geekysuavo/pyppm/software/py/README.md

# pyppm/software/py

This directory contains the `pyppm` Python module source code.

## Introduction

The `pyppm` module links the PyPPM hardware and its capabilities directly
into the powerful Python language, allowing almost any use imaginable of
PPM/EFNMR data acquired from the device. How you use `pyppm` is completely
up to your own imagination! **:)**

## Compilation & Installation

To build `pyppm`, simply run `make`:

> `make`

Easy, right? If you get an error about Python not being found or if you want
to compile the module for a different Python version than the default, you'll
have to specify the Python version during compilation, _e.g._:

> `make PYVER=3.2`

To install, just run it as the super user and tack on an `install` command:

> `sudo make install`

or, for different Python versions:

> `sudo make PYVER=3.2 install`

The `pyppm` Python module will now be installed onto your system, and may
be imported just like any other module. Hooray!

## Example usage

Consider this section as a whirlwind tutorial to using the `pyppm` module in
your Python programs.

### Importing the module

To use `pyppm` in your Python programs, you'll first need to import the
module:

```python
import pyppm
```

It'll probably be useful to have `numpy` and `matplotlib` available as well.
All the following code that uses those two modules assumes they've been
imported as follows:

```python
import numpy as np
import matplotlib.pyplot as plt
```

### Connecting to the device

The `PPM` class in `pyppm` provides a direct connection to the PyPPM hardware
and may be instantiated like so:

```python
dev = pyppm.PPM()
```

On Linux, this assumes you're trying to connect to `/dev/ttyACM0`. On OSX,
it assumes `/dev/cu.usbmodemPyPPM`. If you have multiple attached PyPPM
devices, or if your device was assigned a different device filename than
the default, you can specify a filename:

```python
dev = pyppm.PPM(filename = '/dev/file')
```

If all goes well, you should have no errors and a new `dev` object to play
with. A simple test is to print the device firmware version:

```python
print(dev.version)
```

A proper response is a 2-tuple containing the major and minor version of the
attached device's firmware, _e.g._ `(1, 3)` or `(2, 1)`.

### Pulse programs

All PyPPM devices have been outfitted with a small portion of memory to hold
what are known as 'pulse programs'. These pulse programs are sets of byte
code instructions that tell the microcontroller which commands to execute,
when to execute them, and with what parameters.

But don't worry, you won't ever see the byte code instructions if you don't
want to: the `pyppm` Python module compiles and decompiles these instructions
on-the-fly any time they are needed. In `pyppm`, pulse programs are constructed
as lists of lists, where each inner list is a command with its arguments.

Here's an example:

```python
dev.pulprog = [
  [pyppm.ACQUIRE, 16384, 20],  # acquire 16k samples at 20 kS/s
  [pyppm.END]                  # terminate
]
```

That's pretty easy, right? The above pulse program acquires 16k samples at
20 kS/s and terminates. Here's a more complicated example:

```python
dev.pulprog = [
  [pyppm.ACQUIRE, 16384, 20],  # acquire 16k samples at 20 kS/s
  [pyppm.RELAY, True],         # switch the coil to the polarization circuit
  [pyppm.DEADTIME, 1],         # wait for around one millisecond
  [pyppm.POLARIZE, True],      # switch on hard polarization
  [pyppm.DELAY, 10],           # wait for exactly ten seconds
  [pyppm.POLARIZE, False],     # switch off hard polarization
  [pyppm.DEADTIME, 1],         # wait for around one millisecond
  [pyppm.RELAY, False],        # switch the coil to the acquisition circuit
  [pyppm.DEADTIME, 10],        # wait for around ten milliseconds
  [pyppm.ACQUIRE, 16384, 20],  # acquire again, 16k samples at 20 kS/s
  [pyppm.END]                  # terminate
]
```

The above pulse program just acquires a background 'no-polarization' signal,
then polarizes for ten seconds and acquires a 'with-polarization signal. If
we run this pulse program...

```python
(t, a) = dev.execute()
```

... we'll get the two acquisitions serialized end-to-end in `t` and `a`. Of
course, they can be sliced apart without too much worry. (See the full
example below for exactly how it's done)

Finally, setting shim and tuning parameters is also done using pulse programs.
In order to set a new z-shim, for example, one must do something like this:

```python
dev.pulprog = [
  [pyppm.SHIM_Z, 0.5],
  [pyppm.END]
]
dev.execute()
```

A set of common pulse programs is available in the PyPPM GitHub repository,
under `software/pulprogs`. It's _highly_ recommended that you start there
instead of trying to write your own pulse programs from scratch.

### Acquiring data

Once a pulse program has been downloaded to the device, an experiment may be
performed using the following (blocking) command:

```python
(t, a) = dev.execute()
```

This command will block until the entire experiment is complete.

If the pulse program contains `pyppm.ACQUIRE` commands, then the statement
will return two tuples, `t` and `a`. The first tuple holds the time at which
every data point was acquired, and the second holds the voltage of each data
point.

If the pulse program does not contain an acquisition command, then the
`execute()` method returns `None`.

### Fourier transforming data

Acquired data may be Fourier transformed using the `fft` or `hrft` methods
in the `pyppm` module. While you may use any other external method, these
are known to output the proper results with correct frequency axes:

```python
(f, A) = pyppm.fft(t, a)
(fx, Ax) = pyppm.hrft(t, a, 950, 1050)
```

The `hrft` method computes a highly interpolated Fourier transform over a
short spectral sub-region:

> R. Hollos, _C Program Magnifies Spectrum When An FFT Can't Hack It_,
> Electronic Design, 2003.

In the above example, the HRFT was computed from 950 Hz to 1050 Hz, which
would be appropriate if a signal peak were idenfied near 1000 Hz in the FFT
spectrum and greater frequency resolution was desired.

It's important to note, however, that the HRFT requires fairly long-decaying
signals (and thus high SNR and high field homogeneity), as it windows the
time-domain data with a Blackman apodization function prior to computation.

One final transform is available in `pyppm`, called the [Short-time Fourier
transform](http://en.wikipedia.org/wiki/Short-time_Fourier_transform). It
computes multiple FFT's over short time windows of the time-domain data,
effectively creating a time-course of the frequency content in the data:

```python
(tz, fz, Az) = pyppm.stft(t, a)
```

This may be useful in identifying the decay profile of a true signal in the
presence of steady-state interference.

### Digitally minimizing interference

The PyPPMv1 has no input frequency tuning, which means that the resulting
acquired data will contain significant interference, unless it was taken
on a desert island free of any other technology. One way to minimize this
interference is to "subtract out" any frequency content that is present when
polarization is on _and_ off. This should leave only signals that arose due
to the NMR experiment:

```python
def rmnoise(t, aon, aoff):
  (f, Aon) = pyppm.fft(t, aon)
  (f, Aoff) = pyppm.fft(t, aoff)

  X = np.array(Aon)
  Y = np.array(Aoff)

  alpha = sum(X * Y) / sum(Y * Y)
  A = tuple(X - alpha * Y)

  return (f, A)
```

The above method implements a minimization of the background noise in `Aoff`
that is present in `Aon`, in a least-squares sense. It can only return the
frequency-domain data, however, and not the time-domain result.

### A complete `pyppm` example

Here is an example of how to use the `pyppm` module from start to finish
on a connected PyPPMv1 device:

```python
# import the pyppm module.
import pyppm

# import numpy and matplotlib.
import numpy as np
import matplotlib.pyplot as plt

# connect to the device.
dev = pyppm.PPM()

# download a pulse program.
dev.pulprog = [
  [pyppm.ACQUIRE, 16384, 20],
  [pyppm.RELAY, True],
  [pyppm.DEADTIME, 1],
  [pyppm.POLARIZE, True],
  [pyppm.DELAY, 10],
  [pyppm.POLARIZE, False],
  [pyppm.DEADTIME, 1],
  [pyppm.RELAY, False],
  [pyppm.DEADTIME, 10],
  [pyppm.ACQUIRE, 16384, 20],
  [pyppm.END]
]

# execute the pulse program.
(t, a) = dev.execute()

# slice out the first acquisition.
t0 = t[0 : 16384]
a0 = a[0 : 16384]

# slice out the second acquisition.
t1 = t[16384 : 32768]
a1 = a[16384 : 32768]

# Fourier transform the data.
(f0, A0) = pyppm.fft(t0, a0)
(f1, A1) = pyppm.fft(t1, a1)

# plot the data.
l, = plt.plot(np.array(f1), np.array(A1))
l, = plt.plot(np.array(f0), np.array(A0))
plt.show()
```
