geekysuavo/pyppm/notes/gerbv-colors.md

# Colors for rendering Gerber layouts

| *Layer* | *Color*  |
|---|---|
| Background | 0xffffff |
| Drill | 0xffffff |
| Top silkscreen | 0x000000 |
| Top soldermask | 0x545454 |
| Top traces | 0xde5b4e |
| Inner traces (3) | 0xdede4e |
| Inner traces (4) | 0x4ede5e |
| Bottom traces | 0x2a67b0 |
