geekysuavo/pyppm/designs/dig-1.0/v1-brd.pdf

# v1.pcb

# 1. Table of Contents (This Page) Created on Sun Feb 10 13:56:15 2013

# 2. component 3. solder 4. plated-drill 5. componentmask 6. soldermask 7. topsilk 8. bottomsilk 9. toppaste 10. topassembly 11. bottomassembly 12. fab

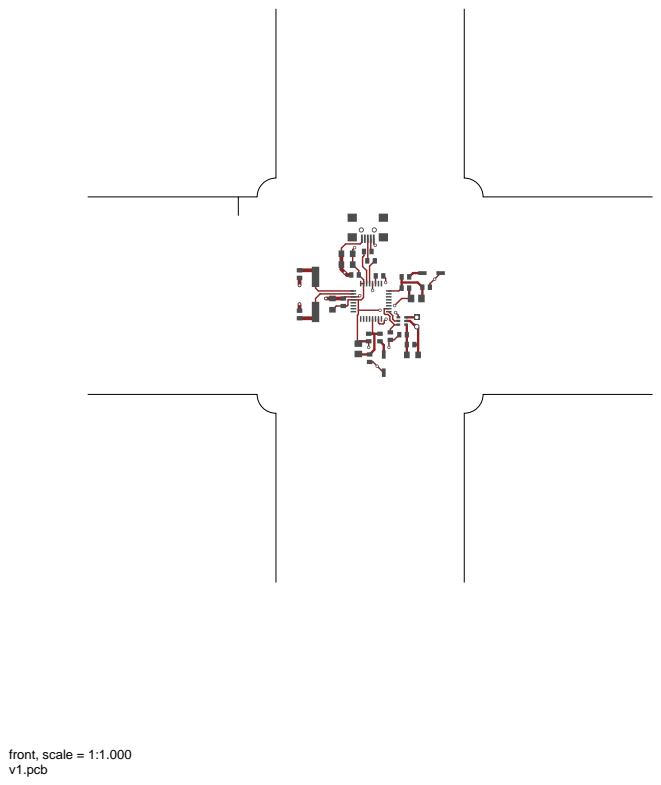
[picture p1: page 2]
front, scale = 1:1.000

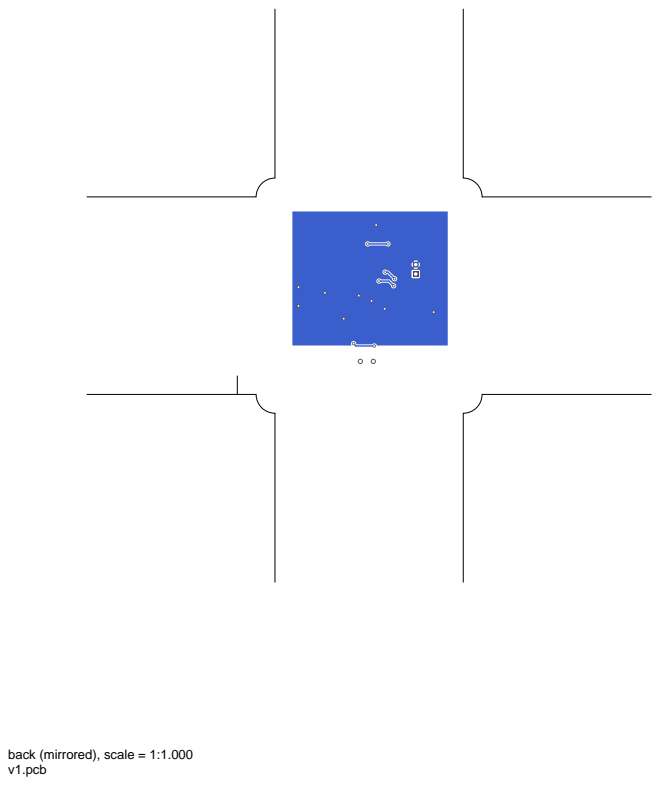
[picture p2: page 3]

back (mirrored), scale = 1:1.000

plated-drill, scale = 1:1.000

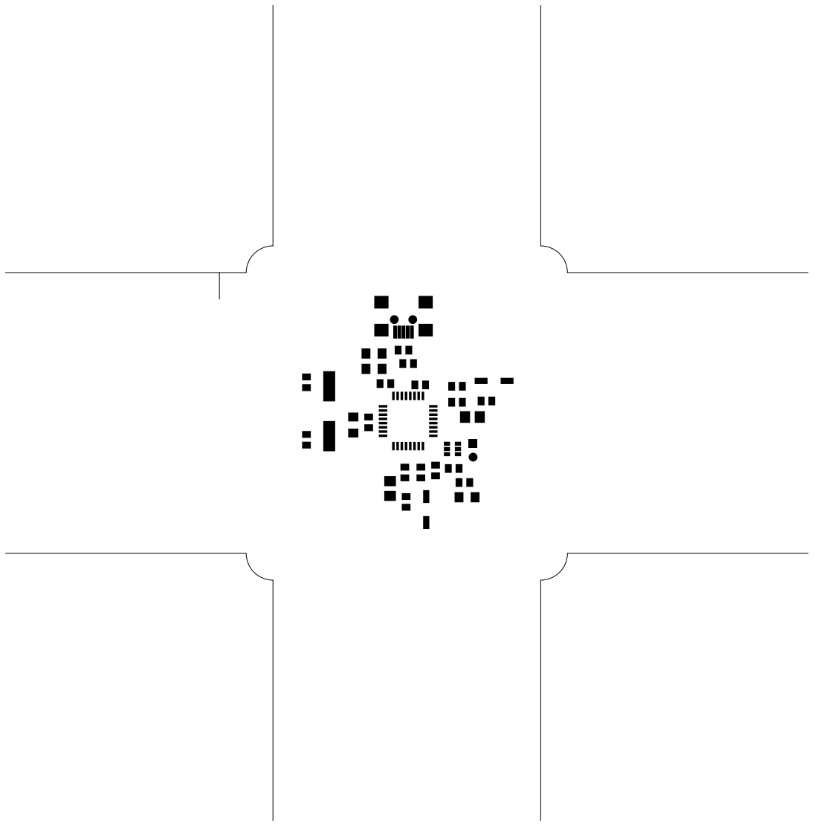
[picture p3: figure]

frontmask, scale = 1:1.000

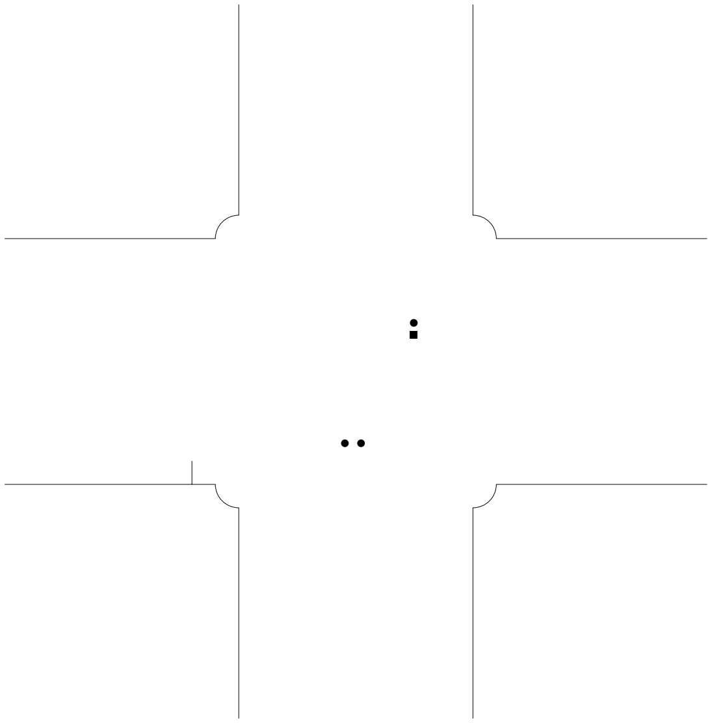
[picture p4: figure]

backmask (mirrored), scale = 1:1.000 frontsilk, scale = 1:1.000 backsilk (mirrored), scale = 1:1.000 frontpaste, scale = 1:1.000

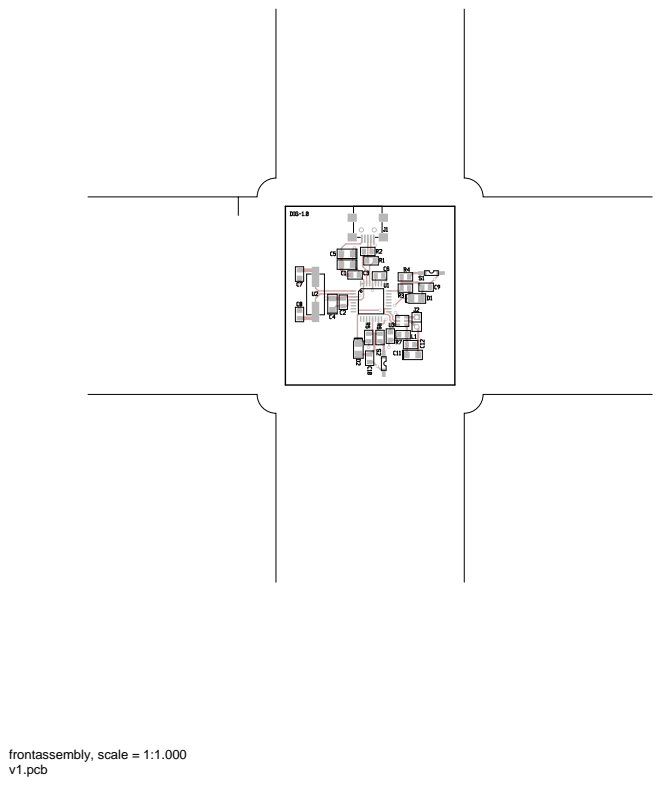
[picture p5: page 10]
frontassembly, scale = 1:1.000

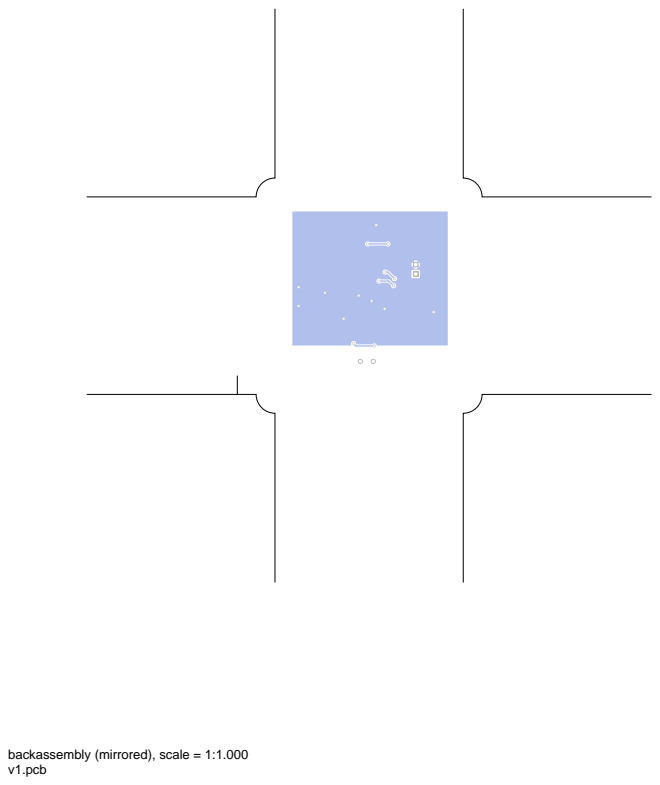
[picture p6: page 11]

backassembly (mirrored), scale = 1:1.000

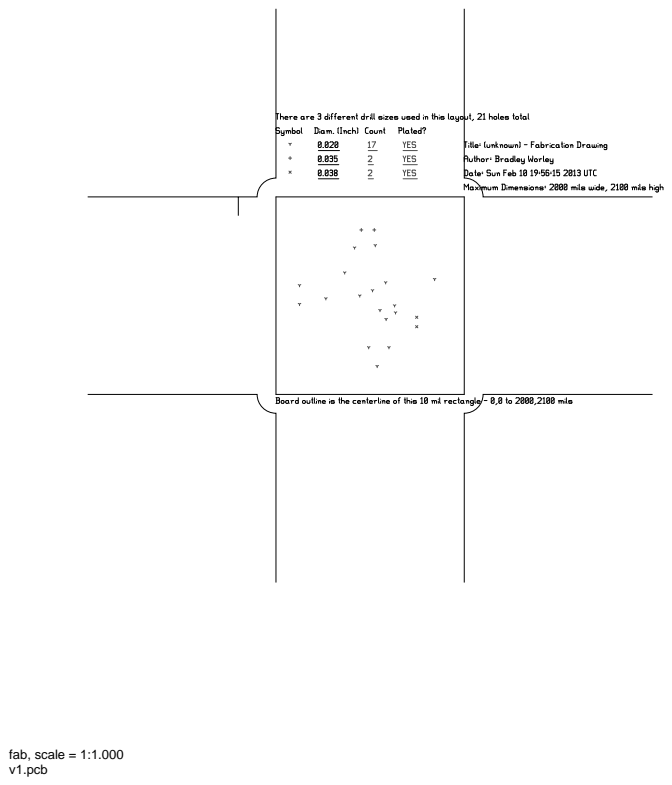
[picture p7: page 12]
fab, scale = 1:1.000
