geekysuavo/pyppm/designs/ina-1.0/v1-brd.pdf

# v1.pcb

# 1. Table of Contents (This Page) Created on Fri Feb 8 13:08:46 2013

# 2. component 3. solder 4. plated-drill 5. componentmask 6. soldermask 7. topsilk 8. bottomsilk 9. toppaste 10. topassembly 11. bottomassembly 12. fab

front, scale = 1:1.000

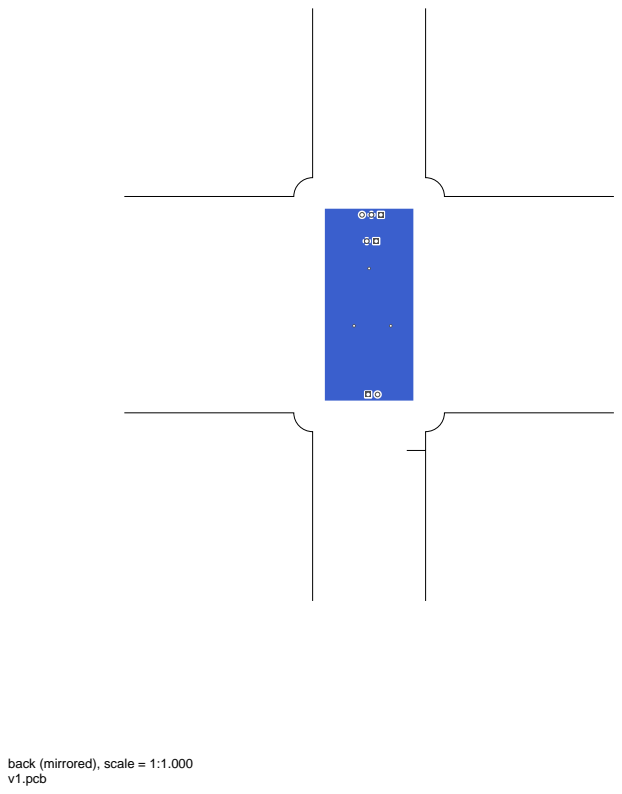
[picture p8: page 3]

back (mirrored), scale = 1:1.000

plated-drill, scale = 1:1.000

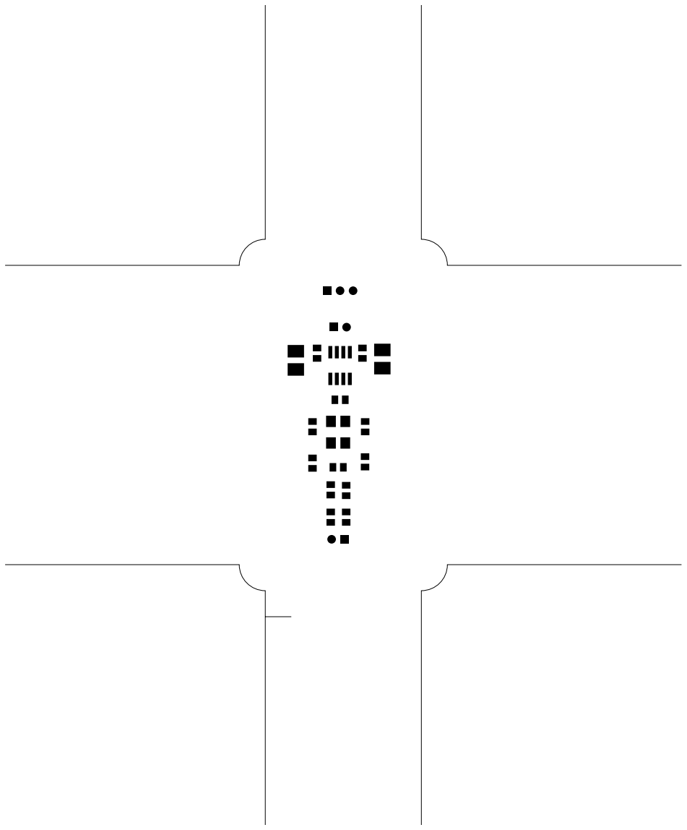
[picture p9: figure]

frontmask, scale = 1:1.000

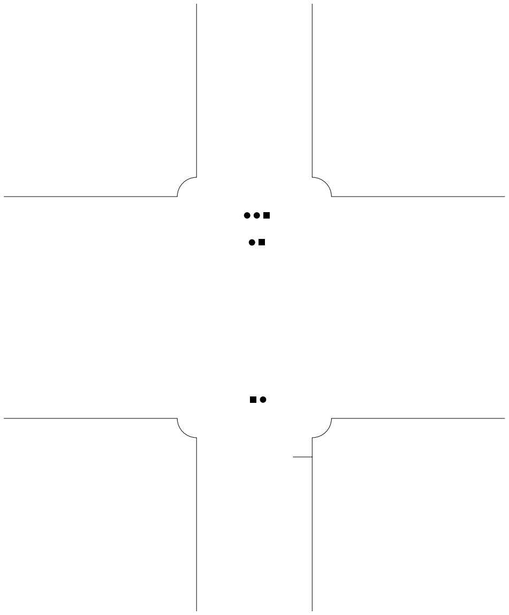
[picture p10: figure]

backmask (mirrored), scale = 1:1.000

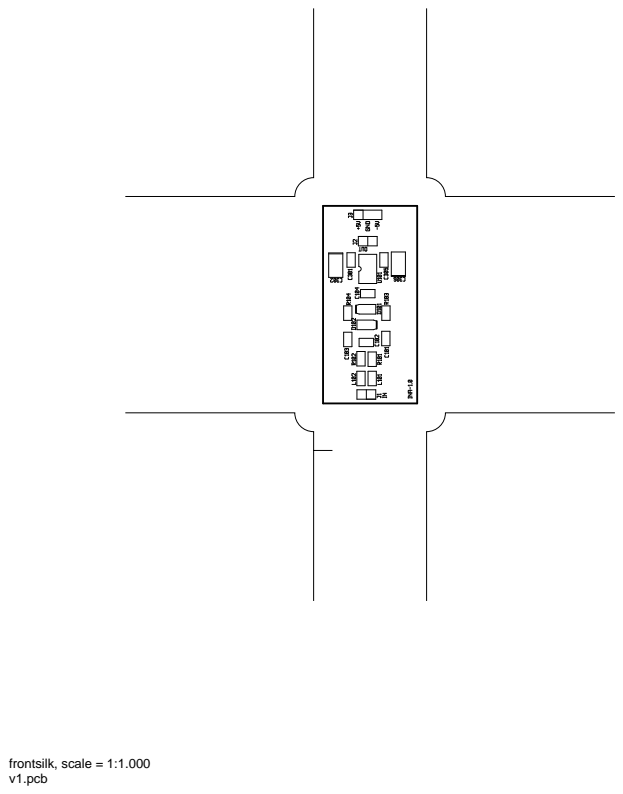
[picture p11: page 7]
frontsilk, scale = 1:1.000

backsilk (mirrored), scale = 1:1.000 frontpaste, scale = 1:1.000

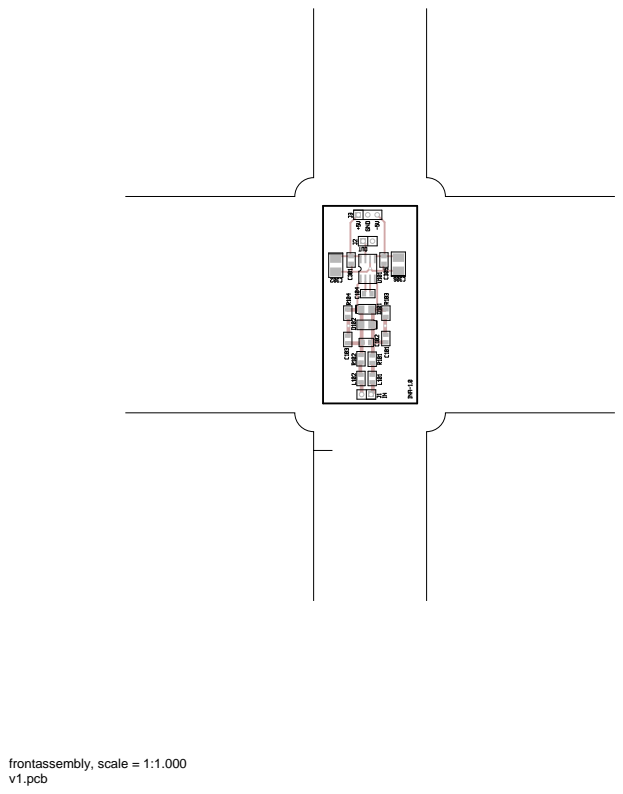
[picture p12: page 10]
frontassembly, scale = 1:1.000

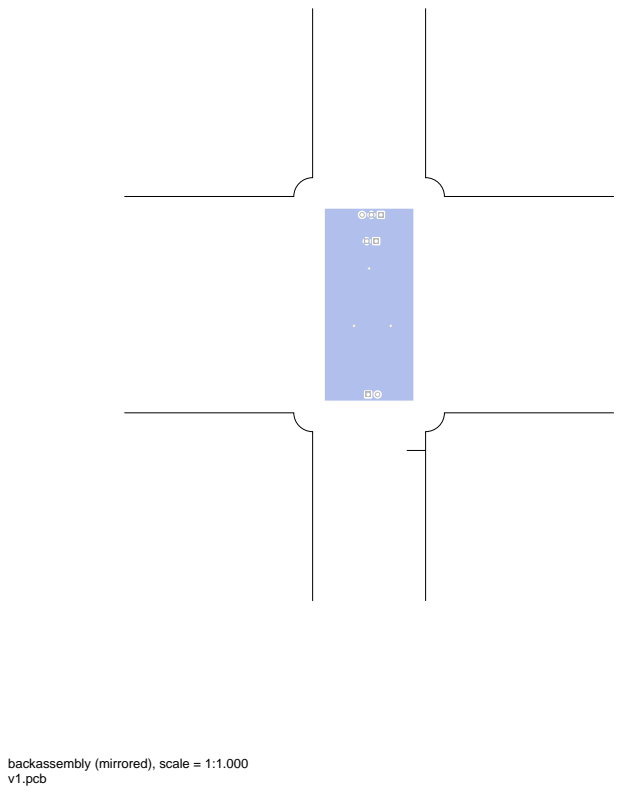
[picture p13: page 11]

backassembly (mirrored), scale = 1:1.000

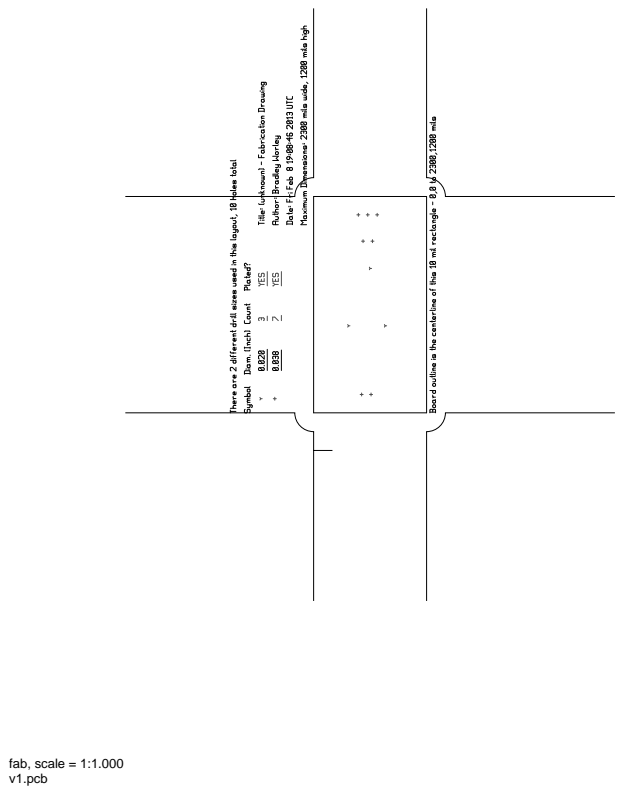
[picture p14: page 12]
fab, scale = 1:1.000
