geekysuavo/pyppm/designs/osc-1.0/v1-brd.pdf

# 2. component 3. solder 4. componentmask 5. soldermask 6. plated-drill 7. topsilk 8. bottomsilk 9. toppaste 10. topassembly 11. bottomassembly 12. fab

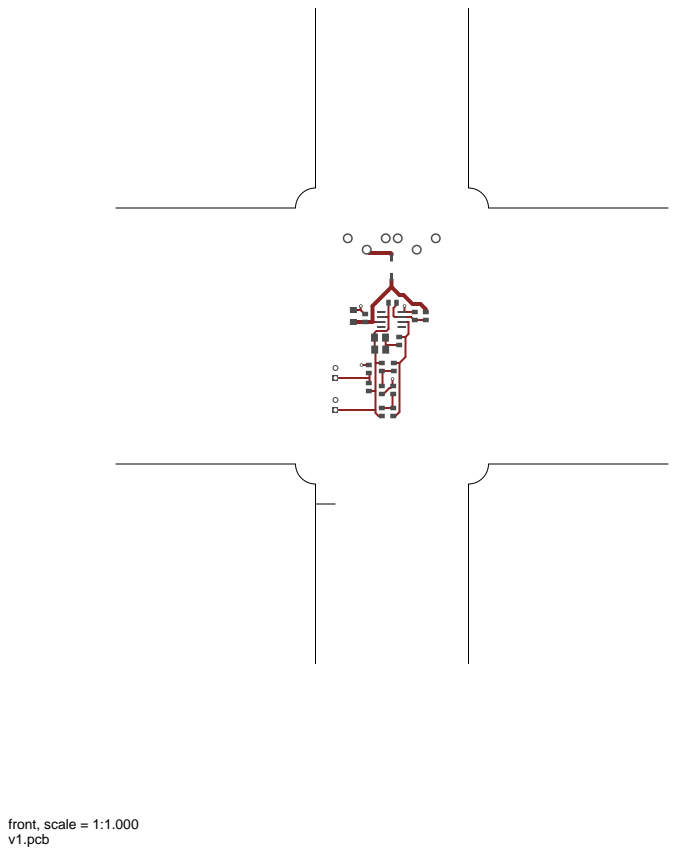
[picture p15: page 2]
v1.pcb; front, scale = 1:1.000

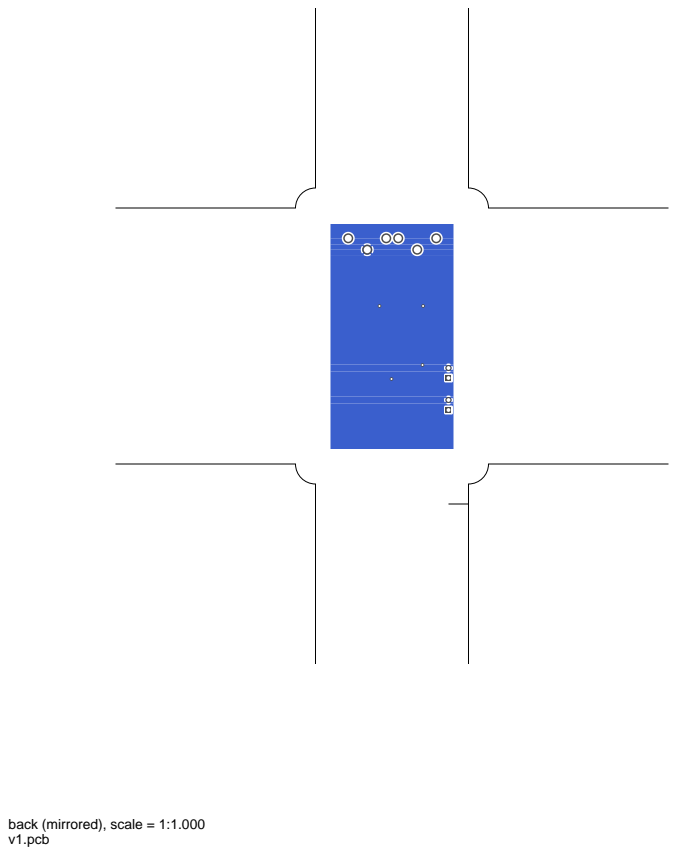
[picture p16: page 3]

back (mirrored), scale = 1:1.000

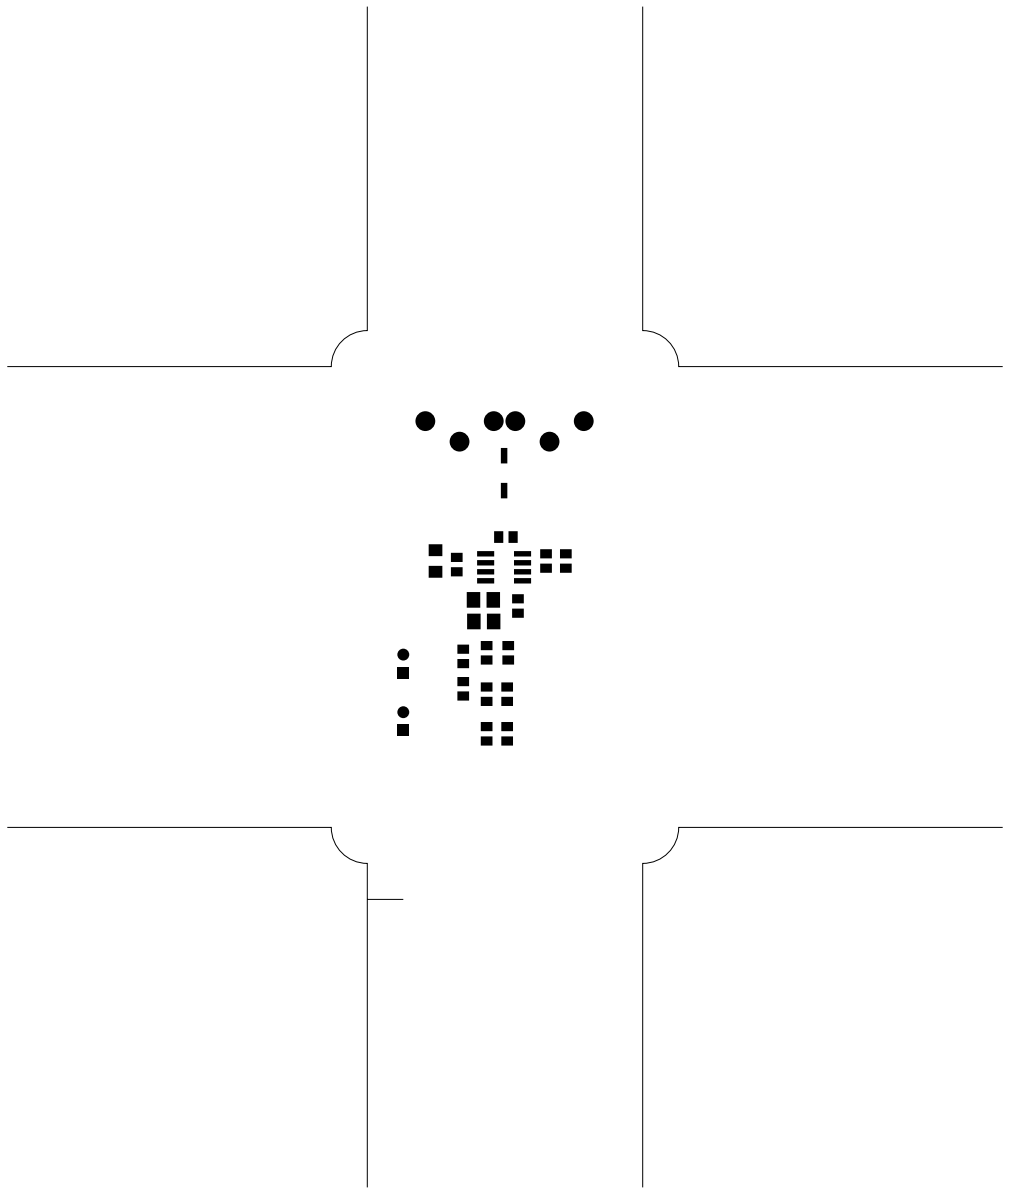
[picture p17: figure]

frontmask, scale = 1:1.000

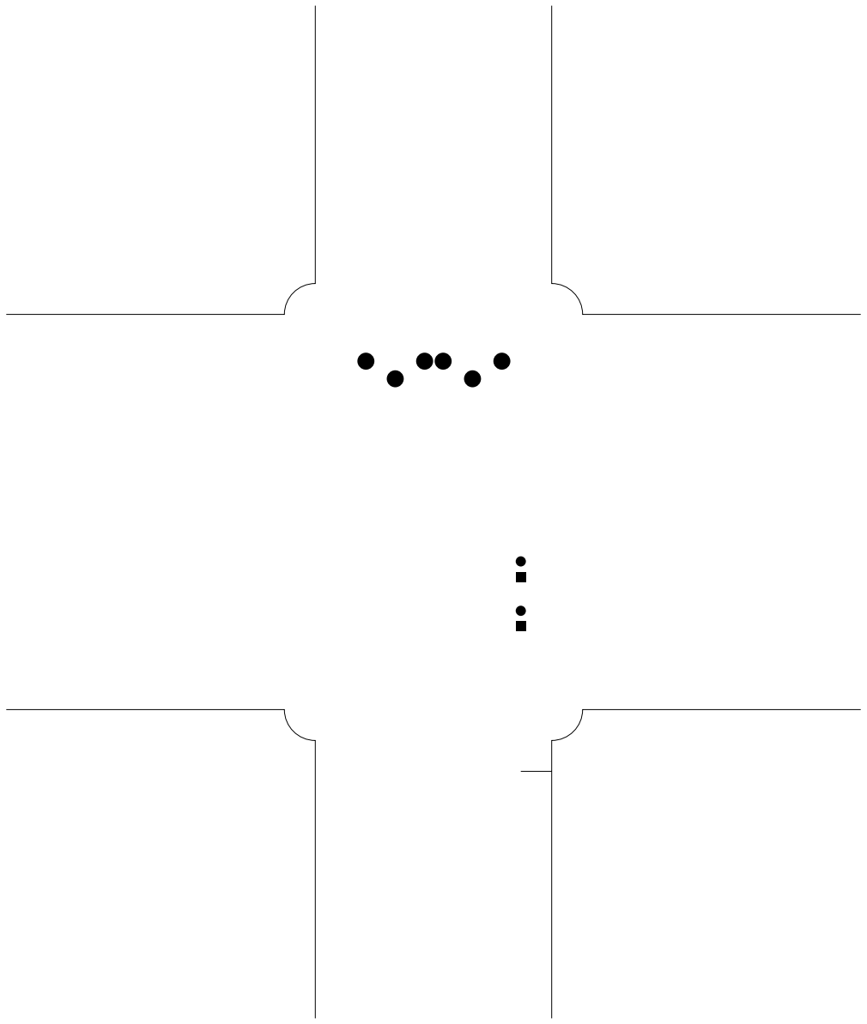
[picture p18: figure]

backmask (mirrored), scale = 1:1.000 plated-drill, scale = 1:1.000 frontsilk, scale = 1:1.000 backsilk (mirrored), scale = 1:1.000 frontpaste, scale = 1:1.000

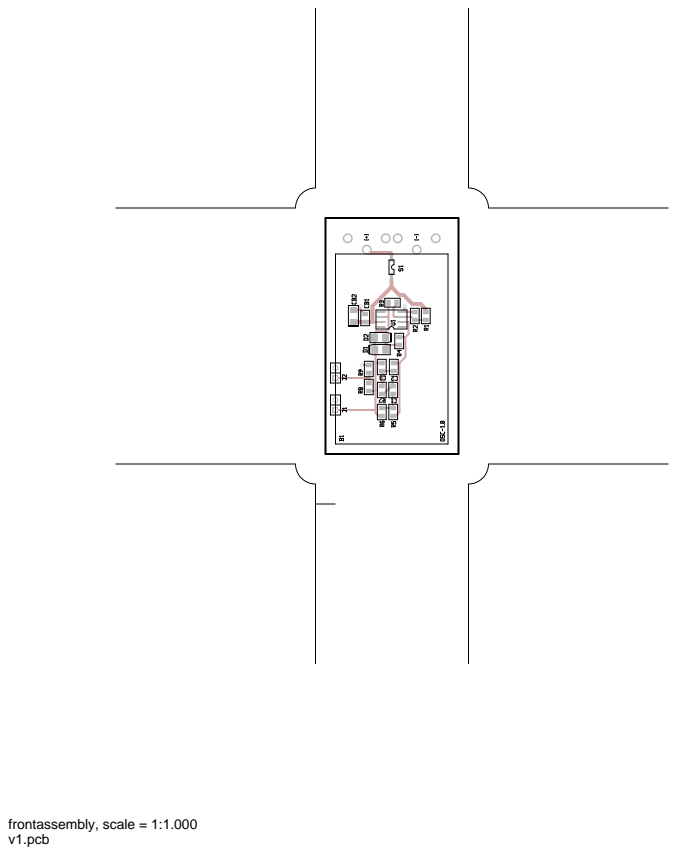
[picture p19: page 10]
frontassembly, scale = 1:1.000

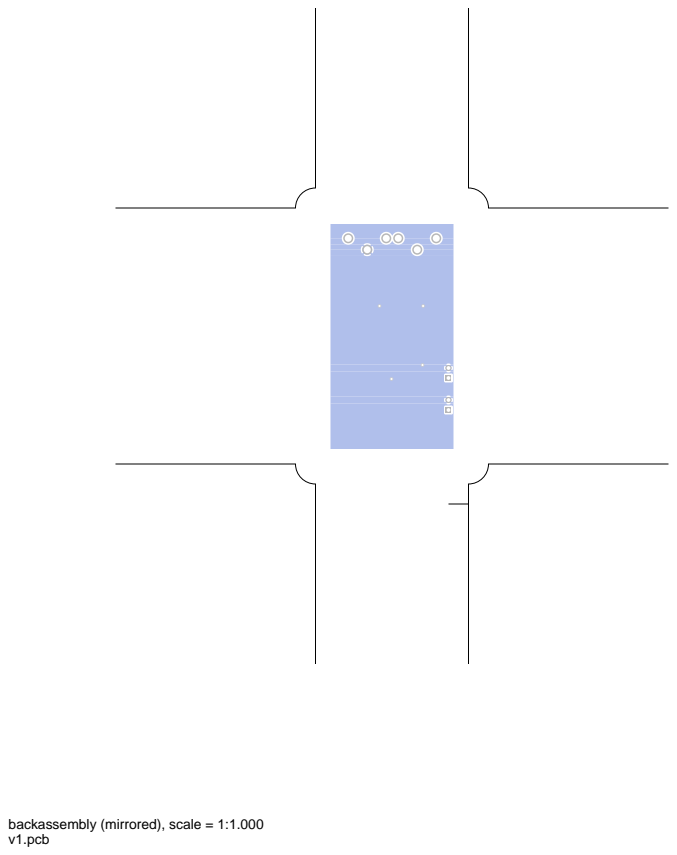
[picture p20: page 11]

backassembly (mirrored), scale = 1:1.000

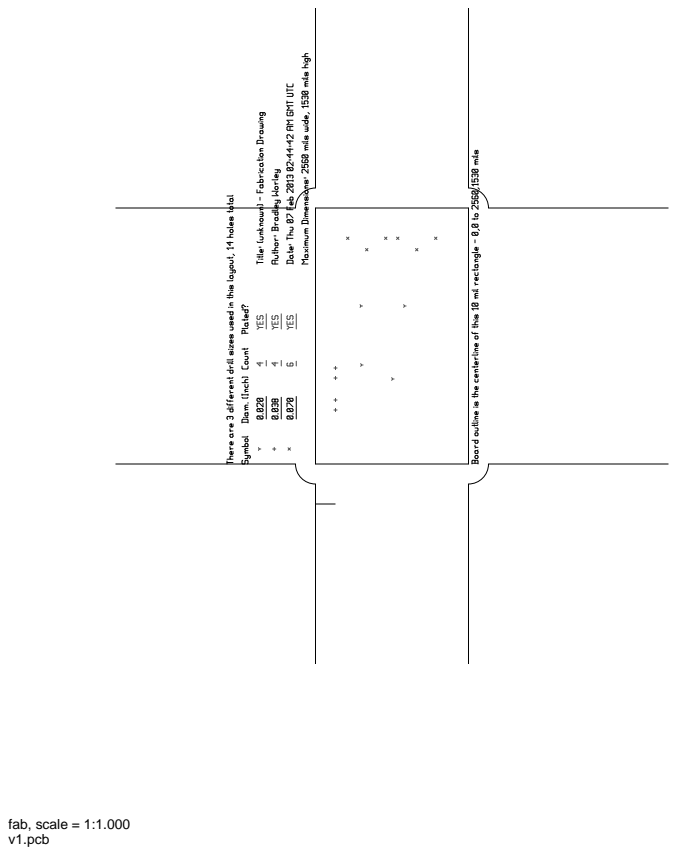
[picture p21: page 12]
fab, scale = 1:1.000
