geekysuavo/pyppm/designs/dig-1.0/v1-brd.png

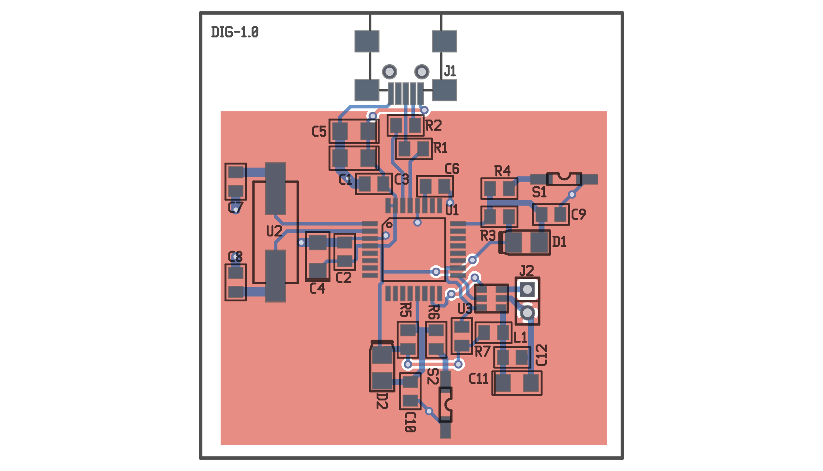
designs/dig-1.0/v1-brd.png
