geekysuavo/pyppm/designs/fil-1.0/v1-brd.png

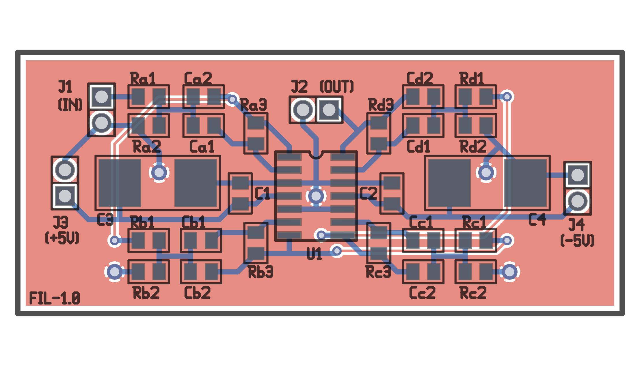
designs/fil-1.0/v1-brd.png
