geekysuavo/pyppm/designs/ina-1.0/v1-brd.png

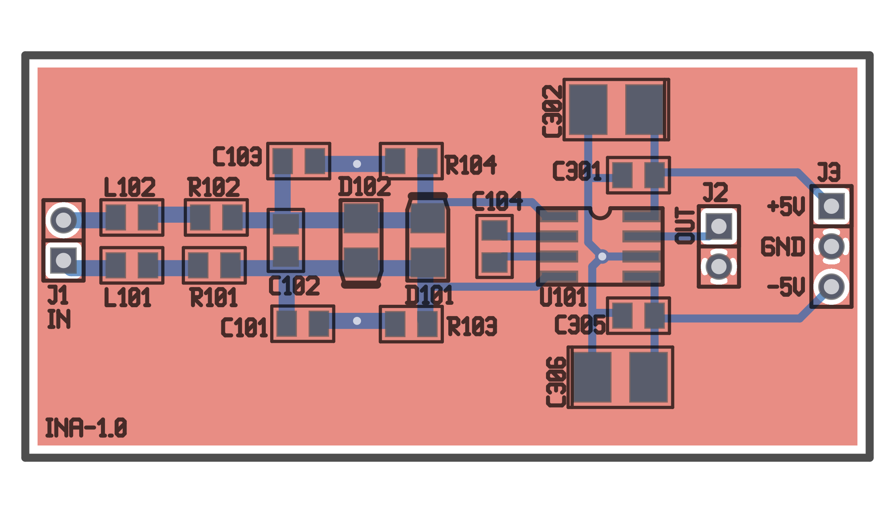
designs/ina-1.0/v1-brd.png
