geekysuavo/pyppm/designs/osc-1.0/v1-brd.png

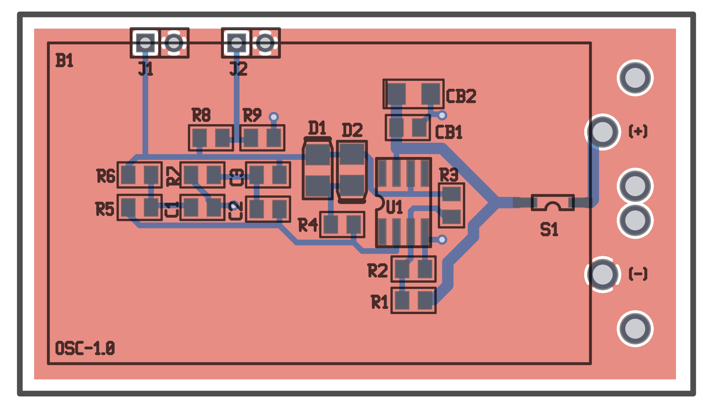
designs/osc-1.0/v1-brd.png
