geekysuavo/pyppm/designs/ppm-1.0/v1-brd.png

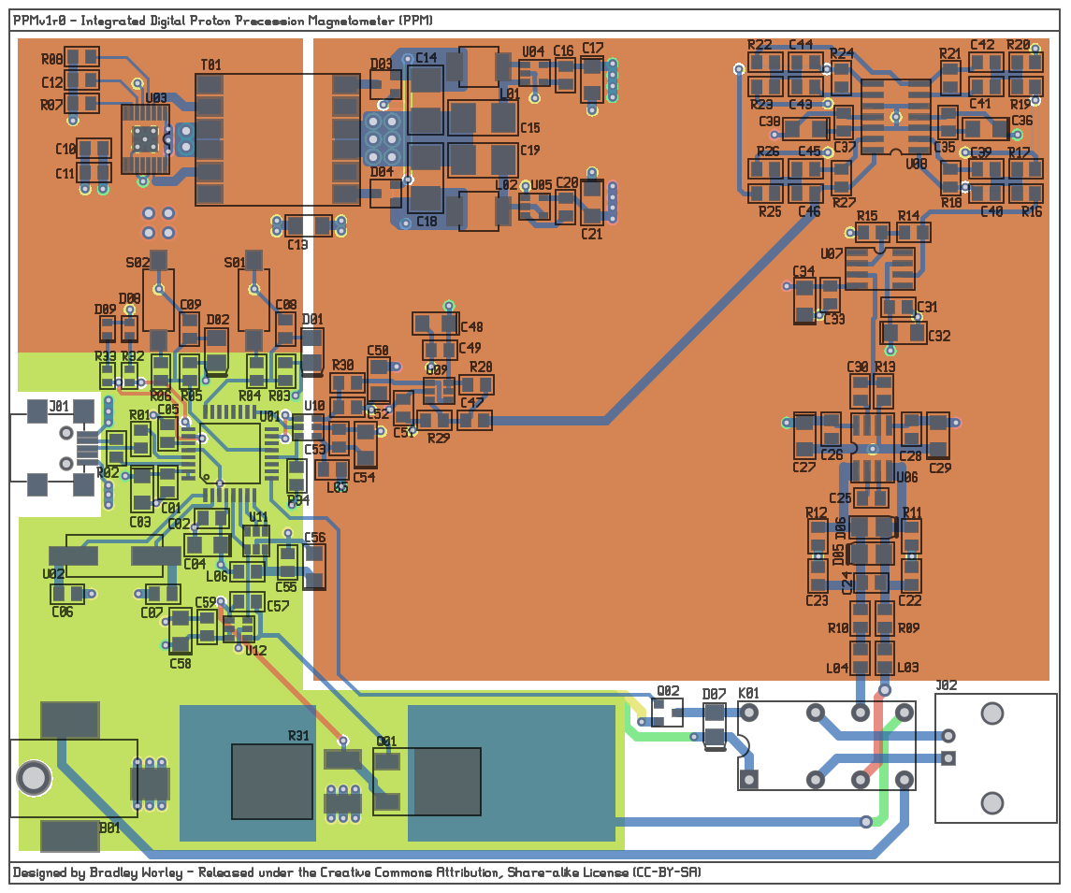
designs/ppm-1.0/v1-brd.png
