geekysuavo/pyppm/designs/ppm-1.2/v1-brd.png

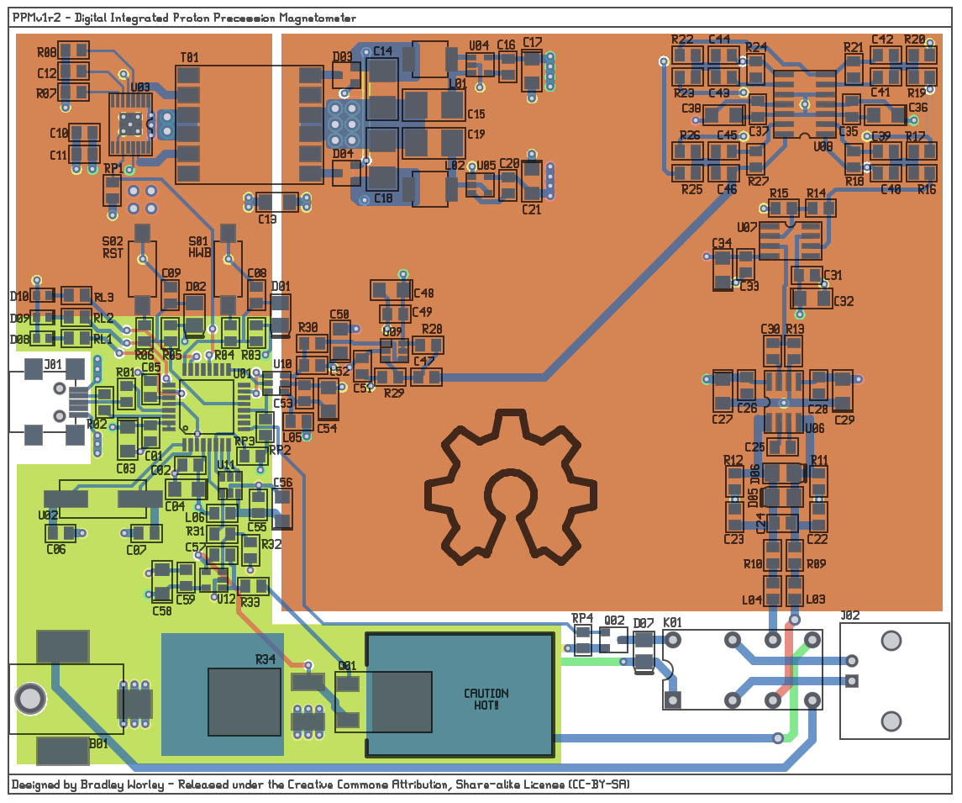
designs/ppm-1.2/v1-brd.png
