geekysuavo/pyppm/designs/ppm-1.3/v1-brd.png

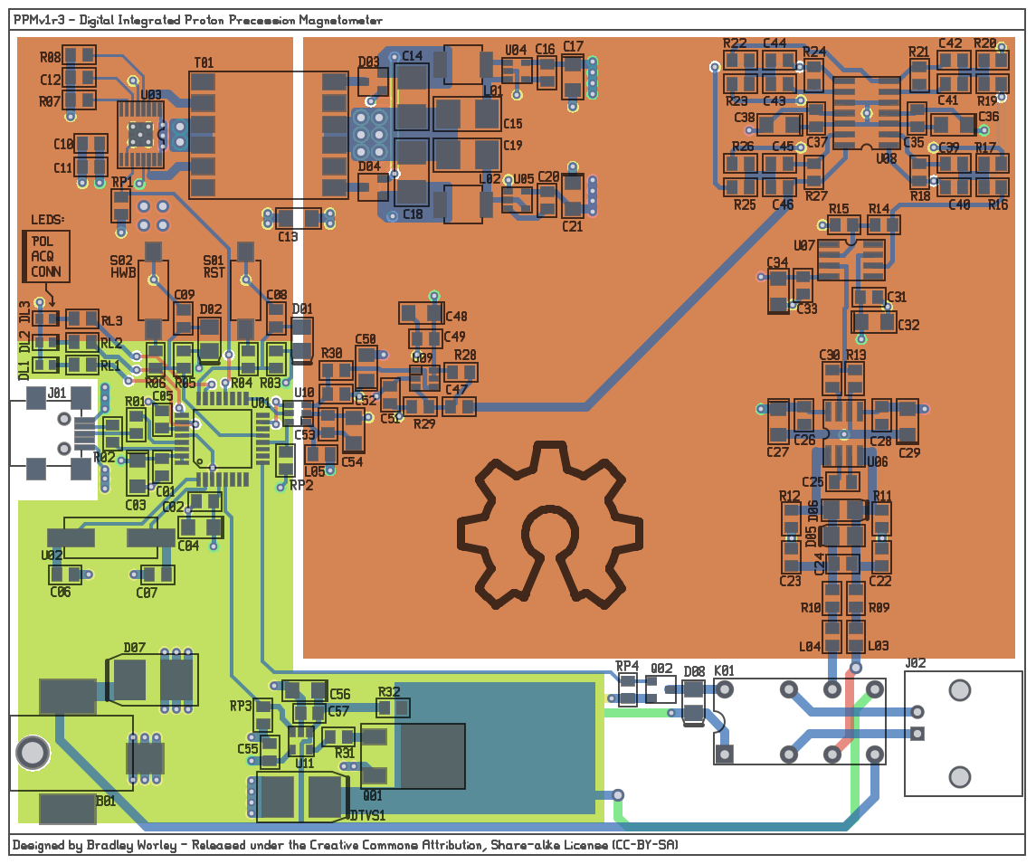
designs/ppm-1.3/v1-brd.png
