geekysuavo/pyppm/designs/ppm-2.0/v2-brd.png

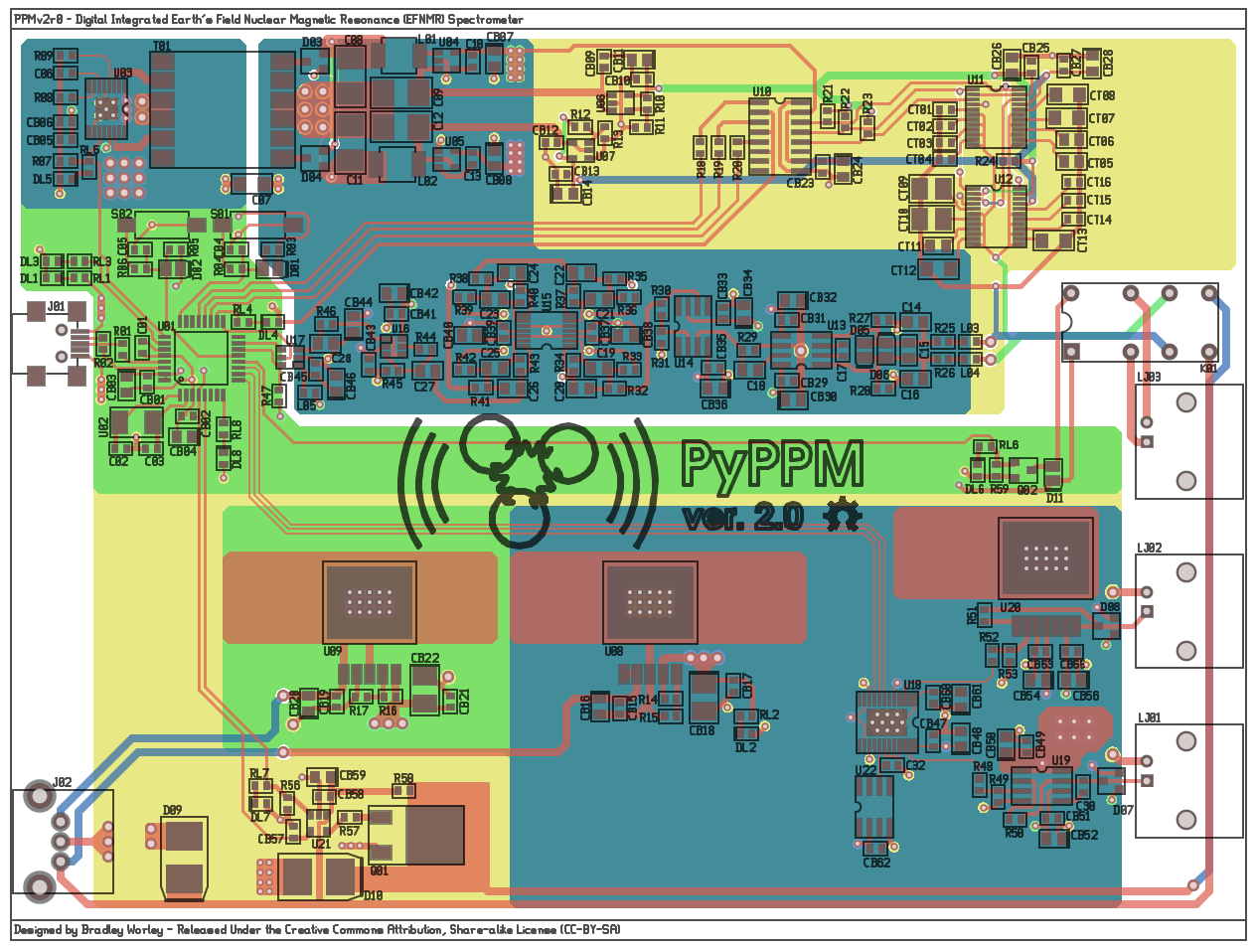
designs/ppm-2.0/v2-brd.png
