geekysuavo/pyppm/designs/ppm-2.1/v2-brd.png

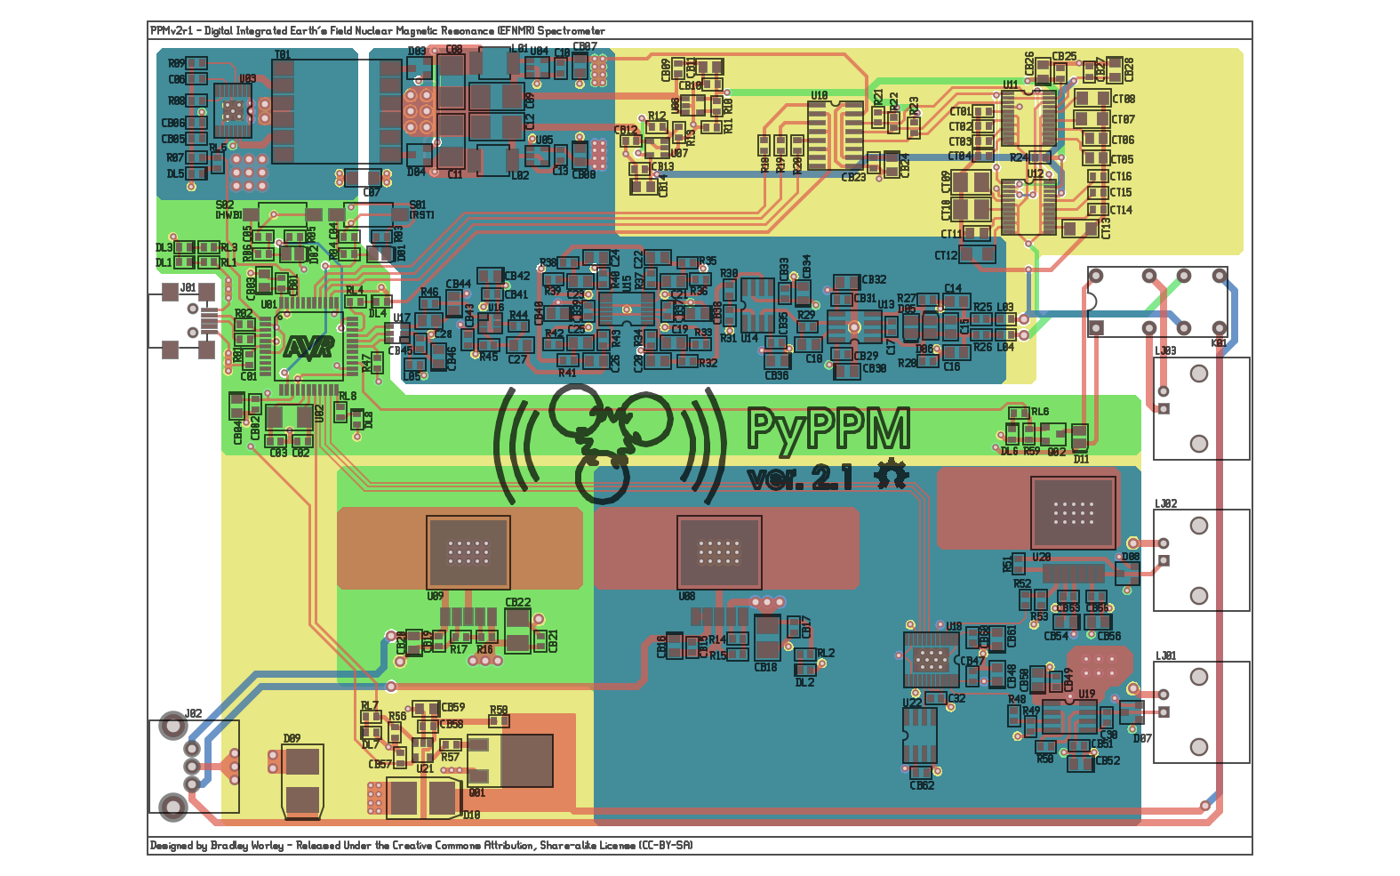
designs/ppm-2.1/v2-brd.png
