geekysuavo/pyppm/designs/scb-1.0/v1-brd.png

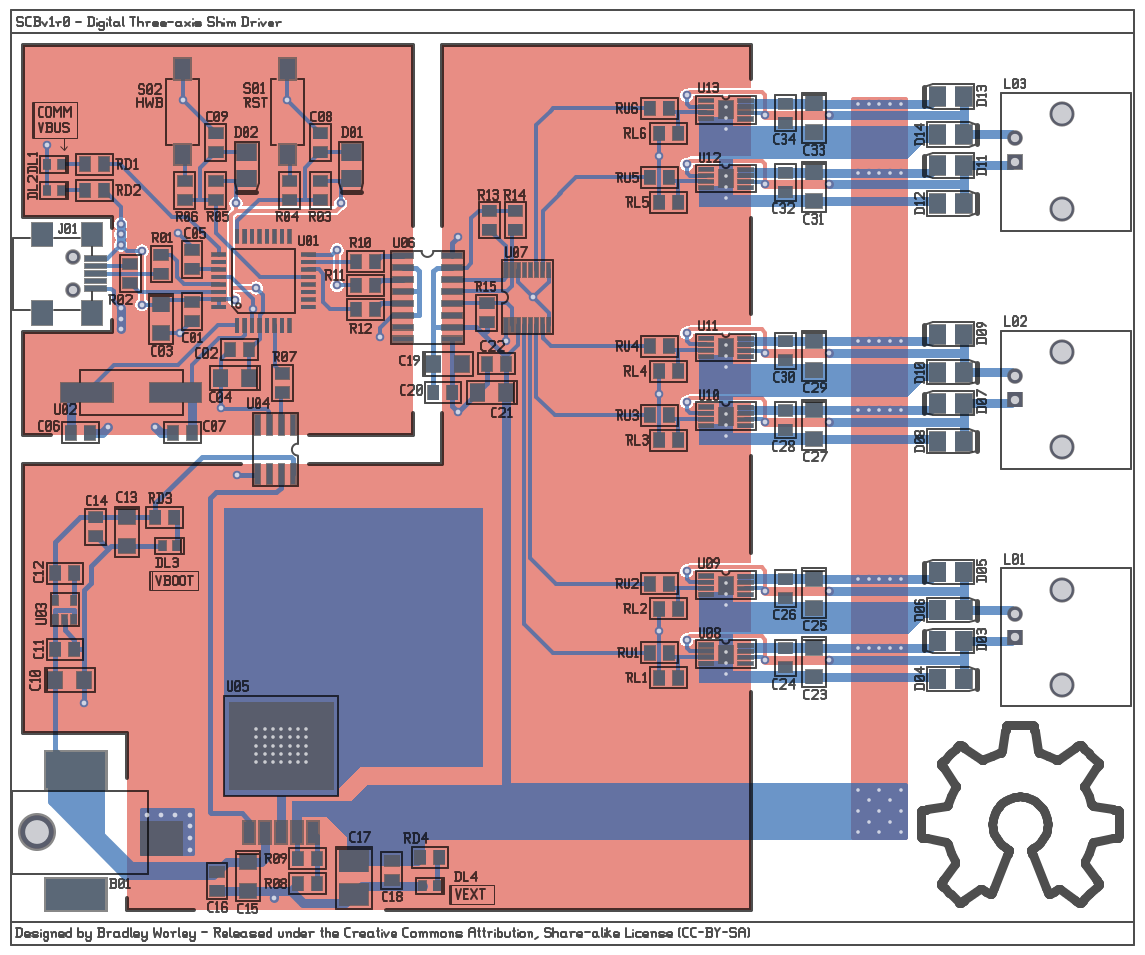
designs/scb-1.0/v1-brd.png
