geekysuavo/pyppm/simulations/dig-1.0/dig-floor.png

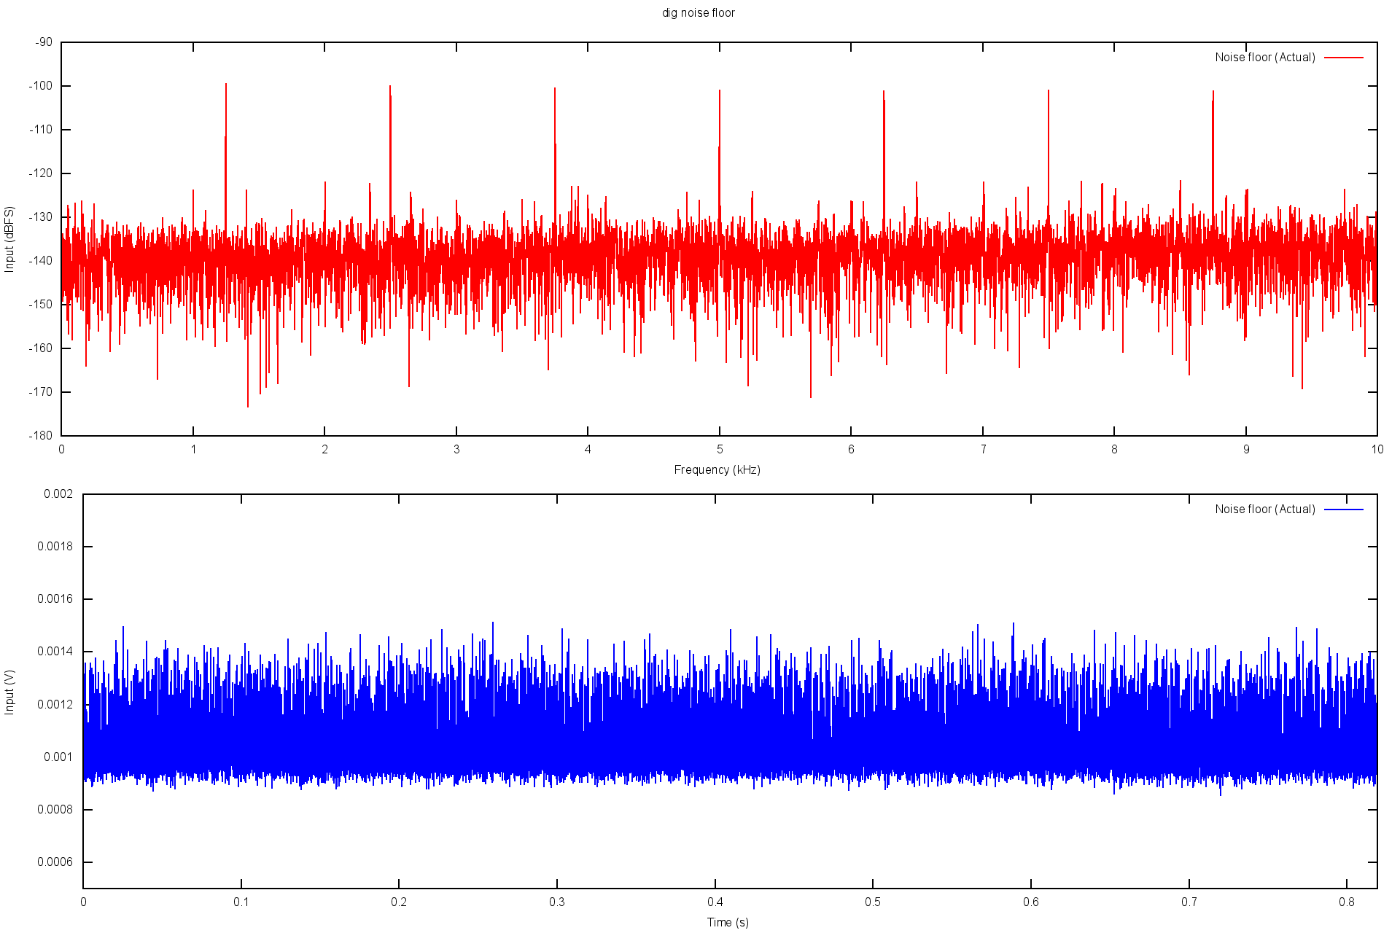
simulations/dig-1.0/dig-floor.png
