geekysuavo/pyppm/simulations/dig-1.0/dig-sin1k.png

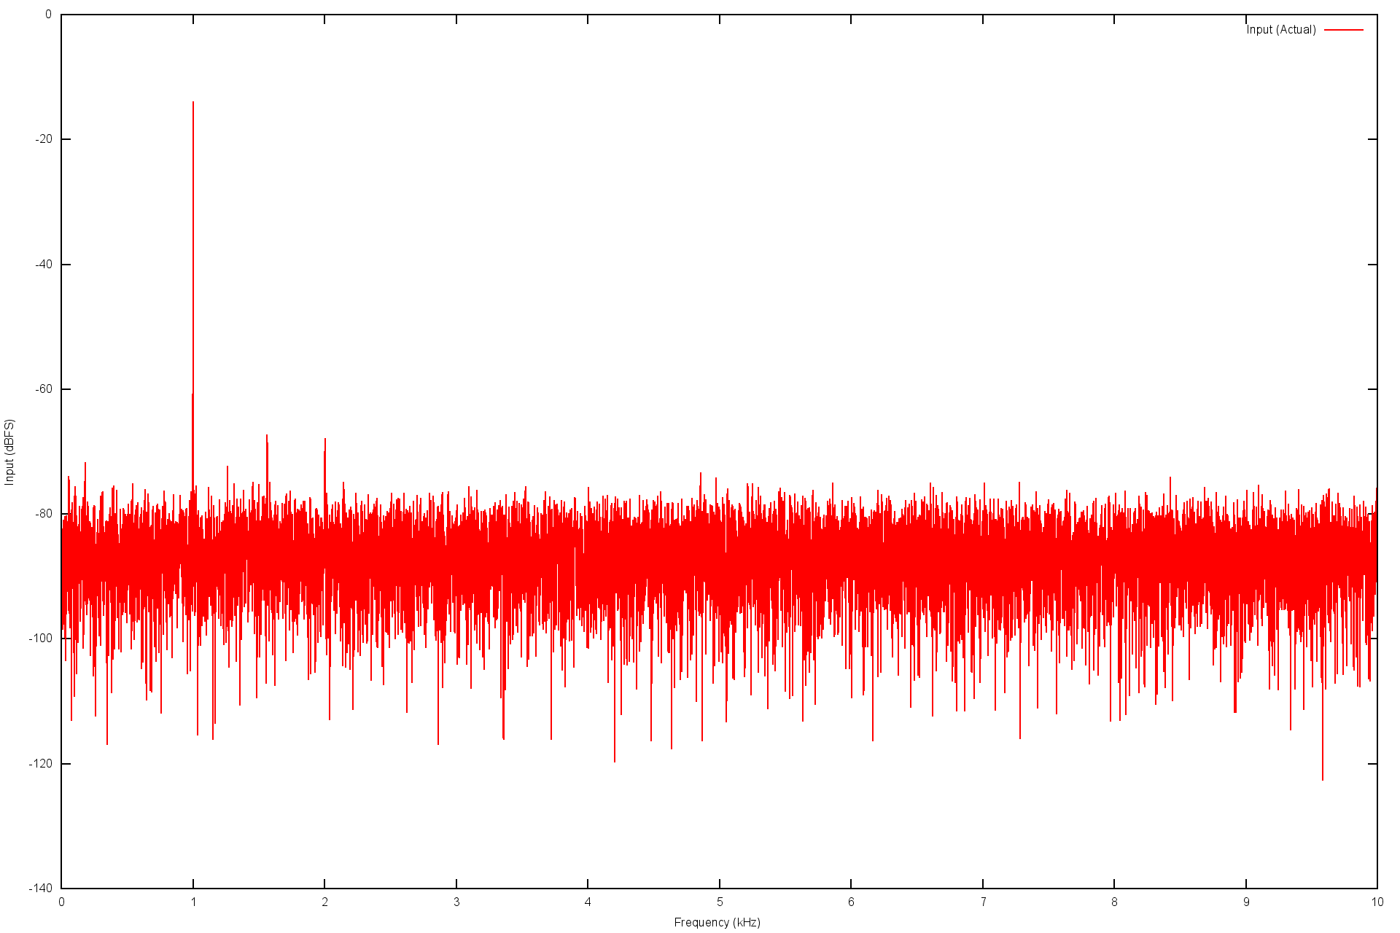
simulations/dig-1.0/dig-sin1k.png
