geekysuavo/pyppm/designs/ppm-2.2/ppm-bom-long.csv

# 01-overview.sch:
# --------------------------------------------
# 02-pulprog.sch:
# --------------------------------------------
# 03-mcu-core.sch:
# --------------------------------------------
C01 | SMD_SIMPLE 60 30 | 490-5307-1-ND
C02 | SMD_SIMPLE 60 30 | 490-1413-1-ND
C03 | SMD_SIMPLE 60 30 | 490-1413-1-ND
C04 | SMD_SIMPLE 60 30 | 490-1532-1-ND
C05 | SMD_SIMPLE 60 30 | 490-1532-1-ND
CB01 | SMD_SIMPLE 60 30 | 490-1532-1-ND
CB02 | SMD_SIMPLE 60 30 | 490-1532-1-ND
CB03 | SMD_POLAR 80 50 | 511-1683-1-ND
CB04 | SMD_POLAR 80 50 | 511-1683-1-ND
D01 | SOD323 | SD101AWSTPMSCT-ND
D02 | SOD323 | SD101AWSTPMSCT-ND
J01 | USB-Mini-B | H2959CT-ND
R01 | SMD_SIMPLE 60 30 | P22.0HCT-ND
R02 | SMD_SIMPLE 60 30 | P22.0HCT-ND
R03 | SMD_SIMPLE 60 30 | P10.0KHCT-ND
R04 | SMD_SIMPLE 60 30 | P330HCT-ND
R05 | SMD_SIMPLE 60 30 | P10.0KHCT-ND
R06 | SMD_SIMPLE 60 30 | P330HCT-ND
S01 | Tact-Sw-FSMSM | 450-1758-1-ND
S02 | Tact-Sw-FSMSM | 450-1758-1-ND
U01 | TQFP44_10 | ATMEGA32U4-AU-ND
U02 | ABM7-SMD2 | 535-9840-1-ND
# 04-mcu-ports.sch:
# --------------------------------------------
# 05-dcdc.sch:
# --------------------------------------------
C06 | SMD_SIMPLE 60 30 | PCF1452CT-ND
C07 | SMD_SIMPLE 120 60 | 478-2953-1-ND
CB05 | SMD_SIMPLE 60 30 | 490-7199-1-ND
CB06 | SMD_SIMPLE 60 30 | 490-7199-1-ND
D03 | SOT23 | BAS40-04-V-GS08CT-ND
D04 | SOT23 | BAS40-04-V-GS08CT-ND
R07 | SMD_SIMPLE 60 30 | P10.0KHCT-ND
R08 | SMD_SIMPLE 60 30 | P16.9KDBCT-ND
R09 | SMD_SIMPLE 60 30 | P16.9KDBCT-ND
T01 | CTX02-13665 | 513-1625-1-ND
U03 | TSSOP16_EP | LT3439EFE#PBF-ND
# 06-ldo-5.0v.sch:
# --------------------------------------------
C08 | SMD_SIMPLE 180 120 | 445-3927-1-ND
C09 | SMD_SIMPLE 180 120 | 445-3927-1-ND
C10 | SMD_SIMPLE 60 30 | 445-2664-1-ND
C11 | SMD_SIMPLE 180 120 | 445-3927-1-ND
C12 | SMD_SIMPLE 180 120 | 445-3927-1-ND
C13 | SMD_SIMPLE 60 30 | 445-2664-1-ND
CB07 | SMD_POLAR 80 50 | 511-1683-1-ND
CB08 | SMD_POLAR 80 50 | 511-1683-1-ND
L01 | Coiltronics-UP04C | 513-1063-1-ND
L02 | Coiltronics-UP04C | 513-1063-1-ND
U04 | SOT25 | LT1761ES5-5#TRMPBFCT-ND
U05 | SOT25 | LT1964ES5-5#TRMPBFCT-ND
# 07-ldo-2.5v.sch:
# --------------------------------------------
CB09 | SMD_SIMPLE 60 30 | 490-1532-1-ND
CB10 | SMD_SIMPLE 60 30 | 490-1532-1-ND
CB11 | SMD_POLAR 80 50 | 511-1683-1-ND
CB12 | SMD_SIMPLE 60 30 | 490-1532-1-ND
CB13 | SMD_SIMPLE 60 30 | 490-1532-1-ND
CB14 | SMD_POLAR 80 50 | 511-1683-1-ND
R10 | SMD_SIMPLE 60 30 | P1.05KHCT-ND
R11 | SMD_SIMPLE 60 30 | P1.00KHCT-ND
R12 | SMD_SIMPLE 60 30 | P1.05KHCT-ND
R13 | SMD_SIMPLE 60 30 | P1.00KHCT-ND
U06 | SOT25 | LT1761ES5-SD#TRMPBFCT-ND
U07 | SOT25 | LT1964ES5-SD#TRMPBFCT-ND
# 08-ldo-hc-1of2.sch:
# --------------------------------------------
CB15 | SMD_SIMPLE 60 30 | 490-1532-1-ND
J02 | TRAPC3MX | TRAPC3MX-ND
R14 | SMD_SIMPLE 60 30 | P100KHCT-ND
R15 | SMD_SIMPLE 60 30 | P100KHCT-ND
R16 | SMD_SIMPLE 60 30 | P1.3MGCT-ND
R17 | SMD_SIMPLE 60 30 | P100KHCT-ND
R18 | SMD_SIMPLE 60 30 | P1.5MGCT-ND
R19 | SMD_SIMPLE 60 30 | P100KHCT-ND
R20 | SMD_SIMPLE 60 30 | P10.0KHCT-ND
U08 | SOT28 | LTC2909CTS8-5#TRMPBFCT-ND
# 09-ldo-hc-2of2.sch:
# --------------------------------------------
CB16 | SMD_SIMPLE 60 30 | 490-1532-1-ND
CB17 | SMD_POLAR 80 50 | 511-1683-1-ND
CB18 | SMD_SIMPLE 60 30 | 490-1532-1-ND
CB19 | SMD_POLAR 140 110 | P16641CT-ND
CB20 | SMD_SIMPLE 60 30 | 490-1532-1-ND
CB21 | SMD_POLAR 80 50 | 511-1683-1-ND
CB22 | SMD_SIMPLE 60 30 | 490-1532-1-ND
CB23 | SMD_POLAR 140 110 | P16641CT-ND
R21 | SMD_SIMPLE 60 30 | P3.16KHCT-ND
R22 | SMD_SIMPLE 60 30 | P1.00KHCT-ND
R23 | SMD_SIMPLE 60 30 | P1.00KHCT-ND
R24 | SMD_SIMPLE 60 30 | P3.16KHCT-ND
U09 | LT1764-DDPAK5 | LT1764AEQ#TRPBFCT-ND
U10 | LT1764-DDPAK5 | LT3015EQ#PBF-ND
# 10-iso.sch:
# --------------------------------------------
CB24 | SMD_SIMPLE 60 30 | 490-1532-1-ND
CB25 | SMD_POLAR 80 50 | 511-1683-1-ND
R25 | SMD_SIMPLE 60 30 | P330HCT-ND
R26 | SMD_SIMPLE 60 30 | P330HCT-ND
R27 | SMD_SIMPLE 60 30 | P330HCT-ND
R28 | SMD_SIMPLE 60 30 | P10.0KHCT-ND
R29 | SMD_SIMPLE 60 30 | P10.0KHCT-ND
R30 | SMD_SIMPLE 60 30 | P10.0KHCT-ND
U11 | SO16 | 516-2221-1-ND
# 11-asc-tune-1of2.sch:
# --------------------------------------------
CB26 | SMD_SIMPLE 60 30 | 490-1532-1-ND
CB27 | SMD_POLAR 80 50 | 511-1683-1-ND
CB28 | SMD_SIMPLE 60 30 | 490-1532-1-ND
CB29 | SMD_POLAR 80 50 | 511-1683-1-ND
CT01 | SMD_SIMPLE 60 30 | PCF1461CT-ND
CT02 | SMD_SIMPLE 60 30 | PCF1465CT-ND
CT03 | SMD_SIMPLE 60 30 | PCF1451CT-ND
CT04 | SMD_SIMPLE 60 30 | PCF1455CT-ND
CT05 | SMD_SIMPLE 80 50 | PCF1171CT-ND
CT06 | SMD_SIMPLE 80 50 | PCF1175CT-ND
CT07 | SMD_SIMPLE 120 60 | PCF1179CT-ND
CT08 | SMD_SIMPLE 120 60 | PCF1183CT-ND
R31 | SMD_SIMPLE 60 30 | P10.0KHCT-ND
U12 | TSSOP24 | ADG714BRUZ-REEL7CT-ND
# 12-asc-tune-2of2.sch:
# --------------------------------------------
CT09 | SMD_SIMPLE 120 100 | PCF1187CT-ND
CT10 | SMD_SIMPLE 120 100 | PCF1189CT-ND
CT11 | SMD_SIMPLE 120 60 | PCF1128CT-ND
CT12 | SMD_SIMPLE 120 60 | PCF1129CT-ND
CT13 | SMD_SIMPLE 120 60 | PCF1131CT-ND
CT14 | SMD_SIMPLE 60 30 | 490-1536-1-ND
CT15 | SMD_SIMPLE 60 30 | 490-3296-1-ND
CT16 | SMD_SIMPLE 60 30 | 490-7205-1-ND
U13 | TSSOP24 | ADG714BRUZ-REEL7CT-ND
# 13-asc-ina.sch:
# --------------------------------------------
C14 | SMD_SIMPLE 80 50 | PCF1177CT-ND
C15 | SMD_SIMPLE 80 50 | PCF1126CT-ND
C16 | SMD_SIMPLE 80 50 | PCF1177CT-ND
C17 | SMD_SIMPLE 60 30 | PCF1445CT-ND
CB30 | SMD_SIMPLE 60 30 | 490-1532-1-ND
CB31 | SMD_POLAR 80 50 | 511-1683-1-ND
CB32 | SMD_SIMPLE 60 30 | 490-1532-1-ND
CB33 | SMD_POLAR 80 50 | 511-1683-1-ND
D05 | SOT23 | 568-1619-1-ND
L03 | SMD_SIMPLE 60 30 | 490-1037-1-ND
L04 | SMD_SIMPLE 60 30 | 490-1037-1-ND
R32 | SMD_SIMPLE 60 30 | P49.9DBCT-ND
R33 | SMD_SIMPLE 60 30 | P49.9DBCT-ND
R34 | SMD_SIMPLE 60 30 | A102234CT-ND
R35 | SMD_SIMPLE 60 30 | A102234CT-ND
U14 | SO8 | AD8428ARZ-ND
# 14-asc-gain.sch:
# --------------------------------------------
C18 | SMD_SIMPLE 80 50 | PCF1126CT-ND
CB34 | SMD_SIMPLE 60 30 | 490-1532-1-ND
CB35 | SMD_POLAR 80 50 | 511-1683-1-ND
CB36 | SMD_SIMPLE 60 30 | 490-1532-1-ND
CB37 | SMD_POLAR 80 50 | 511-1683-1-ND
R36 | SMD_SIMPLE 60 30 | P100KDBCT-ND
R37 | SMD_SIMPLE 60 30 | P1.0KDBCT-ND
R38 | SMD_SIMPLE 60 30 | CRT0603-BY-10R0ELFCT-ND
U15 | SO8 | AD8597ARZ-ND
# 15-asc-fil-1of2.sch:
# --------------------------------------------
C19 | SMD_SIMPLE 80 50 | PCF1177CT-ND
C20 | SMD_SIMPLE 80 50 | PCF1177CT-ND
C21 | SMD_SIMPLE 80 50 | PCF1177CT-ND
C22 | SMD_SIMPLE 80 50 | PCF1177CT-ND
CB38 | SMD_SIMPLE 60 30 | 490-1532-1-ND
CB39 | SMD_POLAR 80 50 | 511-1683-1-ND
CB40 | SMD_SIMPLE 60 30 | 490-1532-1-ND
CB41 | SMD_POLAR 80 50 | 511-1683-1-ND
RF01 | SMD_SIMPLE 60 30 | P14.3KHCT-ND
RF02 | SMD_SIMPLE 60 30 | P15.4KHCT-ND
RF03 | SMD_SIMPLE 60 30 | P45.3KHCT-ND
RF04 | SMD_SIMPLE 60 30 | P5.49KHCT-ND
RF05 | SMD_SIMPLE 60 30 | P6.04KHCT-ND
RF06 | SMD_SIMPLE 60 30 | P17.4KHCT-ND
U16 | TSSOP14 | OP462HRUZ-REELCT-ND
# 16-asc-fil-2of2.sch:
# --------------------------------------------
C23 | SMD_SIMPLE 80 50 | PCF1177CT-ND
C24 | SMD_SIMPLE 80 50 | PCF1177CT-ND
C25 | SMD_SIMPLE 80 50 | PCF1177CT-ND
C26 | SMD_SIMPLE 80 50 | PCF1177CT-ND
RF07 | SMD_SIMPLE 60 30 | P13.3KHCT-ND
RF08 | SMD_SIMPLE 60 30 | P5.23KHCT-ND
RF09 | SMD_SIMPLE 60 30 | P232KHCT-ND
RF10 | SMD_SIMPLE 60 30 | P2.00KHCT-ND
RF11 | SMD_SIMPLE 60 30 | P732HCT-ND
RF12 | SMD_SIMPLE 60 30 | P34.8KHCT-ND
# 17-adc.sch:
# --------------------------------------------
C27 | SMD_SIMPLE 80 50 | PCF1126CT-ND
C28 | SMD_SIMPLE 80 50 | PCF1177CT-ND
CB42 | SMD_SIMPLE 60 30 | 490-1532-1-ND
CB43 | SMD_POLAR 80 50 | 511-1683-1-ND
CB44 | SMD_SIMPLE 60 30 | 490-1532-1-ND
CB45 | SMD_POLAR 80 50 | 511-1683-1-ND
CB46 | SMD_SIMPLE 60 30 | 490-1532-1-ND
CB47 | SMD_POLAR 80 50 | 511-1683-1-ND
L05 | SMD_SIMPLE 60 30 | 490-1037-1-ND
R39 | SMD_SIMPLE 60 30 | P10KDBCT-ND
R40 | SMD_SIMPLE 60 30 | P10KDBCT-ND
R41 | SMD_SIMPLE 60 30 | P49.9DBCT-ND
R42 | SMD_SIMPLE 60 30 | P10.0KHCT-ND
U17 | SOT26 | ADA4841-1YRJZ-R7CT-ND
U18 | SOT26 | AD7680ARJZ-REEL7CT-ND
# 18-dac.sch:
# --------------------------------------------
C29 | SMD_SIMPLE 60 30 | 490-5307-1-ND
CB48 | SMD_SIMPLE 60 30 | 490-1532-1-ND
CB49 | SMD_POLAR 80 50 | 511-1683-1-ND
CB50 | SMD_SIMPLE 60 30 | 490-1532-1-ND
CB51 | SMD_POLAR 80 50 | 511-1683-1-ND
CB52 | SMD_SIMPLE 60 30 | 490-5307-1-ND
U19 | TSSOP24_EP | AD5752RBREZ-ND
U20 | SO8 | ADR4520BRZ-ND
# 19-buf-shim.sch:
# --------------------------------------------
C30 | SMD_SIMPLE 60 30 | 445-2664-1-ND
CB53 | SMD_SIMPLE 60 30 | 490-1532-1-ND
CB54 | SMD_POLAR 80 50 | 511-1683-1-ND
CB55 | SMD_SIMPLE 60 30 | 490-1532-1-ND
CB56 | SMD_POLAR 80 50 | 511-1683-1-ND
D06 | SOT23 | BAS40-04-V-GS08CT-ND
LJ01 | BNC_LAY | A97555-ND
R43 | SMD_SIMPLE 60 30 | P0.0GCT-ND
R44 | SMD_SIMPLE 60 30 | P1.00MHCT-ND
R45 | SMD_SIMPLE 60 30 | P715DBCT-ND
U21 | SO8 | LT1206CS8#PBF-ND
# 20-buf-tx.sch:
# --------------------------------------------
CB57 | SMD_SIMPLE 60 30 | 490-1532-1-ND
CB58 | SMD_POLAR 80 50 | 511-1683-1-ND
CB59 | SMD_SIMPLE 60 30 | 490-1532-1-ND
CB60 | SMD_POLAR 80 50 | 511-1683-1-ND
D07 | SOT23 | BAS40-04-V-GS08CT-ND
LJ02 | BNC_LAY | A97555-ND
R46 | SMD_SIMPLE 60 30 | P0.0GCT-ND
R47 | SMD_SIMPLE 60 30 | P1.00MHCT-ND
R48 | SMD_SIMPLE 60 30 | P715DBCT-ND
U22 | LT1210-DDPAK7 | LT1210CR#PBF-ND
# 21-pol.sch:
# --------------------------------------------
CB61 | SMD_SIMPLE 60 30 | 490-1532-1-ND
CB62 | SMD_SIMPLE 60 30 | 490-1532-1-ND
CB63 | SMD_POLAR 80 50 | 511-1683-1-ND
D08 | DO214AB | S5GC-FDICT-ND
D09 | DO214AB | SMDJ45ACT-ND
Q01 | DPAK | IRLR024NPBFCT-ND
R49 | SMD_SIMPLE 60 30 | P10.0KHCT-ND
R50 | SMD_SIMPLE 60 30 | P33.2HCT-ND
R51 | SMD_SIMPLE 60 30 | P1.00KHCT-ND
U23 | SOT25 | FAN3111ESXCT-ND
# 22-relay.sch:
# --------------------------------------------
D10 | SOD323 | SD101AWSTPMSCT-ND
K01 | Omron-G6A2 | Z123-ND
LJ03 | BNC_LAY | A97555-ND
Q02 | SOT23 | FDN327NCT-ND
R52 | SMD_SIMPLE 60 30 | P10.0KHCT-ND
# 23-leds.sch:
# --------------------------------------------
DL1 | SMD_POLAR 60 30 | 160-1828-1-ND
DL2 | SMD_POLAR 60 30 | 160-1828-1-ND
DL3 | SMD_POLAR 60 30 | 160-1828-1-ND
DL4 | SMD_POLAR 60 30 | 160-1828-1-ND
DL5 | SMD_POLAR 60 30 | 160-1828-1-ND
DL6 | SMD_POLAR 60 30 | 160-1828-1-ND
DL7 | SMD_POLAR 60 30 | 160-1828-1-ND
DL8 | SMD_POLAR 60 30 | 160-1828-1-ND
RL1 | SMD_SIMPLE 60 30 | P604HCT-ND
RL2 | SMD_SIMPLE 60 30 | P604HCT-ND
RL3 | SMD_SIMPLE 60 30 | P604HCT-ND
RL4 | SMD_SIMPLE 60 30 | P604HCT-ND
RL5 | SMD_SIMPLE 60 30 | P604HCT-ND
RL6 | SMD_SIMPLE 60 30 | P604HCT-ND
RL7 | SMD_SIMPLE 60 30 | P604HCT-ND
RL8 | SMD_SIMPLE 60 30 | P604HCT-ND
