geekysuavo/pyppm/designs/ppm-1.0/ppm-bom.csv

# 01-overview.sch:
# ----------------
# 02-pulprog.sch:
# ---------------
# 03-mcu-core.sch:
# ----------------
C01 | 100n | 0805 | 311-1142-1-ND
C02 | 100n | 0805 | 311-1142-1-ND
C03 | 10u | 1206 | 399-3824-1-ND
C04 | 10u | 1206 | 399-3824-1-ND
C05 | 1u | 0805 | 399-1284-1-ND
C06 | 27p | 0805 | 399-1114-1-ND
C07 | 27p | 0805 | 399-1114-1-ND
C08 | 100n | 0805 | 311-1142-1-ND
C09 | 100n | 0805 | 311-1142-1-ND
D01 | 1N4148 | SOD123 | 1N4148WTPMSCT-ND
D02 | 1N4148 | SOD123 | 1N4148WTPMSCT-ND
J01 | Mini-B | - | H2959CT-ND
R01 | 22 | 0805 | P22.0CCT-ND
R02 | 22 | 0805 | P22.0CCT-ND
R03 | 47k | 0805 | P47.0KCCT-ND
R04 | 330 | 0805 | P330CCT-ND
R05 | 47k | 0805 | P47.0KCCT-ND
R06 | 330 | 0805 | P330CCT-ND
S01 | SPST-NO | - | 450-1758-1-ND
S02 | SPST-NO | - | 450-1758-1-ND
U01 | ATm32u2 | TQFP32 | ATMEGA32U2-AU-ND
U02 | XO-16M | HC49US | 887-1274-1-ND
# 04-mcu-ports.sch:
# -----------------
R34 | 47k | 0805 | P47.0KCCT-ND
# 05-dcdc.sch:
# ------------
C10 | 4.7u | 0805 | 399-7415-1-ND
C11 | 4.7u | 0805 | 399-7415-1-ND
C12 | 820p | 0805 | PCF1295CT-ND
C13 | 2.2n | 1206 | 478-2953-1-ND
D03 | BAS40-04 | SOT23 | BAS40-04-V-GS08CT-ND
D04 | BAS40-04 | SOT23 | BAS40-04-V-GS08CT-ND
R07 | 16.9k | 0805 | P16.9KCCT-ND
R08 | 16.9k | 0805 | P16.9KCCT-ND
T01 | CTX02-13665 | - | 513-1625-1-ND
U03 | LT3439 | TSSOP16 | LT3439EFE#PBF-ND
# 06-ldo.sch:
# -----------
C14 | 15u | 1812 | 445-3927-1-ND
C15 | 15u | 1812 | 445-3927-1-ND
C16 | 10n | 0805 | PCF1177CT-ND
C17 | 10u | 1206 | 399-3824-1-ND
C18 | 15u | 1812 | 445-3927-1-ND
C19 | 15u | 1812 | 445-3927-1-ND
C20 | 10n | 0805 | PCF1177CT-ND
C21 | 10u | 1206 | 399-3824-1-ND
L01 | 33u | - | 513-1063-1-ND
L02 | 33u | - | 513-1063-1-ND
U04 | LT1761 | SOT25 | LT1761ES5-5#TRMPBFCT-ND
U05 | LT1964 | SOT25 | LT1964ES5-5#TRMPBFCT-ND
# 07-asc-ina.sch:
# ---------------
C22 | 1n | 0805 | PCF1296CT-ND
C23 | 1n | 0805 | PCF1296CT-ND
C24 | 10n | 0805 | PCF1177CT-ND
C25 | 220p | 0805 | PCF1288CT-ND
C26 | 100n | 0805 | 311-1142-1-ND
C27 | 10u | 1206 | 399-3824-1-ND
C28 | 100n | 0805 | 311-1142-1-ND
C29 | 10u | 1206 | 399-3824-1-ND
D05 | SD101A | SOD123 | SD101AW-7FDICT-ND
D06 | SD101A | SOD123 | SD101AW-7FDICT-ND
L03 | MMZ | 0805 | 445-2199-1-ND
L04 | MMZ | 0805 | 445-2199-1-ND
R09 | 33.2 | 0805 | P33.2CCT-ND
R10 | 33.2 | 0805 | P33.2CCT-ND
R11 | 1M | 0805 | P1.00MCCT-ND
R12 | 1M | 0805 | P1.00MCCT-ND
U06 | AD8428 | SO8 | AD8428ARZ-ND
# 08-asc-gain.sch:
# ----------------
C30 | 100n | 0805 | PCF1126CT-ND
C31 | 100n | 0805 | 311-1142-1-ND
C32 | 10u | 1206 | 399-3824-1-ND
C33 | 100n | 0805 | 311-1142-1-ND
C34 | 10u | 1206 | 399-3824-1-ND
R13 | 100k | 0805 | P100KCCT-ND
R14 | 1k | 0805 | P1.00KCCT-ND
R15 | 10 | 0805 | P10.0CCT-ND
U07 | AD8597 | SO8 | AD8597ARZ-ND
# 09-asc-fil-1of2.sch:
# --------------------
C35 | 100n | 0805 | 311-1142-1-ND
C36 | 10u | 1206 | 399-3824-1-ND
C37 | 100n | 0805 | 311-1142-1-ND
C38 | 10u | 1206 | 399-3824-1-ND
C39 | 10n | 0805 | PCF1177CT-ND
C40 | 10n | 0805 | PCF1177CT-ND
C41 | 10n | 0805 | PCF1177CT-ND
C42 | 10n | 0805 | PCF1177CT-ND
R16 | 14.3k | 0805 | P14.3KCCT-ND
R17 | 15.4k | 0805 | P15.4KDACT-ND
R18 | 45.3k | 0805 | P45.3KCCT-ND
R19 | 5.49k | 0805 | P5.49KCCT-ND
R20 | 6.04k | 0805 | P6.04KCCT-ND
R21 | 17.4k | 0805 | P17.4KCCT-ND
U08 | OP462 | SO14 | OP462GSZ-ND
# 10-asc-fil-2of2.sch:
# --------------------
C43 | 10n | 0805 | PCF1177CT-ND
C44 | 10n | 0805 | PCF1177CT-ND
C45 | 10n | 0805 | PCF1177CT-ND
C46 | 10n | 0805 | PCF1177CT-ND
R22 | 13.3k | 0805 | P13.3KCCT-ND
R23 | 5.23k | 0805 | P5.23KCCT-ND
R24 | 232k | 0805 | P232KCCT-ND
R25 | 2k | 0805 | P2.0KACT-ND
R26 | 732 | 0805 | P732CCT-ND
R27 | 34.8k | 0805 | P34.8KCCT-ND
# 11-adc.sch:
# -----------
C47 | 100n | 0805 | PCF1126CT-ND
C48 | 10u | 1206 | 399-3824-1-ND
C49 | 100n | 0805 | 311-1142-1-ND
C50 | 10u | 1206 | 399-3824-1-ND
C51 | 100n | 0805 | 311-1142-1-ND
C52 | 10n | 0805 | PCF1177CT-ND
C53 | 100n | 0805 | 311-1142-1-ND
C54 | 10u | 1206 | 399-3824-1-ND
L05 | MMZ | 0805 | 445-2199-1-ND
R28 | 10k | 0805 | P10.0KCCT-ND
R29 | 10k | 0805 | P10.0KCCT-ND
R30 | 33.2 | 0805 | P33.2CCT-ND
U09 | ADA4841-1 | SOT26 | ADA4841-1YRJZ-R7CT-ND
U10 | AD7680 | SOT26 | AD7680ARJZ-REEL7CT-ND
# 12-dac.sch:
# -----------
C55 | 100n | 0805 | 311-1142-1-ND
C56 | 10u | 1206 | 399-3824-1-ND
L06 | MMZ | 0805 | 445-2199-1-ND
U11 | AD5300 | SOT26 | AD5300BRTZREEL7CT-ND
# 13-ccs.sch:
# -----------
B01 | 6V | - | CP-037BHPJCT-ND
C57 | 1n | 0805 | PCF1296CT-ND
C58 | 10u | 1206 | 399-3824-1-ND
C59 | 100n | 0805 | 311-1142-1-ND
Q01 | IRLR024N | DPAK | IRLR024NPBFCT-ND
R31 | 2.5 | DPAK | PWR163S-25-2R50F-ND
U12 | AD8591 | SOT26 | AD8591ARTZ-REEL7CT-ND
# 14-relay.sch:
# -------------
D07 | SD101A | SOD123 | SD101AW-7FDICT-ND
J02 | Coil | BNC | A97555-ND
K01 | G6A-2 | - | Z123-ND
Q02 | FDN327N | SOT23 | FDN327NCT-ND
# 15-leds.sch:
# ------------
D08 | LNJP | 0603 | LNJP12X8ARACT-ND
D09 | LNJP | 0603 | LNJP12X8ARACT-ND
R32 | 422 | 0603 | 311-422DCT-ND
R33 | 422 | 0603 | 311-422DCT-ND
