geekysuavo/pyppm/designs/ppm-2.2/v2-brd.pdf

# v2.pcb

# 1. Table of Contents (This Page) Created on Sun Oct 5 19:02:26 2014

# 2. component 3. solder 4. GND 5. power 6. plated-drill 7. componentmask 8. soldermask 9. topsilk 10. bottomsilk 11. toppaste 12. topassembly 13. bottomassembly 14. fab

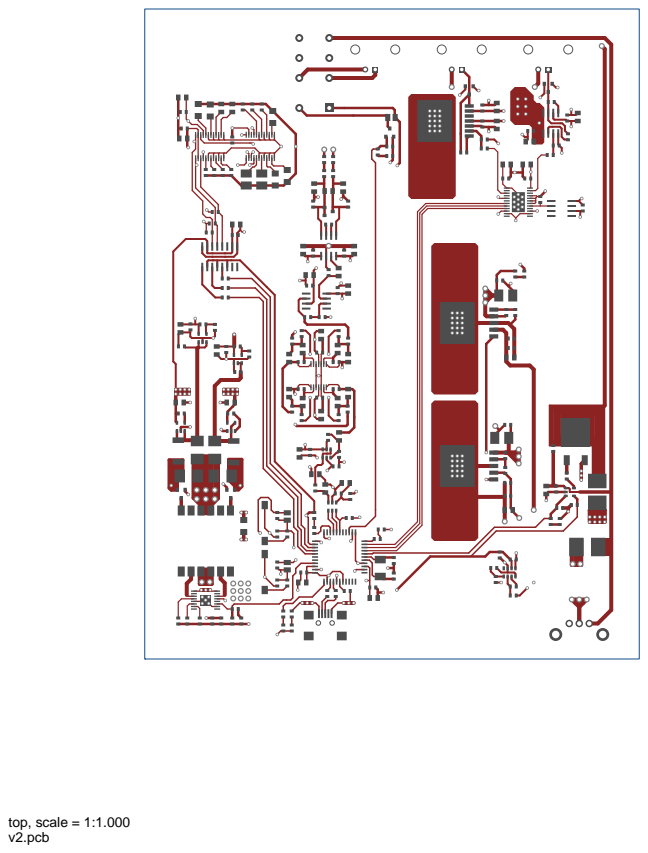
[picture p34: page 2]
top, scale = 1:1.000

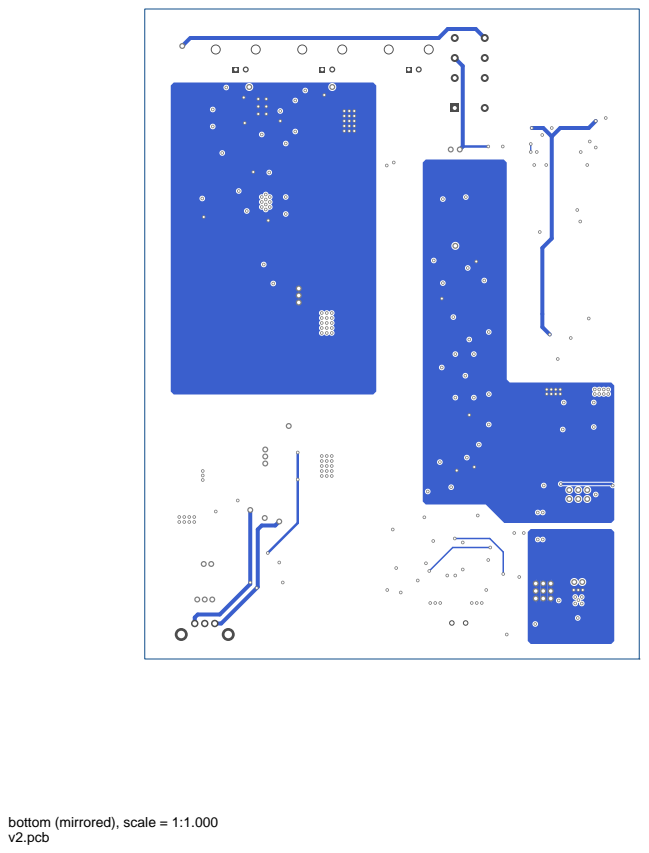
[picture p35: page 3]

bottom (mirrored), scale = 1:1.000

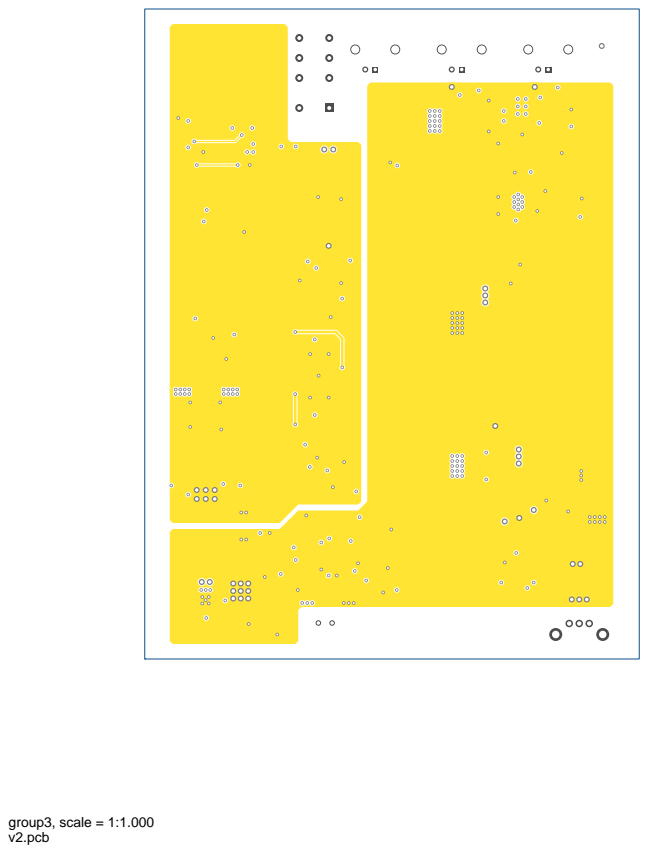
[picture p36: page 4]
group3, scale = 1:1.000

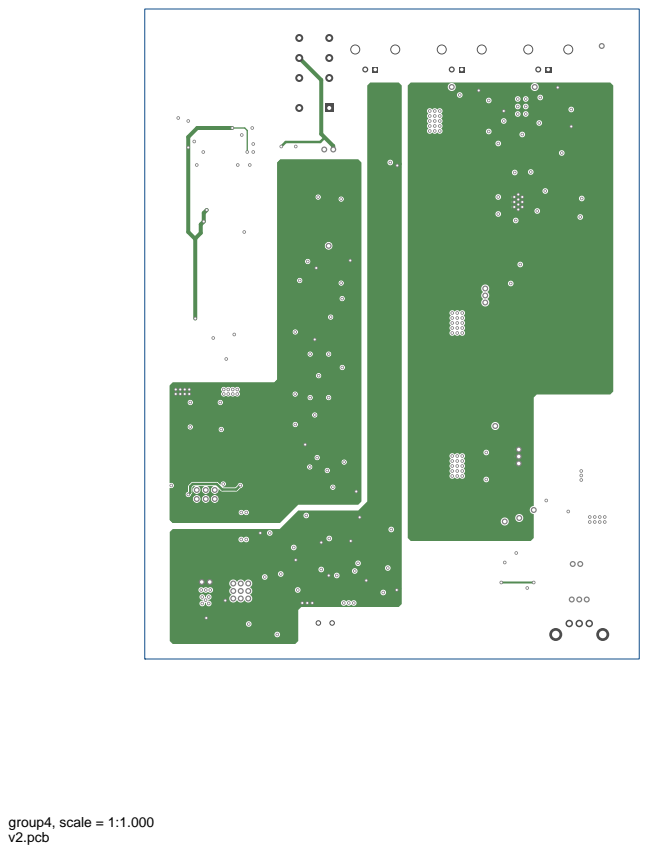
[picture p37: page 5]
group4, scale = 1:1.000

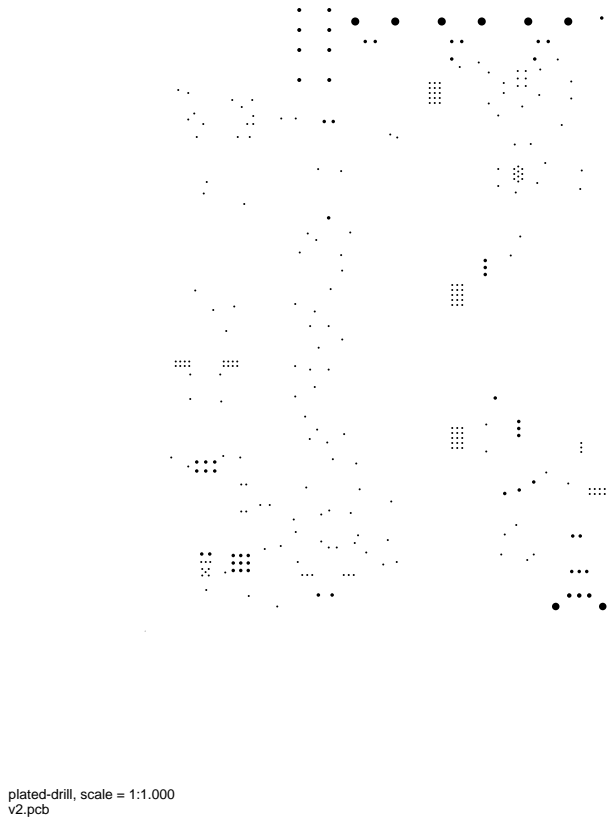
[picture p38: page 6]

plated-drill, scale = 1:1.000

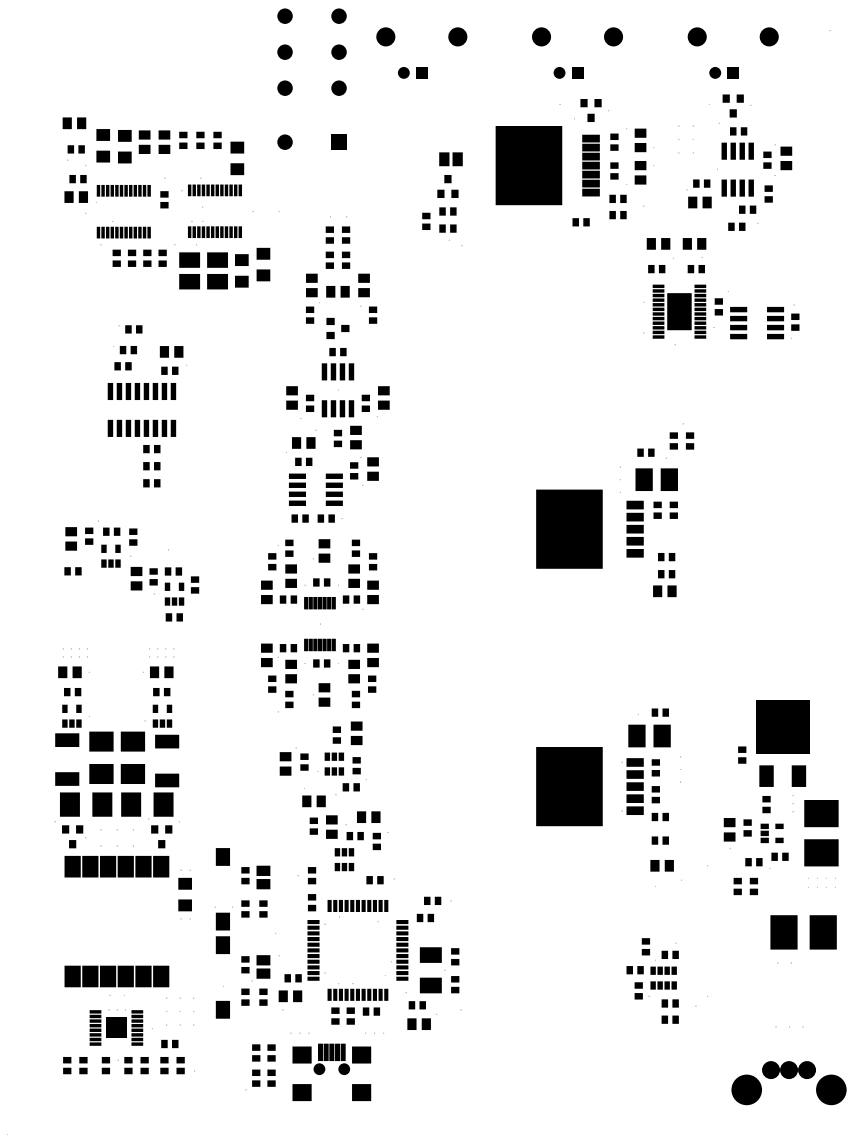
[picture p39: figure]

topmask, scale = 1:1.000

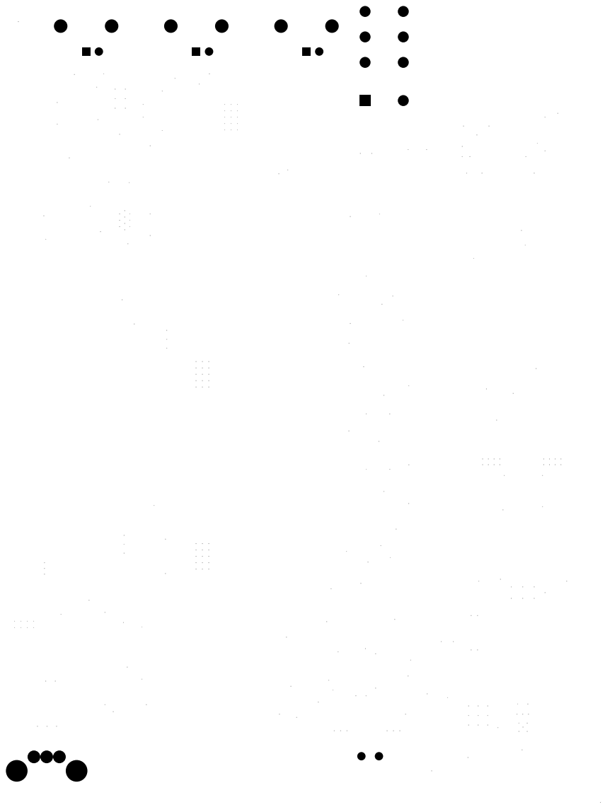
[picture p40: figure]

bottommask (mirrored), scale = 1:1.000

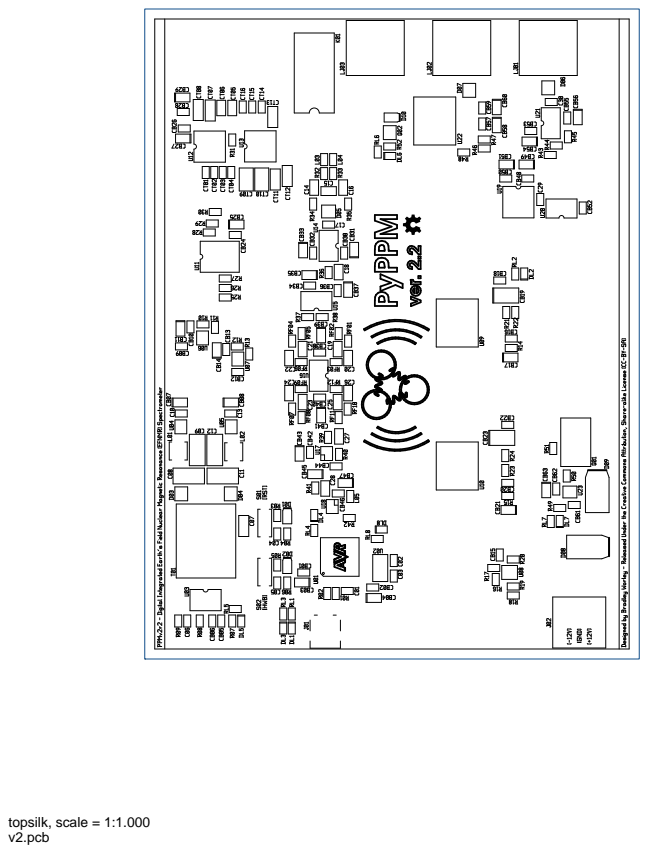
[picture p41: page 9]
topsilk, scale = 1:1.000

bottomsilk (mirrored), scale = 1:1.000

toppaste, scale = 1:1.000

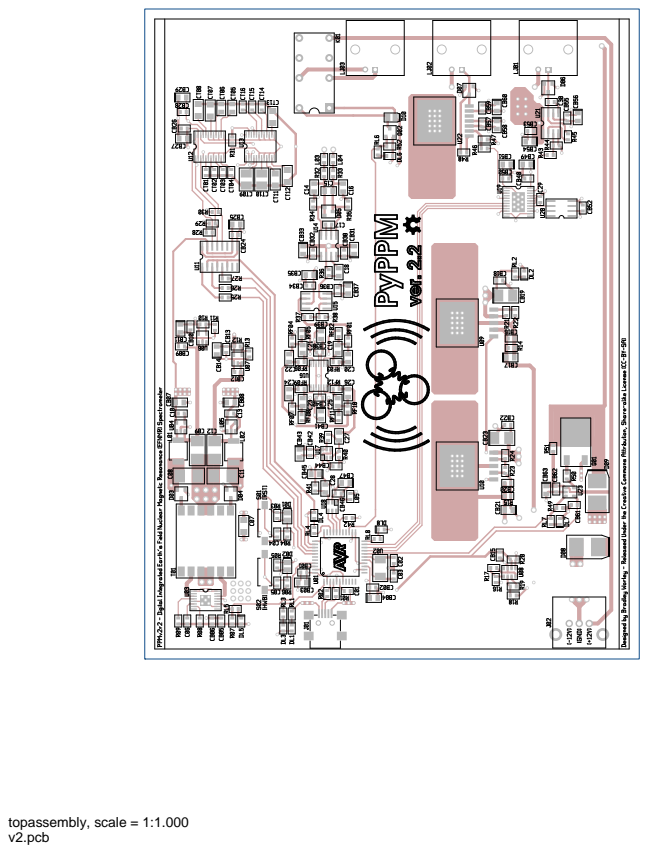
[picture p42: page 12]
topassembly, scale = 1:1.000

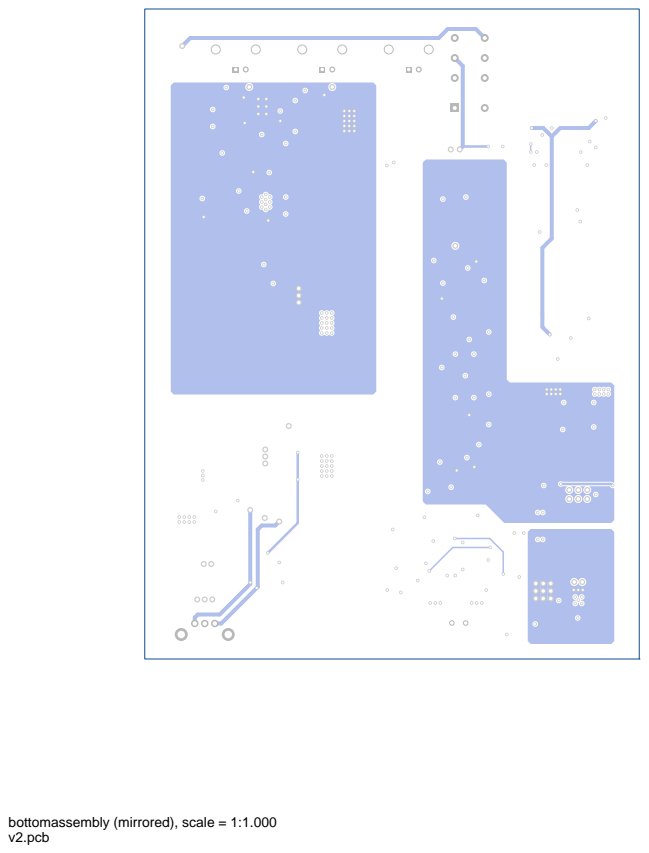
[picture p43: page 13]

bottomassembly (mirrored), scale = 1:1.000

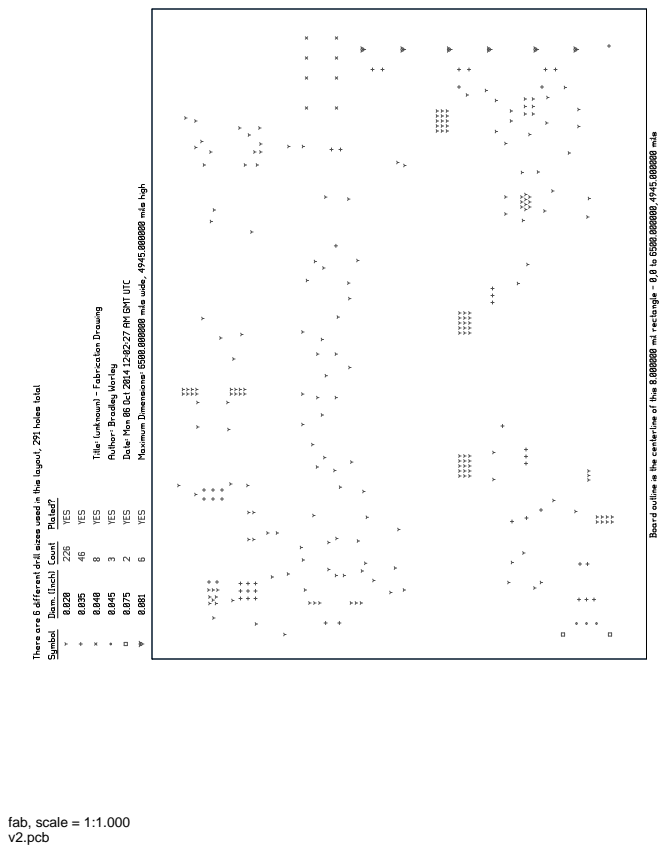
[picture p44: page 14]
fab, scale = 1:1.000
