geekysuavo/pyppm/designs/ppm-2.2/v2r2.pdf

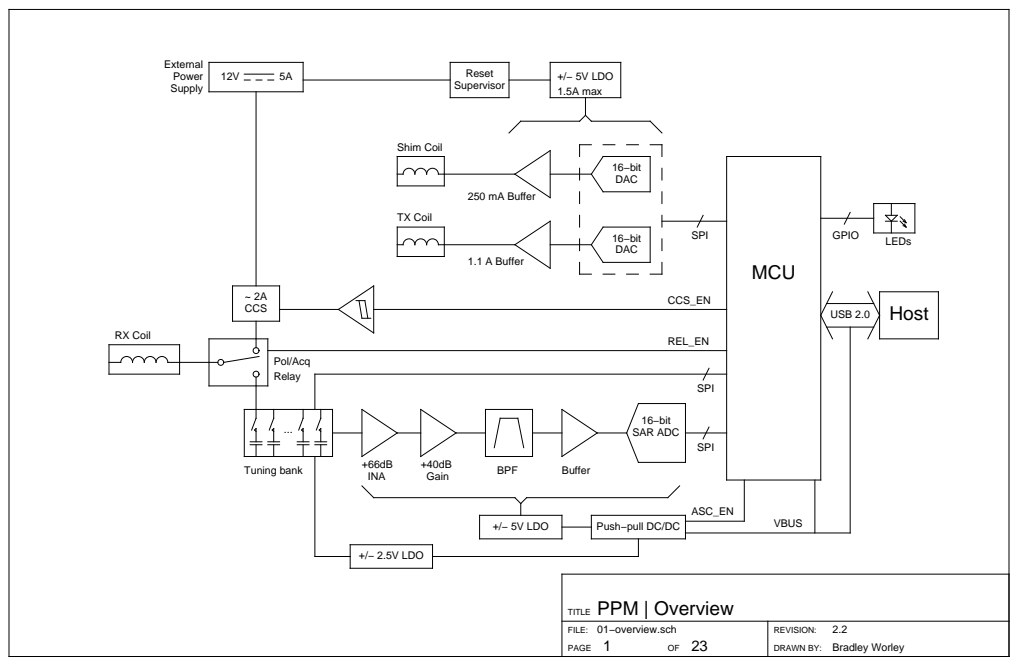
[picture p45: page 1]
PAGE; DRAWN BY:; Bradley Worley; SAR ADC; RX Coil; USB 2.0; +/− 5V LDO; LEDs GPIO; +/− 2.5V LDO; Shim Coil; 250 mA Buffer; +/− 5V LDO 1.5A max; Tuning bank; TX Coil; 1.1 A Buffer

Push−pull DC/DC

TITLE PPM | Overview

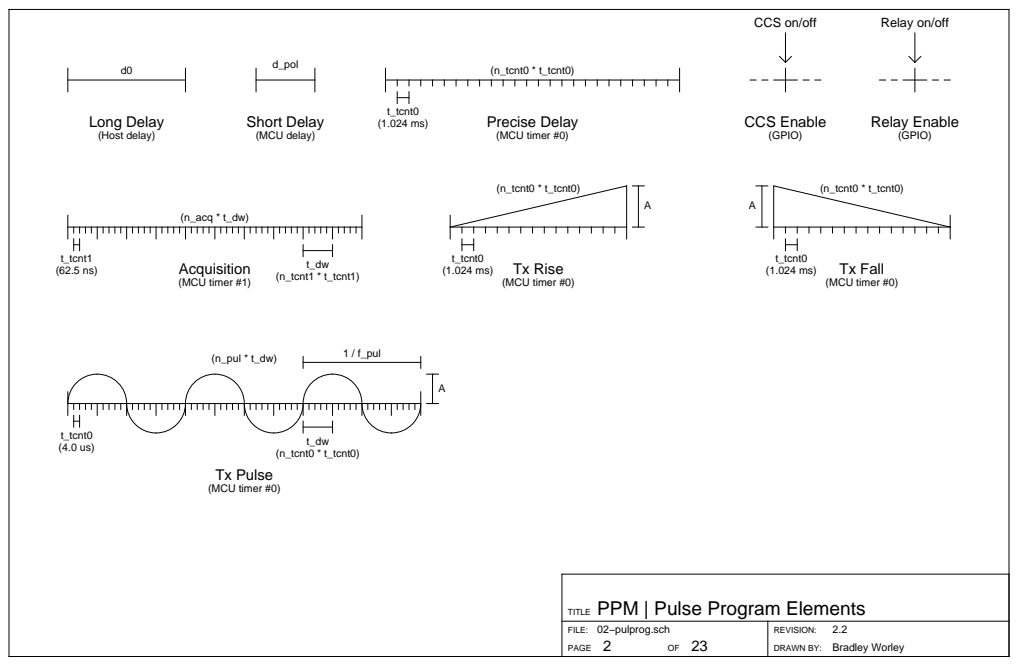
[picture p46: page 2]
PAGE; DRAWN BY:; Bradley Worley; Short Delay (MCU delay); t_tcnt0; Precise Delay; (MCU timer #0); (MCU timer #1); (n_tcnt0 * t_tcnt0); (n_acq * t_dw); Long Delay (Host delay); CCS Enable; Relay Enable; (n_tcnt1 * t_tcnt1); Tx Rise (MCU timer #0); Tx Fall (MCU timer #0); Tx Pulse (MCU timer #0); (n_pul * t_dw); 1 / f_pul

CCS on/off

Relay on/off

TITLE PPM | Pulse Program Elements

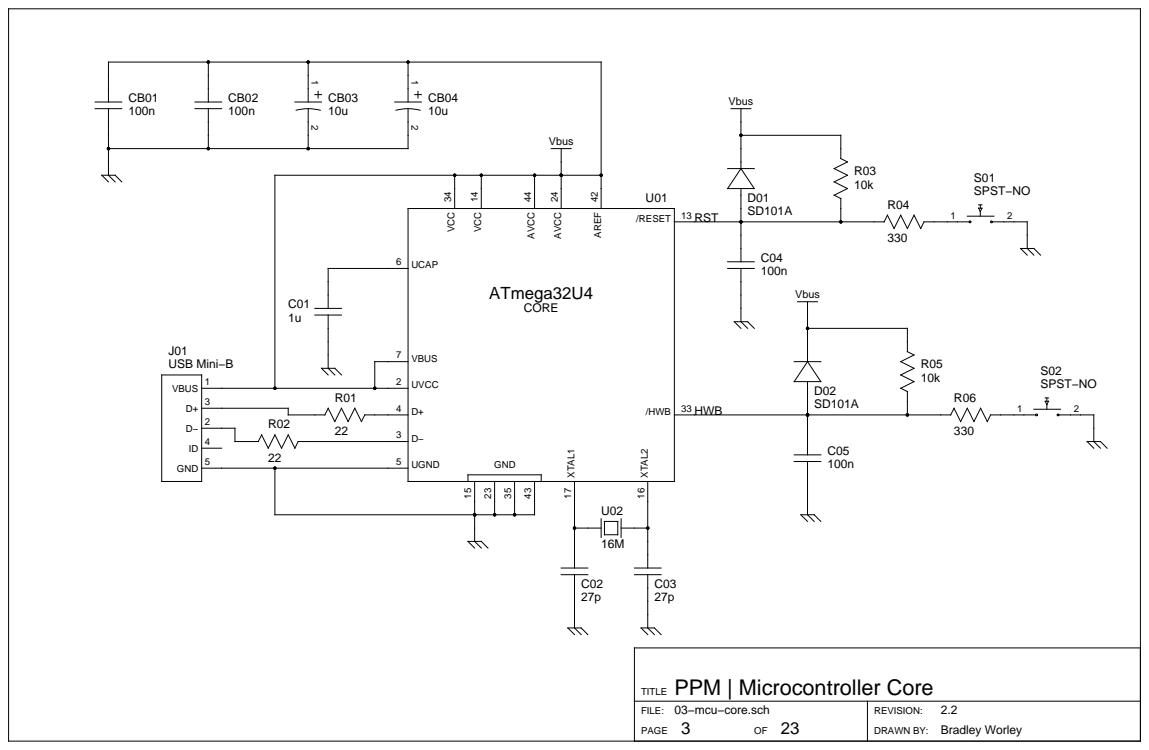
[picture p47: page 3]

TITLE PPM | Microcontroller Core

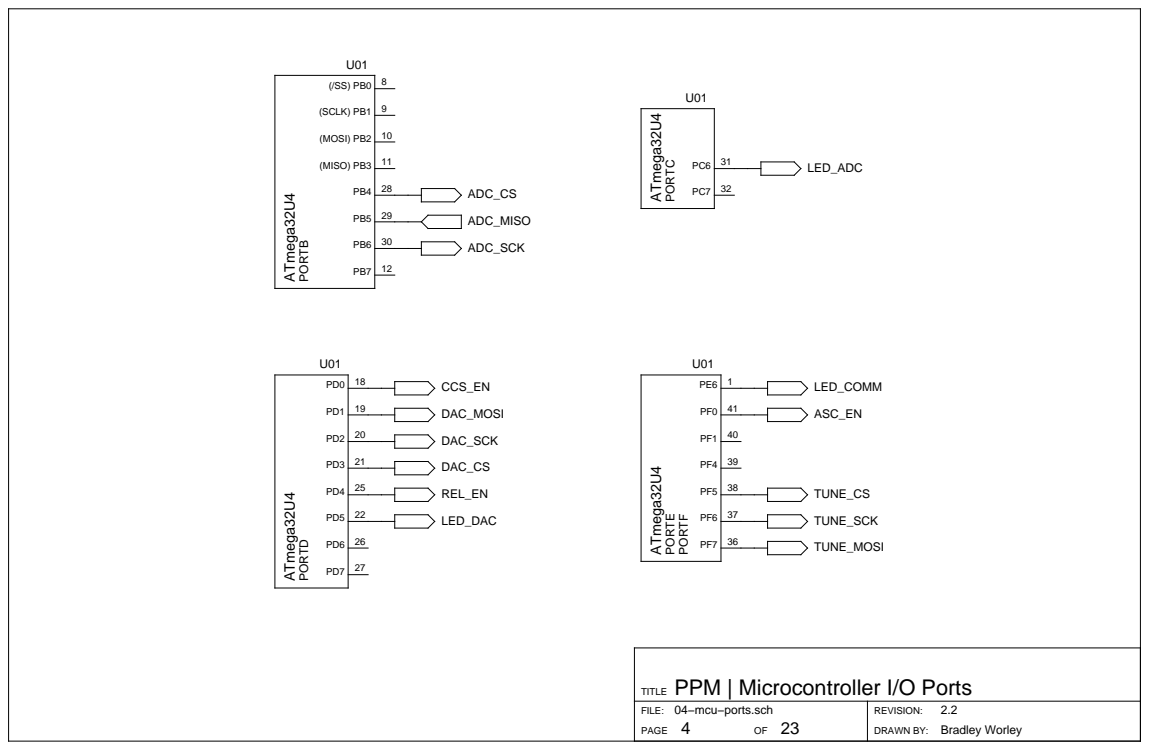
[picture p48: page 4]
PAGE; DRAWN BY:; Bradley Worley; 9 (SCLK) PB1; 10 (MOSI) PB2; 11 (MISO) PB3; PORTC31 PC6 32 PC7; PORTE37 PF6 36 PF7

TITLE PPM | Microcontroller I/O Ports

04−mcu−ports.sch

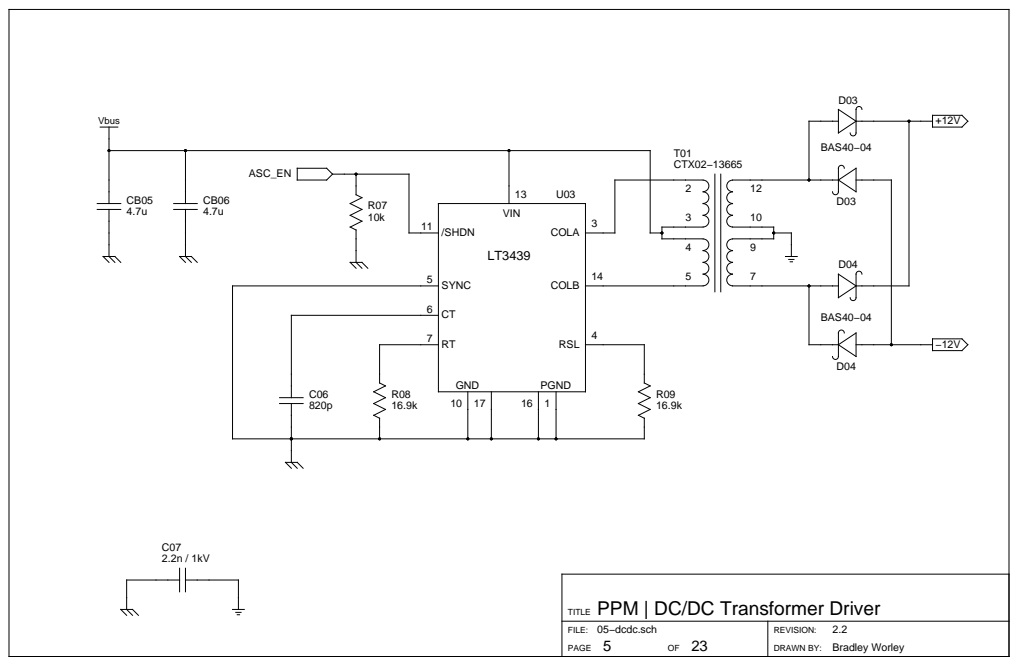
[picture p49: page 5]

TITLE PPM | DC/DC Transformer Driver

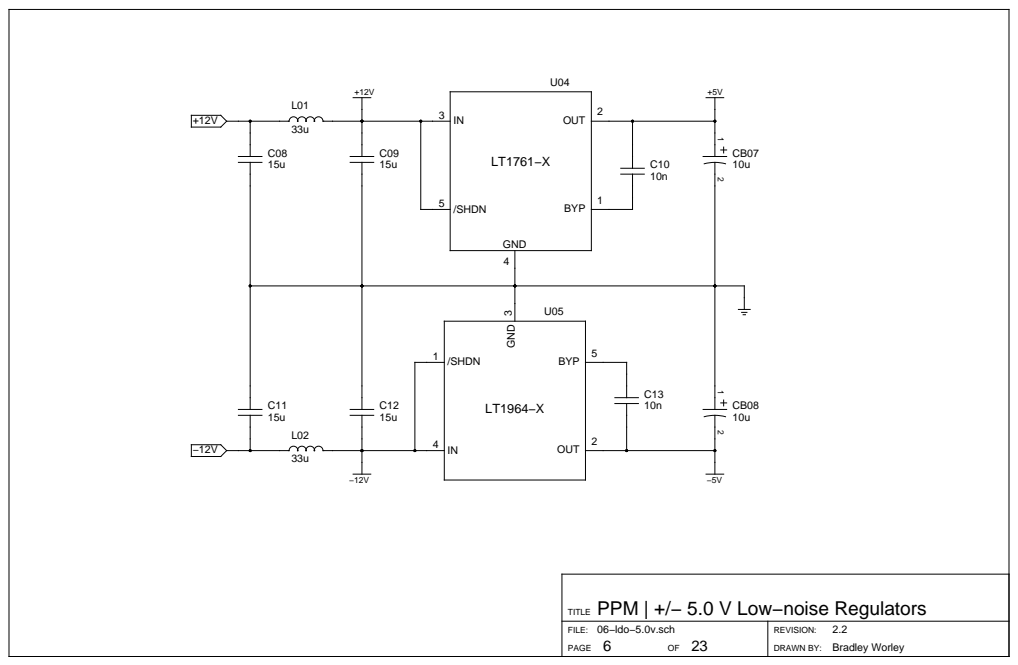
[picture p50: page 6]

TITLE PPM | +/− 5.0 V Low−noise Regulators

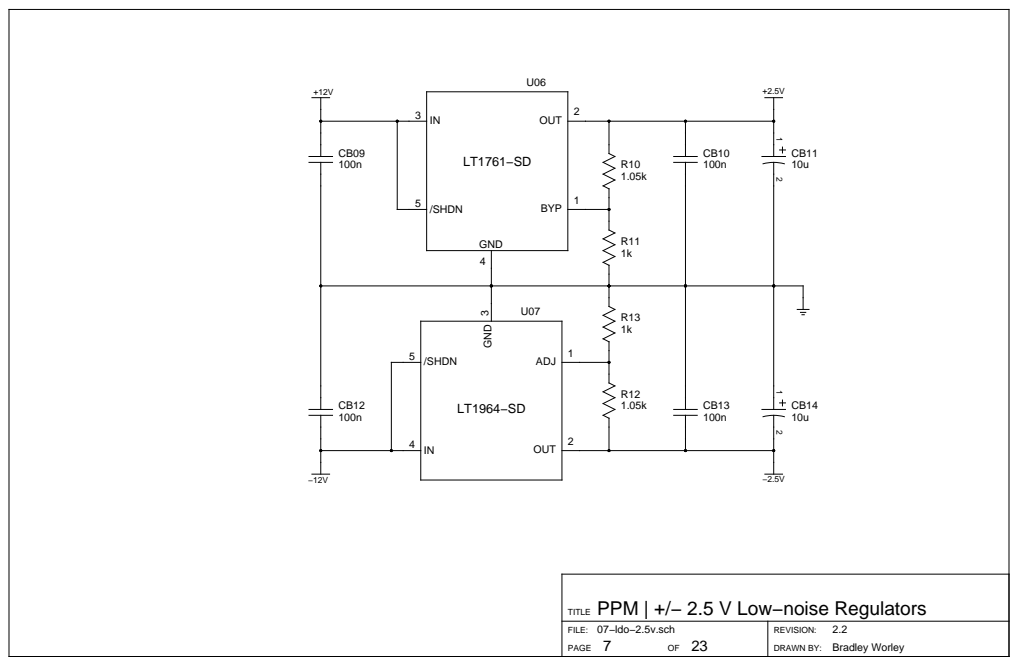
[picture p51: page 7]
PAGE; DRAWN BY:; Bradley Worley; 3 GND; ADJ 5; /SHDN; BYP 5

TITLE PPM | +/− 2.5 V Low−noise Regulators

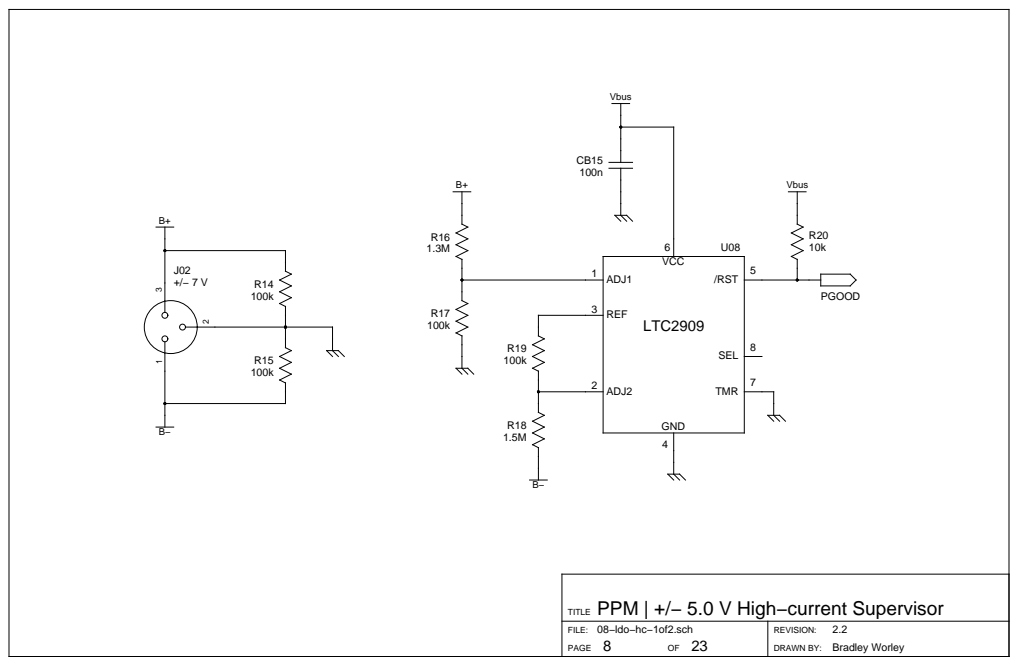
[picture p52: page 8]

TITLE PPM | +/− 5.0 V High−current Supervisor

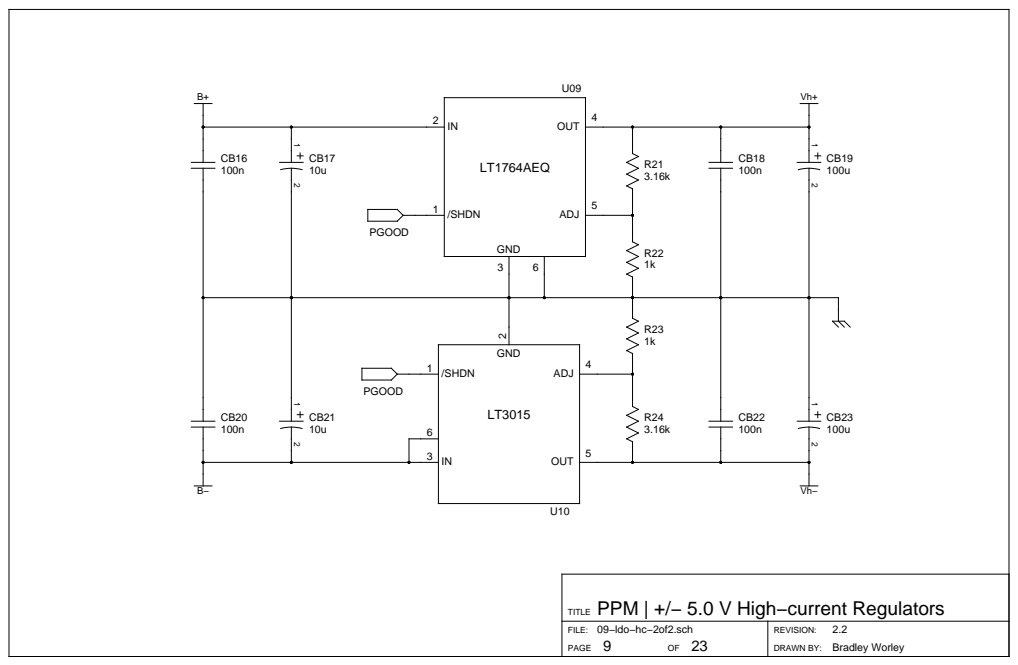
[picture p53: page 9]
PAGE; DRAWN BY:; Bradley Worley; ADJ 1; /SHDN

TITLE PPM | +/− 5.0 V High−current Regulators

09−ldo−hc−2of2.sch

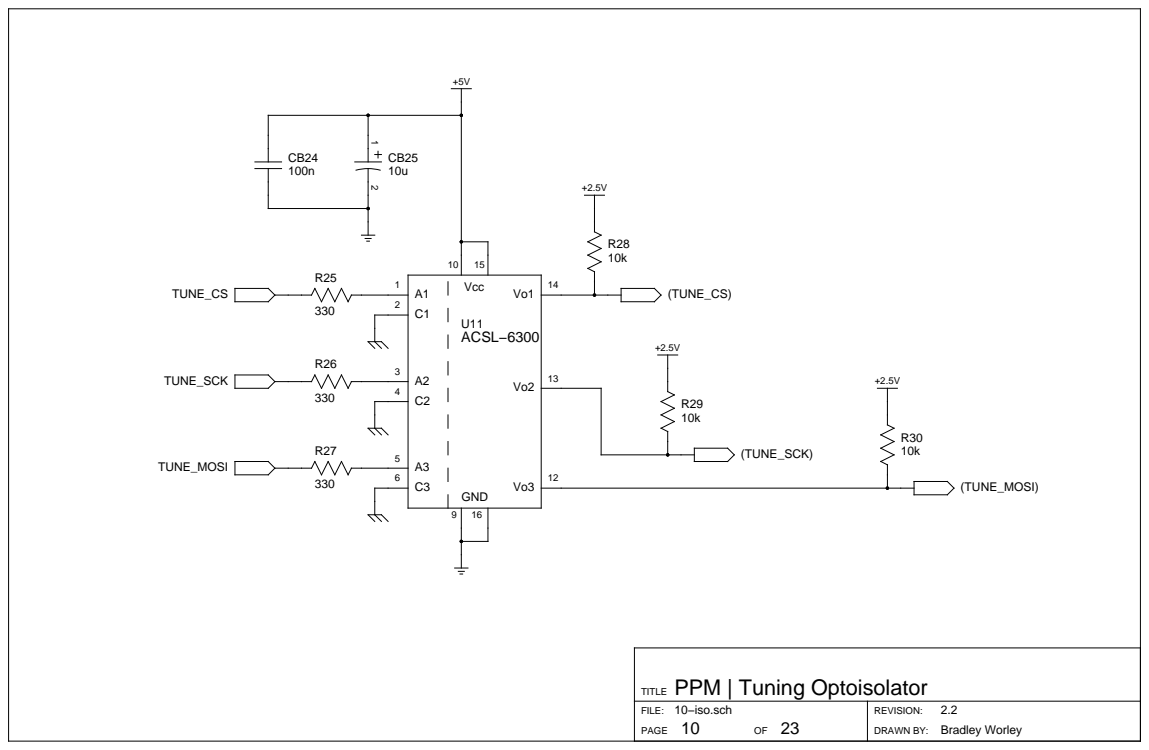
[picture p54: page 10]

TITLE PPM | Tuning Optoisolator

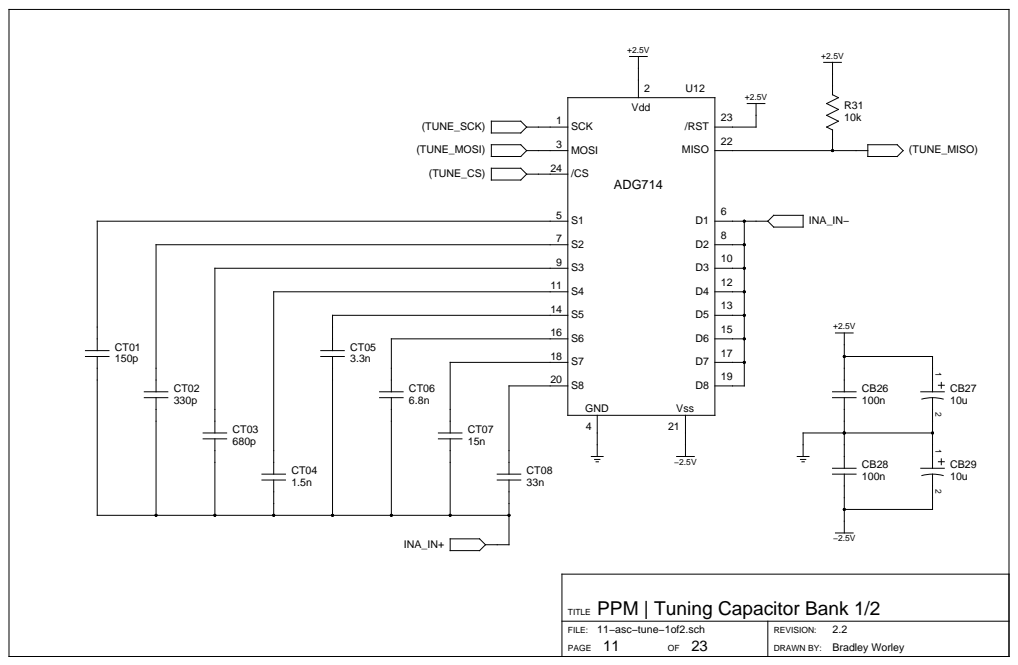
[picture p55: page 11]

TITLE PPM | Tuning Capacitor Bank 1/2

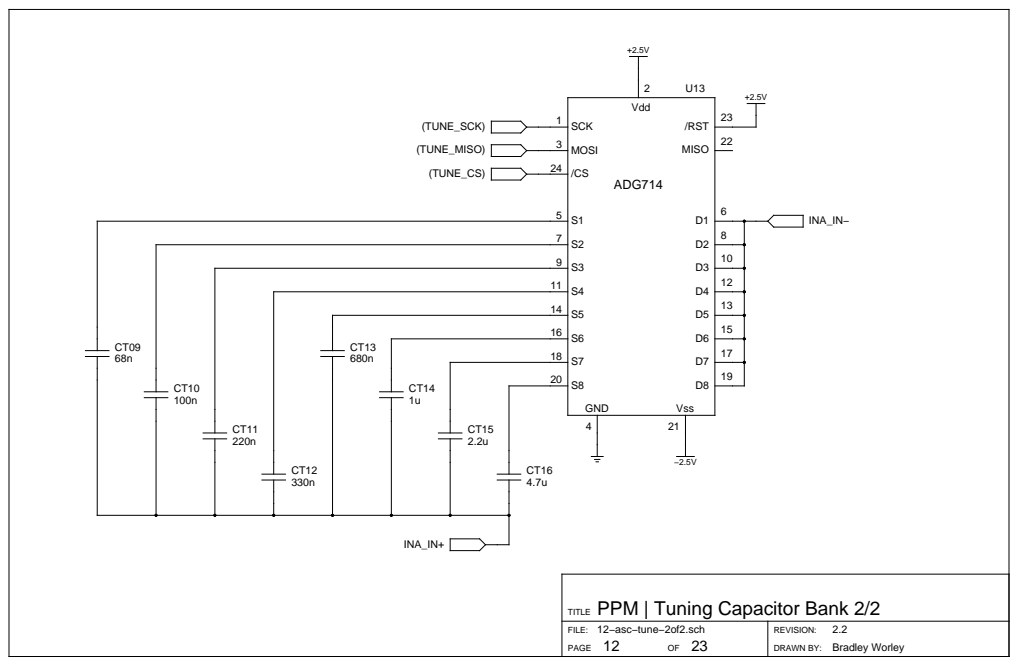
[picture p56: page 12]

TITLE PPM | Tuning Capacitor Bank 2/2

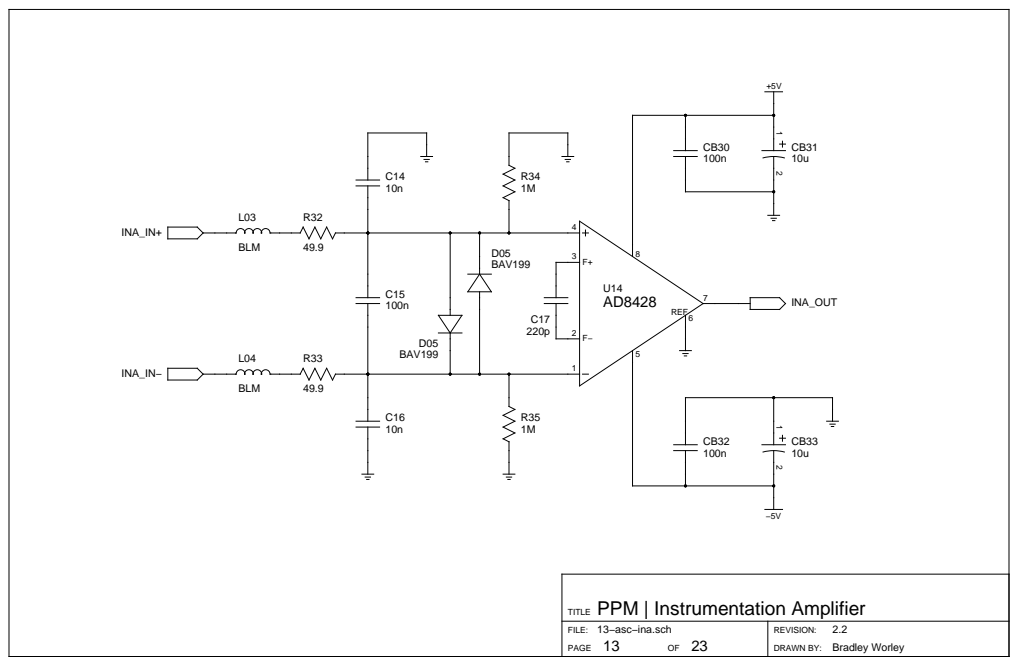
[picture p57: page 13]

TITLE PPM | Instrumentation Amplifier

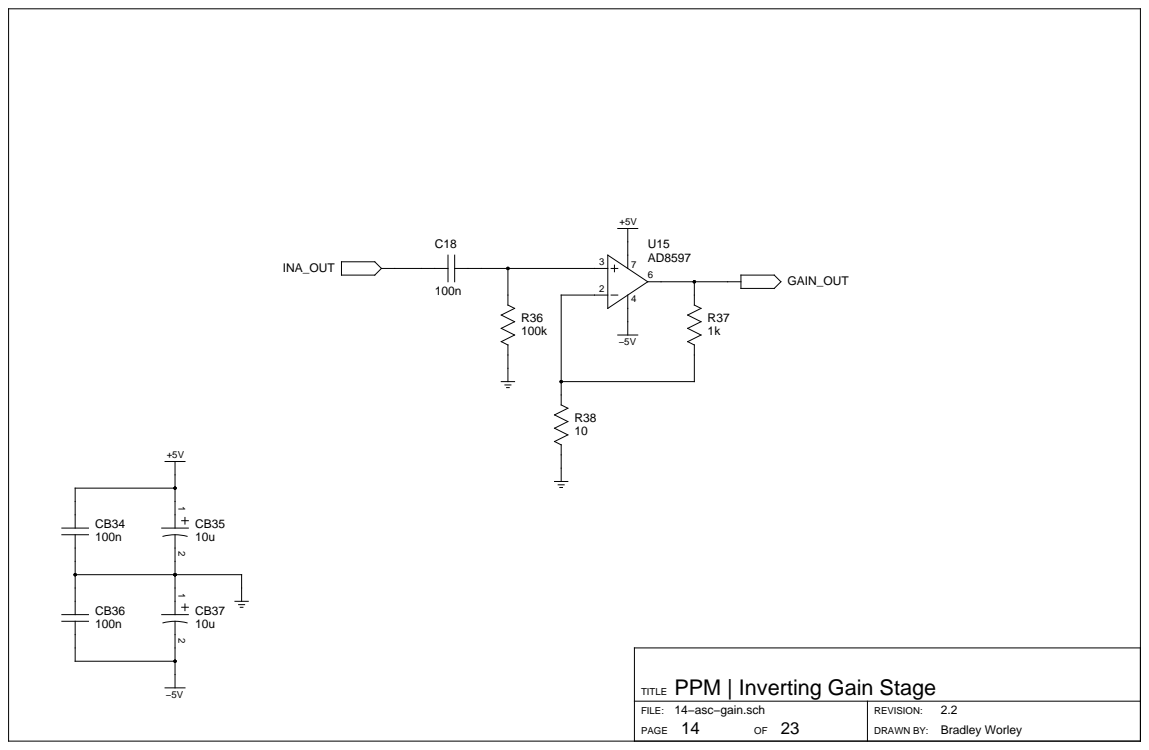
[picture p58: page 14]
PAGE; DRAWN BY:; Bradley Worley

TITLE PPM | Inverting Gain Stage

14−asc−gain.sch

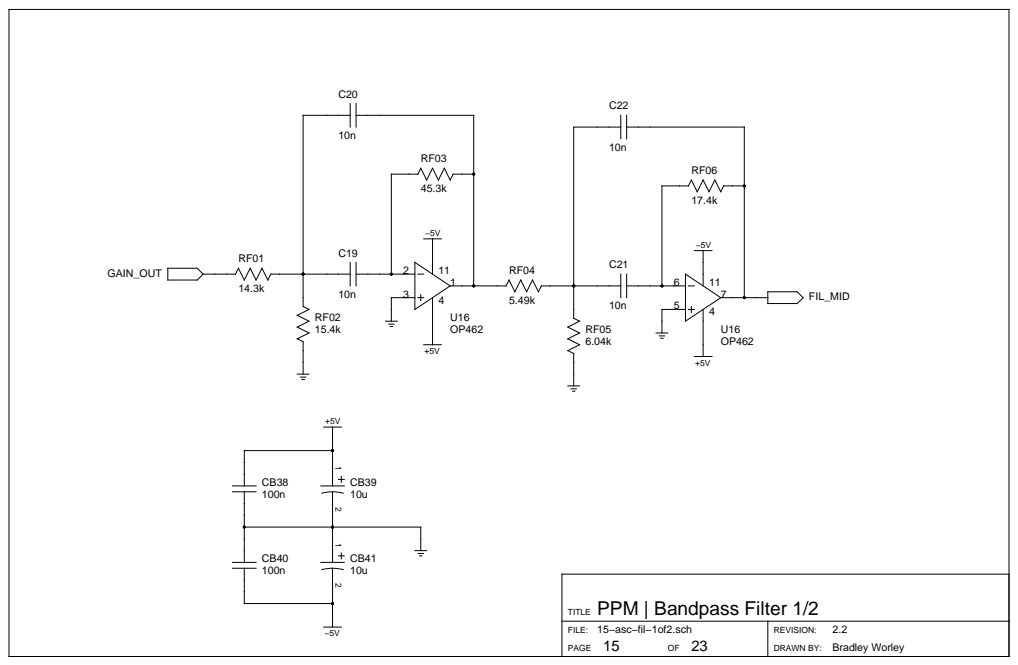
[picture p59: page 15]
PAGE; DRAWN BY:; Bradley Worley

TITLE PPM | Bandpass Filter 1/2

15−asc−fil−1of2.sch

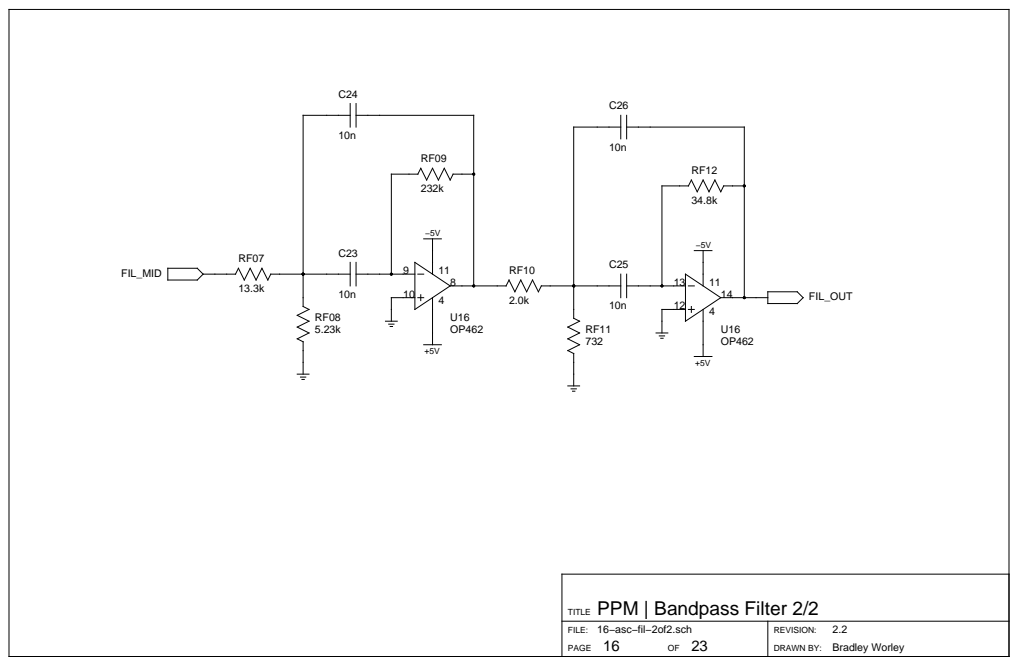
[picture p60: page 16]
PAGE; DRAWN BY:; Bradley Worley

TITLE PPM | Bandpass Filter 2/2

16−asc−fil−2of2.sch

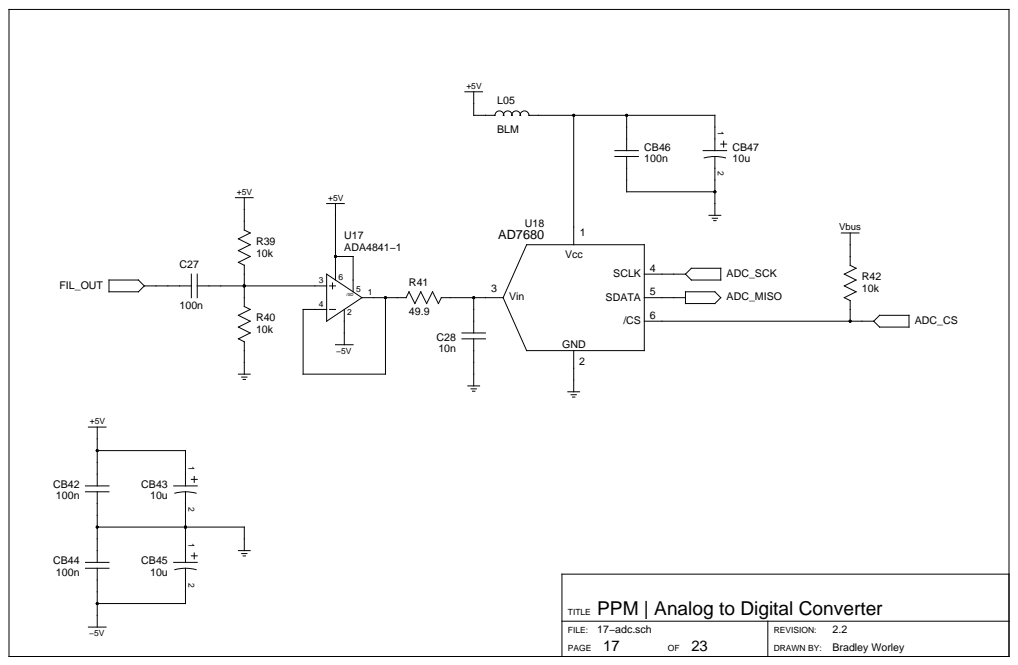
[picture p61: page 17]

TITLE PPM | Analog to Digital Converter

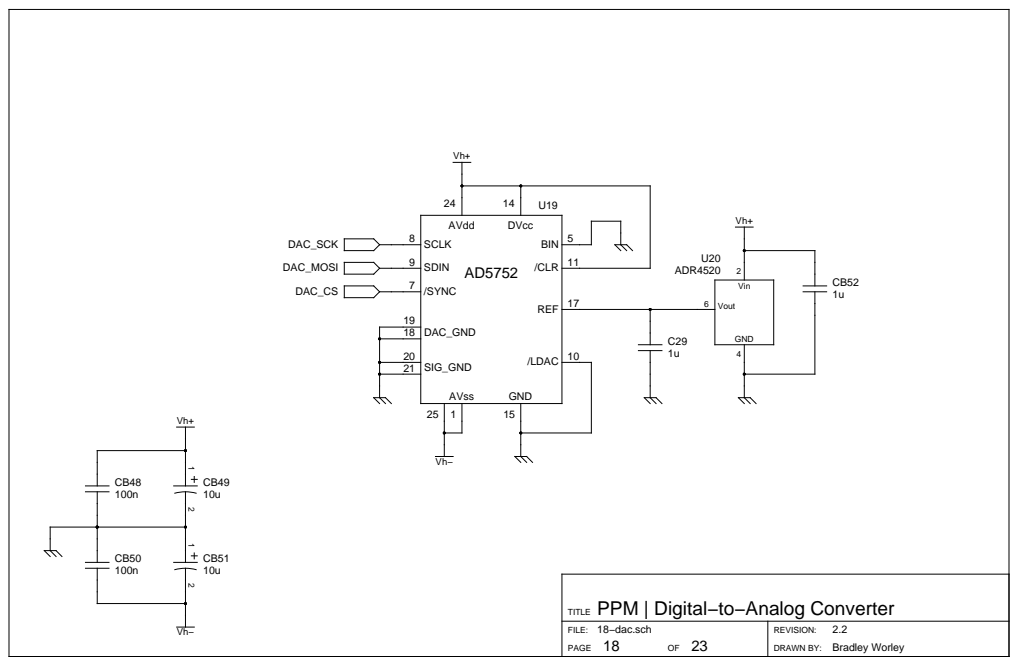
[picture p62: page 18]
PAGE; DRAWN BY:; Bradley Worley; 10 /LDAC; 11 /CLR; 5 BIN; 17 REF

TITLE PPM | Digital−to−Analog Converter

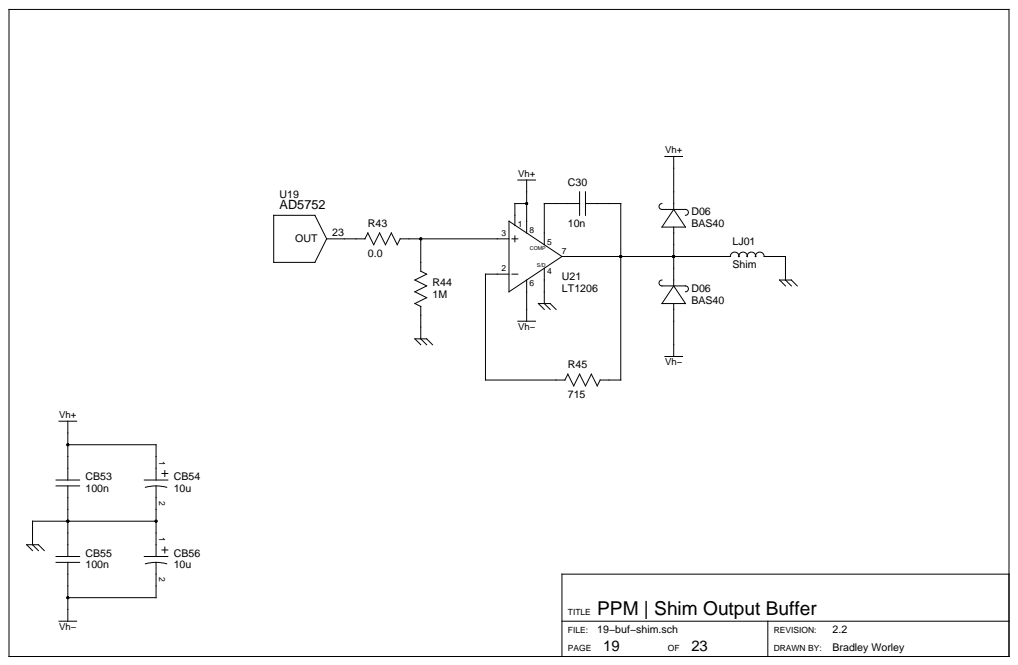
[picture p63: page 19]
PAGE; DRAWN BY:; Bradley Worley; 23 OUT

TITLE PPM | Shim Output Buffer

19−buf−shim.sch

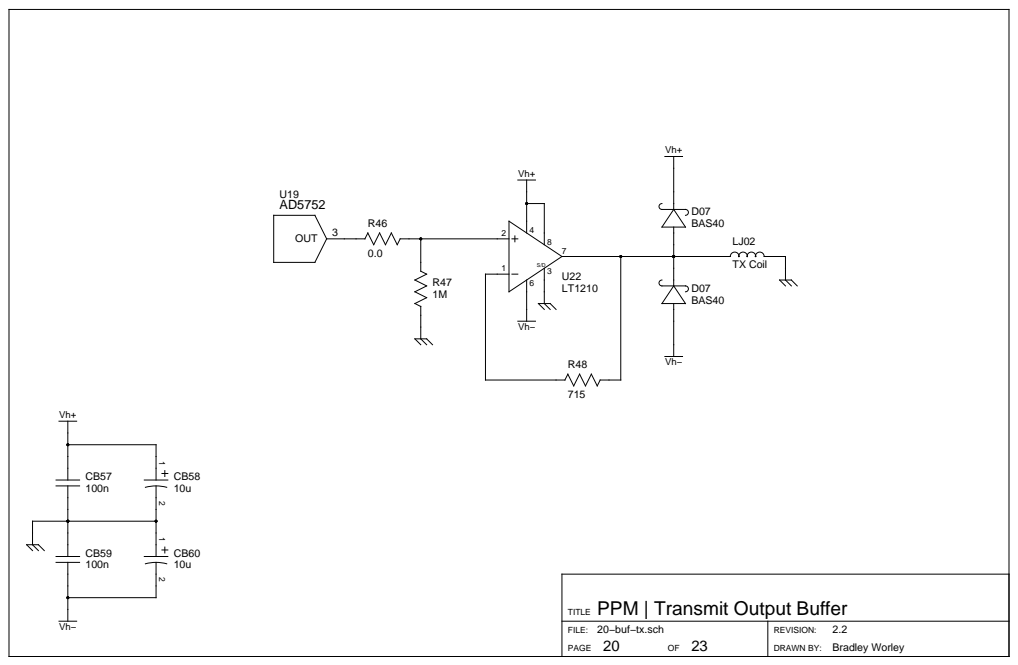
[picture p64: page 20]
PAGE; DRAWN BY:; Bradley Worley; TX Coil; 3 OUT

TITLE PPM | Transmit Output Buffer

20−buf−tx.sch

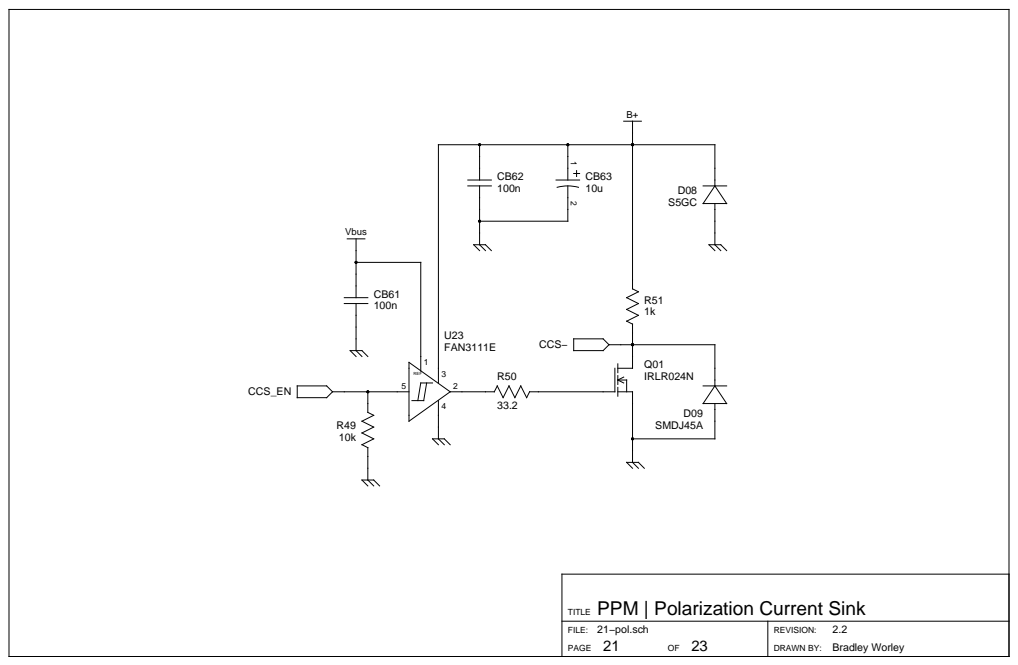
[picture p65: page 21]
PAGE; DRAWN BY:; Bradley Worley

TITLE PPM | Polarization Current Sink

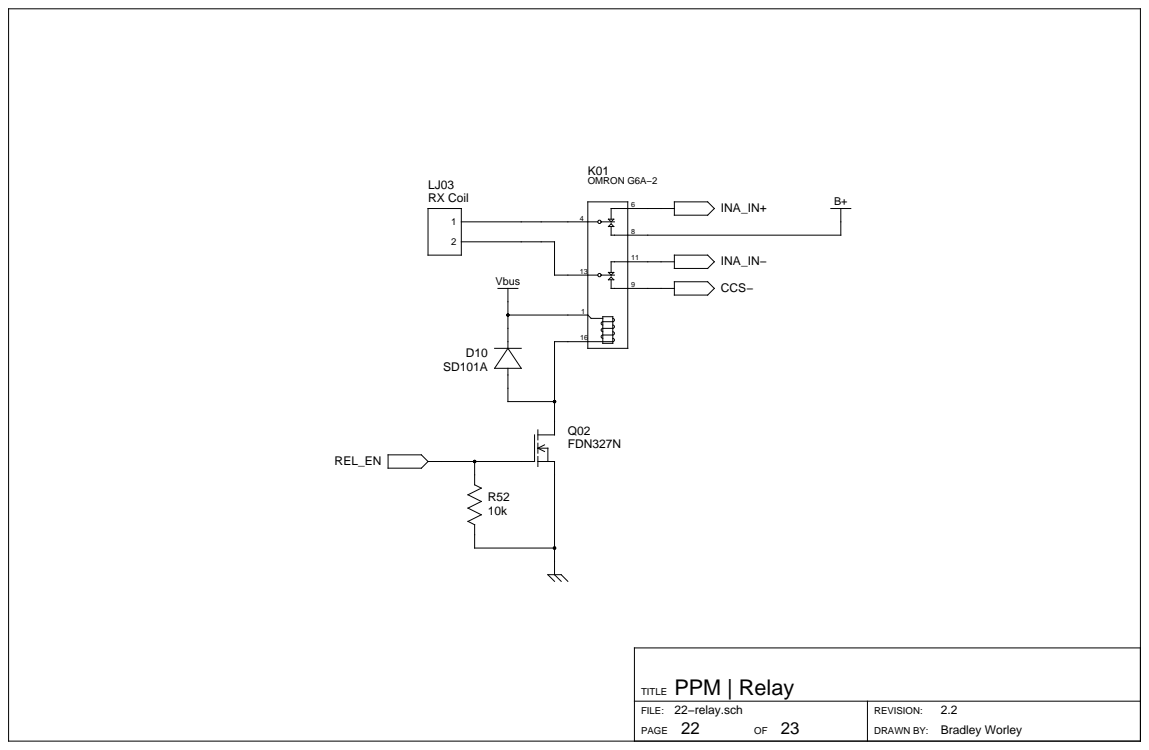
[picture p66: page 22]
PAGE; DRAWN BY:; Bradley Worley; RX Coil; OMRON G6A−2

TITLE PPM | Relay

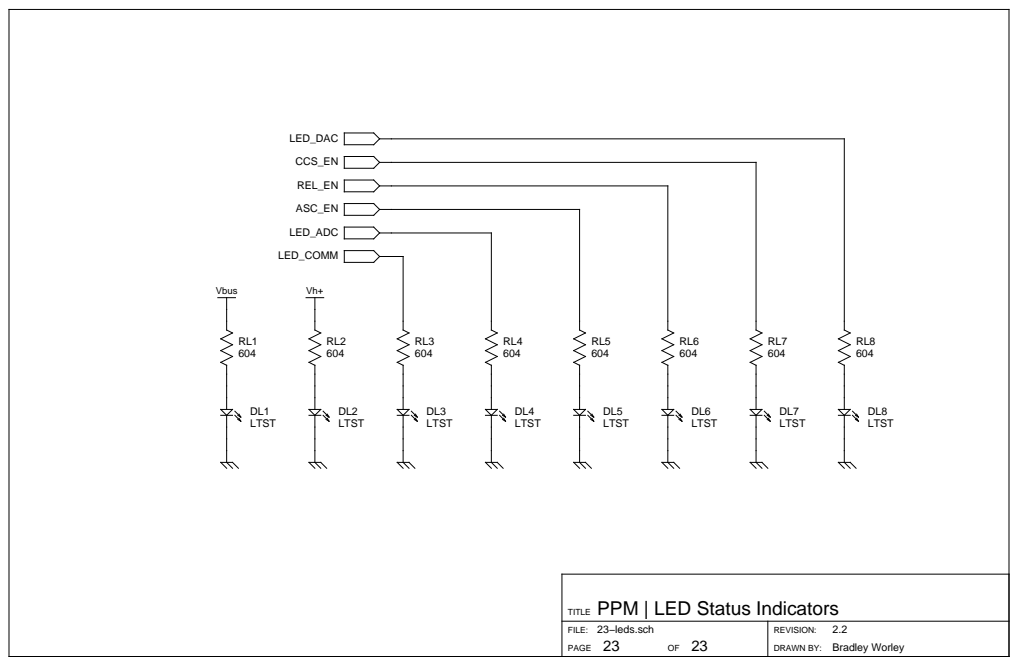
[picture p67: page 23]
PAGE; DRAWN BY:; Bradley Worley

TITLE PPM | LED Status Indicators
