geekysuavo/pyppm/designs/case-ppm-1.3/v1.pdf

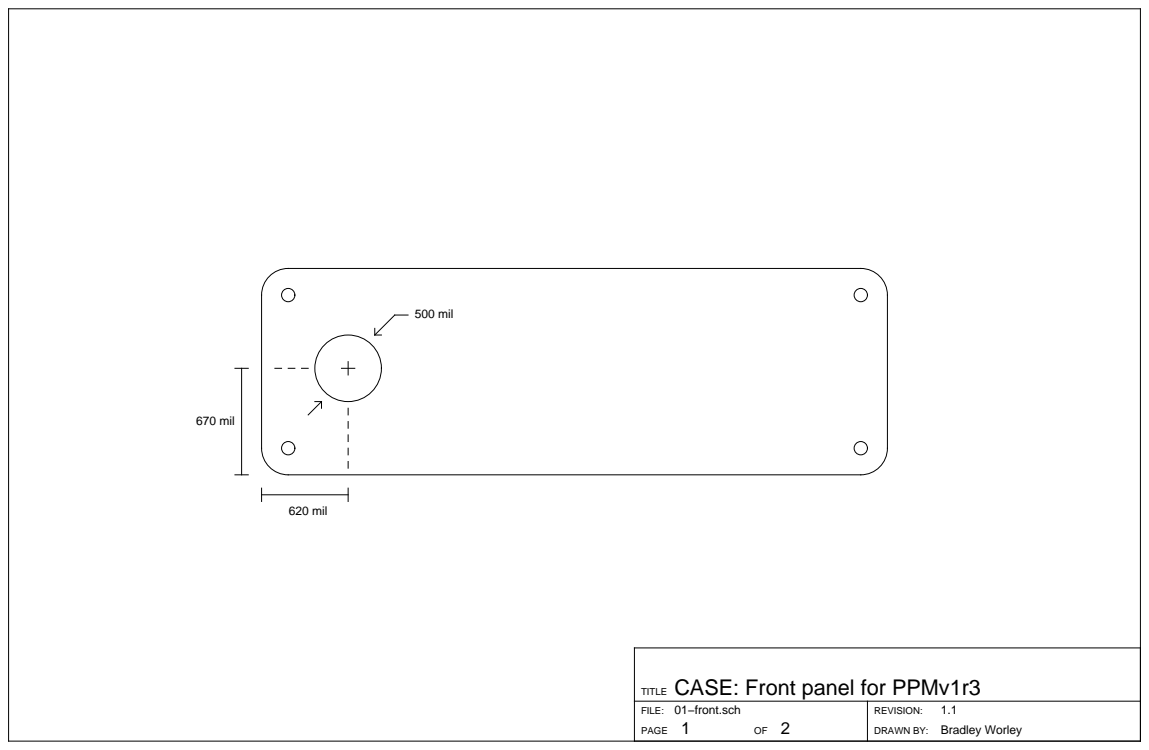
[picture p79: page 1]
PAGE; DRAWN BY:; Bradley Worley; 620 mil; 500 mil; 670 mil

TITLE CASE: Front panel for PPMv1r3

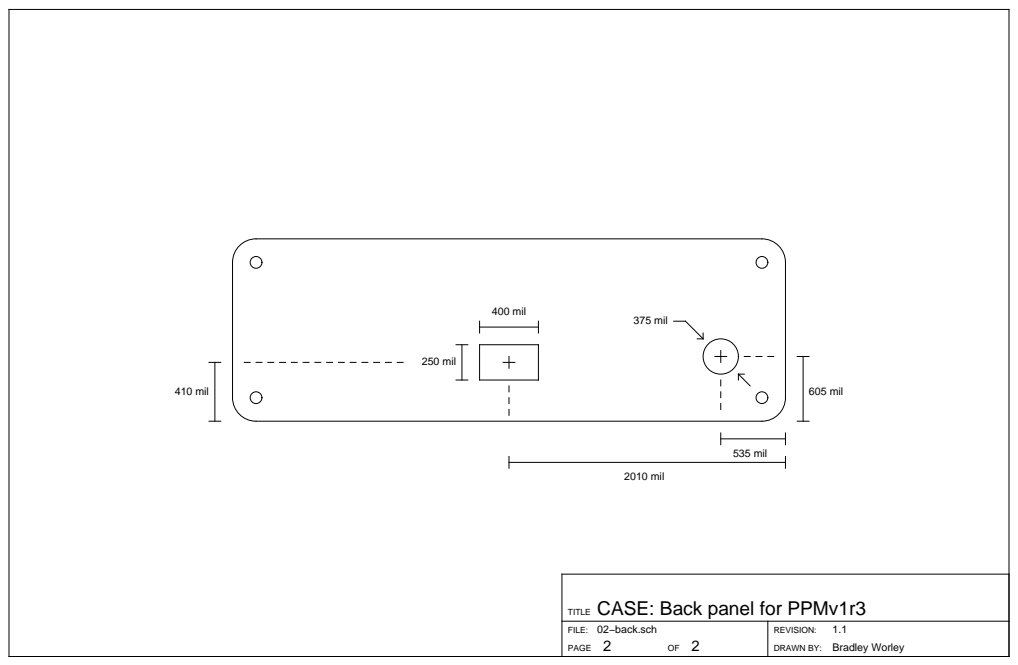
[picture p80: page 2]
PAGE; DRAWN BY:; Bradley Worley; 535 mil; 375 mil; 605 mil; 2010 mil; 410 mil; 250 mil; 400 mil

TITLE CASE: Back panel for PPMv1r3
