geekysuavo/pyppm/designs/case-scb-1.0/v1.pdf

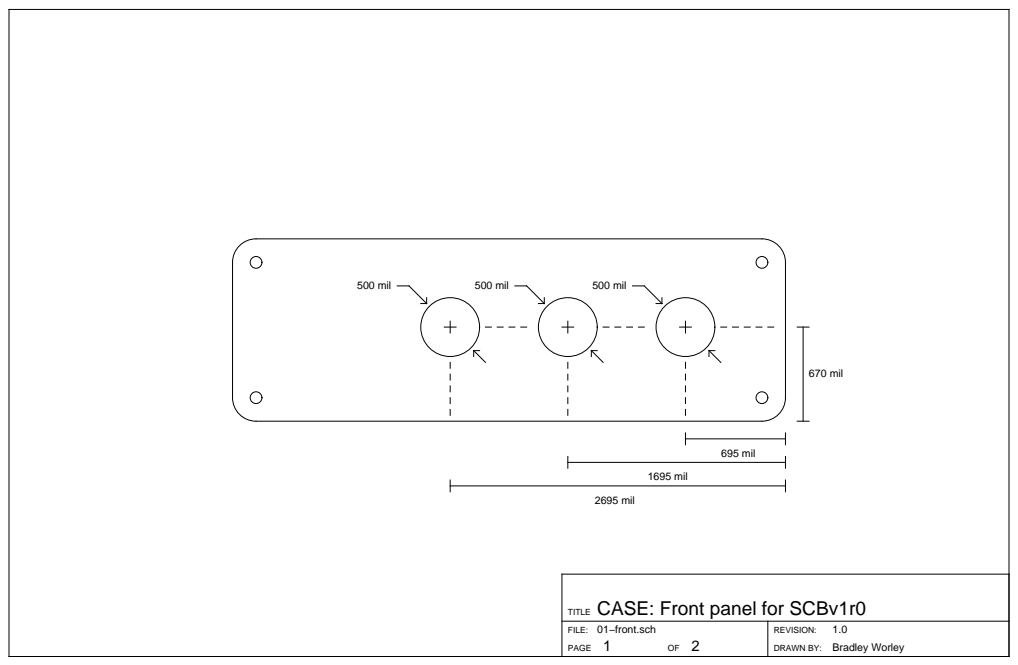
[picture p81: page 1]
PAGE; DRAWN BY:; Bradley Worley; 695 mil; 500 mil; 670 mil; 1695 mil; 2695 mil

TITLE CASE: Front panel for SCBv1r0

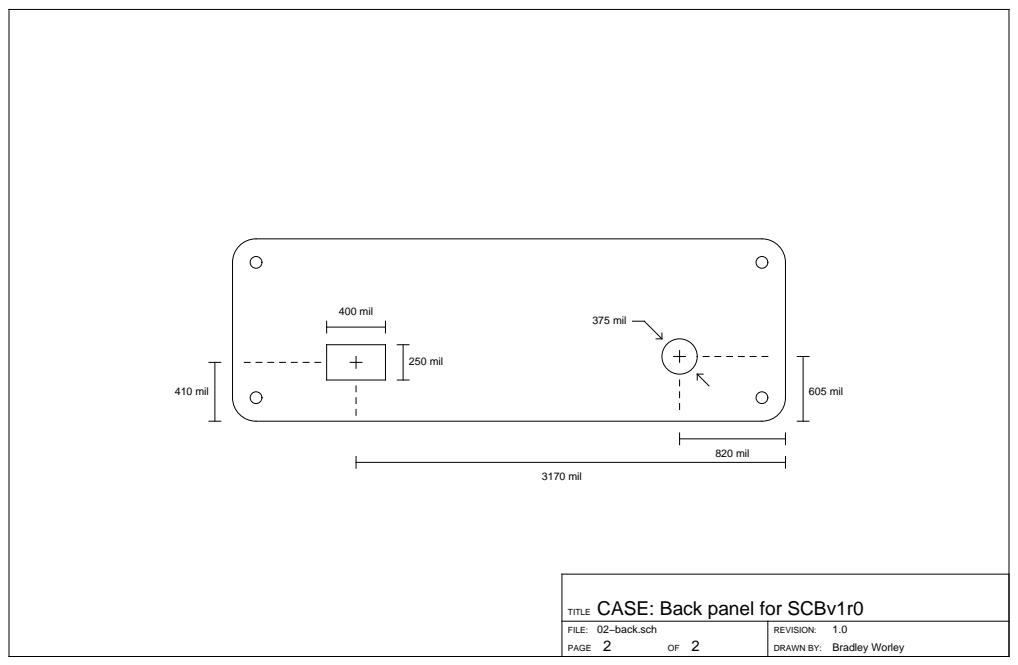
[picture p82: page 2]
PAGE; DRAWN BY:; Bradley Worley; 820 mil; 375 mil; 605 mil; 3170 mil; 410 mil; 250 mil; 400 mil

TITLE CASE: Back panel for SCBv1r0
