geekysuavo/pyppm/designs/coil-1.0/v1.pdf

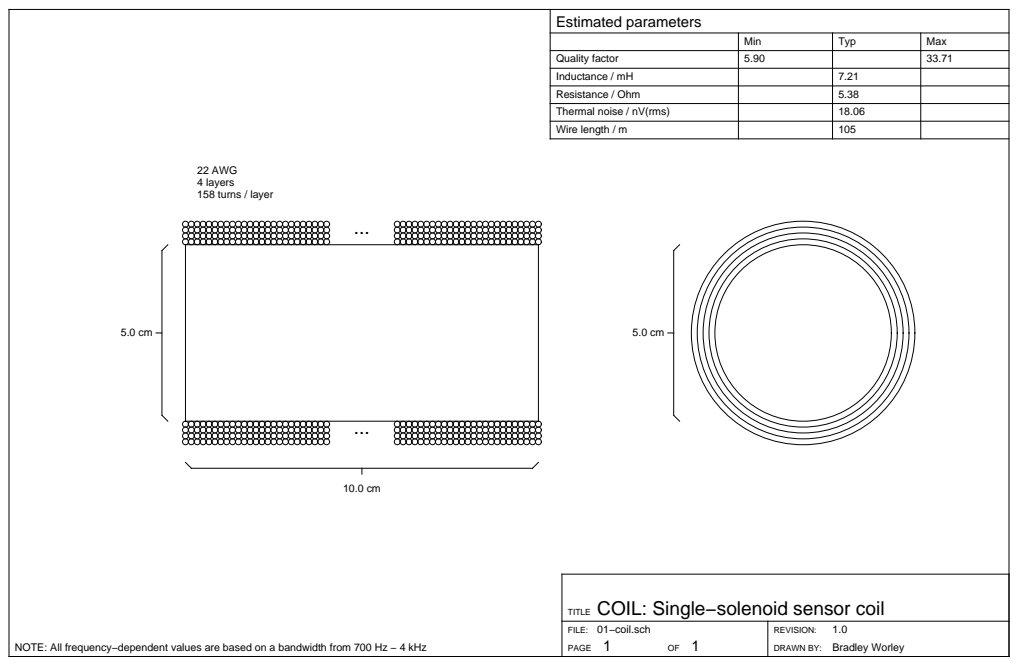
[picture p83: page 1]
PAGE; DRAWN BY:; Bradley Worley

22 AWG 4 layers 158 turns / layer ... | Estimated parameters

Min | Typ | Max

Quality factor | 5.90 | | 33.71
Inductance / mH | | 7.21
Resistance / Ohm | | 5.38
Thermal noise / nV(rms) | | 18.06
Wire length / m | | 105

TITLE COIL: Single−solenoid sensor coil

NOTE: All frequency−dependent values are based on a bandwidth from 700 Hz − 4 kHz
