geekysuavo/pyppm/designs/coil-2.0/v2.pdf

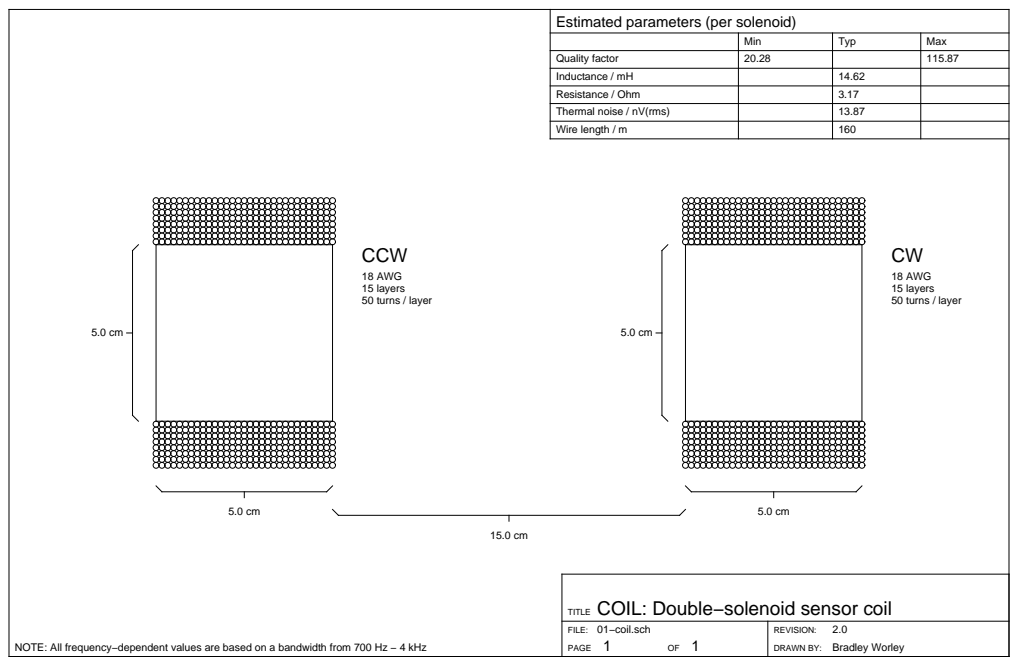
[picture p84: page 1]
PAGE; DRAWN BY:; Bradley Worley; 15 layers 50 turns / layer; 18 AWG

Estimated parameters (per solenoid)

Min | Typ | Max

Quality factor | 20.28 | | 115.87
Inductance / mH | | 14.62
Resistance / Ohm | | 3.17
Thermal noise / nV(rms) | | 13.87
Wire length / m | | 160

TITLE COIL: Double−solenoid sensor coil

NOTE: All frequency−dependent values are based on a bandwidth from 700 Hz − 4 kHz
