geekysuavo/pyppm/designs/dig-1.0/v1.pdf

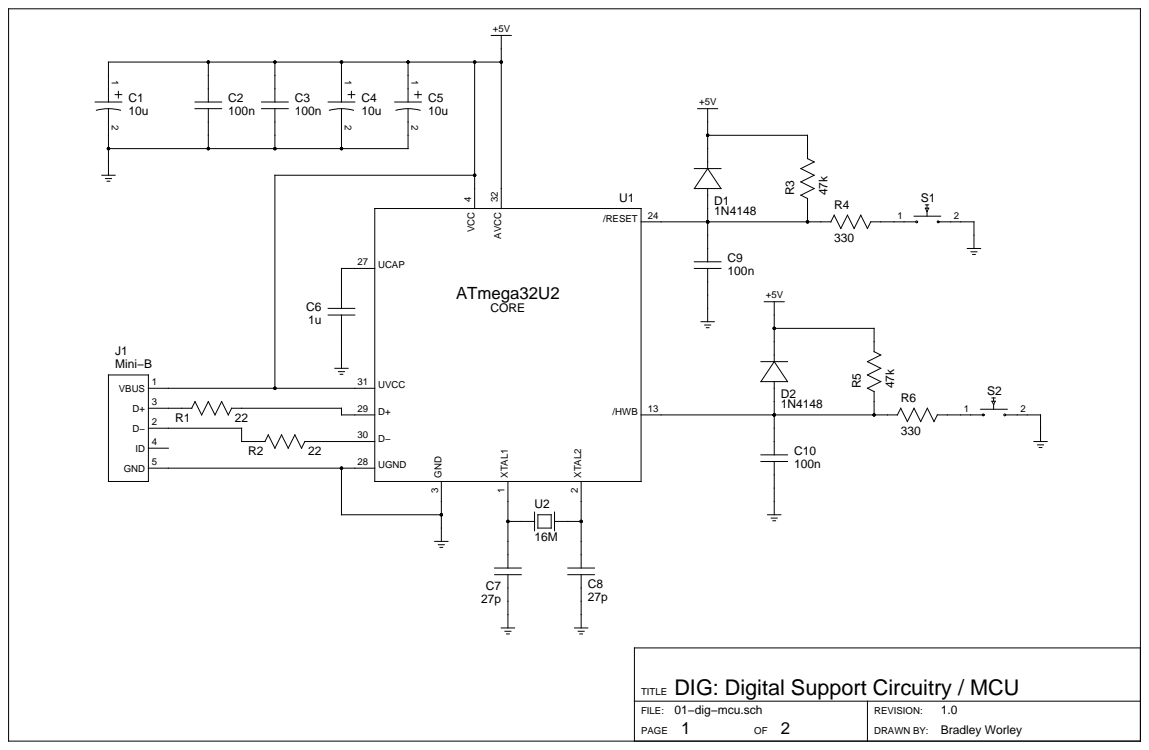
[picture p85: page 1]

TITLE DIG: Digital Support Circuitry / MCU

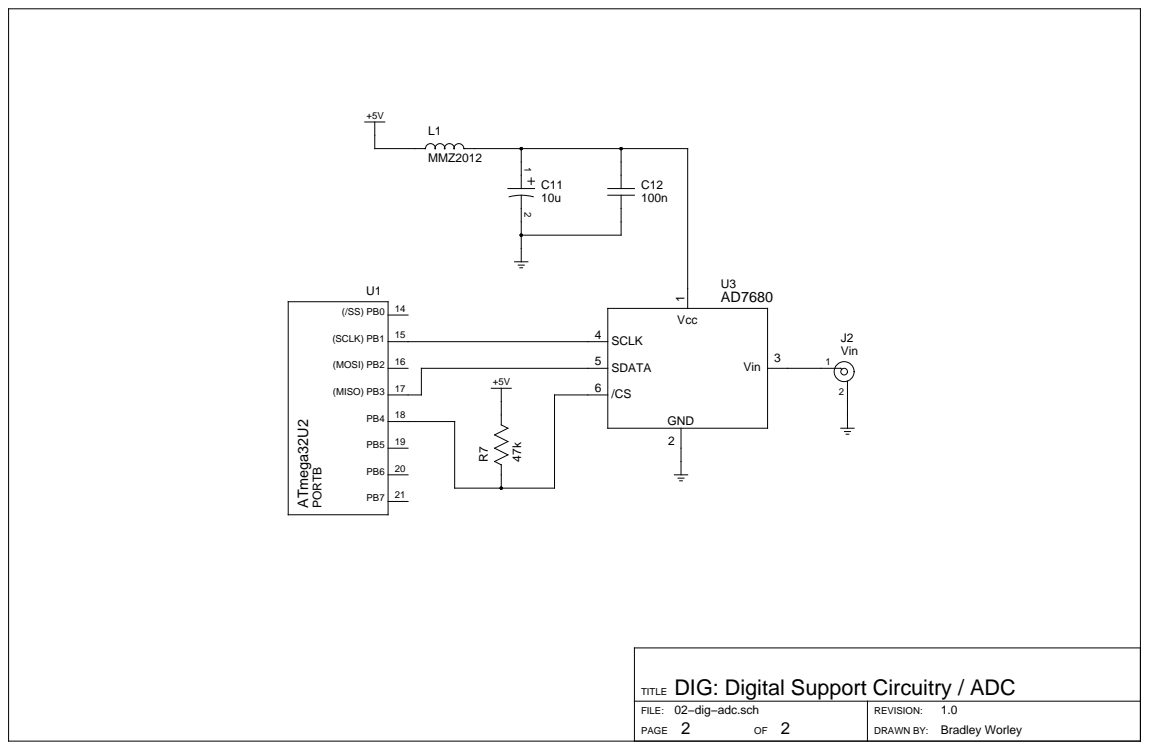
[picture p86: page 2]
PAGE; DRAWN BY:; Bradley Worley; 15 (SCLK) PB1; 16 (MOSI) PB2; 17 (MISO) PB3

TITLE DIG: Digital Support Circuitry / ADC

02−dig−adc.sch
