geekysuavo/pyppm/designs/ppm-1.0/v1-brd.pdf

# v1.pcb

# 1. Table of Contents (This Page) Created on Thu Mar 21 15:37:44 2013

# 2. component 3. solder 4. GND 5. power 6. plated-drill 7. componentmask 8. soldermask 9. topsilk 10. bottomsilk 11. toppaste 12. topassembly 13. bottomassembly 14. fab

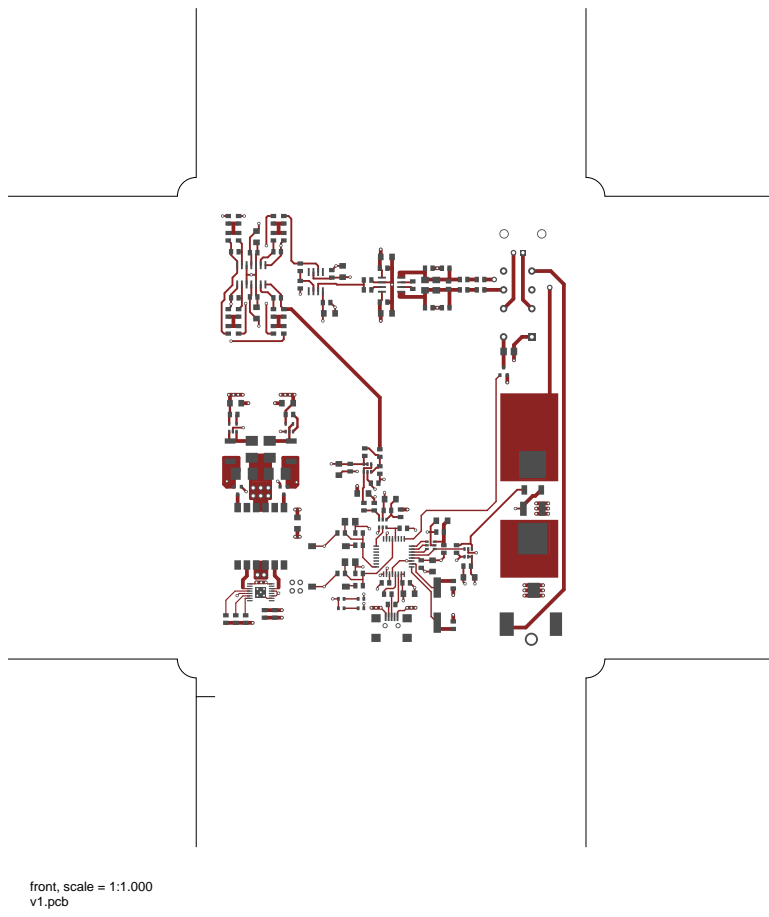
[picture p95: page 2]
front, scale = 1:1.000

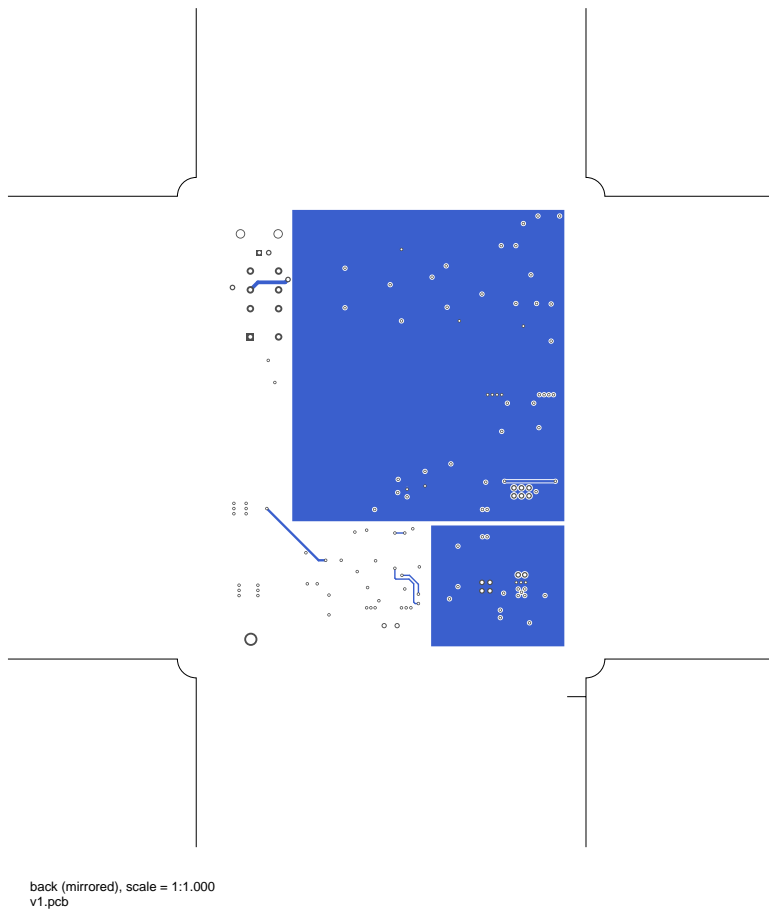
[picture p96: page 3]

back (mirrored), scale = 1:1.000

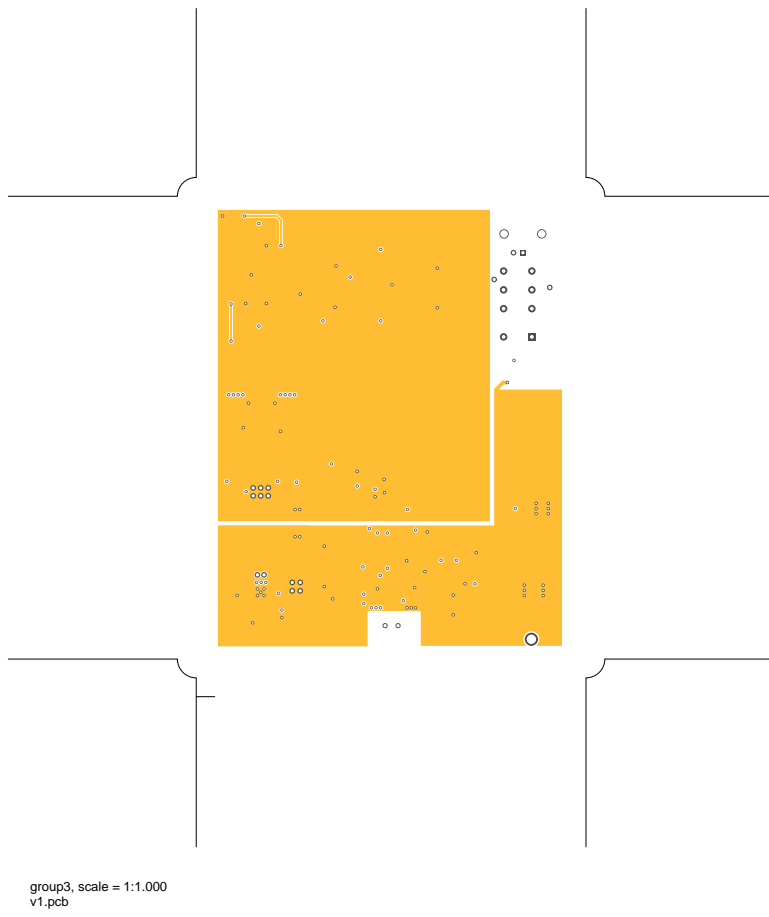
[picture p97: page 4]
group3, scale = 1:1.000

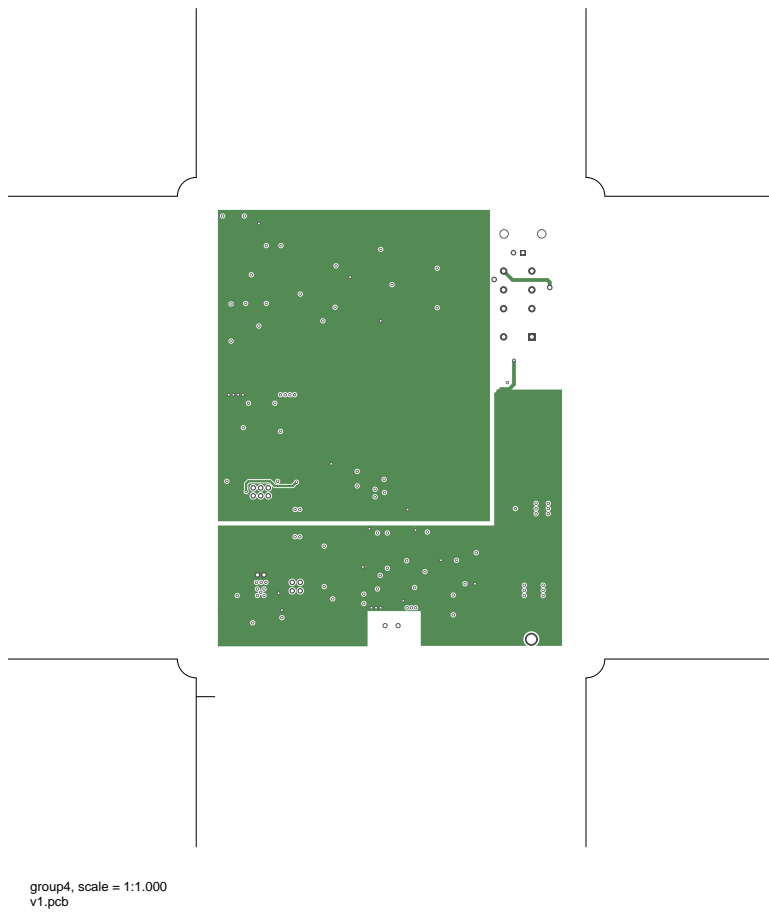
[picture p98: page 5]
group4, scale = 1:1.000

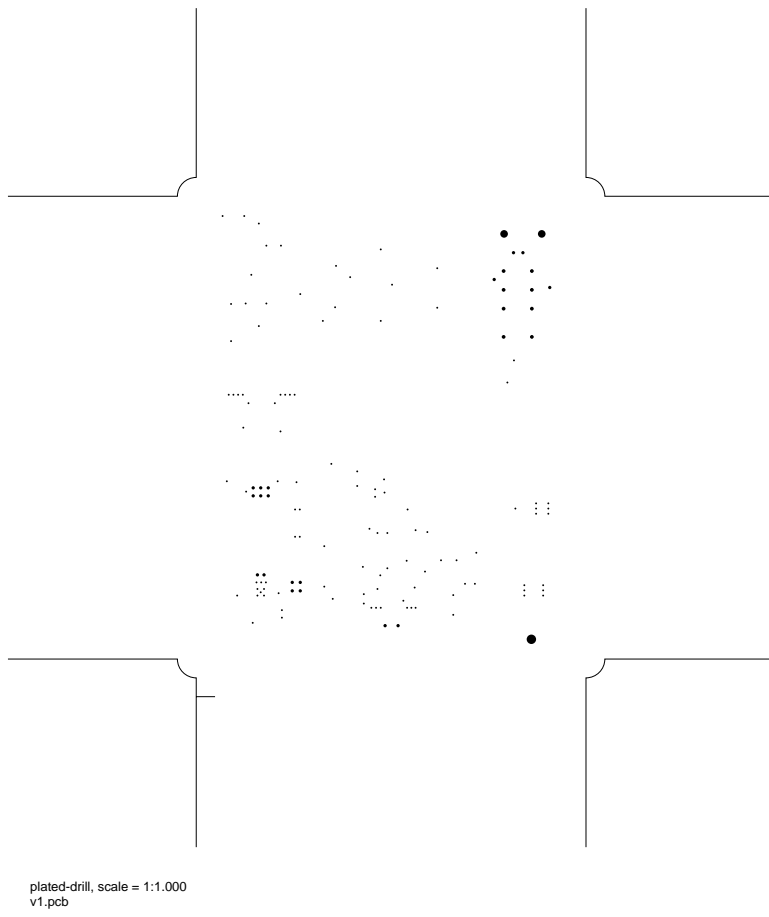
[picture p99: page 6]

plated-drill, scale = 1:1.000

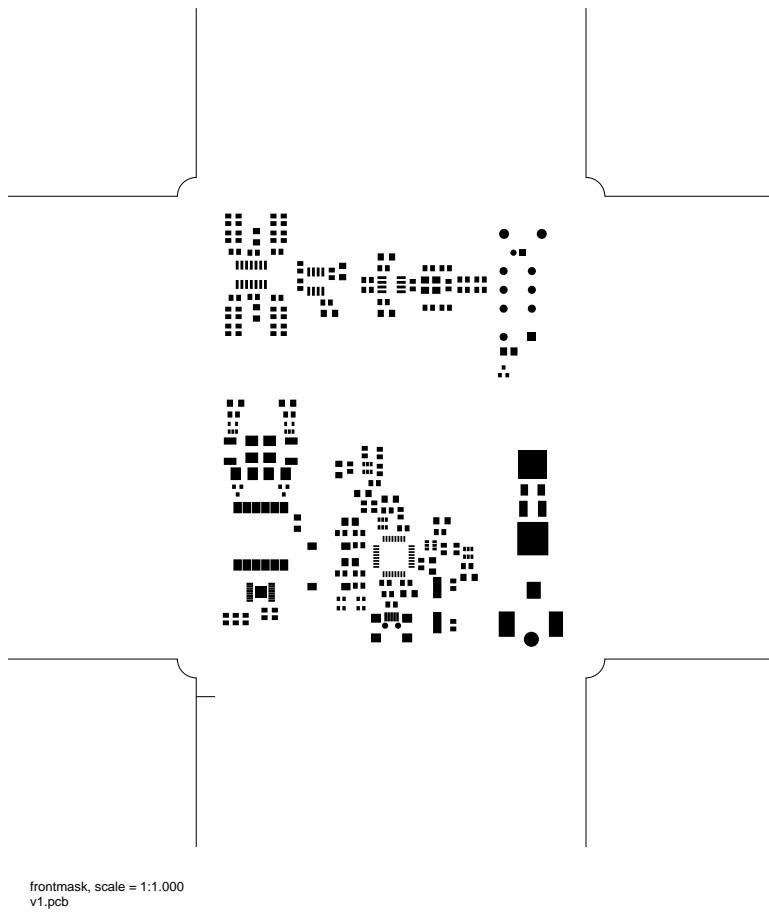
[picture p100: page 7]
frontmask, scale = 1:1.000

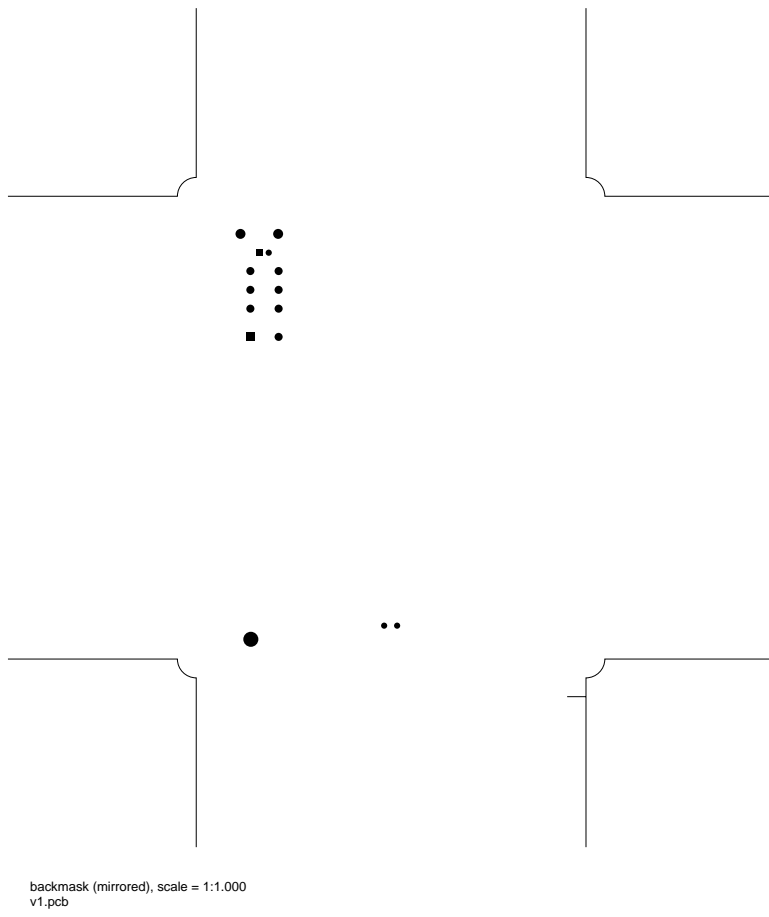
[picture p101: page 8]

backmask (mirrored), scale = 1:1.000

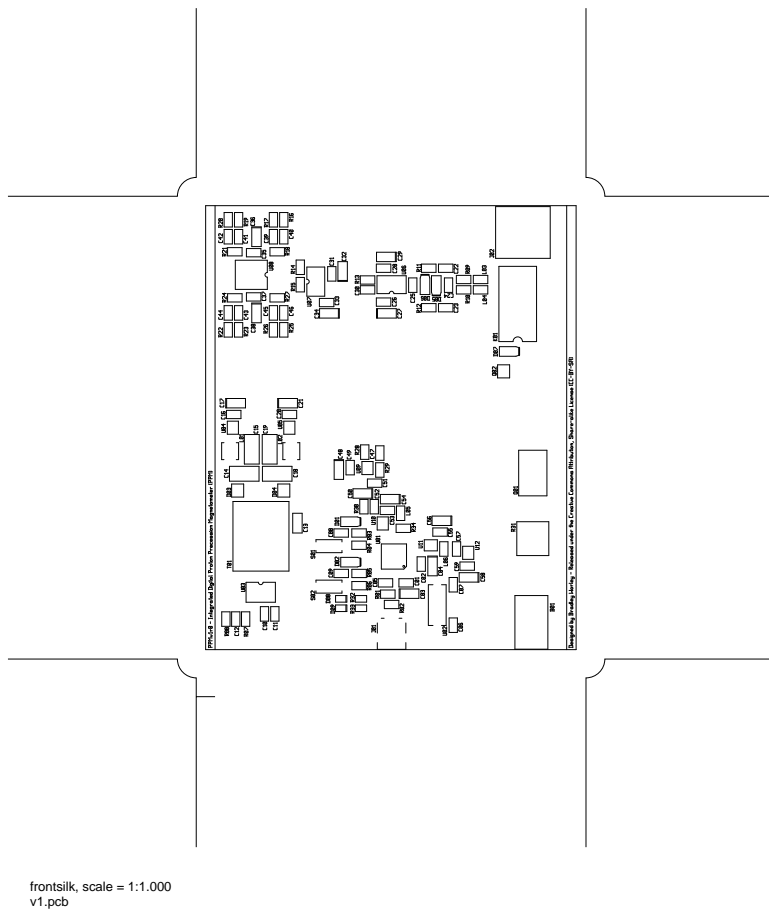
[picture p102: page 9]
frontsilk, scale = 1:1.000

backsilk (mirrored), scale = 1:1.000 frontpaste, scale = 1:1.000

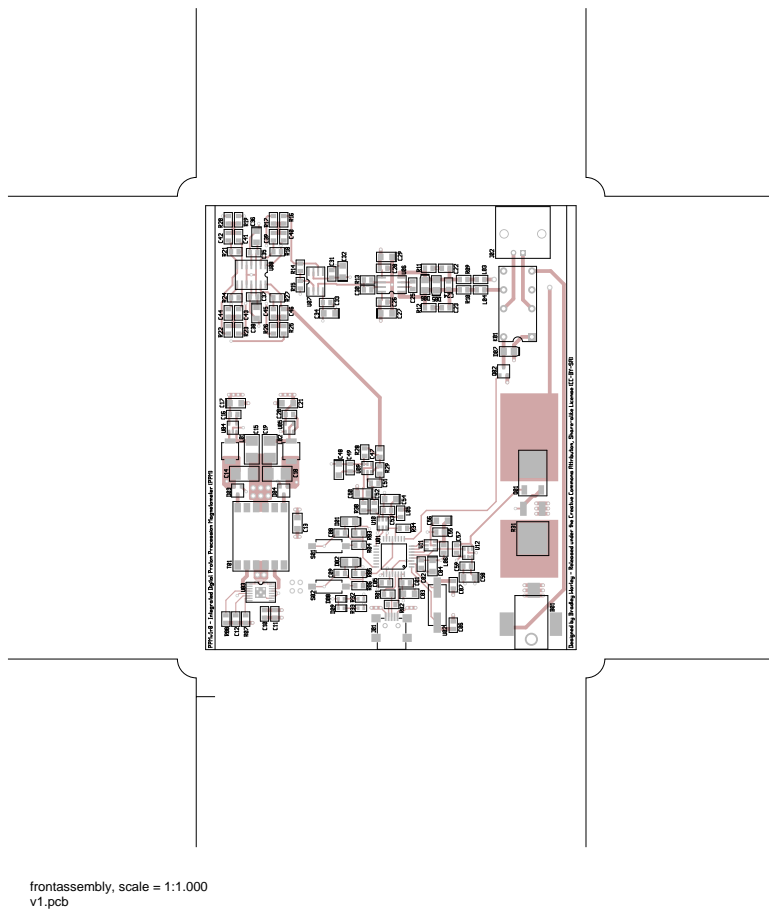
[picture p103: page 12]
frontassembly, scale = 1:1.000

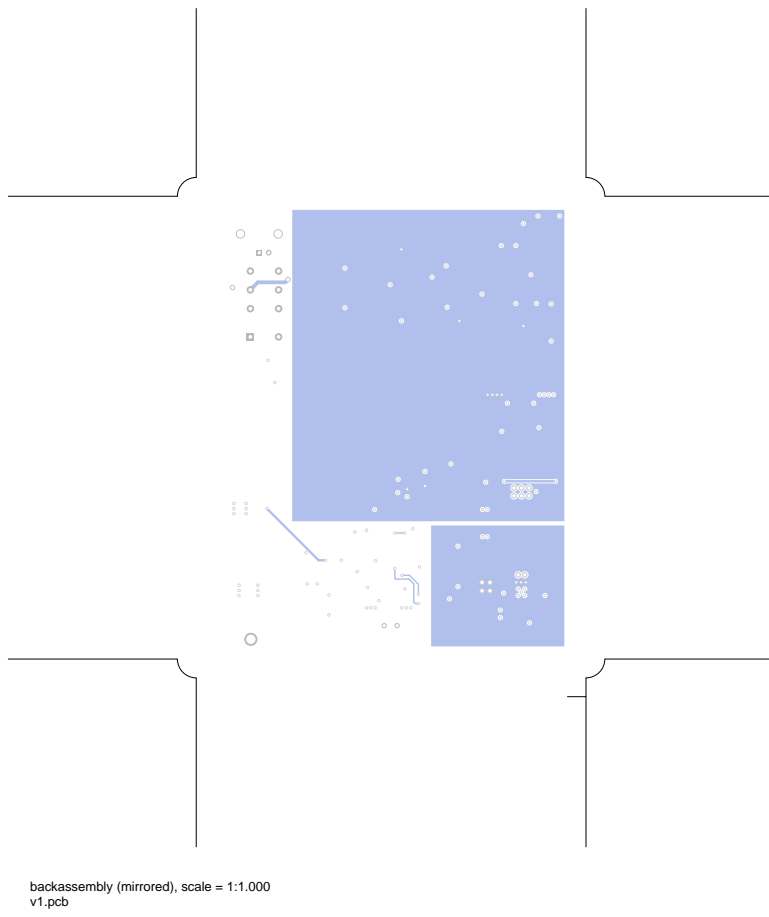
[picture p104: page 13]

backassembly (mirrored), scale = 1:1.000

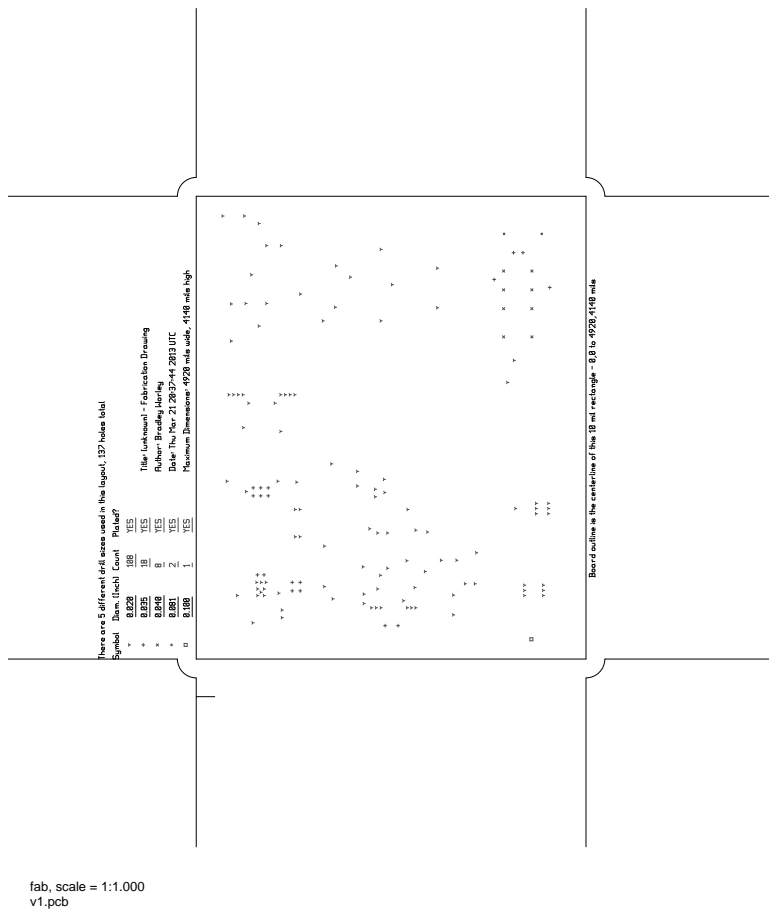
[picture p105: page 14]
fab, scale = 1:1.000
