geekysuavo/pyppm/designs/ppm-1.1/v1-brd.pdf

# v1.pcb

# 1. Table of Contents (This Page) Created on Fri Mar 22 13:24:02 2013

# 2. component 3. solder 4. GND 5. power 6. plated-drill 7. componentmask 8. soldermask 9. topsilk 10. bottomsilk 11. toppaste 12. topassembly 13. bottomassembly 14. fab

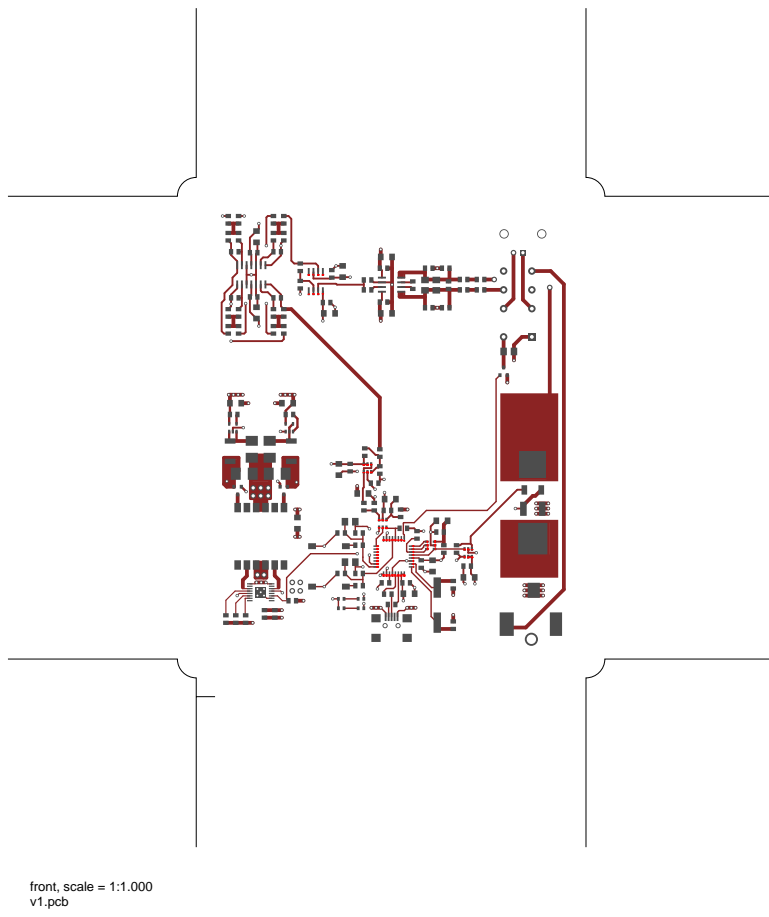
[picture p121: page 2]
front, scale = 1:1.000

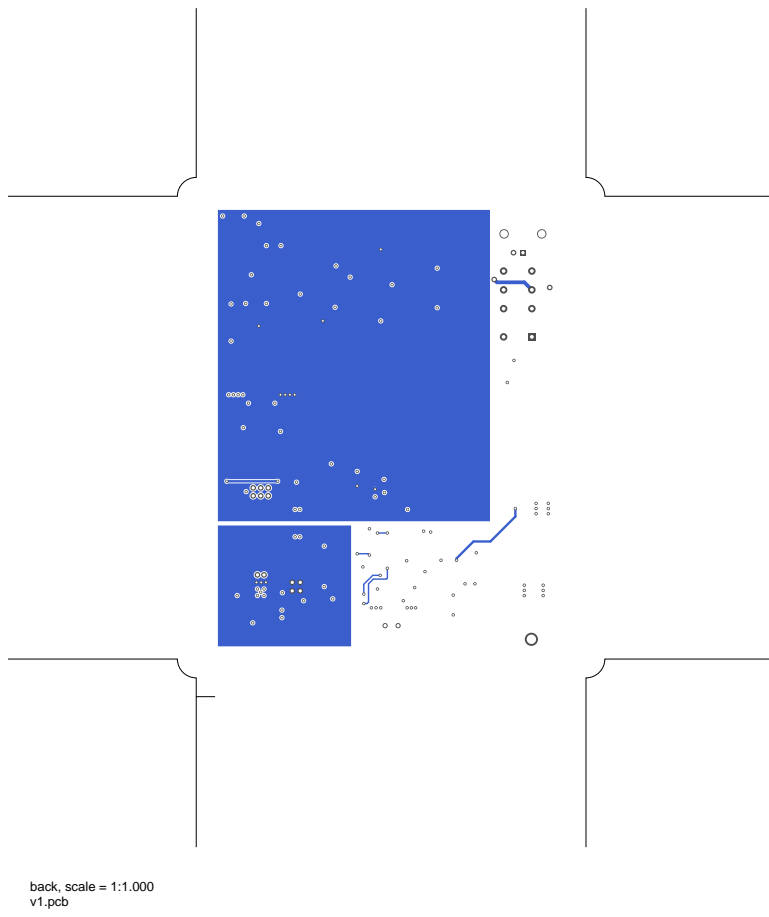
[picture p122: page 3]
back, scale = 1:1.000

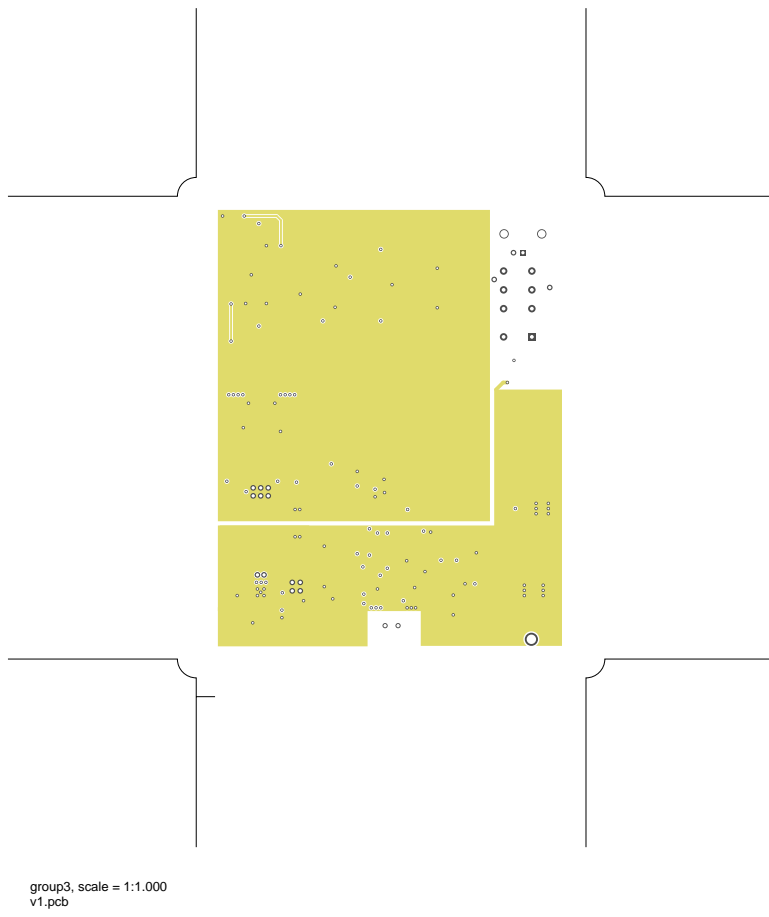
[picture p123: page 4]
group3, scale = 1:1.000

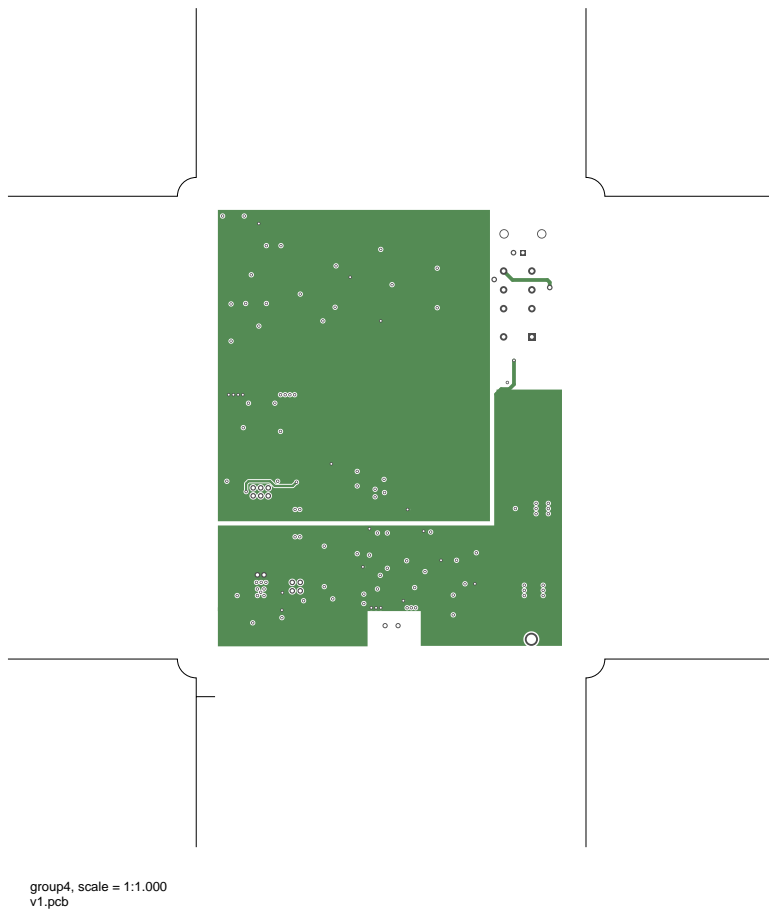
[picture p124: page 5]
group4, scale = 1:1.000

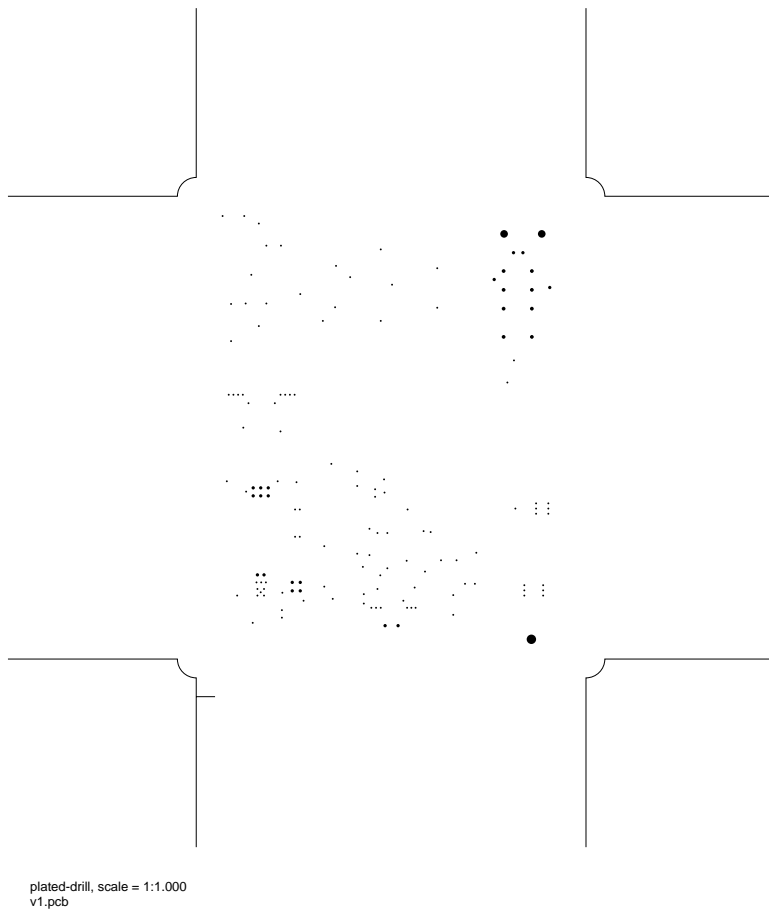
[picture p125: page 6]

plated-drill, scale = 1:1.000

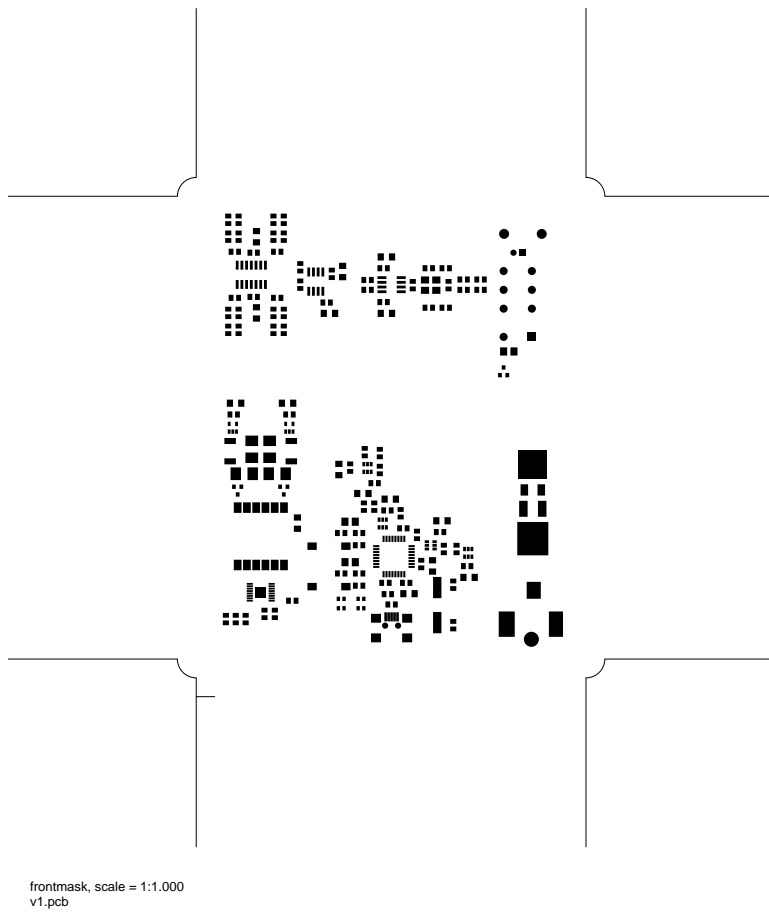
[picture p126: page 7]
frontmask, scale = 1:1.000

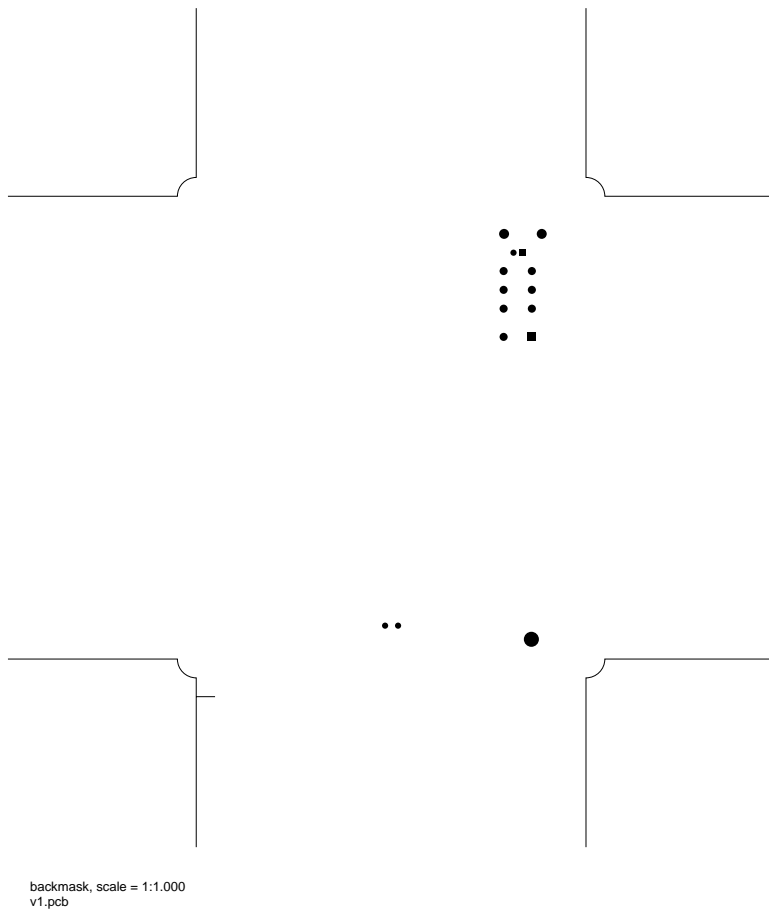
[picture p127: page 8]
backmask, scale = 1:1.000

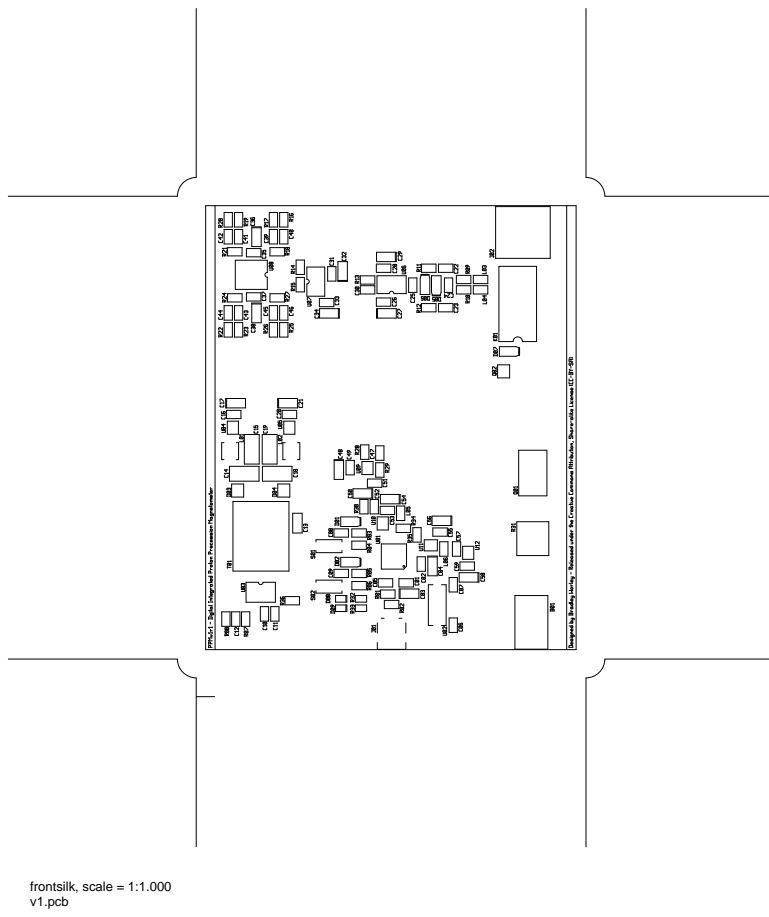
[picture p128: page 9]
frontsilk, scale = 1:1.000

backsilk, scale = 1:1.000 frontpaste, scale = 1:1.000

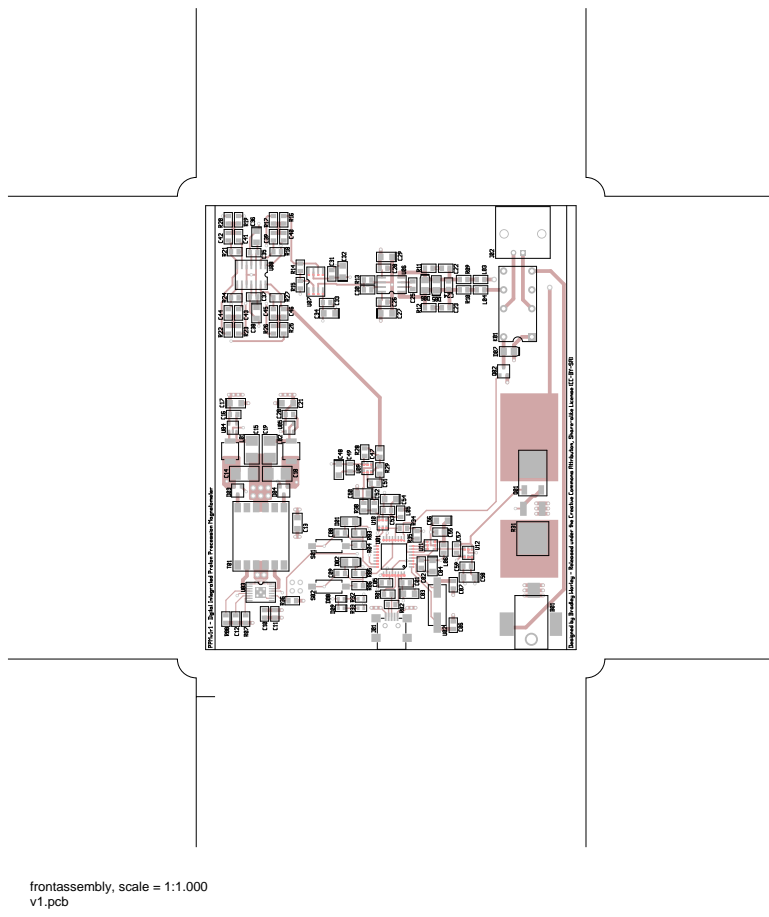
[picture p129: page 12]
frontassembly, scale = 1:1.000

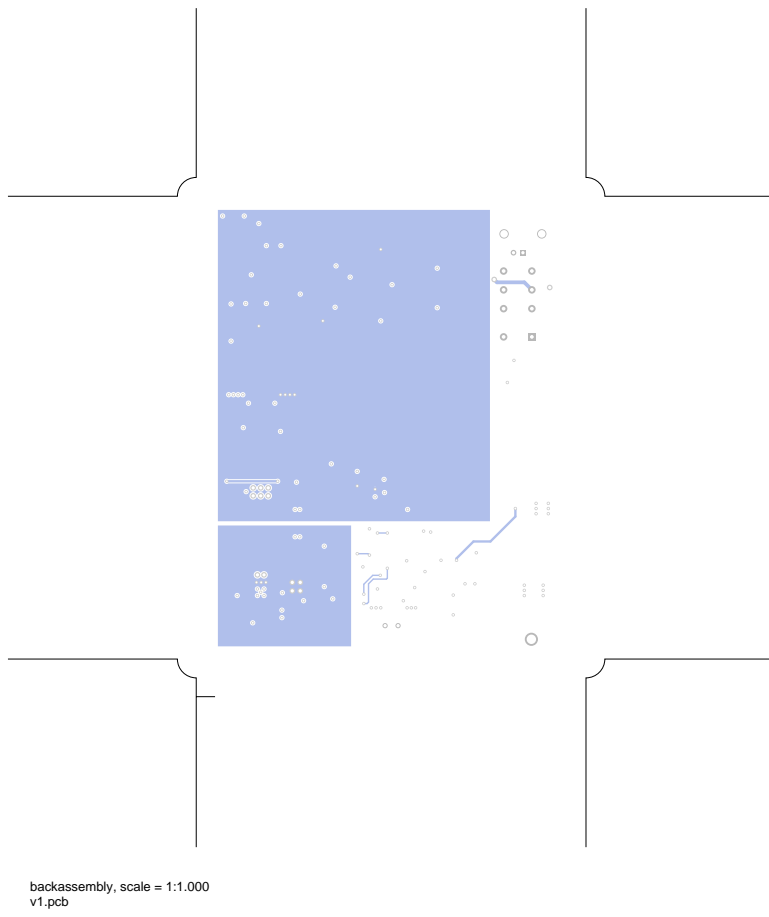
[picture p130: page 13]
backassembly, scale = 1:1.000

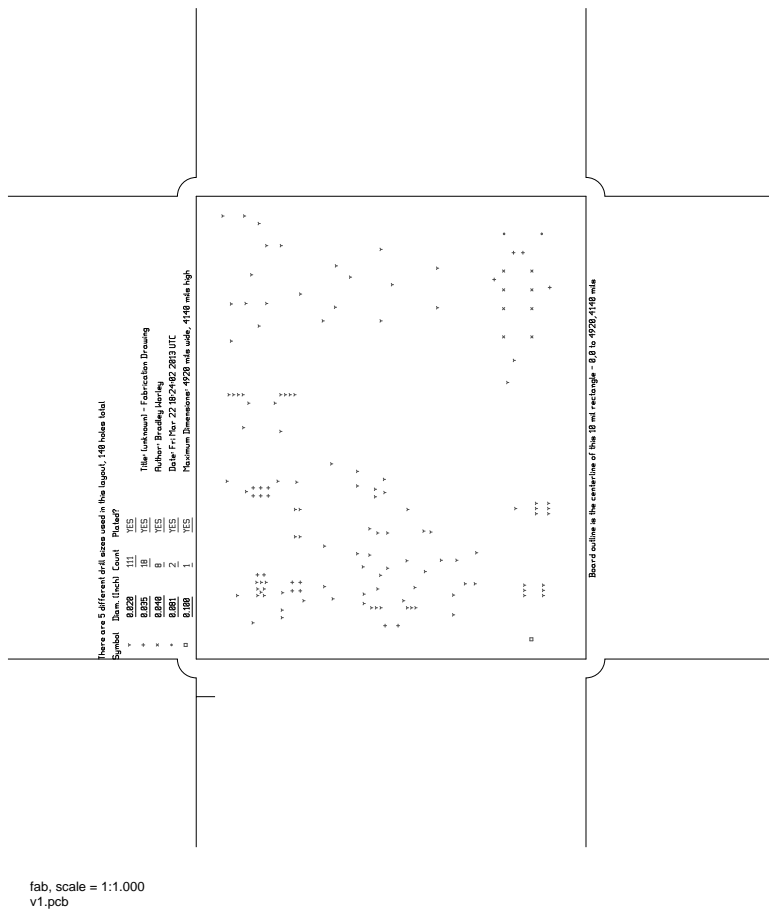
[picture p131: page 14]
fab, scale = 1:1.000
