geekysuavo/pyppm/designs/ppm-1.1/v1.pdf

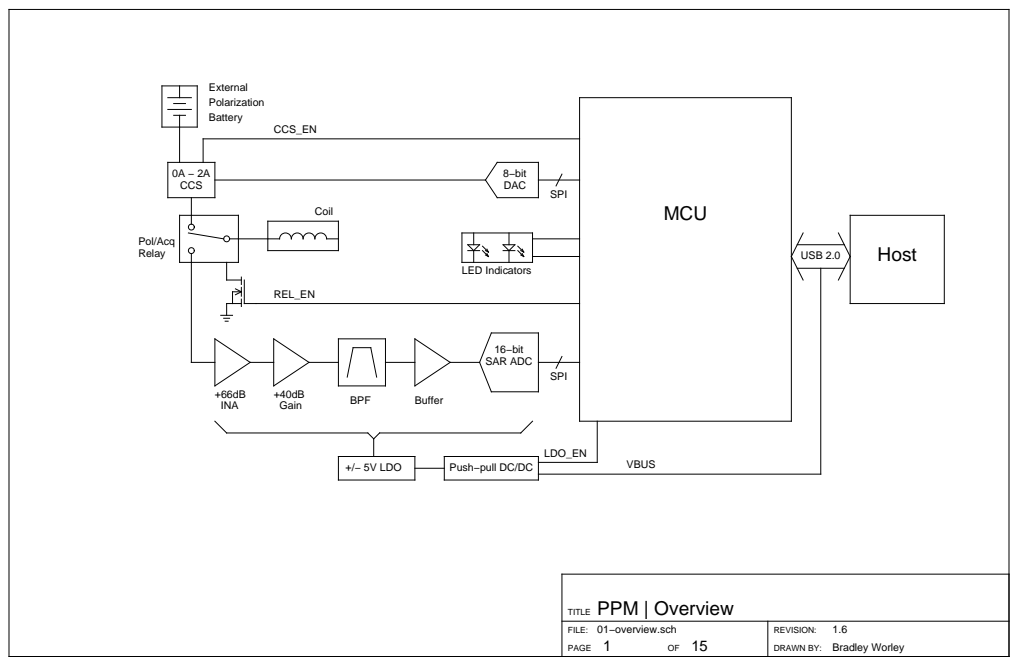
[picture p132: page 1]
PAGE; DRAWN BY:; Bradley Worley; SAR ADC; USB 2.0; +/− 5V LDO; LED Indicators

Push−pull DC/DC

TITLE PPM | Overview

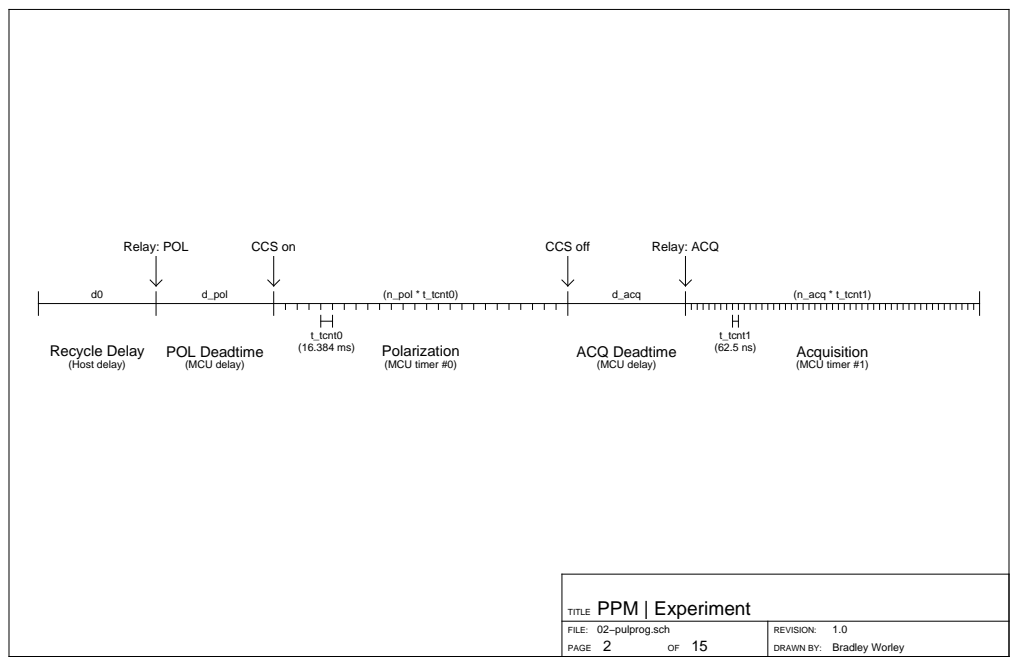
[picture p133: page 2]
PAGE; DRAWN BY:; Bradley Worley; Recycle Delay (Host delay); POL Deadtime; Relay: POL; CCS on; CCS off; Relay: ACQ; (MCU delay); ACQ Deadtime (MCU delay); (MCU timer #0); (MCU timer #1); d_pol; (n_pol * t_tcnt0); d_acq; (n_acq * t_tcnt1)

TITLE PPM | Experiment

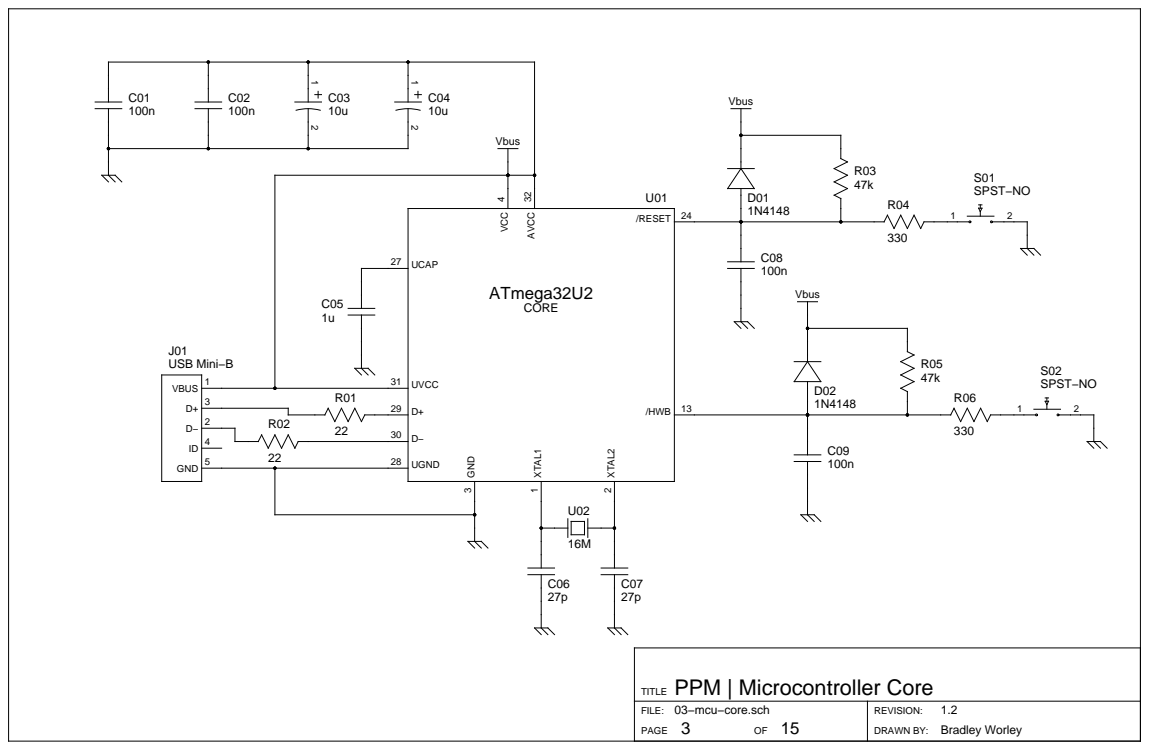
[picture p134: page 3]

TITLE PPM | Microcontroller Core

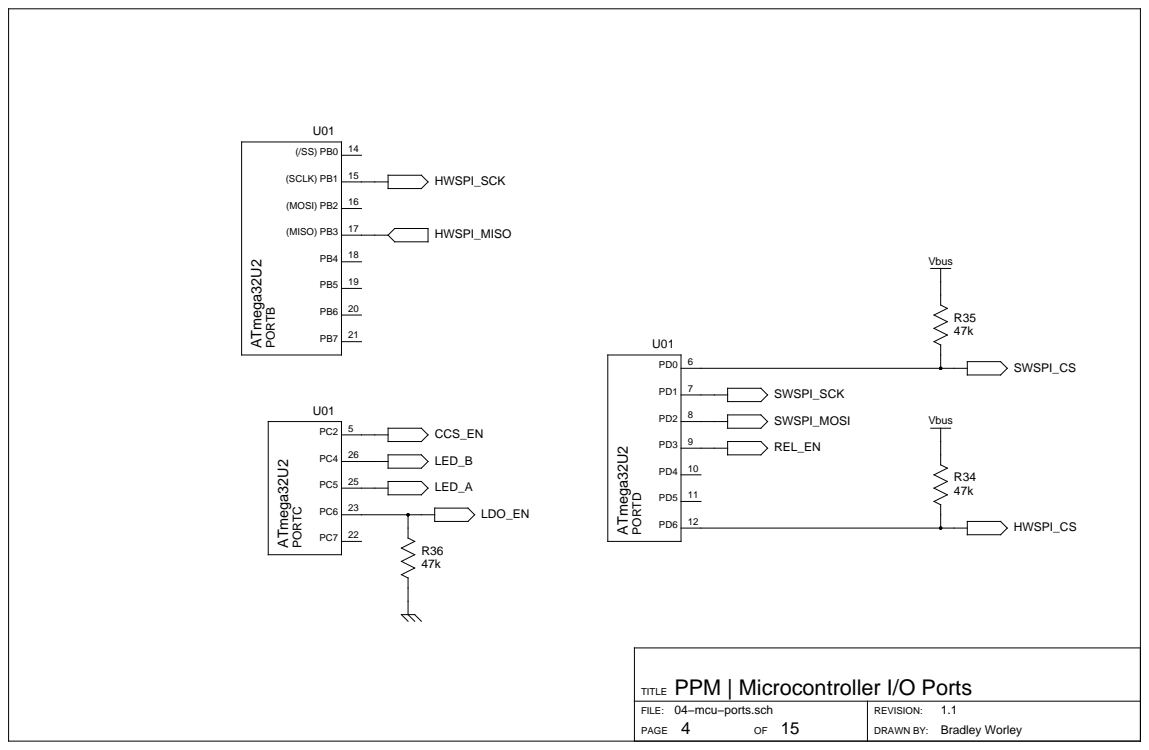
[picture p135: page 4]
PAGE; DRAWN BY:; Bradley Worley; 15 (SCLK) PB1; 16 (MOSI) PB2; 17 (MISO) PB3

TITLE PPM | Microcontroller I/O Ports

04−mcu−ports.sch

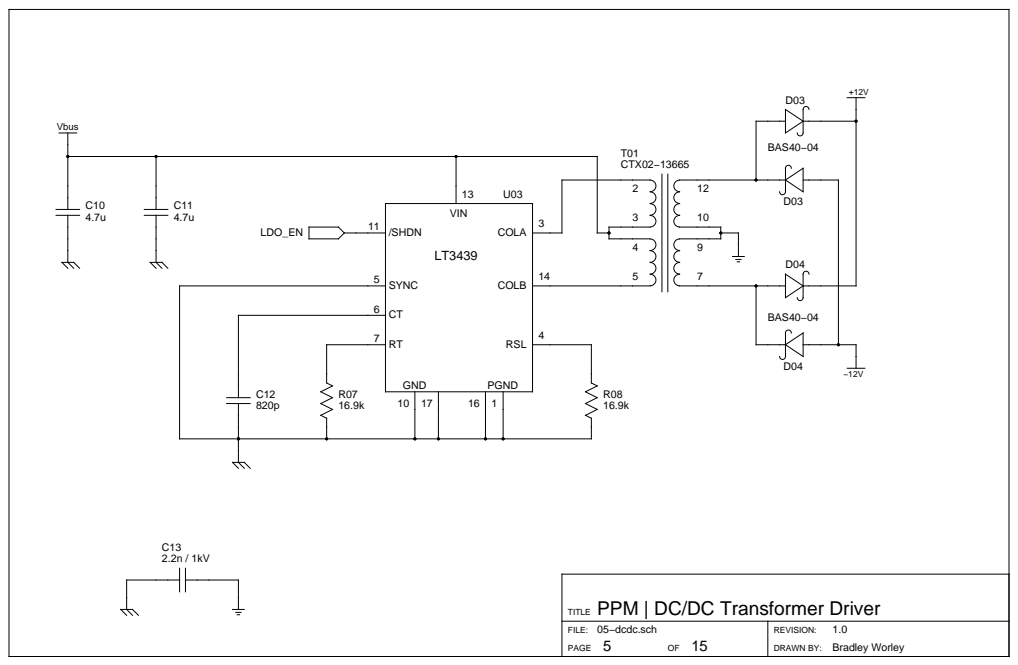
[picture p136: page 5]

TITLE PPM | DC/DC Transformer Driver

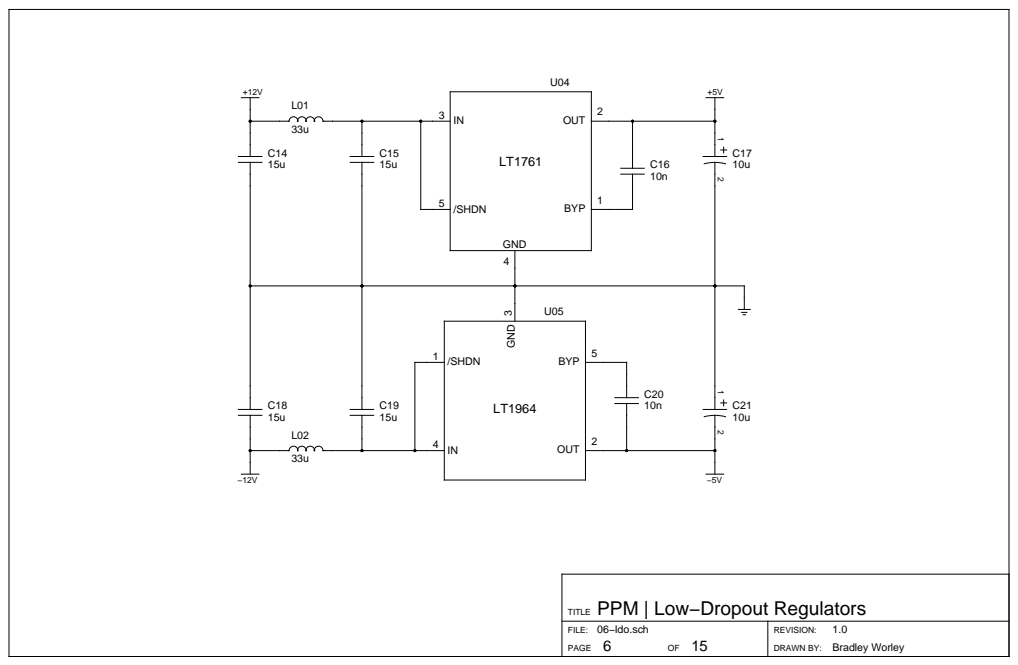
[picture p137: page 6]

TITLE PPM | Low−Dropout Regulators

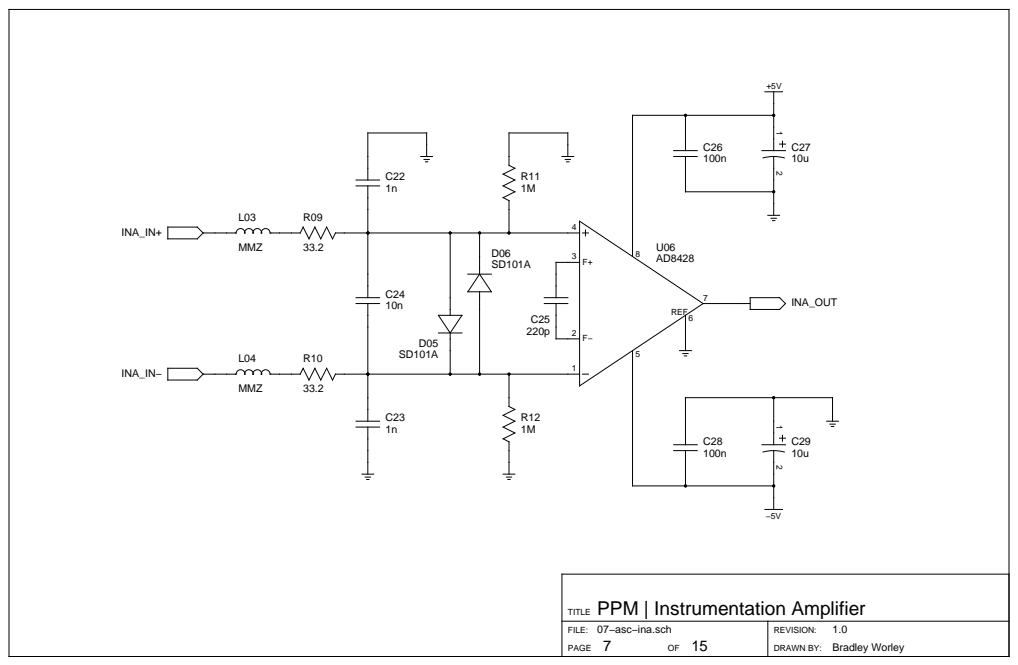
[picture p138: page 7]

TITLE PPM | Instrumentation Amplifier

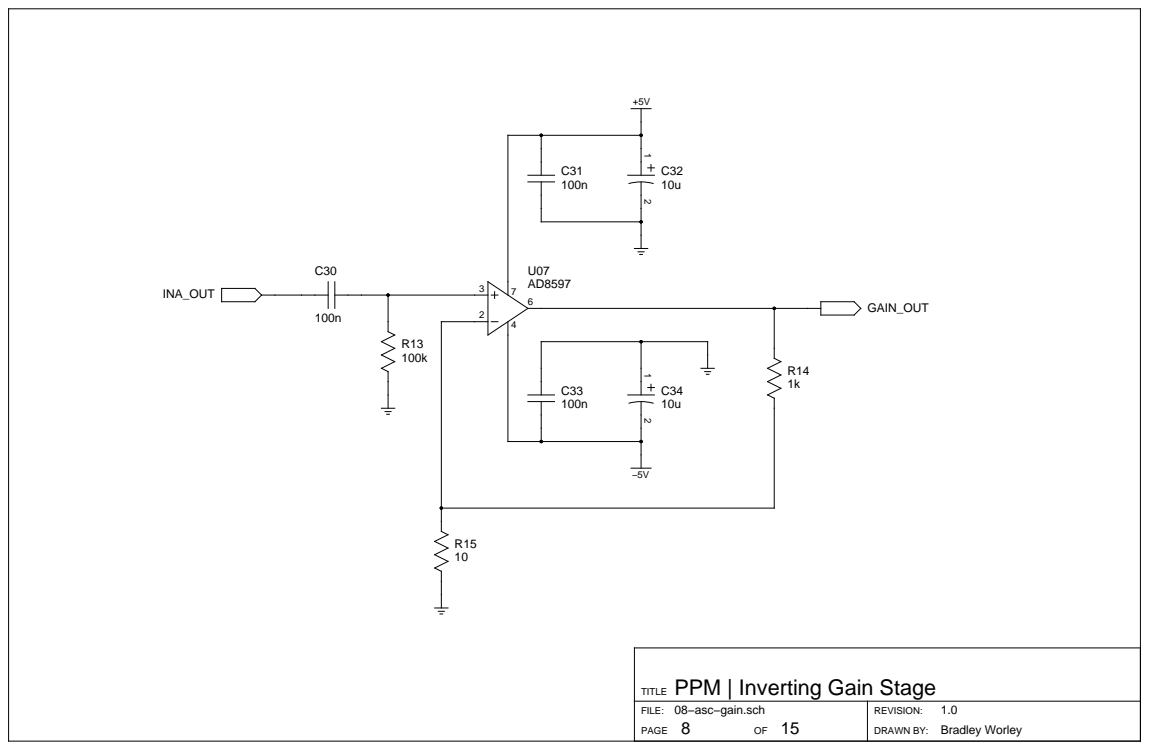
[picture p139: page 8]

TITLE PPM | Inverting Gain Stage

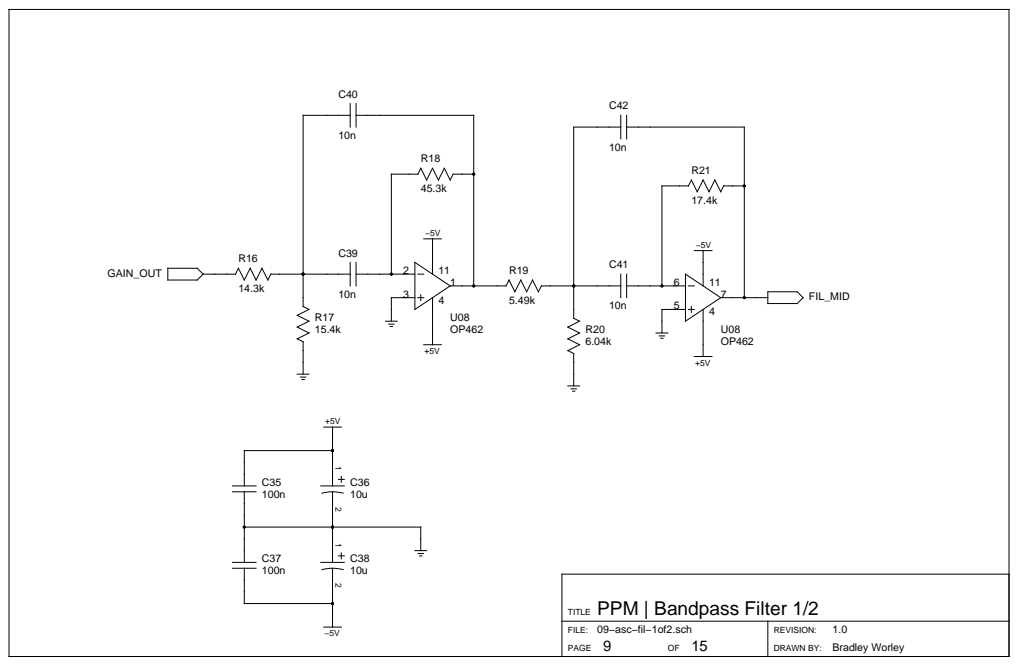
[picture p140: page 9]

TITLE PPM | Bandpass Filter 1/2

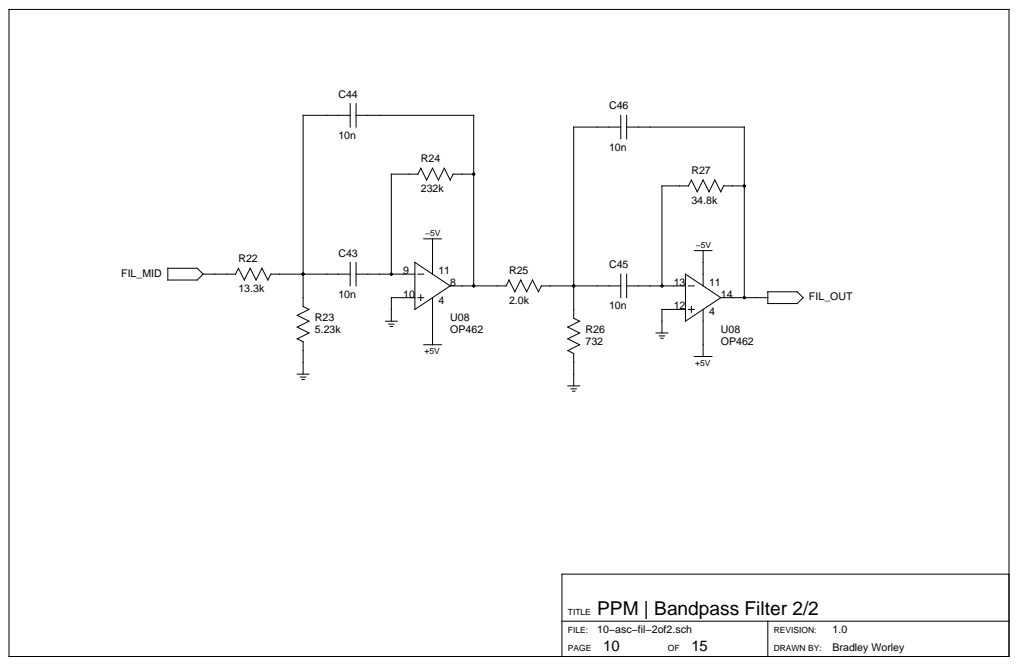
[picture p141: page 10]

TITLE PPM | Bandpass Filter 2/2

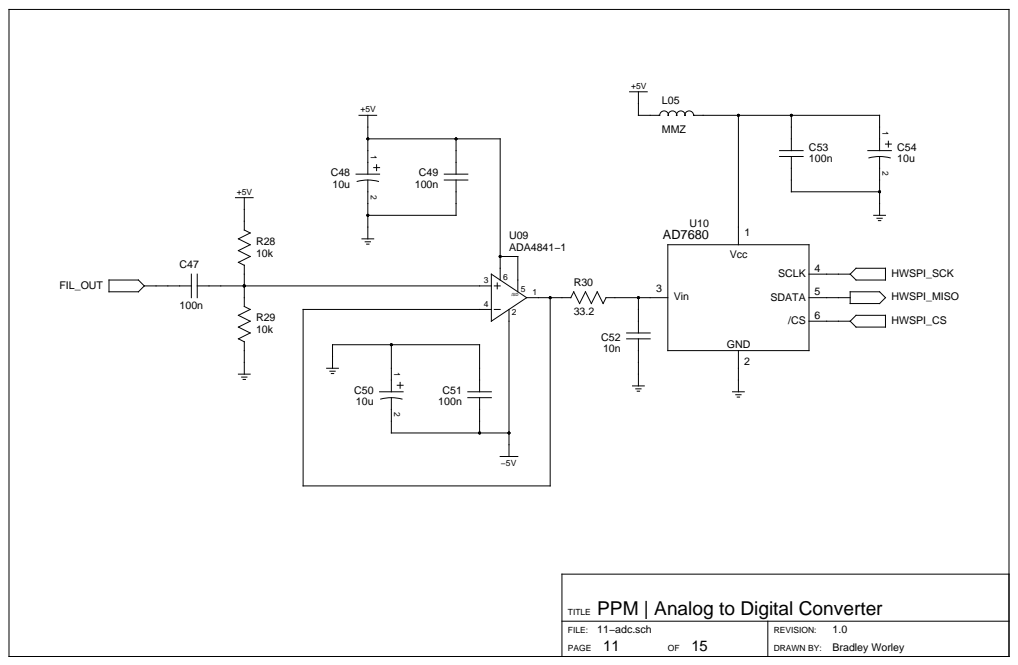
[picture p142: page 11]

TITLE PPM | Analog to Digital Converter

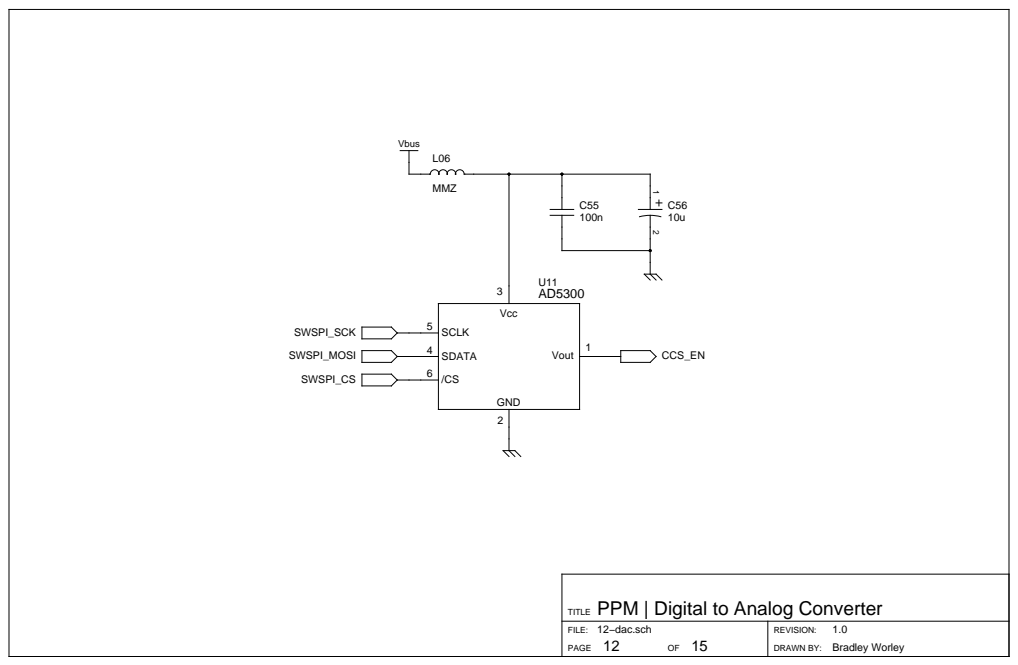
[picture p143: page 12]
PAGE; DRAWN BY:; Bradley Worley

TITLE PPM | Digital to Analog Converter

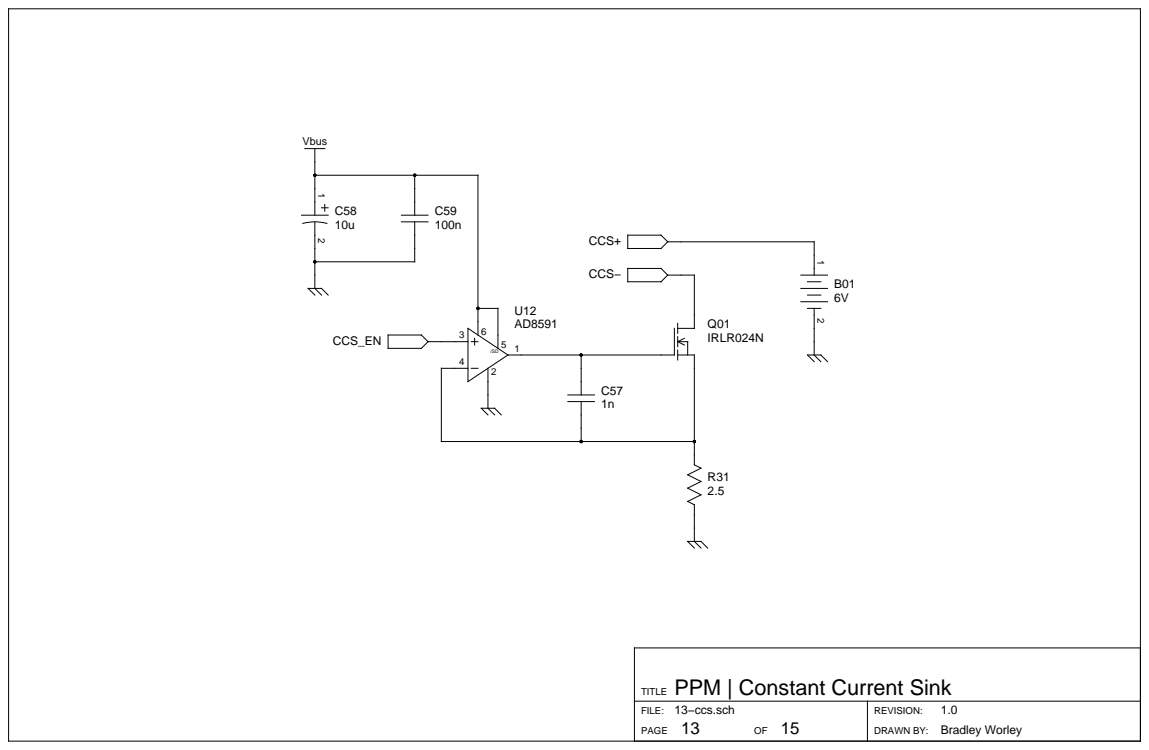
[picture p144: page 13]
PAGE; DRAWN BY:; Bradley Worley

TITLE PPM | Constant Current Sink

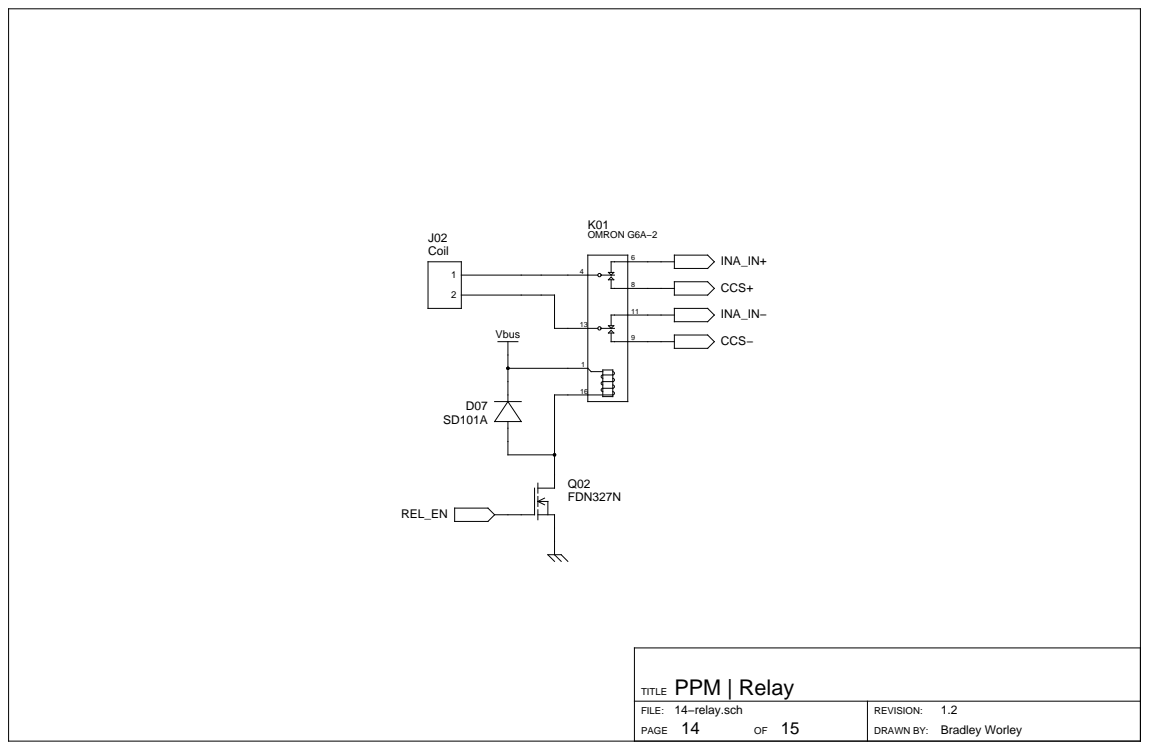
[picture p145: page 14]
PAGE; DRAWN BY:; Bradley Worley; OMRON G6A−2

TITLE PPM | Relay

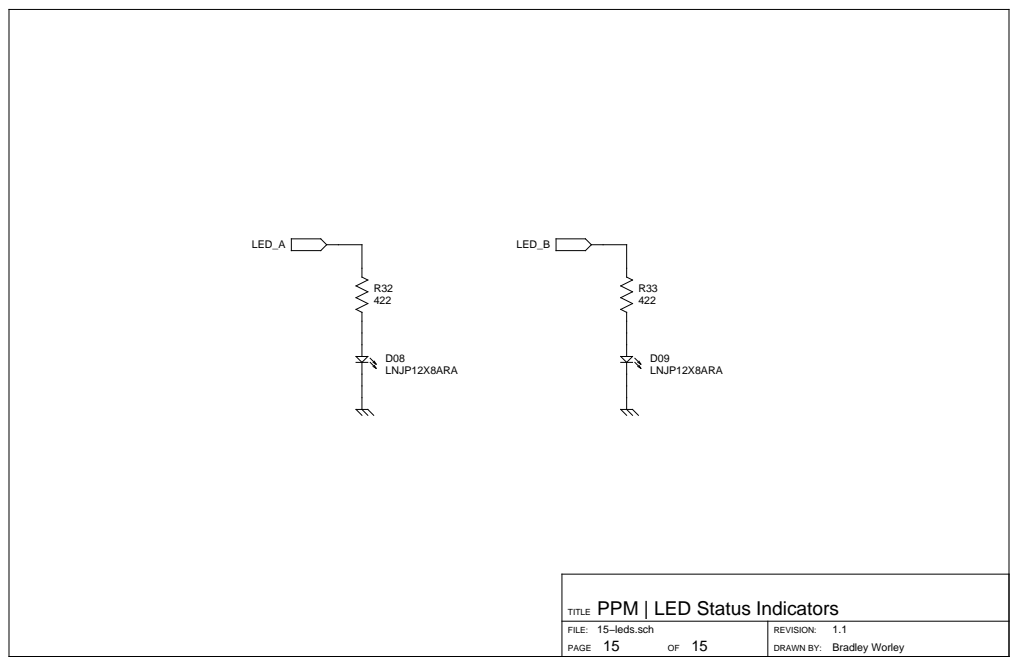
[picture p146: page 15]
PAGE; DRAWN BY:; Bradley Worley

TITLE PPM | LED Status Indicators
