geekysuavo/pyppm/designs/ppm-1.2/v1-brd.pdf

# v1.pcb

# 1. Table of Contents (This Page) Created on Thu May 2 21:35:19 2013

# 2. component 3. solder 4. GND 5. power 6. plated-drill 7. componentmask 8. soldermask 9. topsilk 10. bottomsilk 11. toppaste 12. topassembly 13. bottomassembly 14. fab

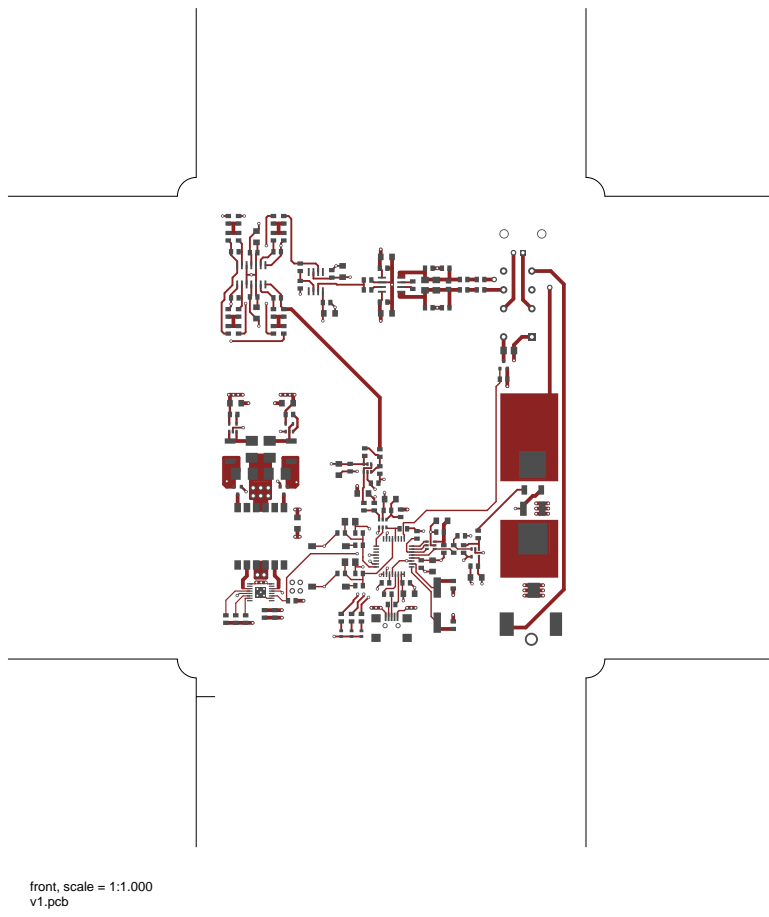
[picture p147: page 2]
front, scale = 1:1.000

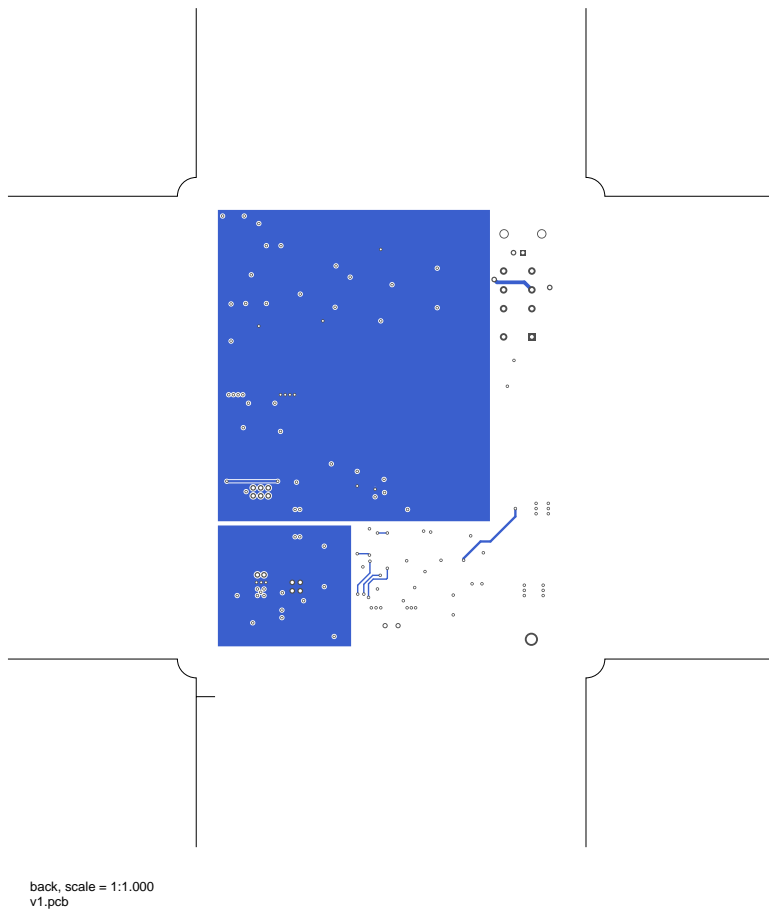
[picture p148: page 3]
back, scale = 1:1.000

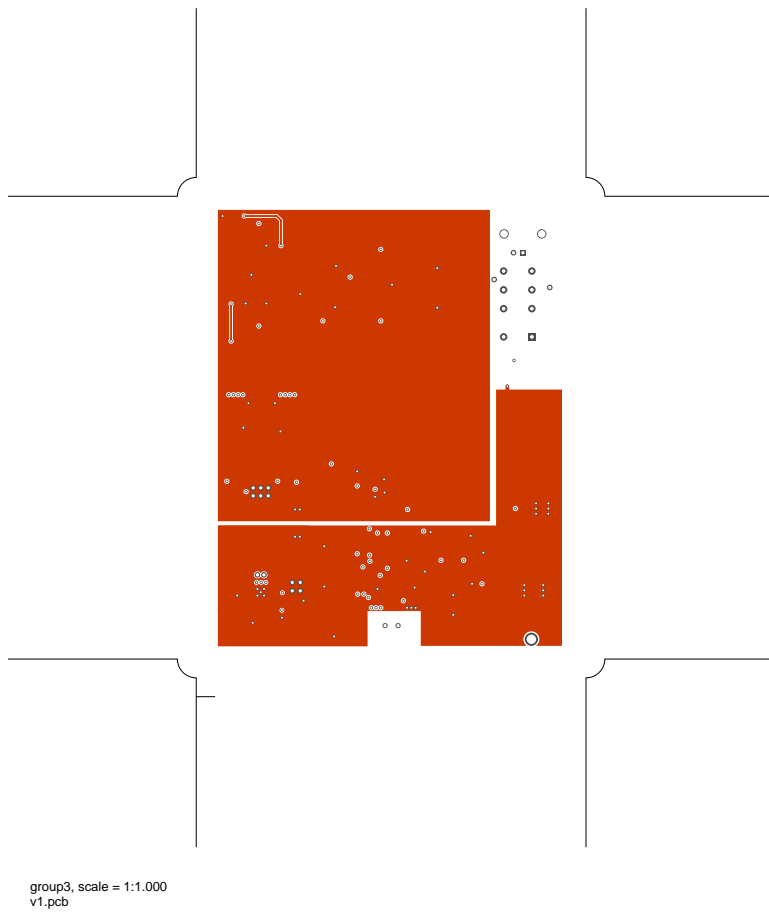
[picture p149: page 4]
group3, scale = 1:1.000

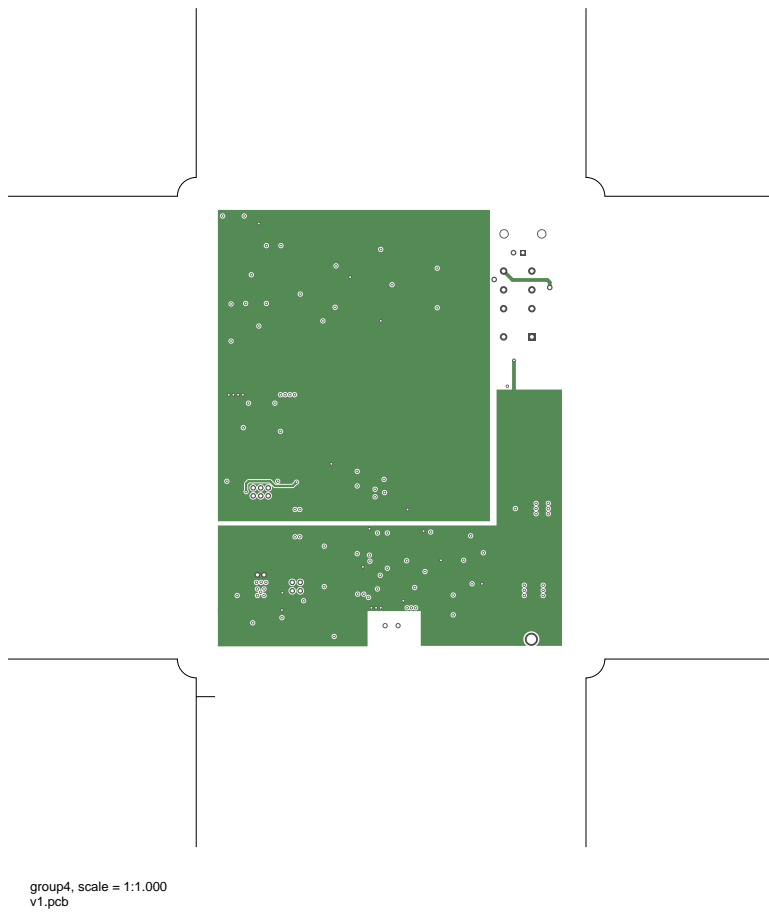
[picture p150: page 5]
group4, scale = 1:1.000

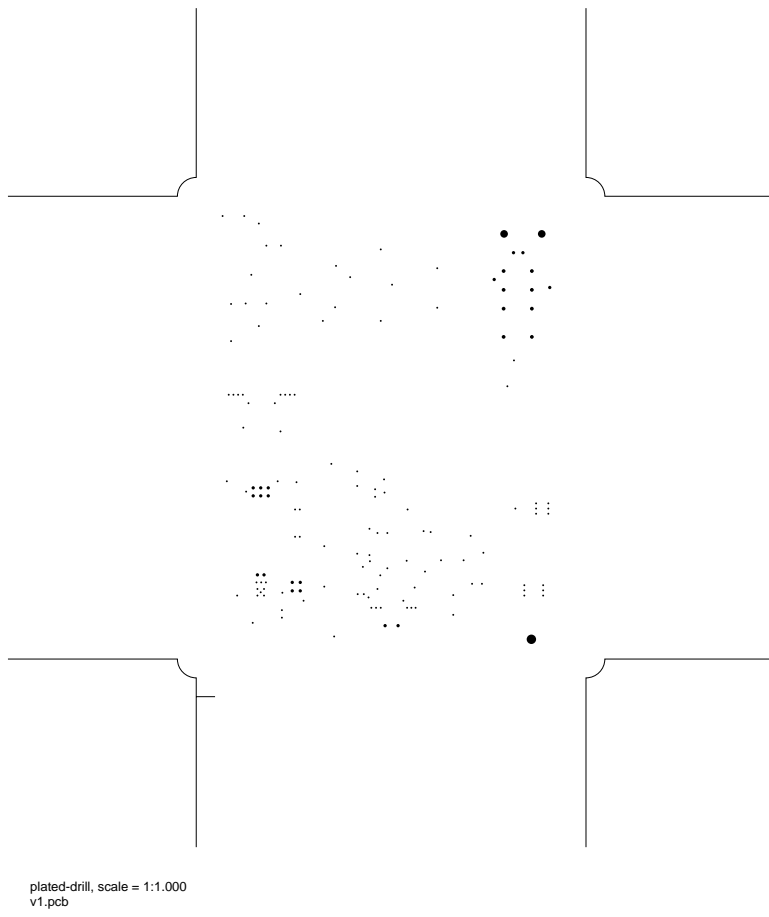
[picture p151: page 6]

plated-drill, scale = 1:1.000

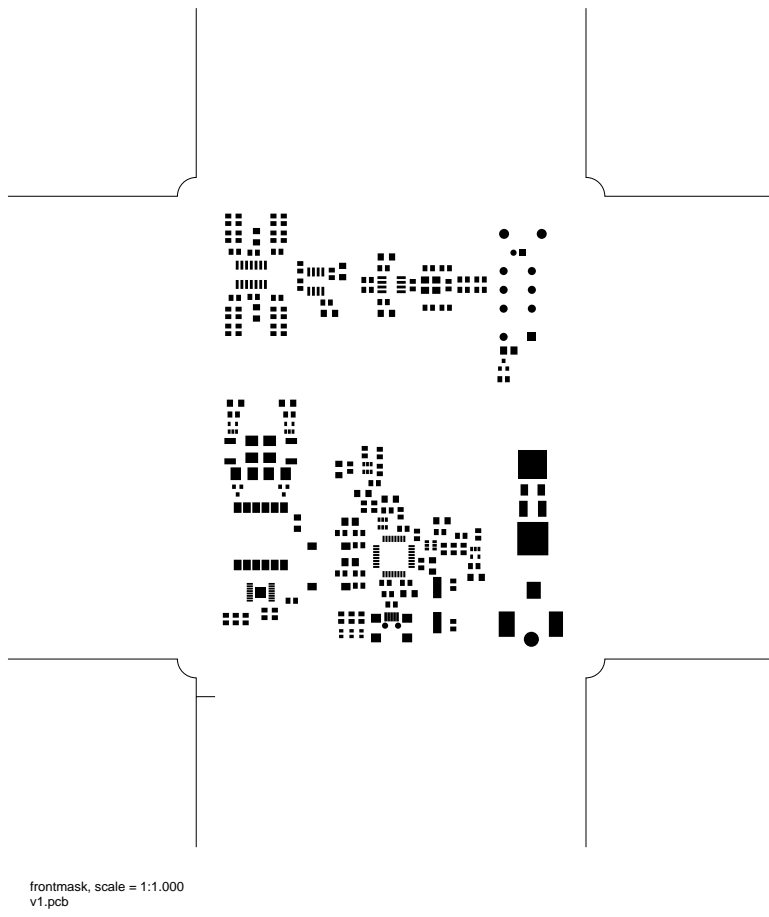
[picture p152: page 7]
frontmask, scale = 1:1.000

backmask, scale = 1:1.000

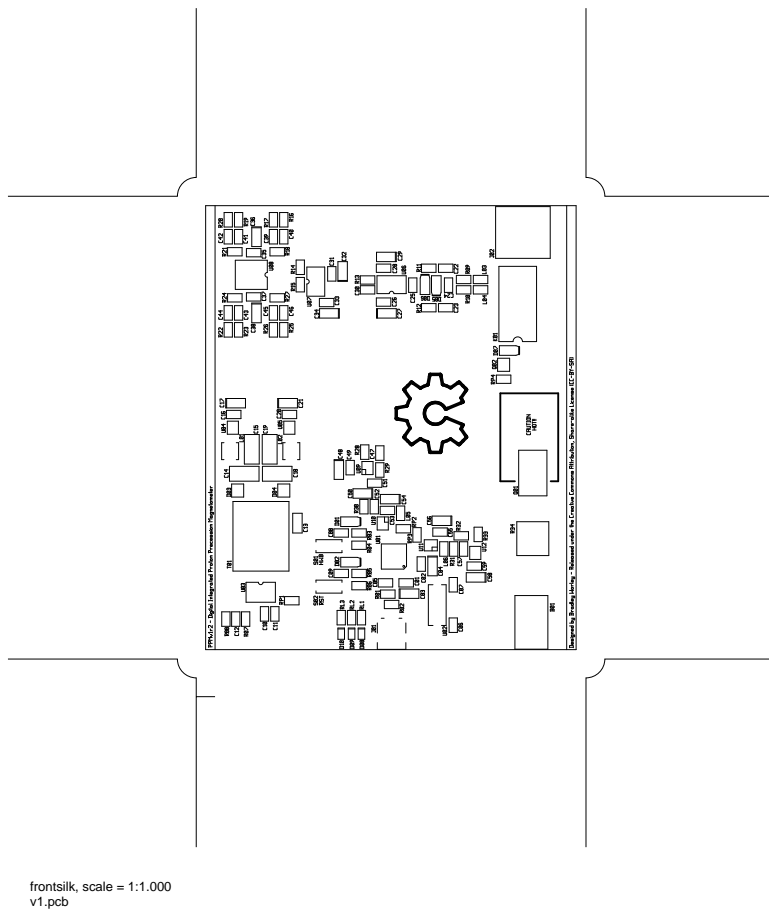
[picture p153: page 9]
frontsilk, scale = 1:1.000

backsilk, scale = 1:1.000 frontpaste, scale = 1:1.000

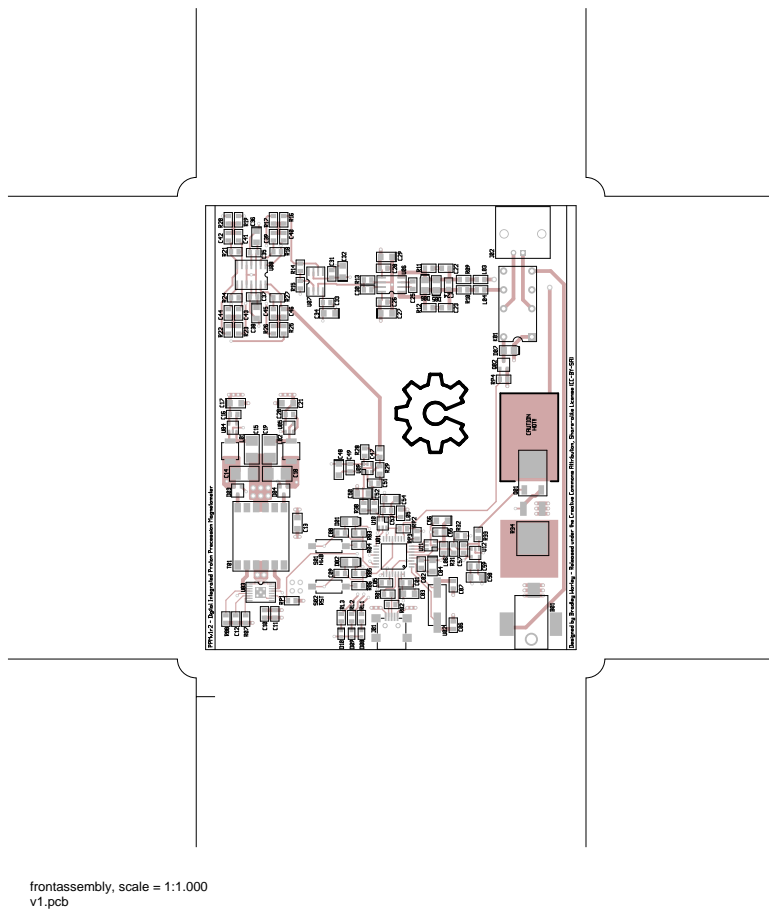
[picture p154: page 12]
frontassembly, scale = 1:1.000

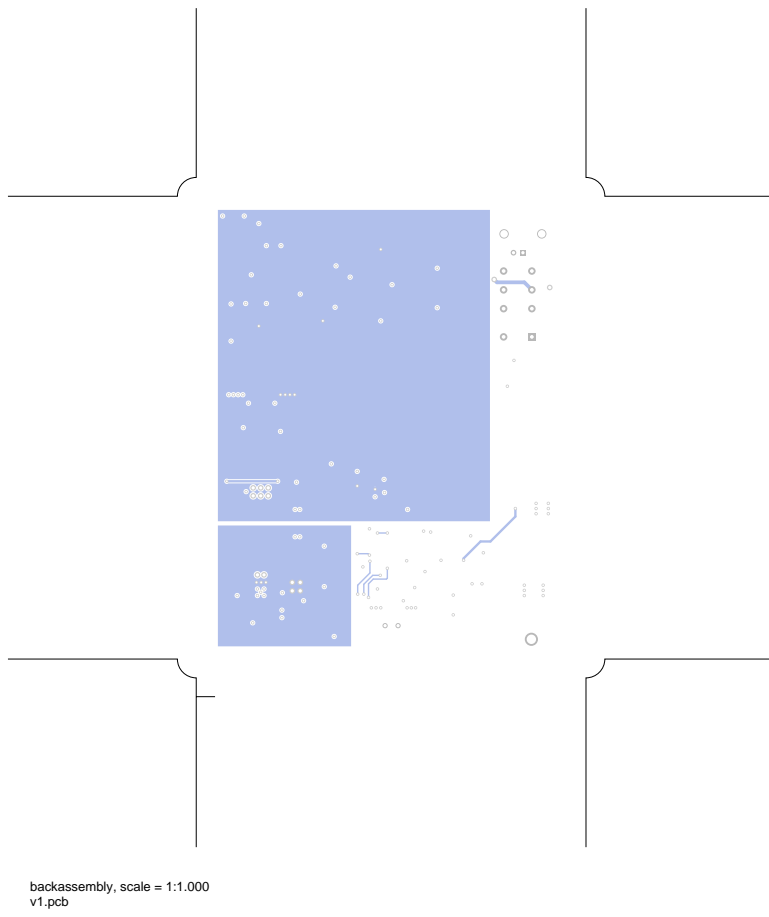
[picture p155: page 13]
backassembly, scale = 1:1.000

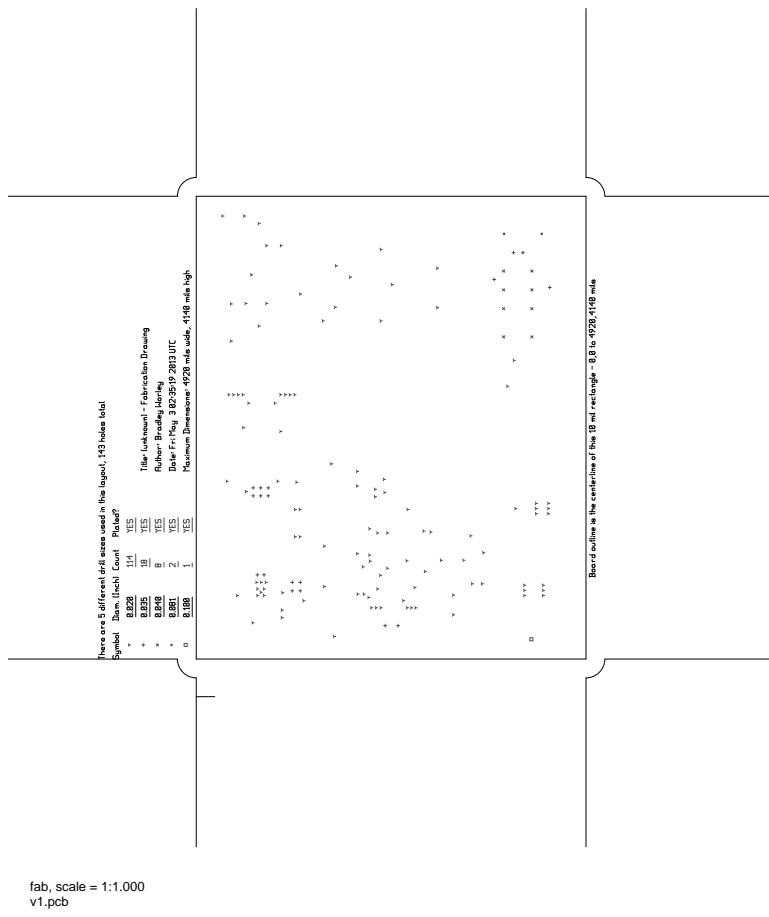
[picture p156: page 14]
fab, scale = 1:1.000
