geekysuavo/pyppm/designs/ppm-1.2/v1.pdf

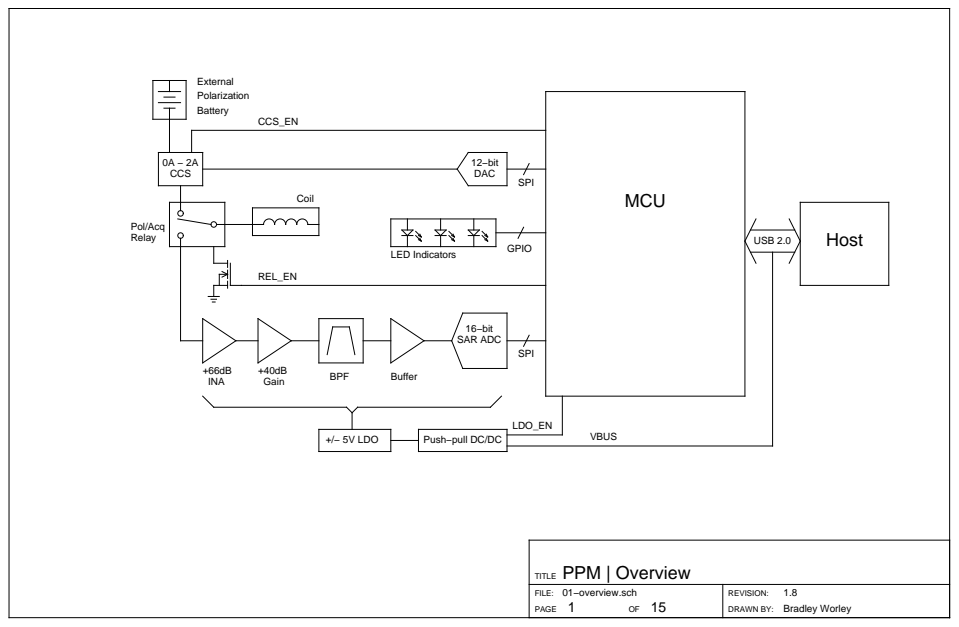
[picture p157: page 1]
PAGE; DRAWN BY:; Bradley Worley; SAR ADC; USB 2.0; +/− 5V LDO; LED Indicators; GPIO

Push−pull DC/DC

TITLE PPM | Overview

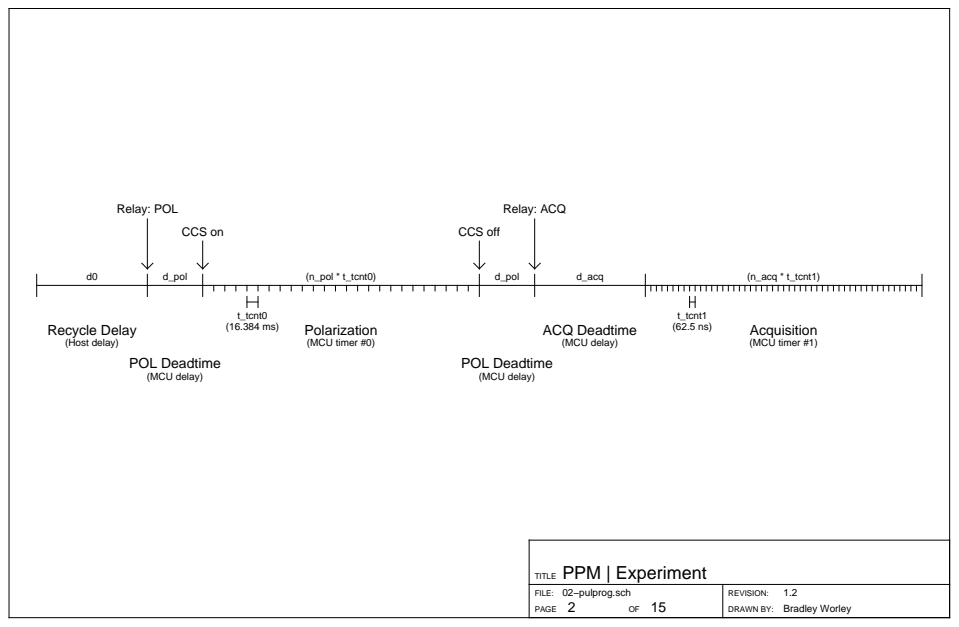
[picture p158: page 2]
PAGE; DRAWN BY:; Bradley Worley; Recycle Delay (Host delay); POL Deadtime; CCS on; Relay: POL; CCS off; Relay: ACQ; (MCU delay); ACQ Deadtime (MCU delay); (MCU timer #0); (MCU timer #1); d_pol; (n_pol * t_tcnt0); d_acq; (n_acq * t_tcnt1); POL Deadtime (MCU delay)

TITLE PPM | Experiment

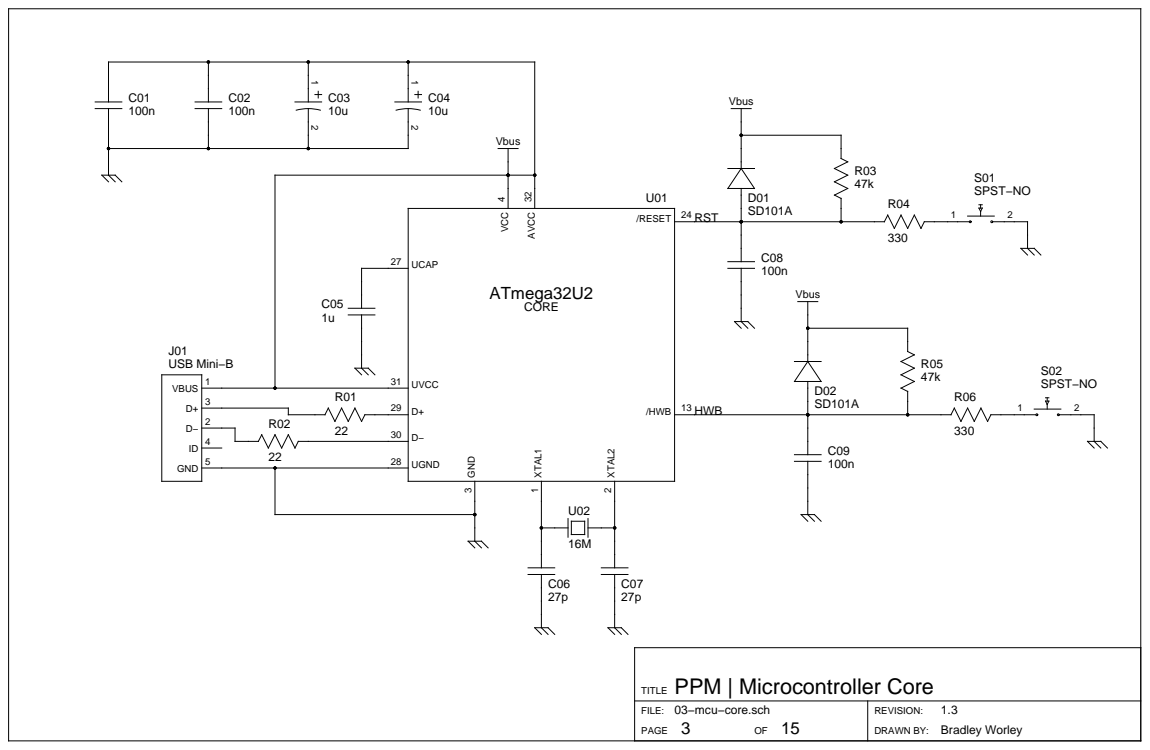
[picture p159: page 3]

TITLE PPM | Microcontroller Core

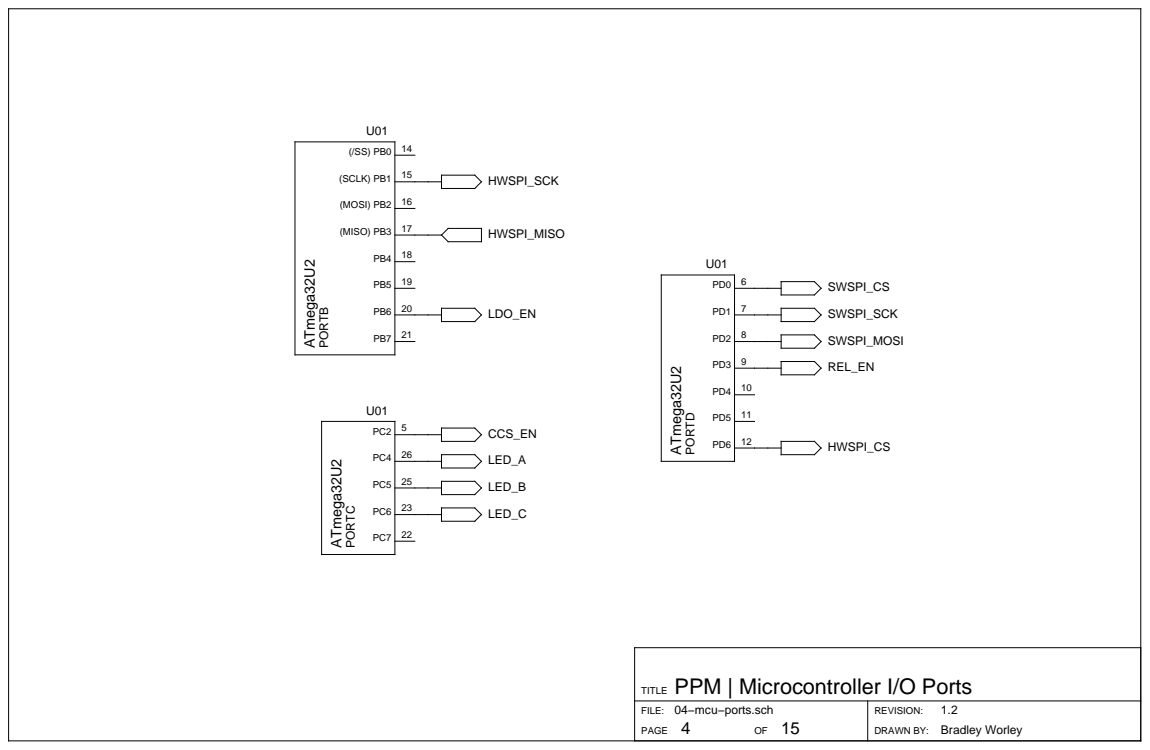
[picture p160: page 4]
PAGE; DRAWN BY:; Bradley Worley; 15 (SCLK) PB1; 16 (MOSI) PB2; 17 (MISO) PB3

TITLE PPM | Microcontroller I/O Ports

04−mcu−ports.sch

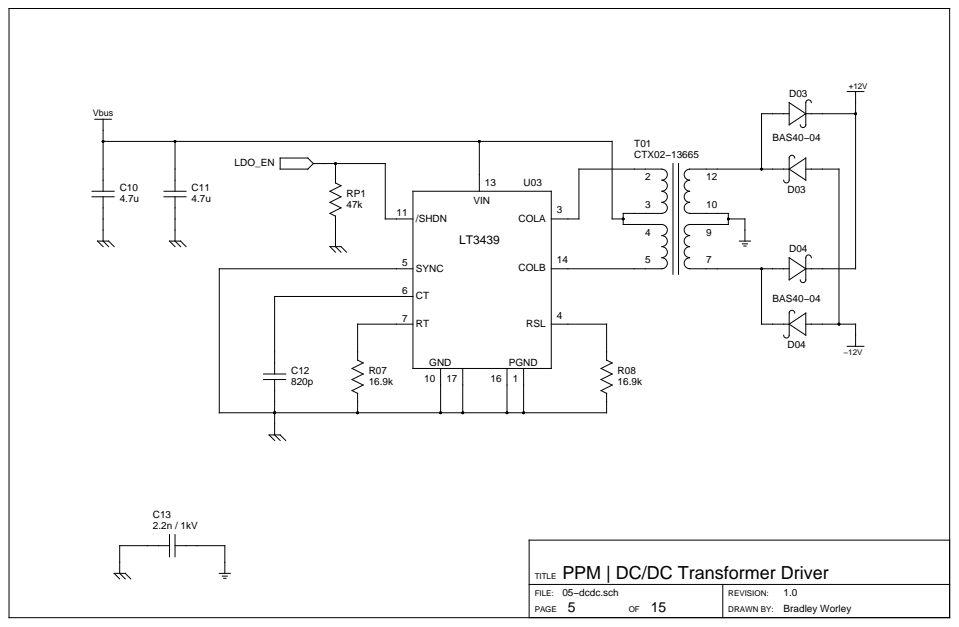
[picture p161: page 5]

TITLE PPM | DC/DC Transformer Driver


TITLE PPM | Low−Dropout Regulators

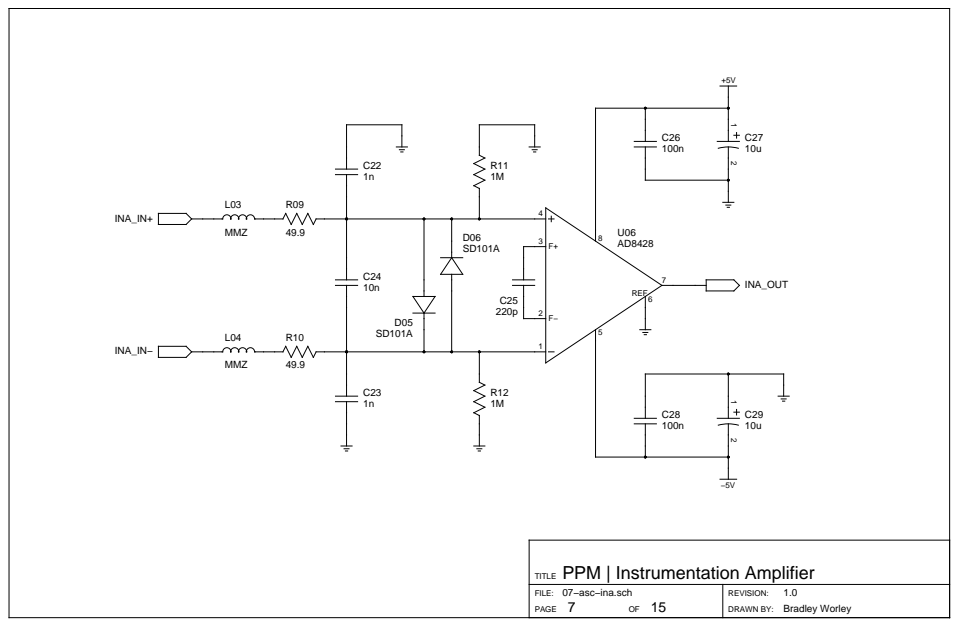
[picture p162: page 7]

TITLE PPM | Instrumentation Amplifier

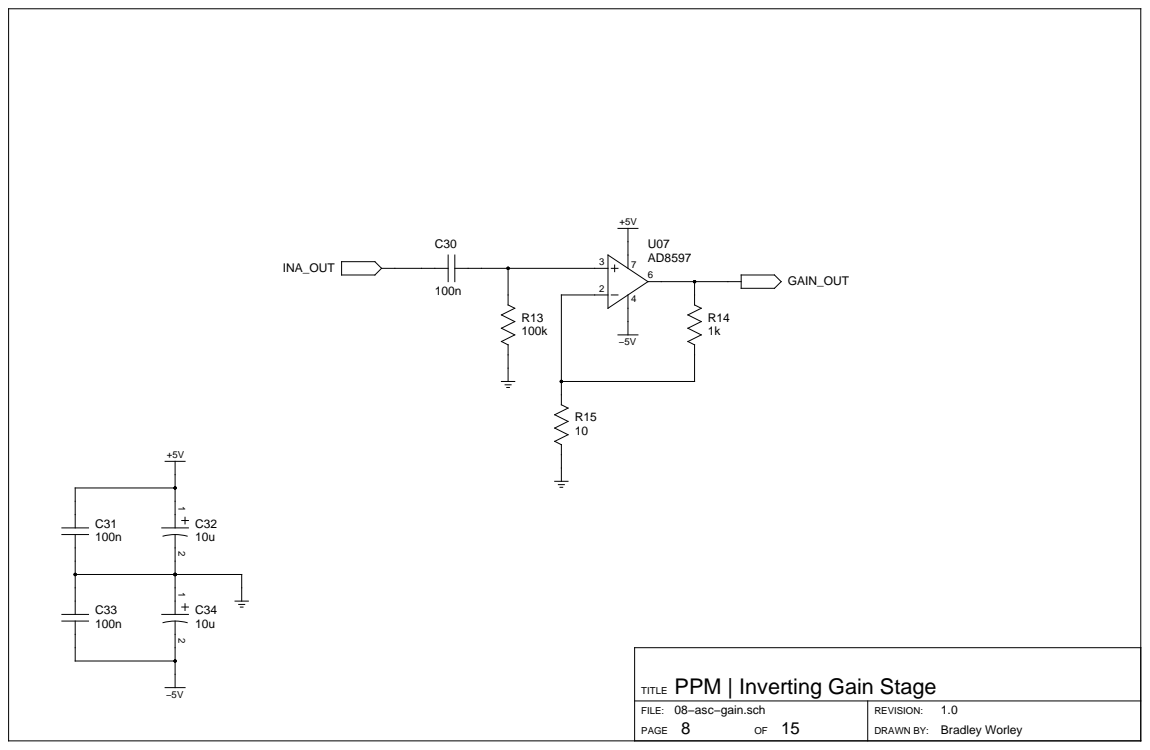
[picture p163: page 8]

TITLE PPM | Inverting Gain Stage


TITLE PPM | Bandpass Filter 1/2


TITLE PPM | Bandpass Filter 2/2

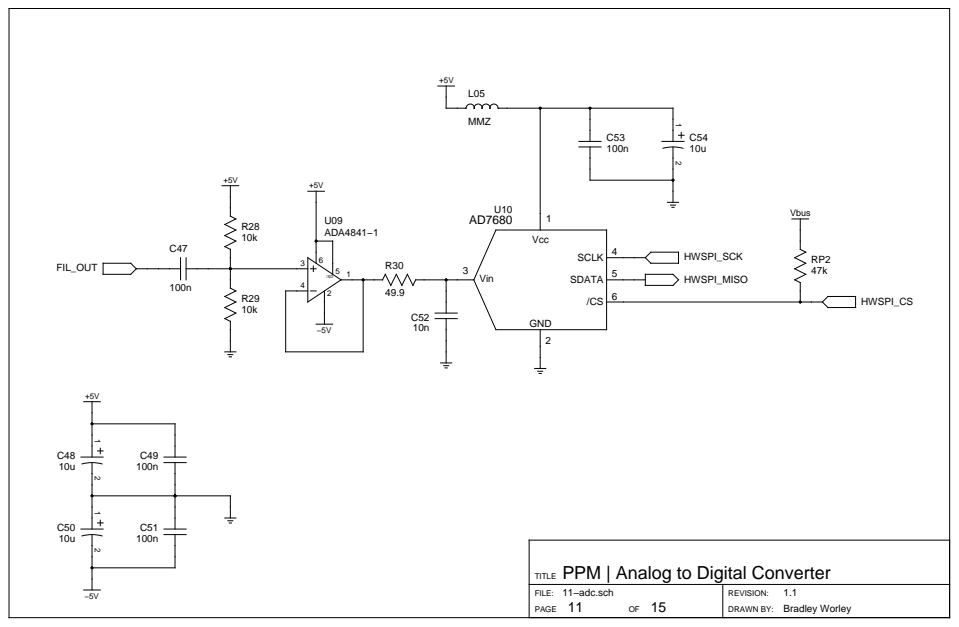
[picture p164: page 11]

TITLE PPM | Analog to Digital Converter

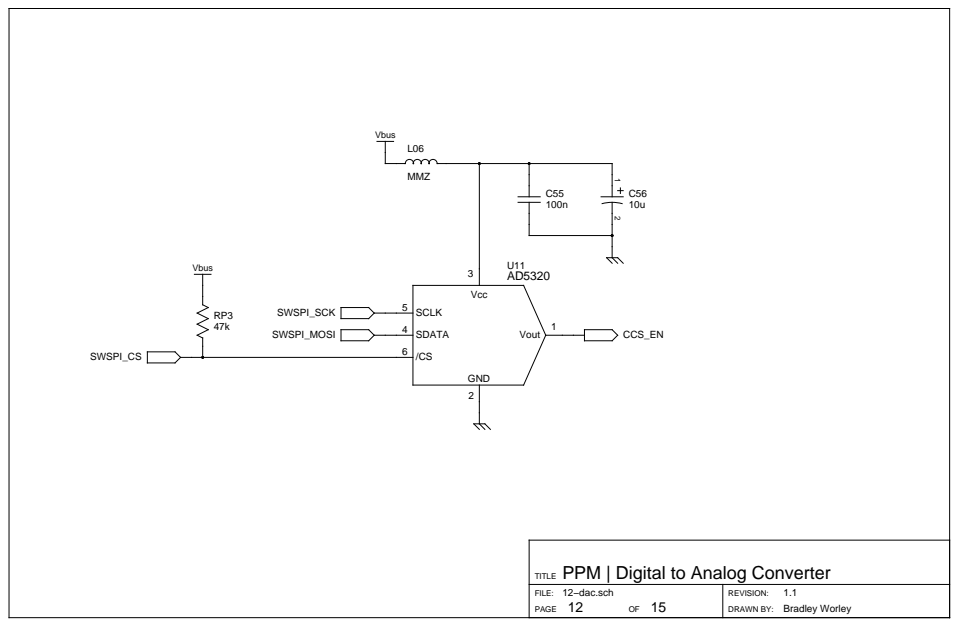
[picture p165: page 12]
PAGE; DRAWN BY:; Bradley Worley

TITLE PPM | Digital to Analog Converter

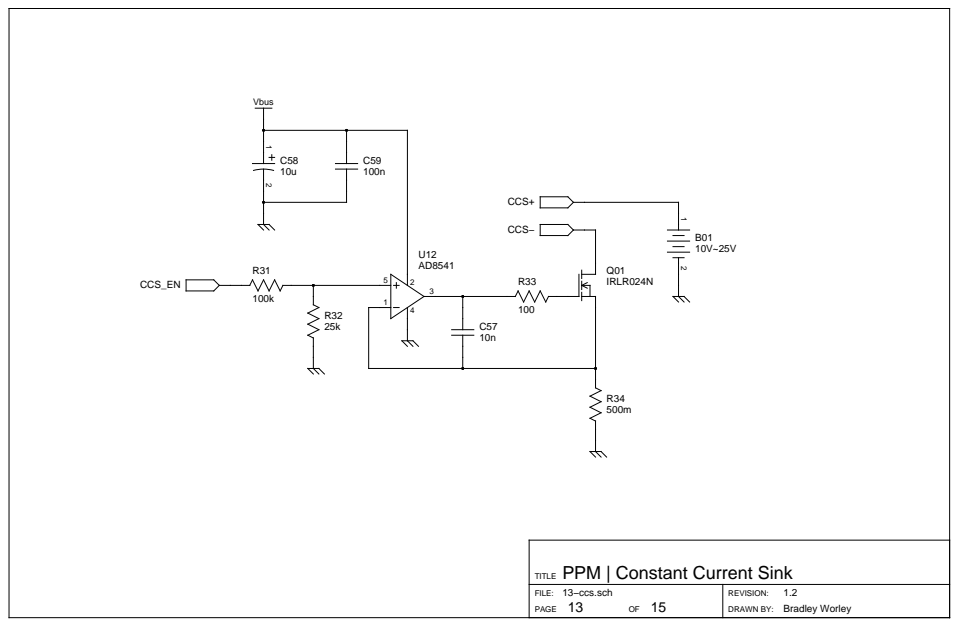
[picture p166: page 13]

TITLE PPM | Constant Current Sink

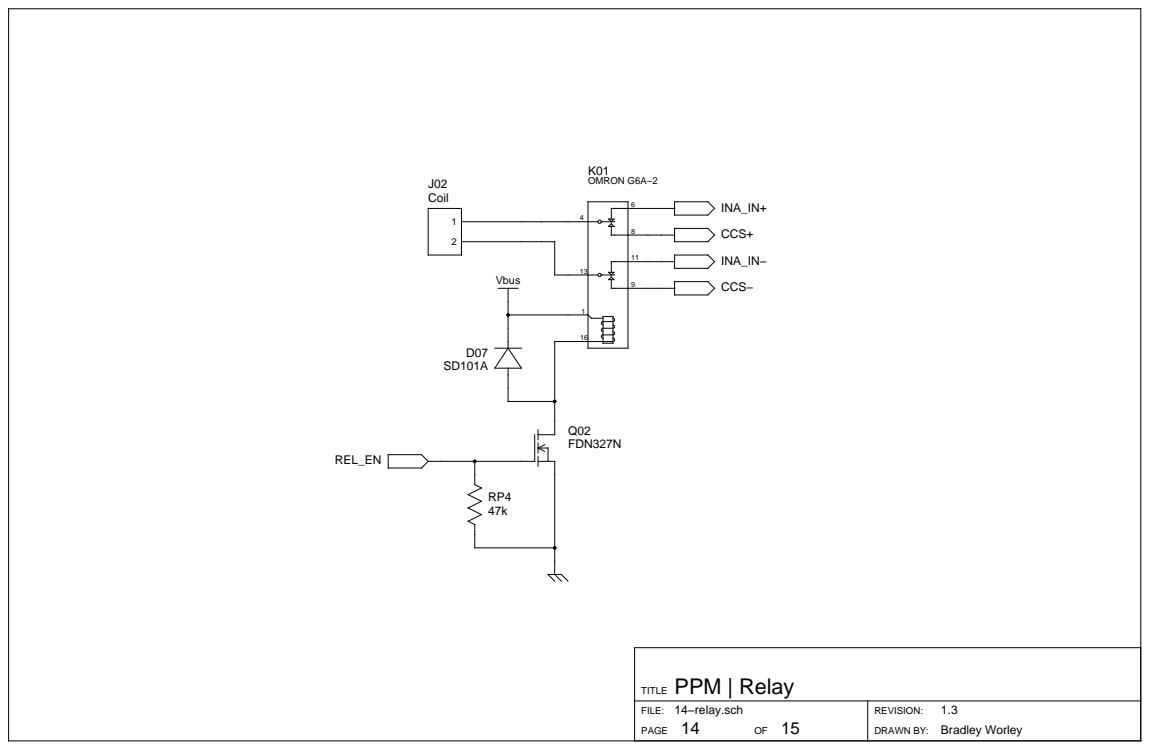
[picture p167: page 14]
PAGE; DRAWN BY:; Bradley Worley; OMRON G6A−2

TITLE PPM | Relay

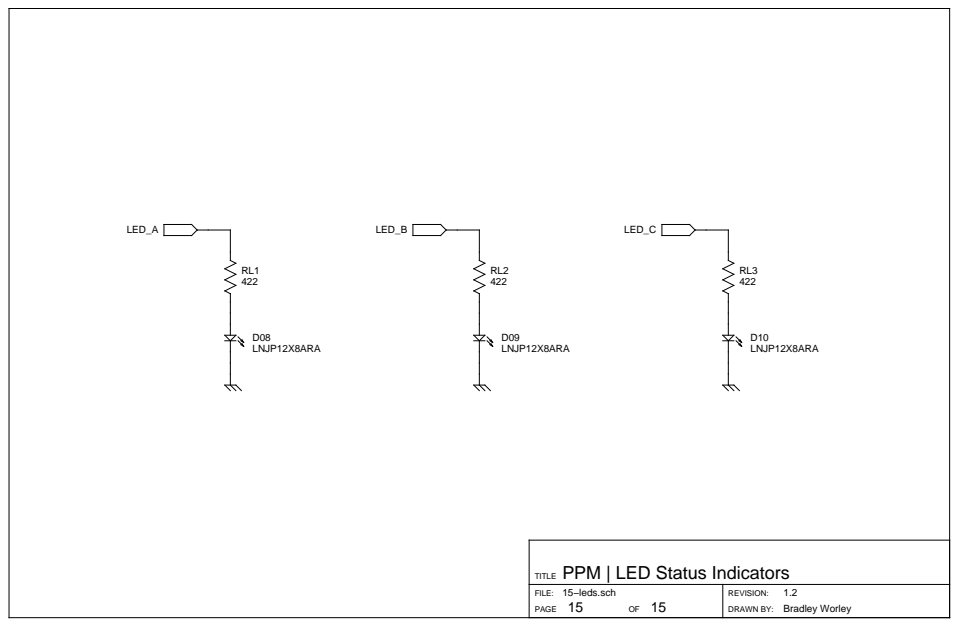
[picture p168: page 15]
PAGE; DRAWN BY:; Bradley Worley

TITLE PPM | LED Status Indicators
