geekysuavo/pyppm/designs/ppm-1.3/v1-brd.pdf

# v1.pcb

# 1. Table of Contents (This Page) Created on Sun Jan 12 13:51:53 2014

# 2. component 3. solder 4. GND 5. power 6. plated-drill 7. componentmask 8. soldermask 9. topsilk 10. bottomsilk 11. toppaste 12. topassembly 13. bottomassembly 14. fab

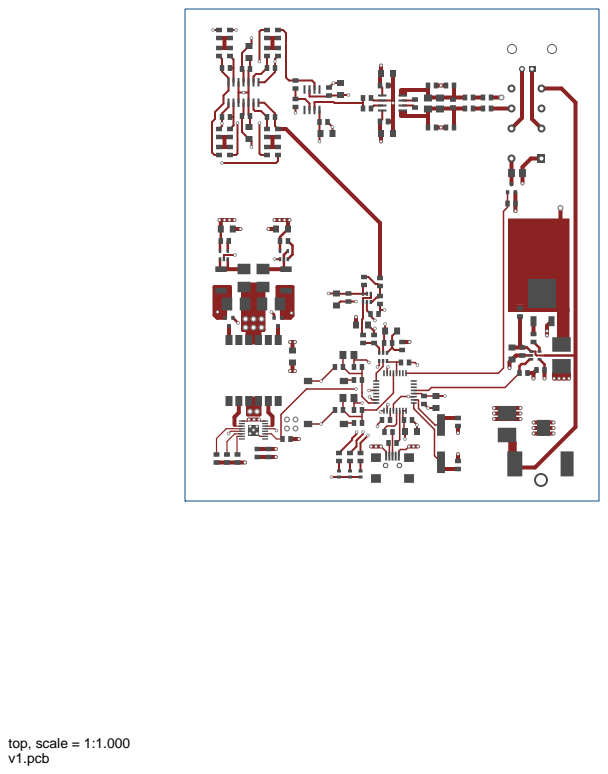
[picture p169: page 2]
top, scale = 1:1.000

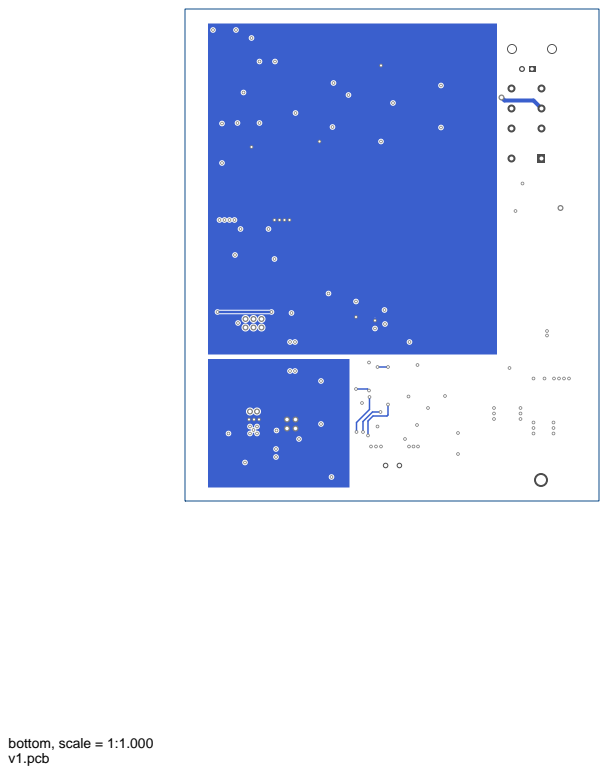
[picture p170: page 3]
bottom, scale = 1:1.000

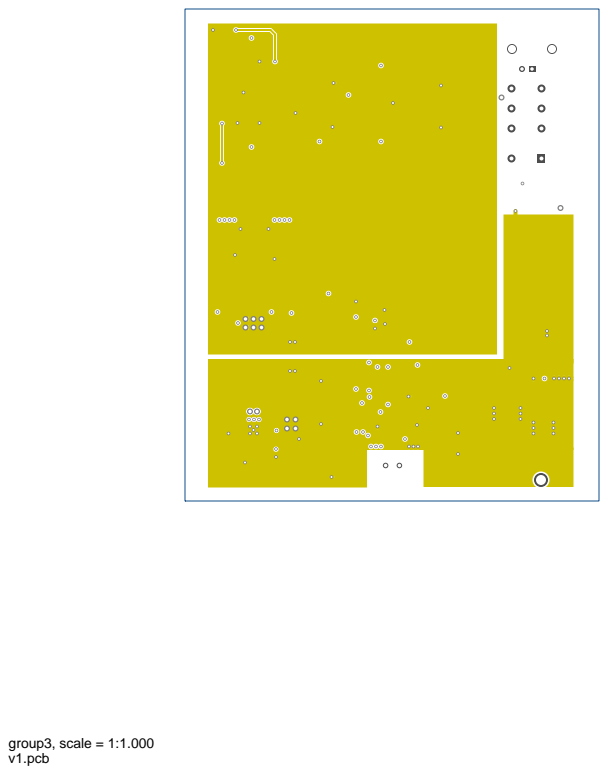
[picture p171: page 4]
group3, scale = 1:1.000

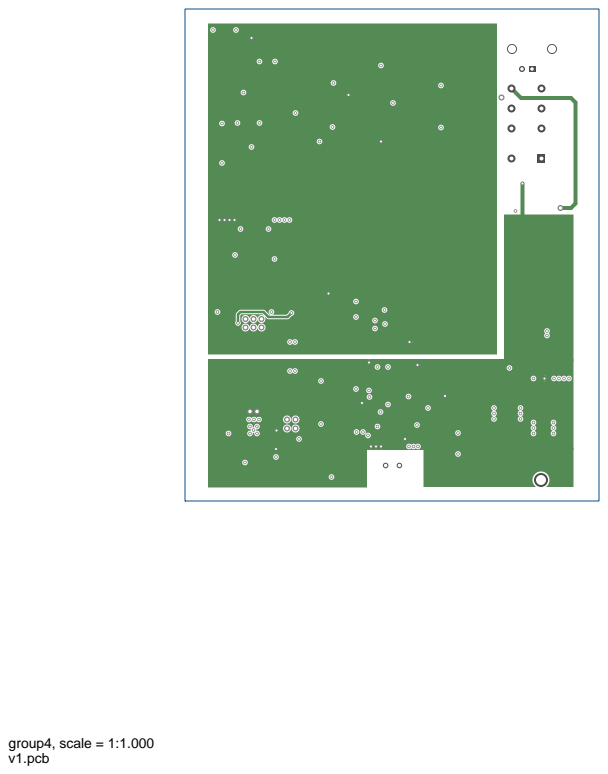
[picture p172: page 5]
group4, scale = 1:1.000

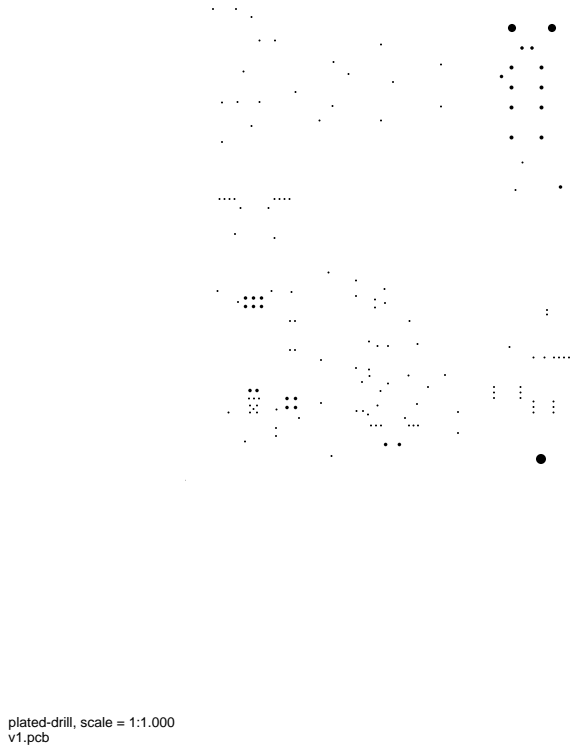
[picture p173: page 6]

plated-drill, scale = 1:1.000

topmask, scale = 1:1.000

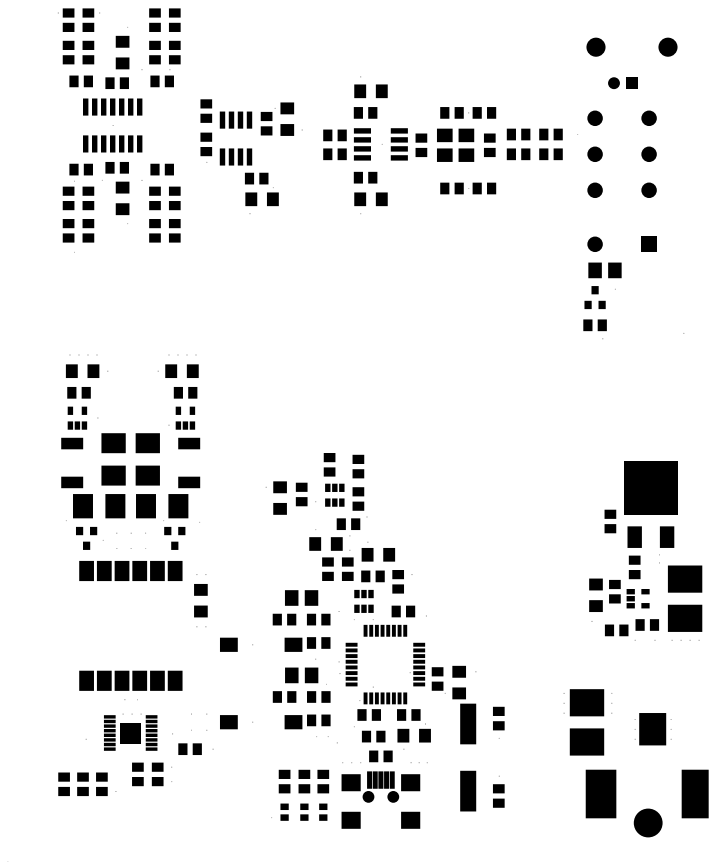
[picture p174: figure]

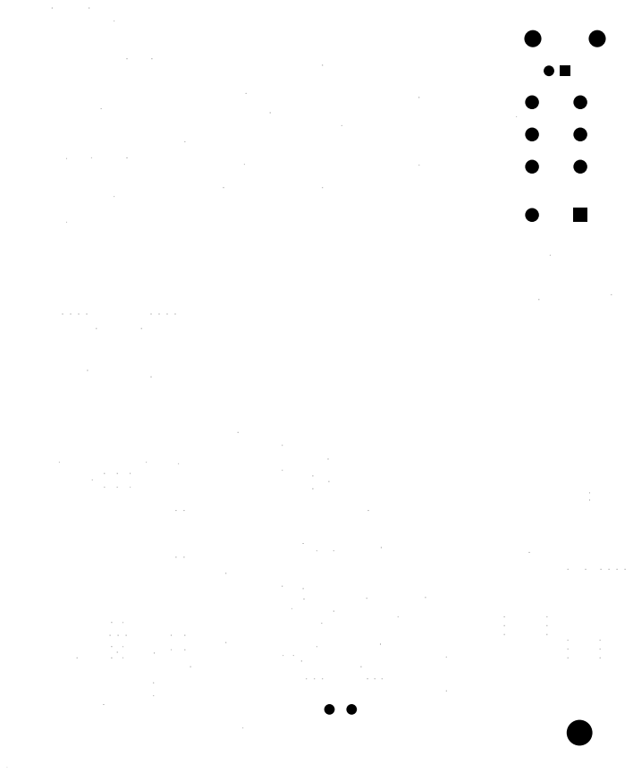
[picture p175: figure]

bottommask, scale = 1:1.000

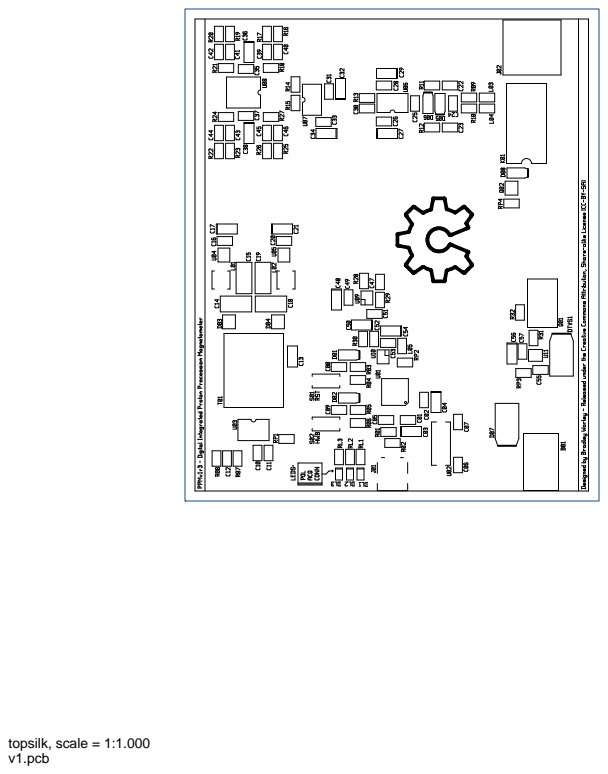
[picture p176: page 9]
topsilk, scale = 1:1.000

bottomsilk, scale = 1:1.000

toppaste, scale = 1:1.000

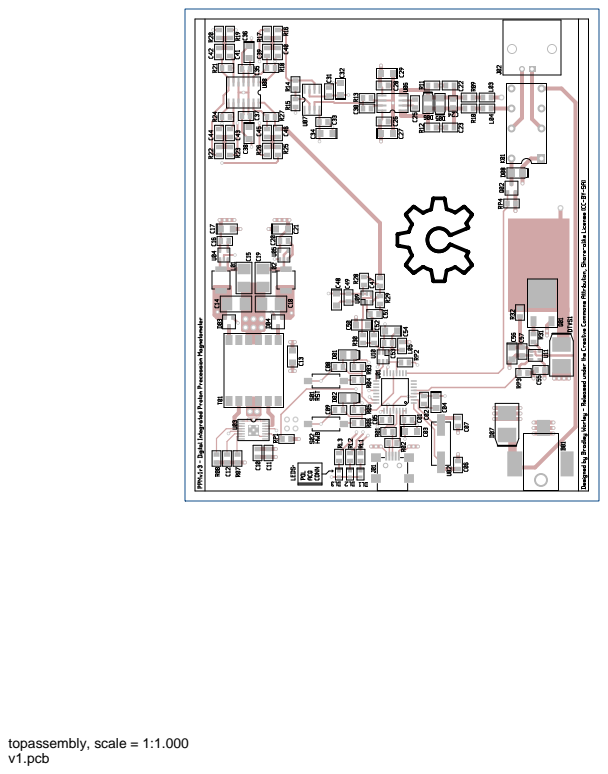
[picture p177: page 12]
topassembly, scale = 1:1.000

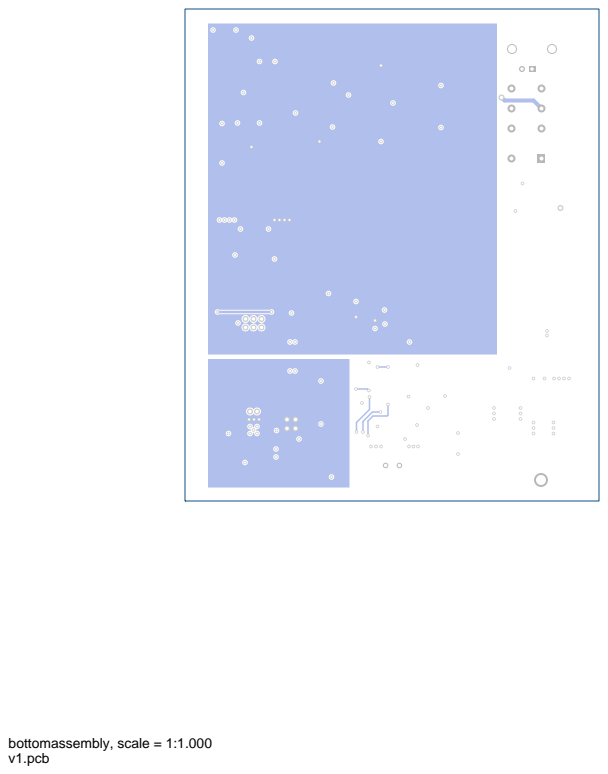
[picture p178: page 13]
bottomassembly, scale = 1:1.000

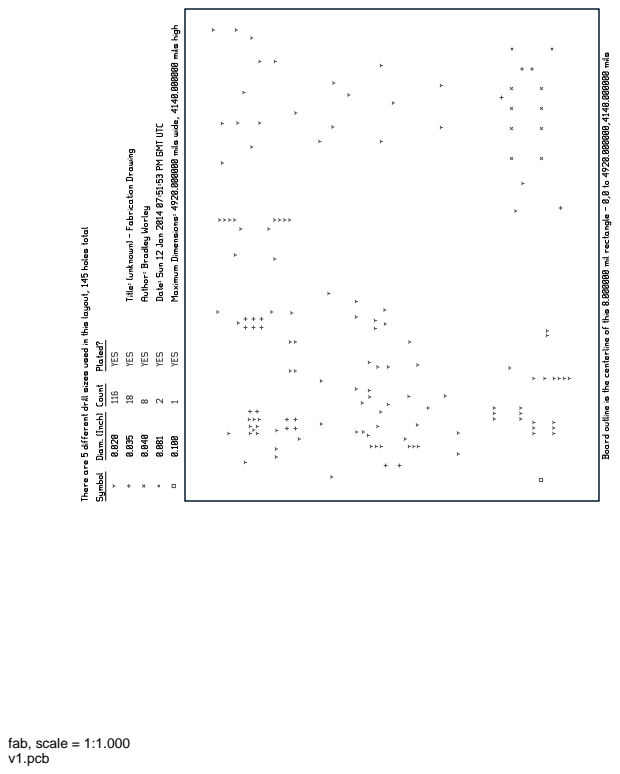
[picture p179: page 14]
fab, scale = 1:1.000
