geekysuavo/pyppm/designs/ppm-1.3/v1.pdf

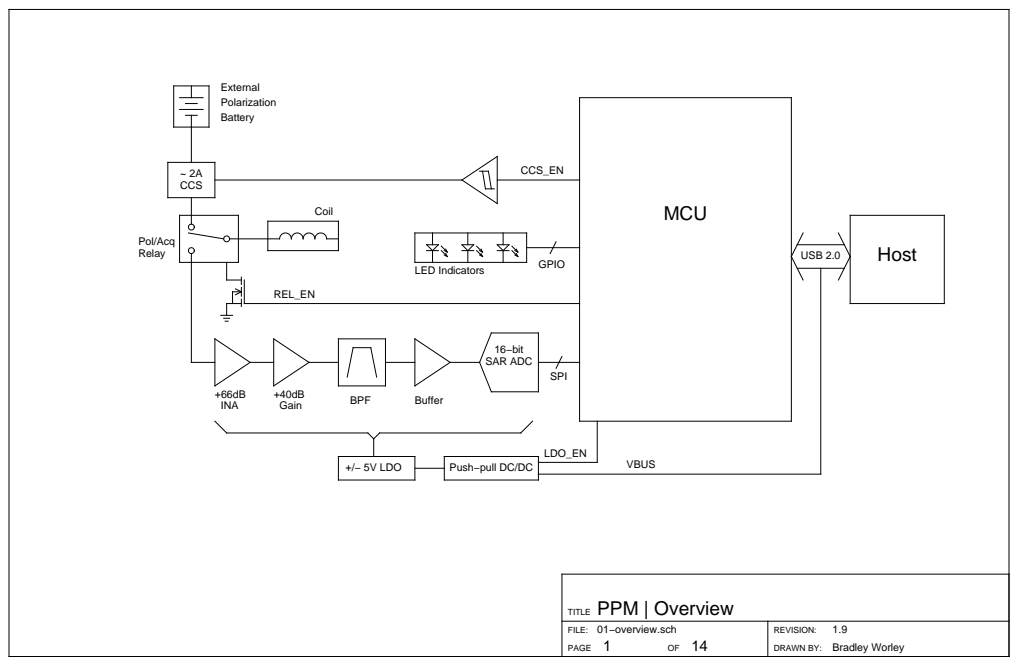
[picture p180: page 1]
PAGE; DRAWN BY:; Bradley Worley; SAR ADC; USB 2.0; +/− 5V LDO; LED Indicators; GPIO

Push−pull DC/DC

TITLE PPM | Overview

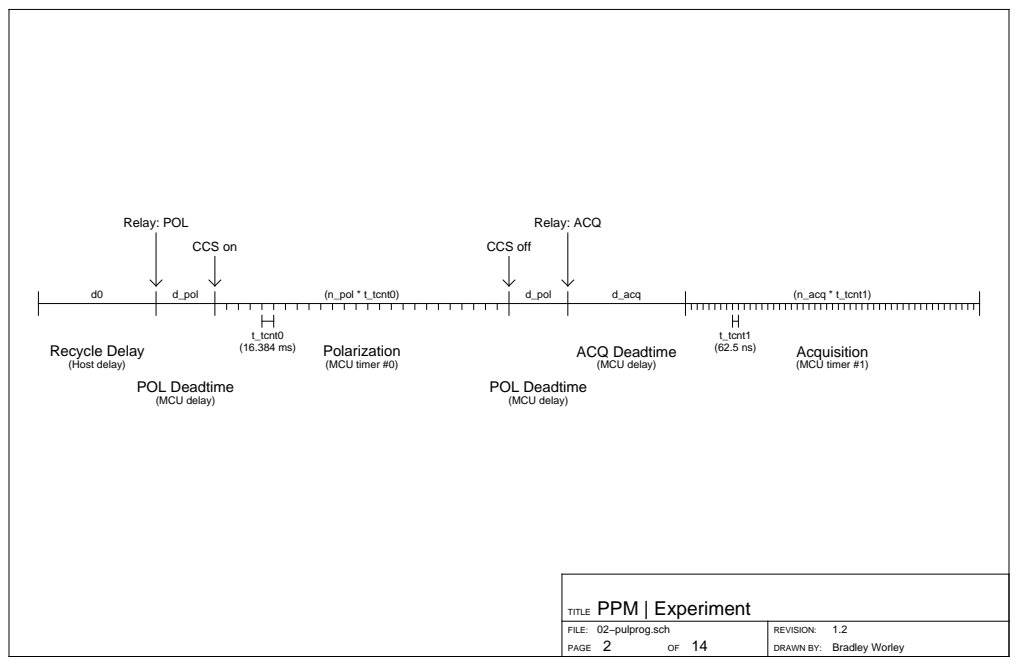
[picture p181: page 2]
PAGE; DRAWN BY:; Bradley Worley; Recycle Delay (Host delay); POL Deadtime; CCS on; Relay: POL; CCS off; Relay: ACQ; (MCU delay); ACQ Deadtime (MCU delay); (MCU timer #0); (MCU timer #1); d_pol; (n_pol * t_tcnt0); d_acq; (n_acq * t_tcnt1); POL Deadtime (MCU delay)

TITLE PPM | Experiment

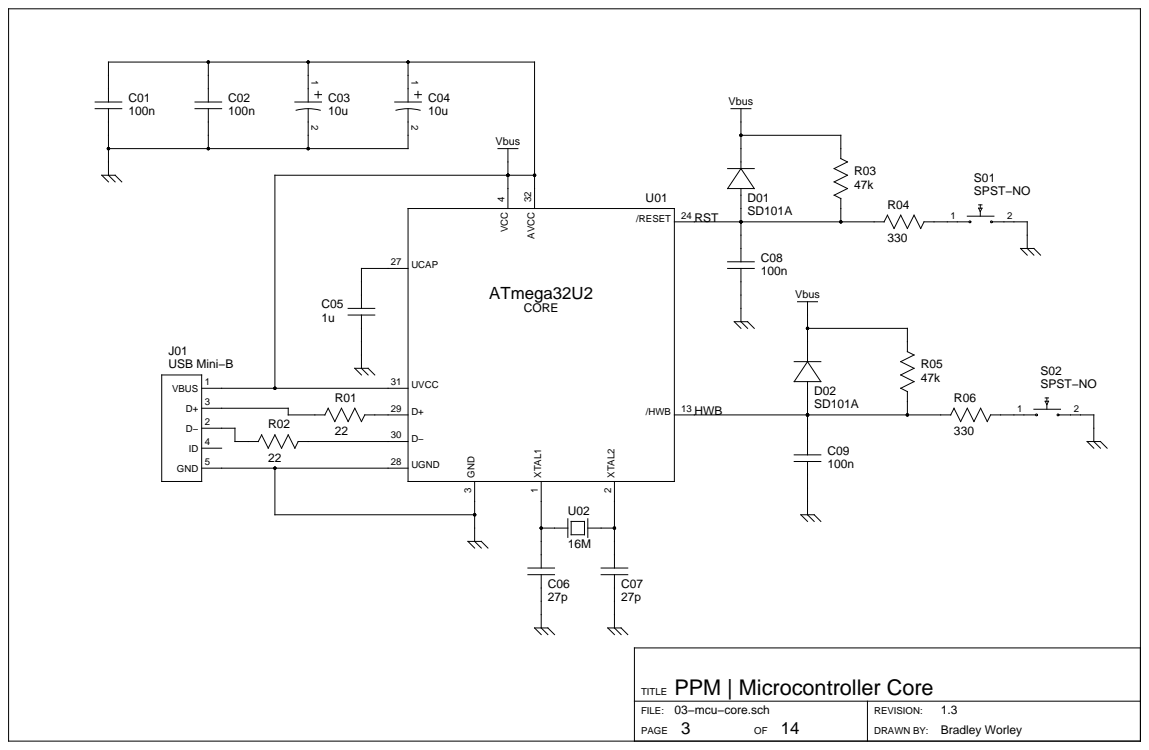
[picture p182: page 3]

TITLE PPM | Microcontroller Core

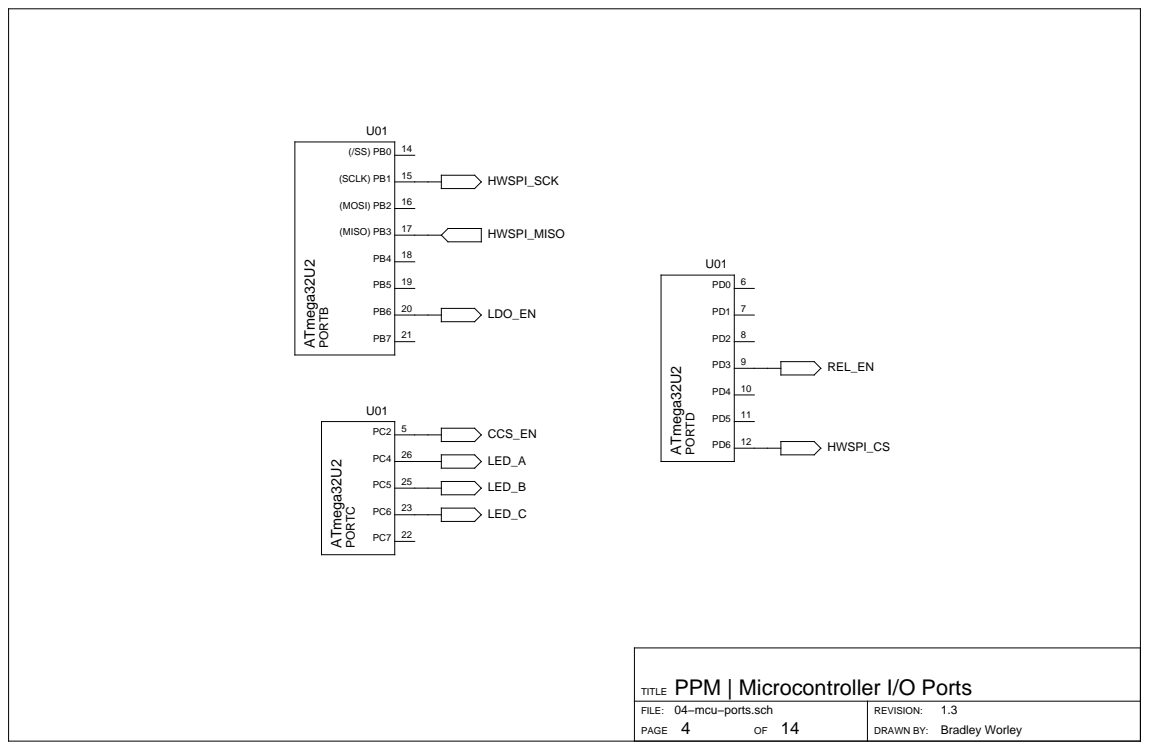
[picture p183: page 4]
PAGE; DRAWN BY:; Bradley Worley; 15 (SCLK) PB1; 16 (MOSI) PB2; 17 (MISO) PB3

TITLE PPM | Microcontroller I/O Ports

04−mcu−ports.sch

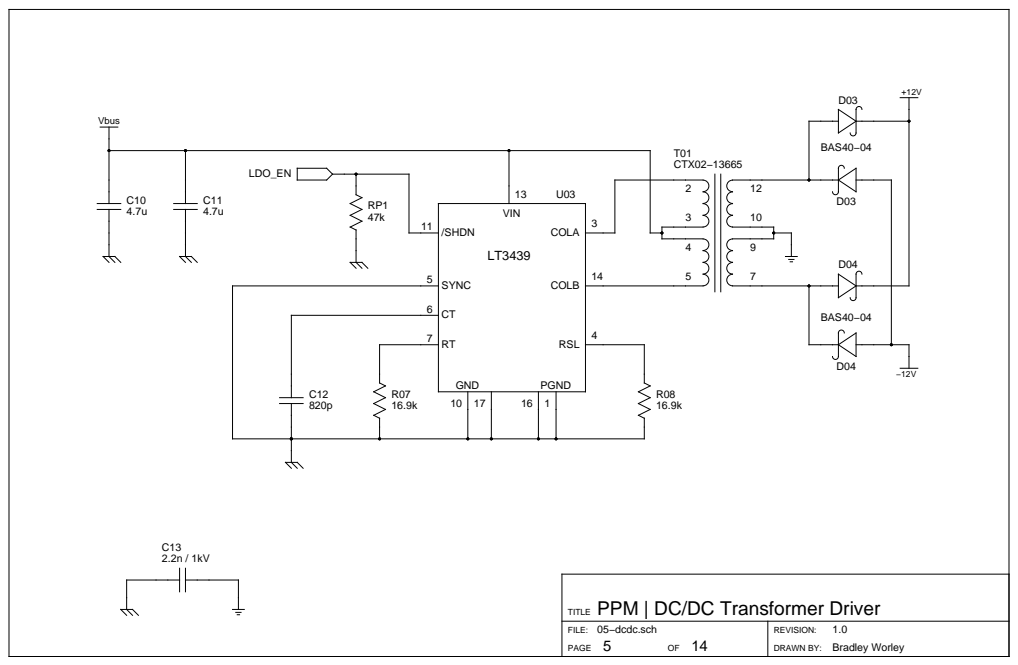
[picture p184: page 5]

TITLE PPM | DC/DC Transformer Driver

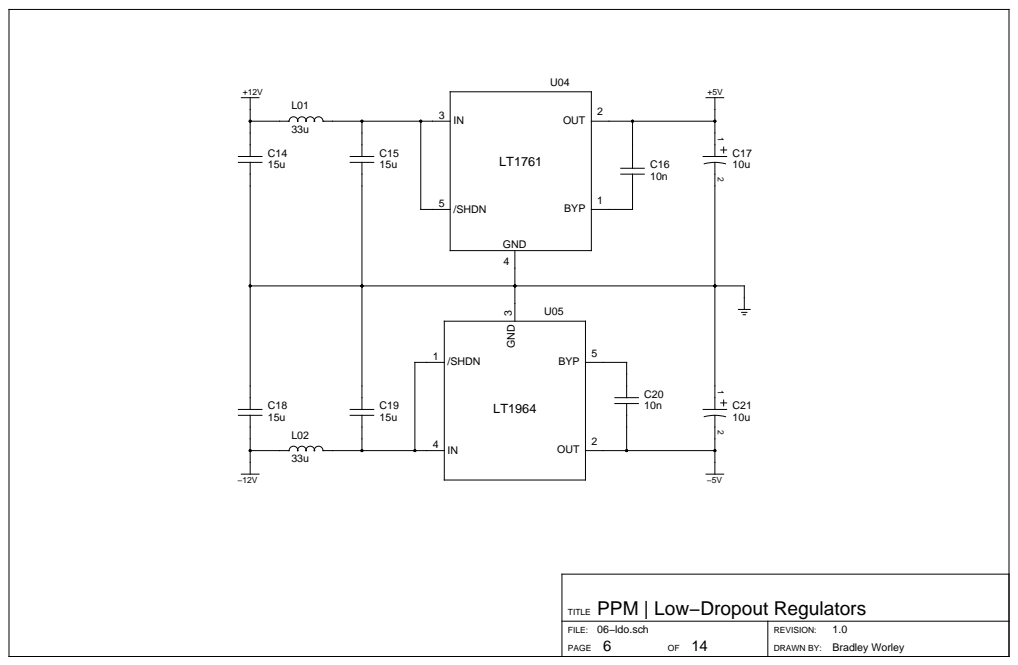
[picture p185: page 6]

TITLE PPM | Low−Dropout Regulators

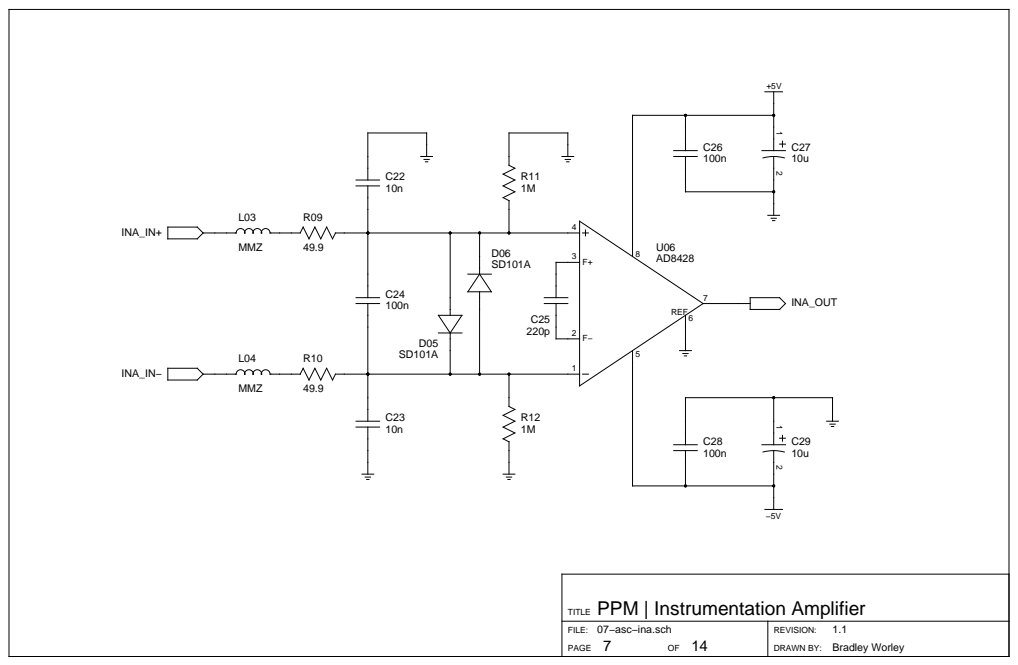
[picture p186: page 7]

TITLE PPM | Instrumentation Amplifier

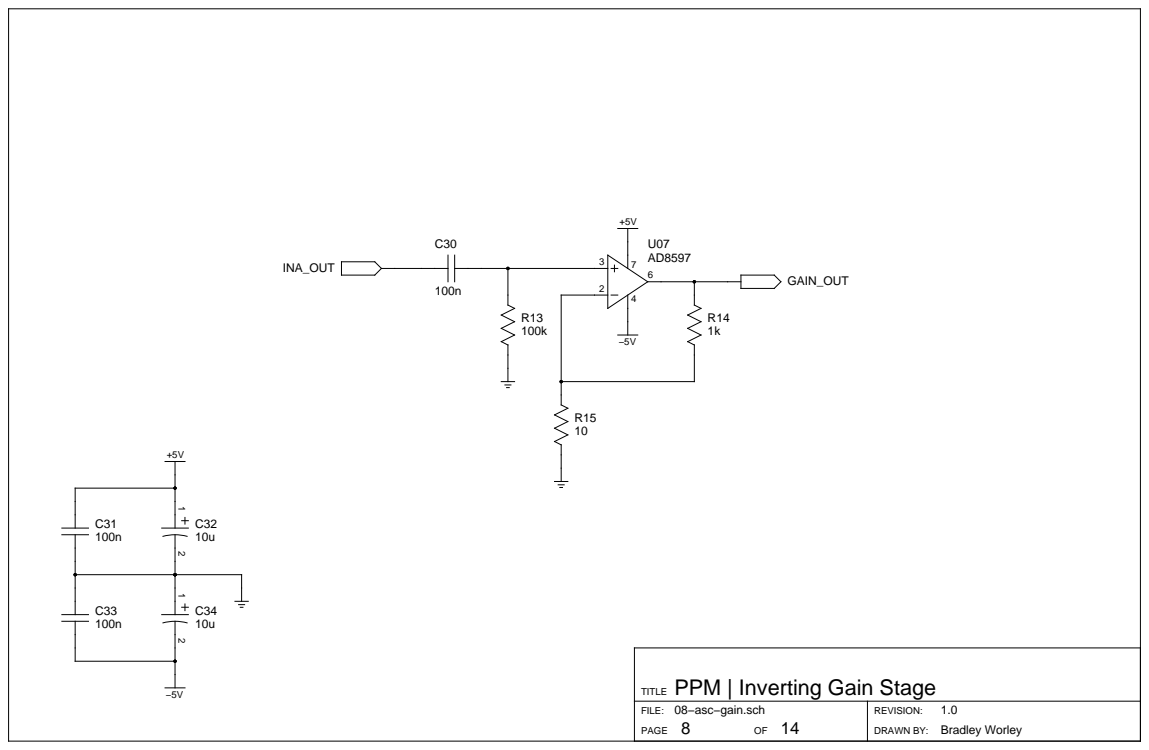
[picture p187: page 8]

TITLE PPM | Inverting Gain Stage

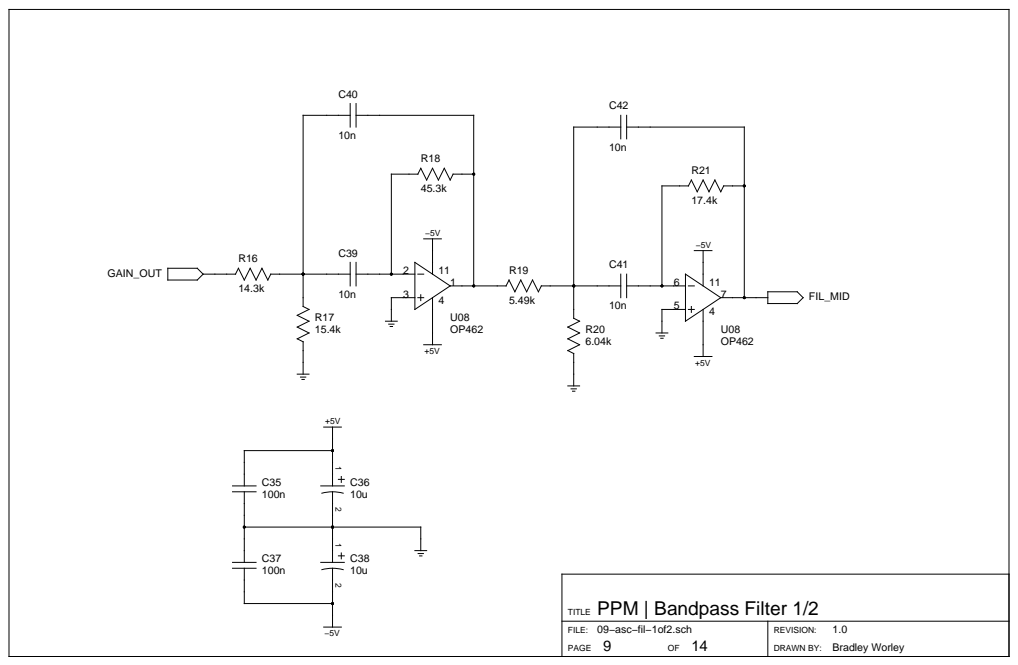
[picture p188: page 9]

TITLE PPM | Bandpass Filter 1/2

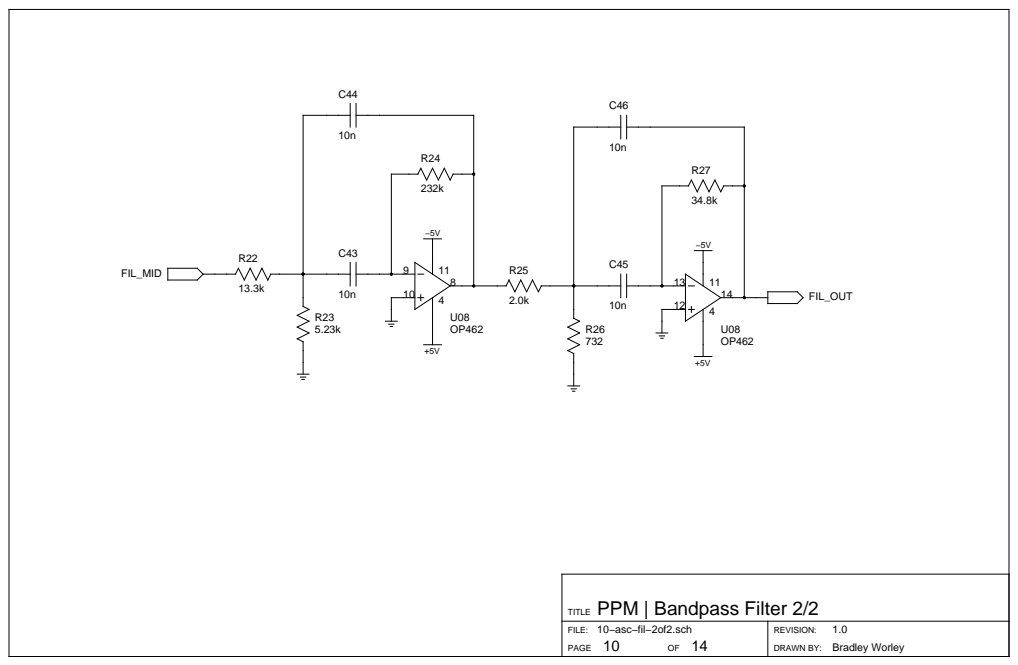
[picture p189: page 10]

TITLE PPM | Bandpass Filter 2/2

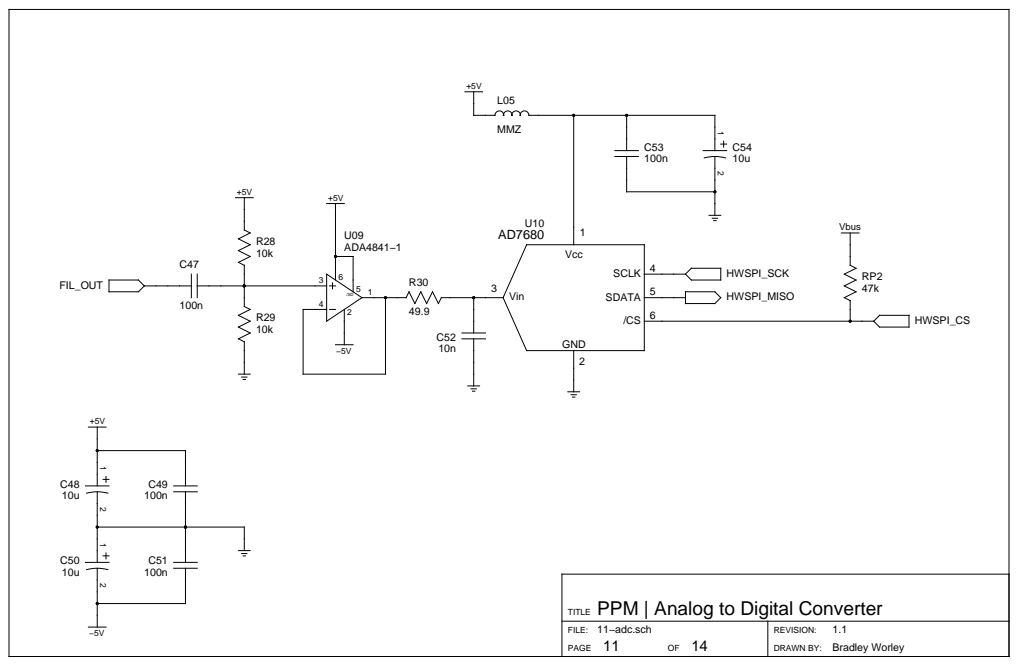
[picture p190: page 11]

TITLE PPM | Analog to Digital Converter

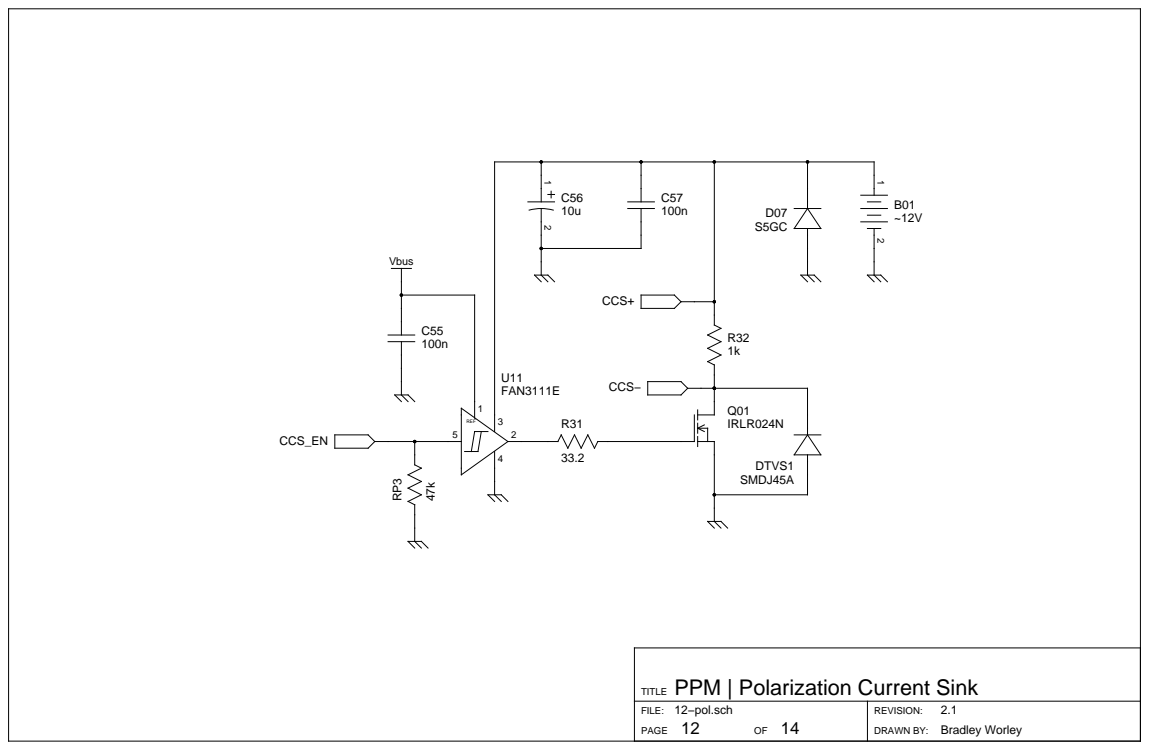
[picture p191: page 12]

TITLE PPM | Polarization Current Sink

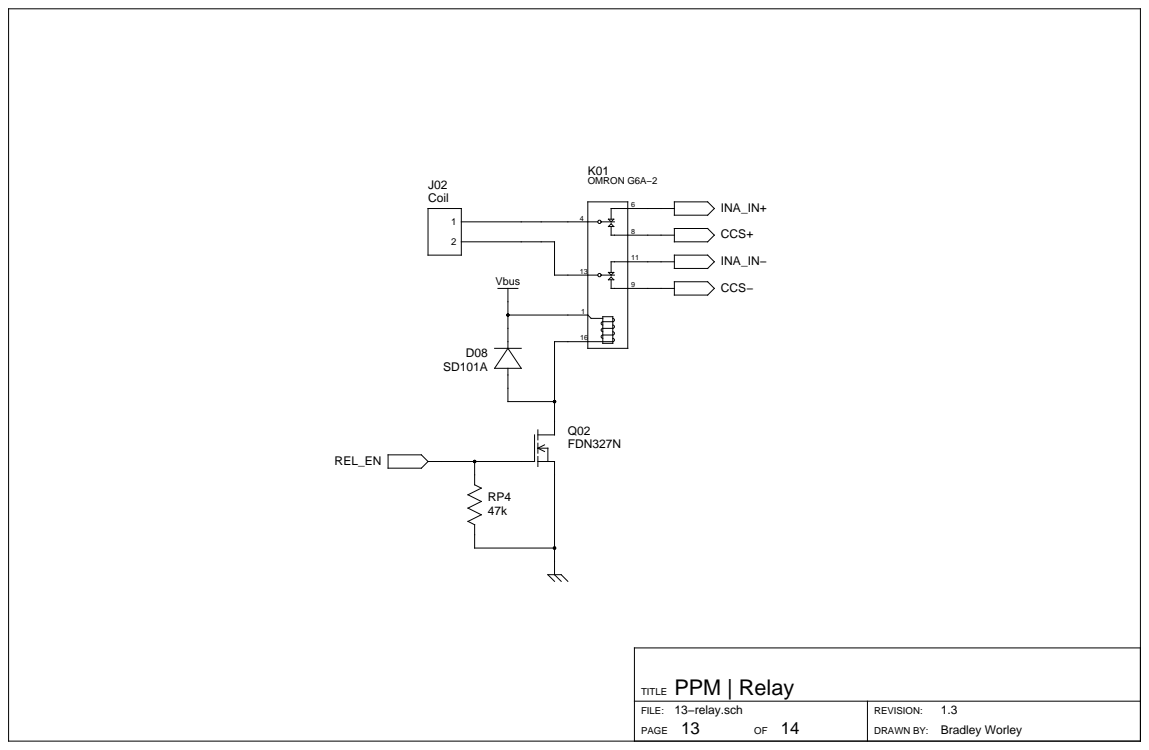
[picture p192: page 13]
PAGE; DRAWN BY:; Bradley Worley; OMRON G6A−2

TITLE PPM | Relay

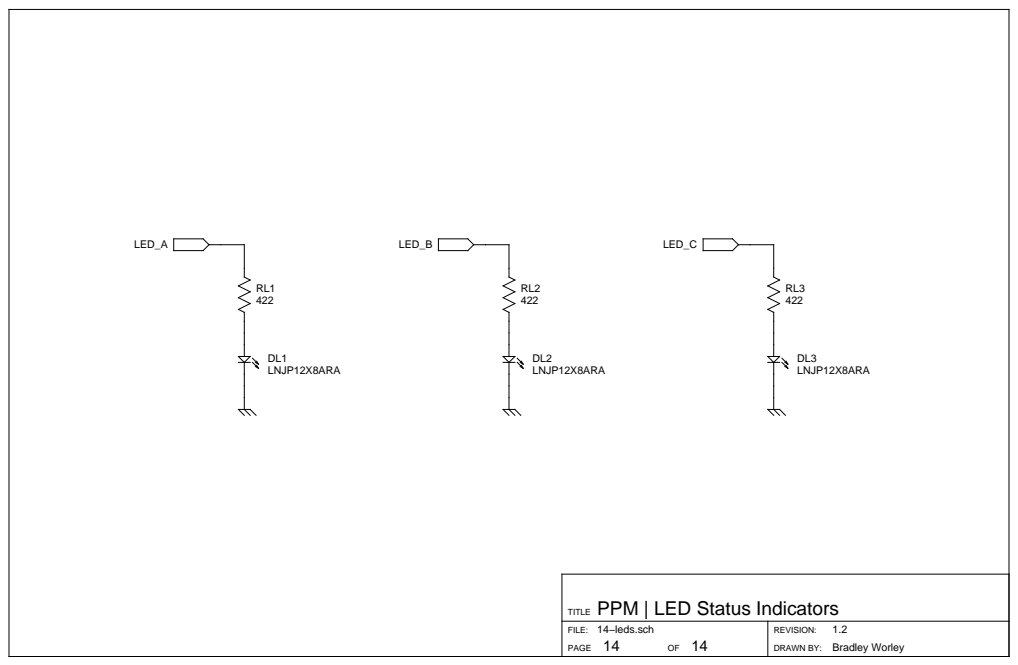
[picture p193: page 14]
PAGE; DRAWN BY:; Bradley Worley

TITLE PPM | LED Status Indicators
