geekysuavo/pyppm/designs/ppm-2.0/v2r0.pdf

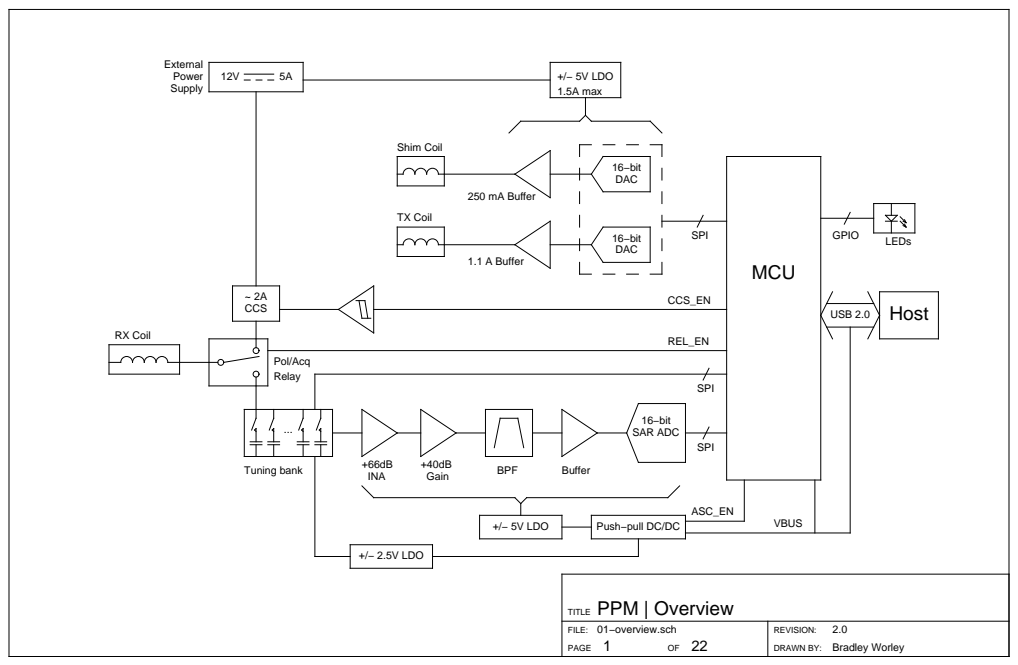
[picture p205: page 1]
PAGE; DRAWN BY:; Bradley Worley; SAR ADC; RX Coil; USB 2.0; +/− 5V LDO; LEDs GPIO; +/− 2.5V LDO; Shim Coil; 250 mA Buffer; +/− 5V LDO 1.5A max; Tuning bank; TX Coil; 1.1 A Buffer

Push−pull DC/DC

TITLE PPM | Overview

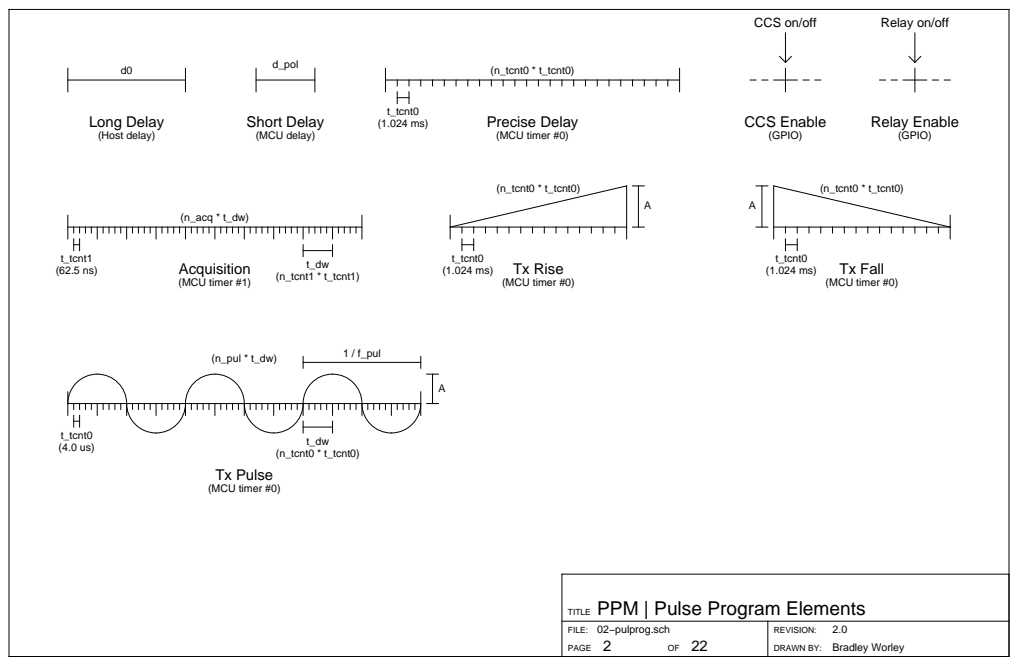
[picture p206: page 2]
PAGE; DRAWN BY:; Bradley Worley; Short Delay (MCU delay); t_tcnt0; Precise Delay; (MCU timer #0); (MCU timer #1); (n_tcnt0 * t_tcnt0); (n_acq * t_dw); Long Delay (Host delay); CCS Enable; Relay Enable; (n_tcnt1 * t_tcnt1); Tx Rise (MCU timer #0); Tx Fall (MCU timer #0); Tx Pulse (MCU timer #0); (n_pul * t_dw); 1 / f_pul

CCS on/off

Relay on/off

TITLE PPM | Pulse Program Elements

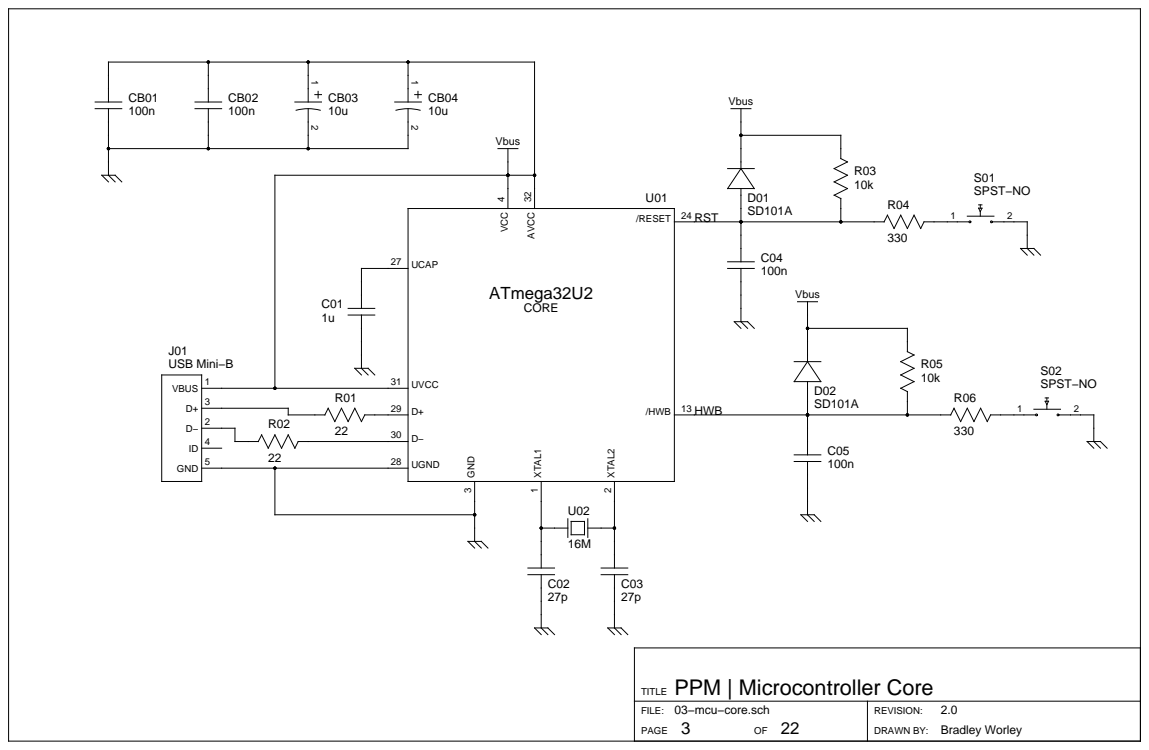
[picture p207: page 3]

TITLE PPM | Microcontroller Core

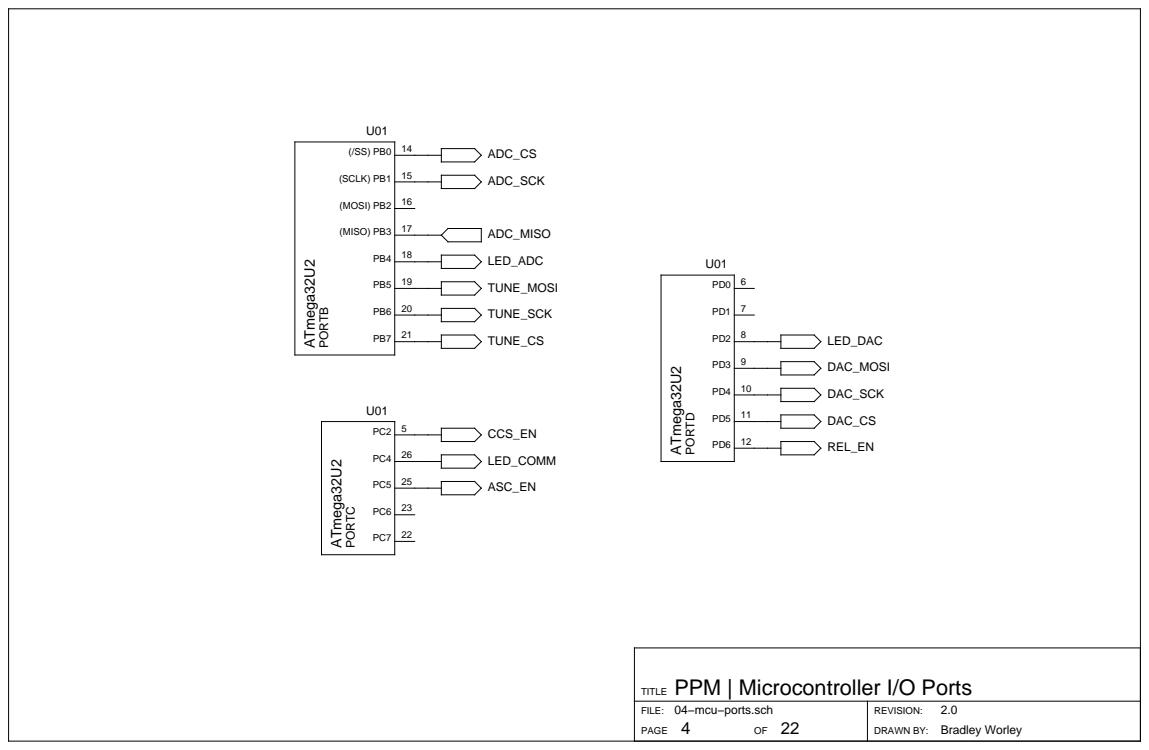
[picture p208: page 4]
PAGE; DRAWN BY:; Bradley Worley; 15 (SCLK) PB1; 16 (MOSI) PB2; 17 (MISO) PB3

TITLE PPM | Microcontroller I/O Ports

04−mcu−ports.sch

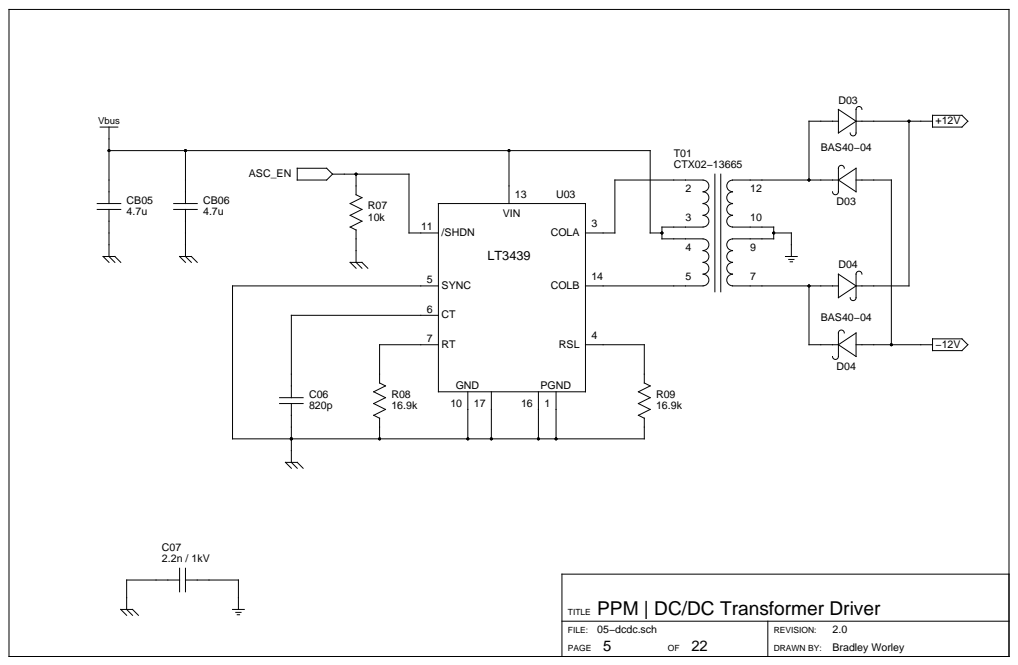
[picture p209: page 5]

TITLE PPM | DC/DC Transformer Driver

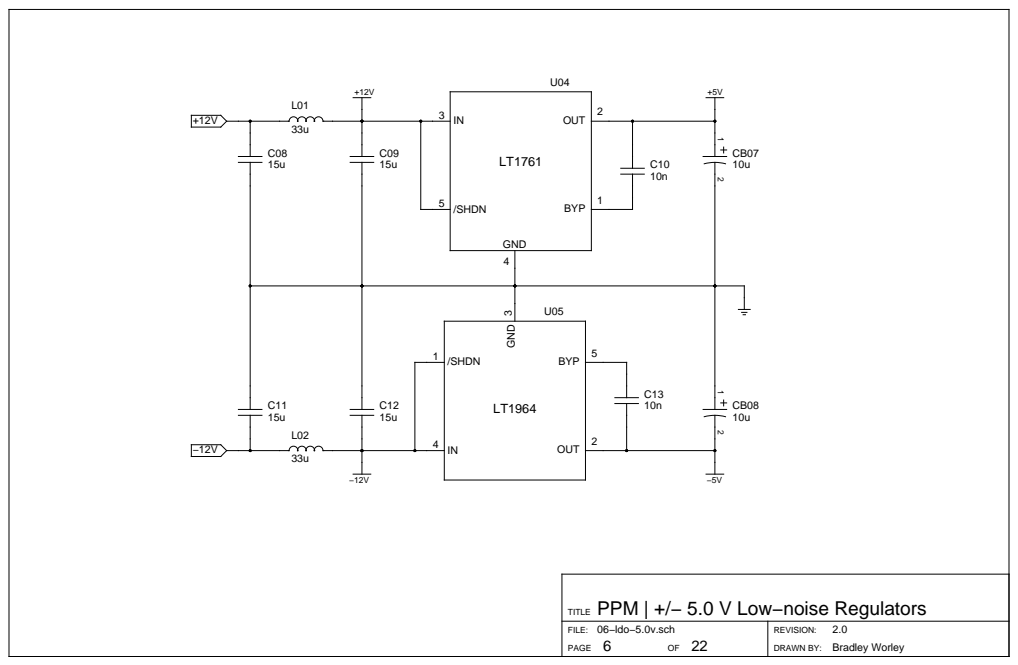
[picture p210: page 6]

TITLE PPM | +/− 5.0 V Low−noise Regulators

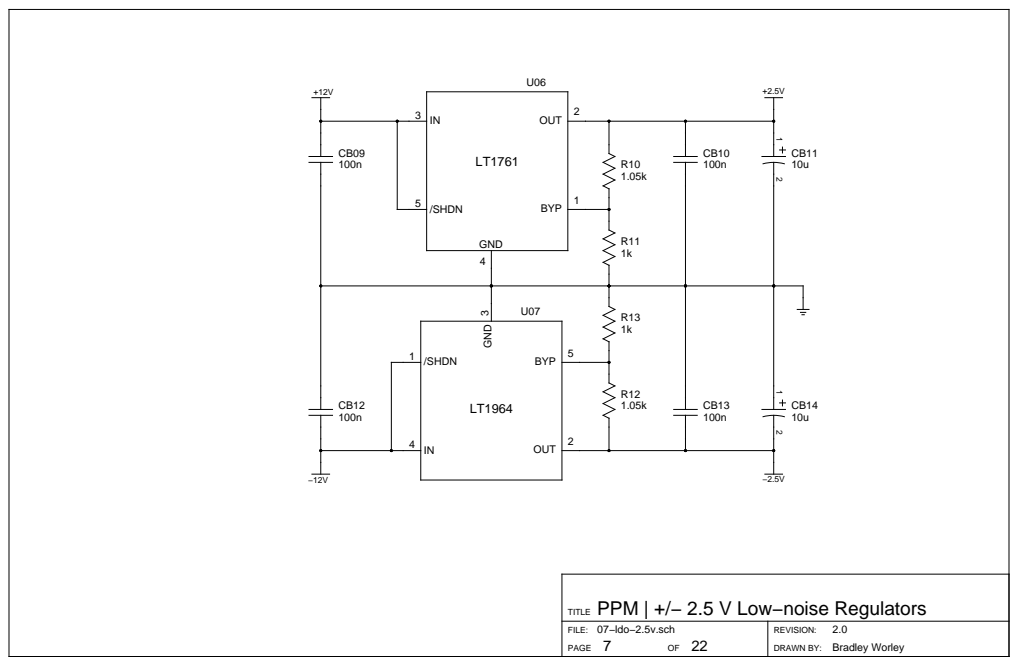
[picture p211: page 7]
PAGE; DRAWN BY:; Bradley Worley; BYP 5; /SHDN; 3 GND; BYP 1

TITLE PPM | +/− 2.5 V Low−noise Regulators

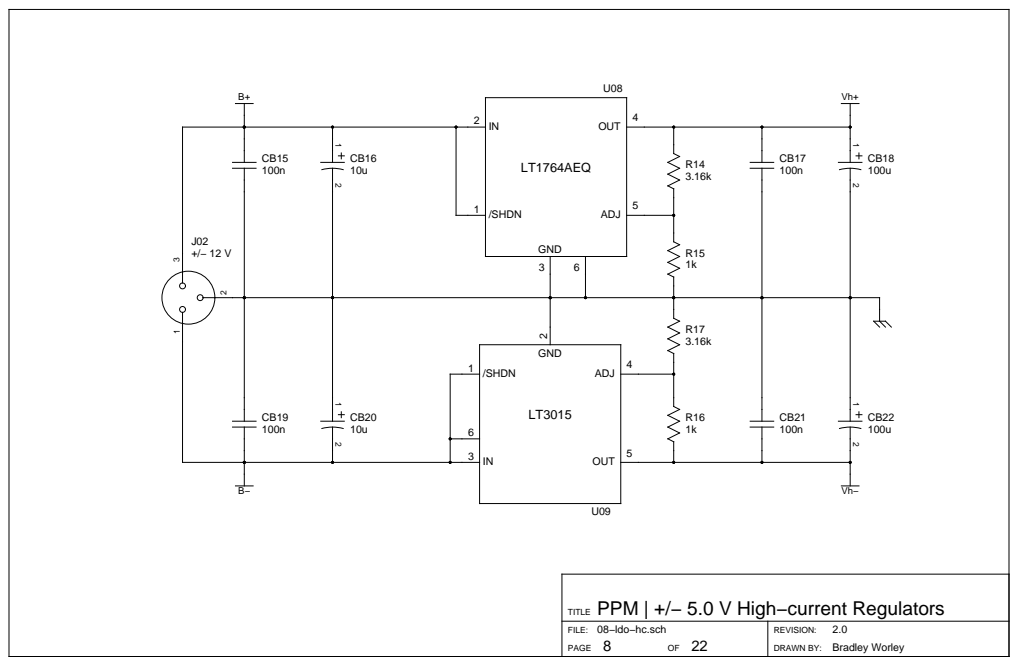
[picture p212: page 8]
PAGE; DRAWN BY:; Bradley Worley; ADJ 1; /SHDN

TITLE PPM | +/− 5.0 V High−current Regulators

08−ldo−hc.sch

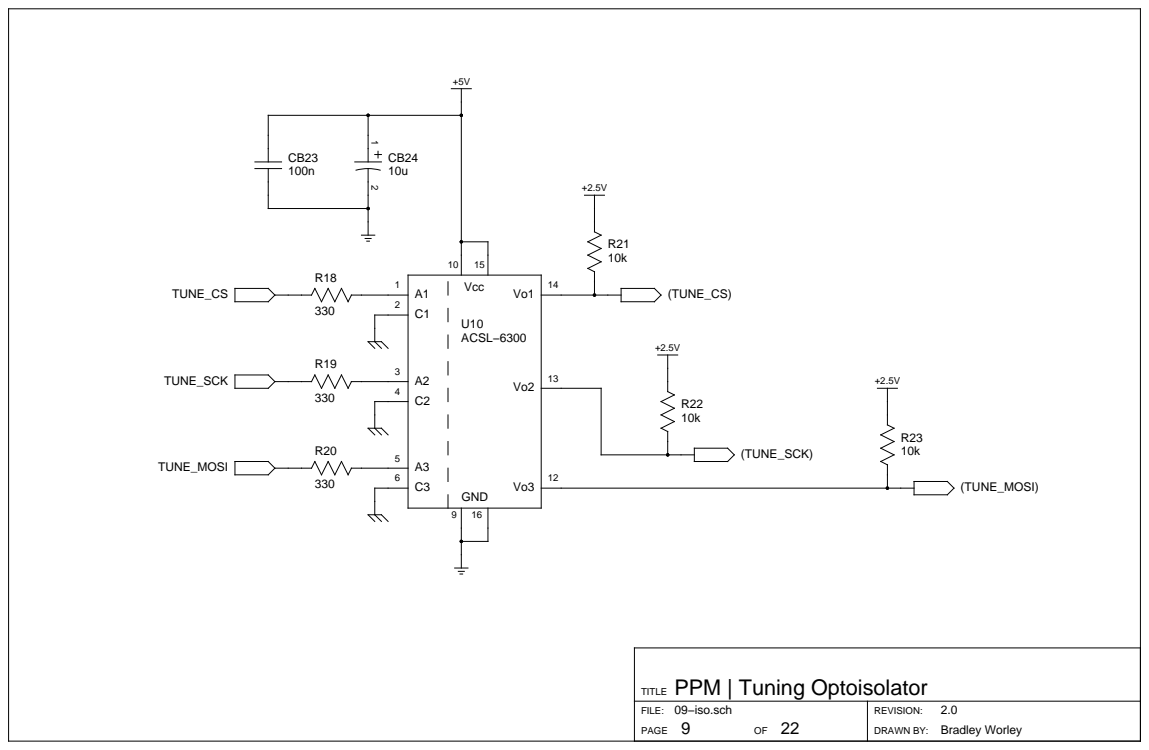
[picture p213: page 9]

TITLE PPM | Tuning Optoisolator

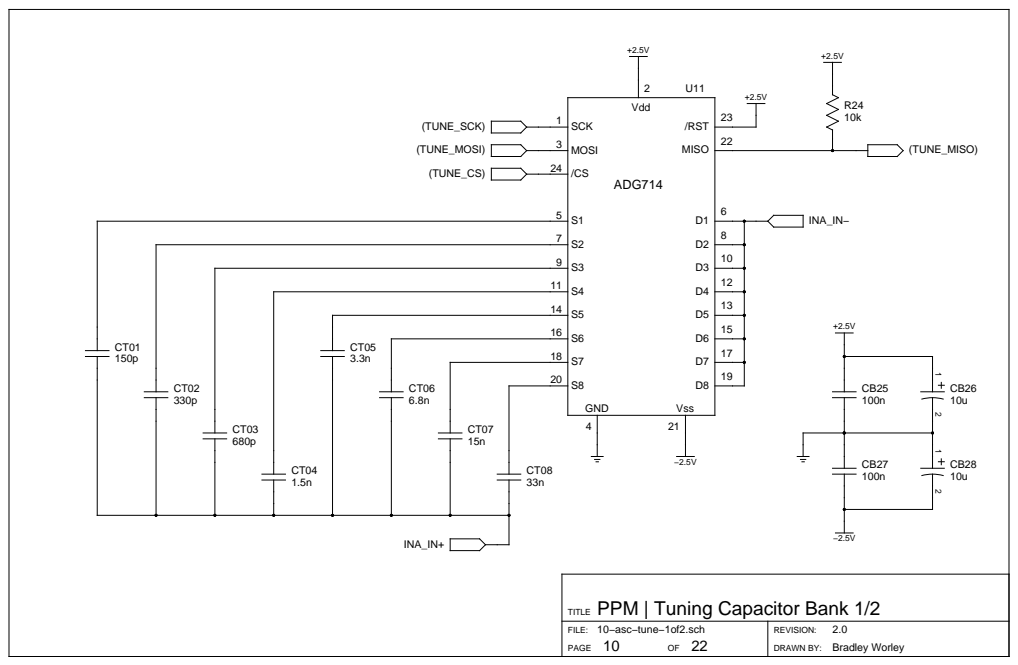
[picture p214: page 10]

TITLE PPM | Tuning Capacitor Bank 1/2

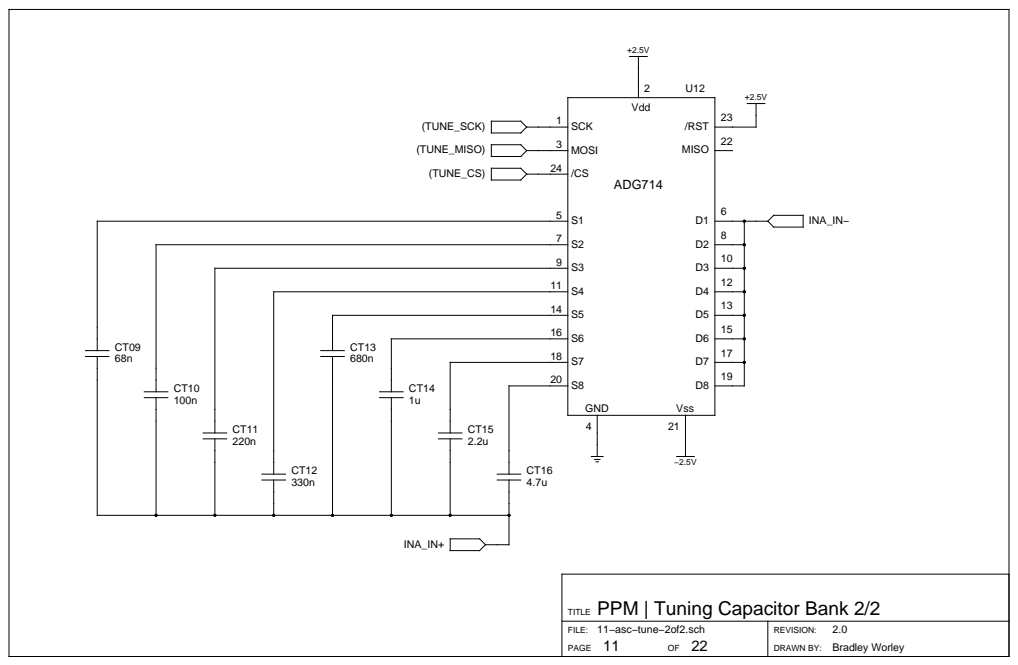
[picture p215: page 11]

TITLE PPM | Tuning Capacitor Bank 2/2

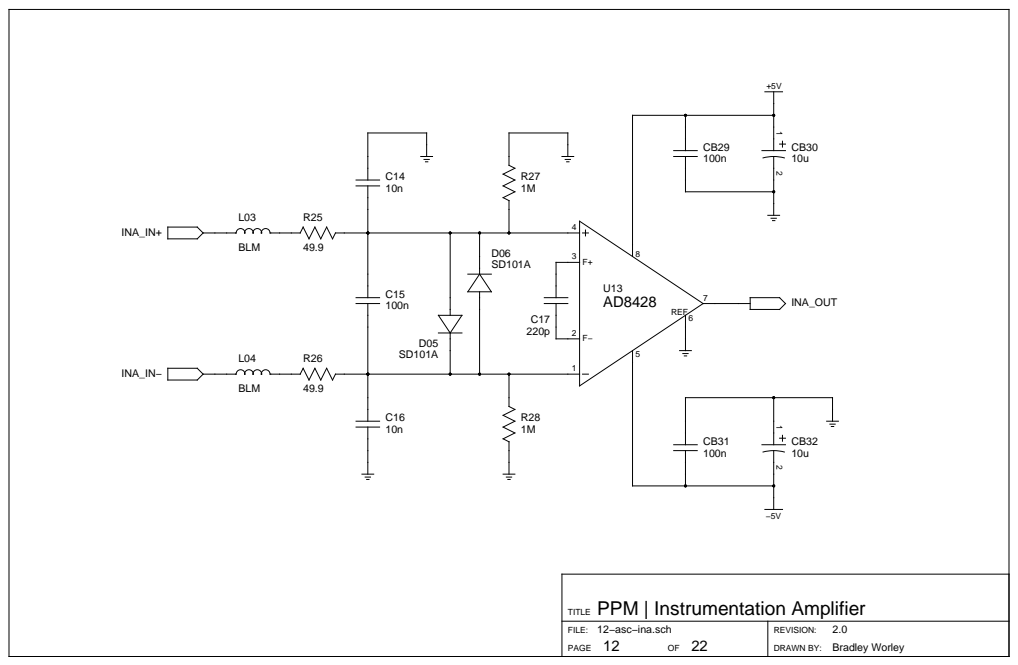
[picture p216: page 12]

TITLE PPM | Instrumentation Amplifier

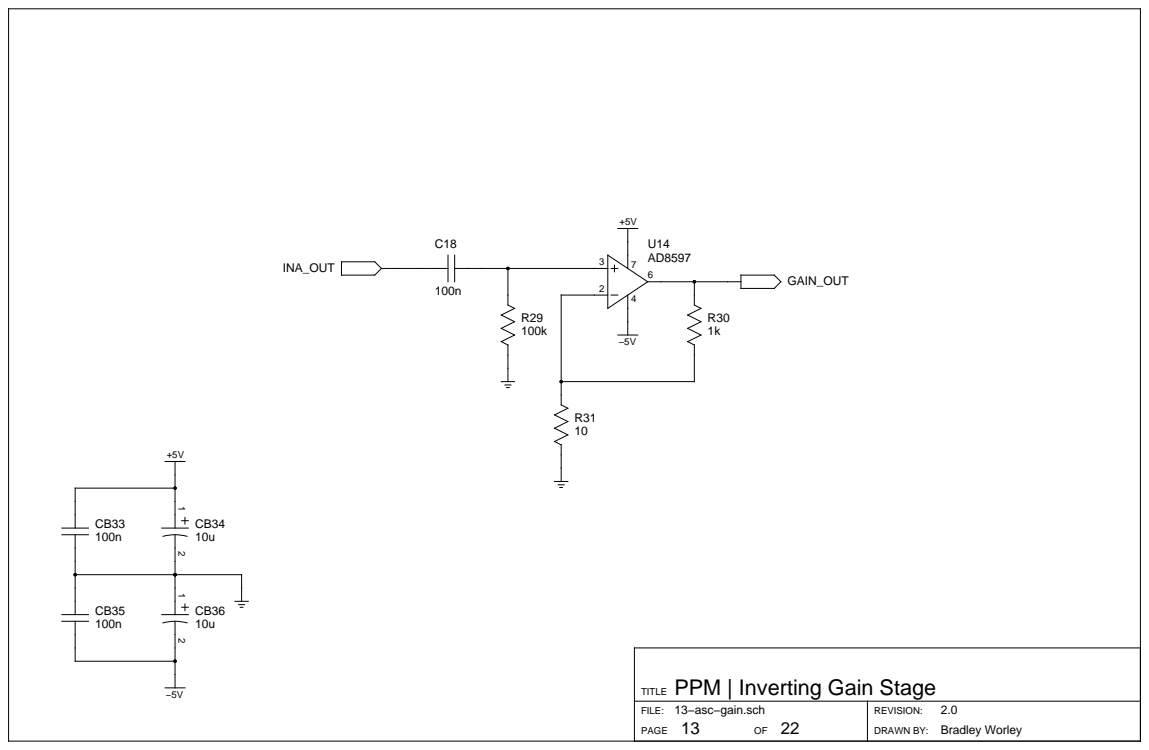
[picture p217: page 13]
PAGE; DRAWN BY:; Bradley Worley

TITLE PPM | Inverting Gain Stage

13−asc−gain.sch

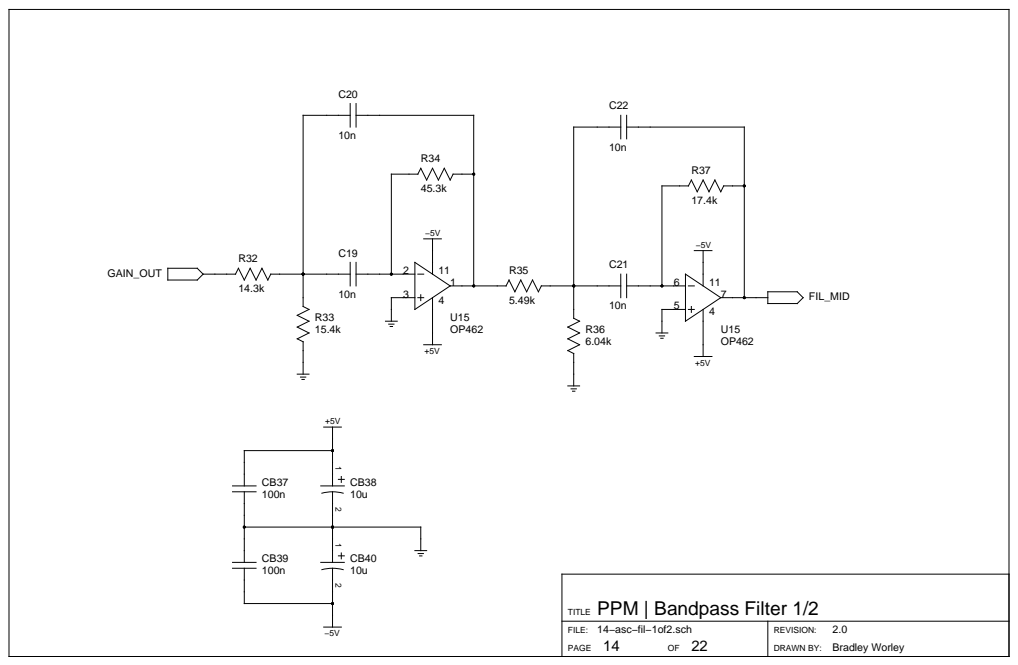
[picture p218: page 14]

TITLE PPM | Bandpass Filter 1/2

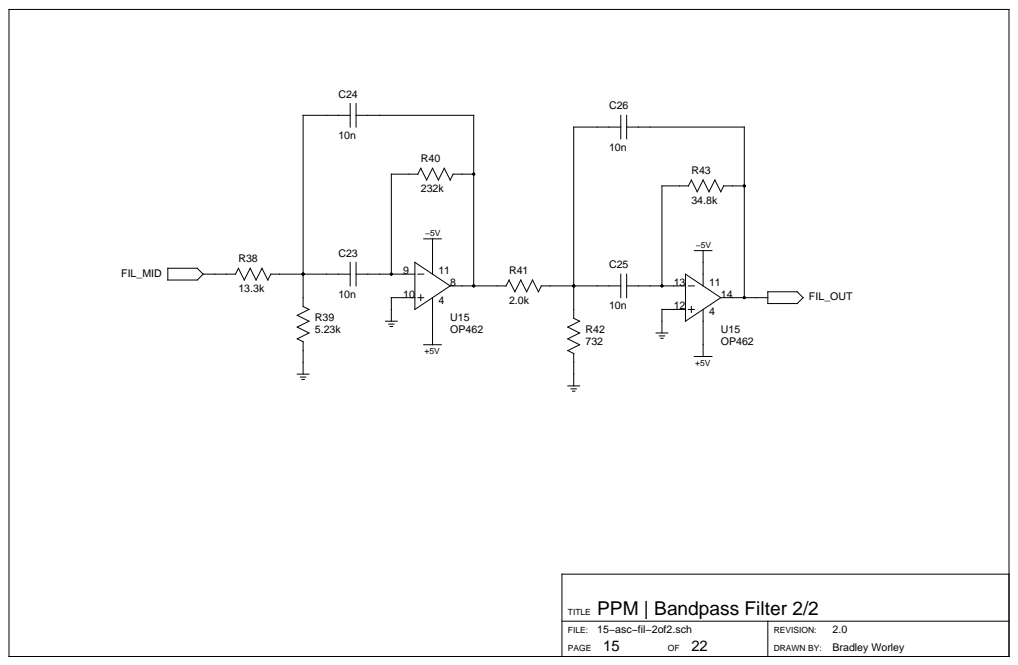
[picture p219: page 15]

TITLE PPM | Bandpass Filter 2/2

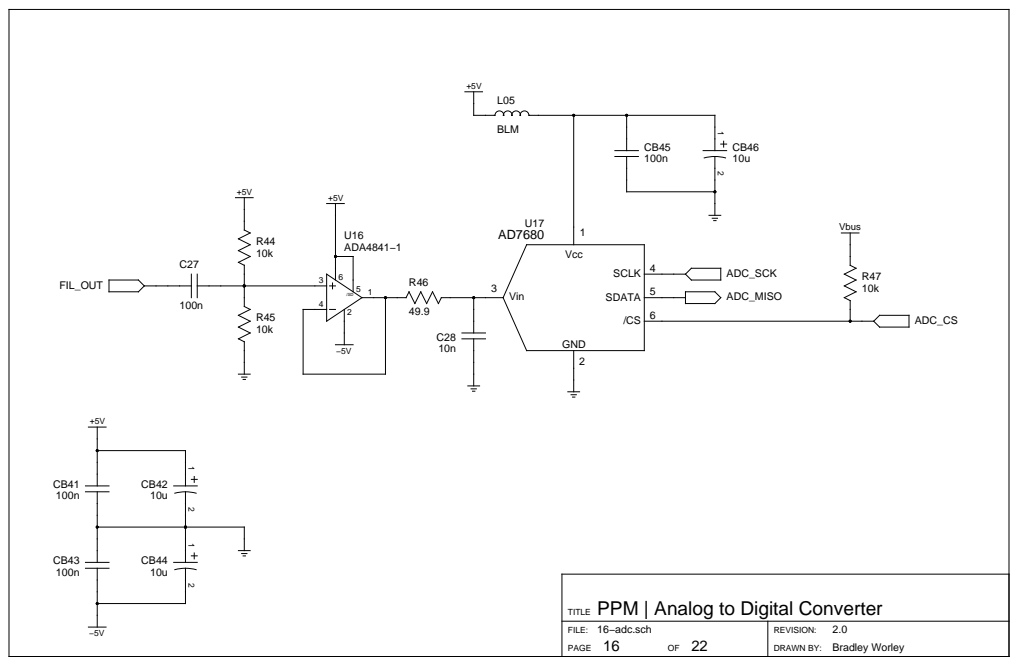
[picture p220: page 16]

TITLE PPM | Analog to Digital Converter

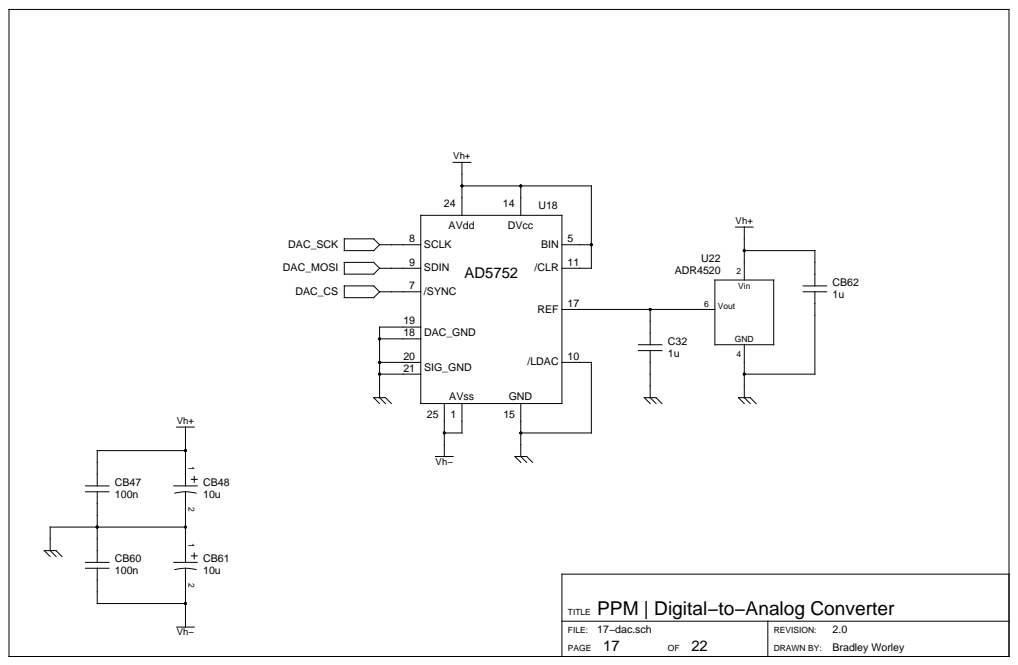
[picture p221: page 17]
PAGE; DRAWN BY:; Bradley Worley; 10 /LDAC; 11 /CLR; 5 BIN; 17 REF

TITLE PPM | Digital−to−Analog Converter

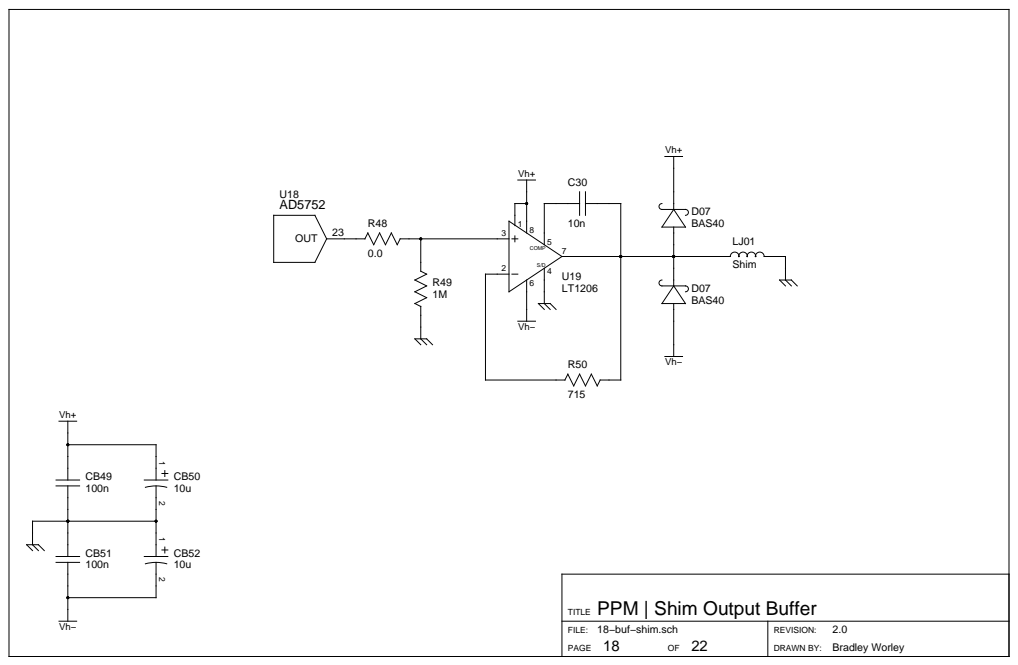
[picture p222: page 18]
PAGE; DRAWN BY:; Bradley Worley; 23 OUT

TITLE PPM | Shim Output Buffer

18−buf−shim.sch

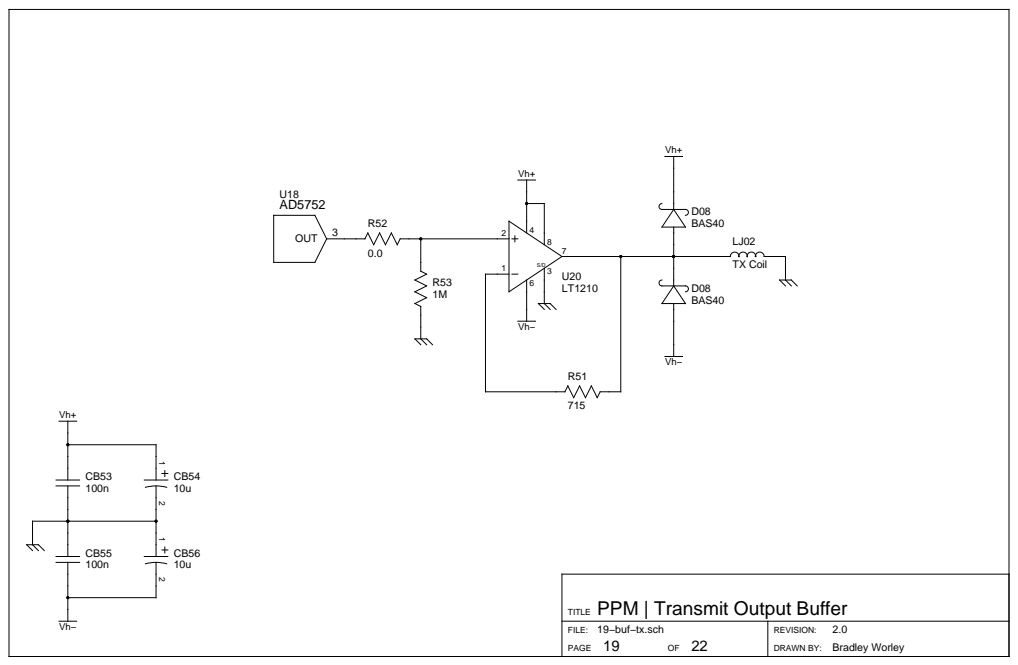
[picture p223: page 19]
PAGE; DRAWN BY:; Bradley Worley; TX Coil; 3 OUT

TITLE PPM | Transmit Output Buffer

19−buf−tx.sch

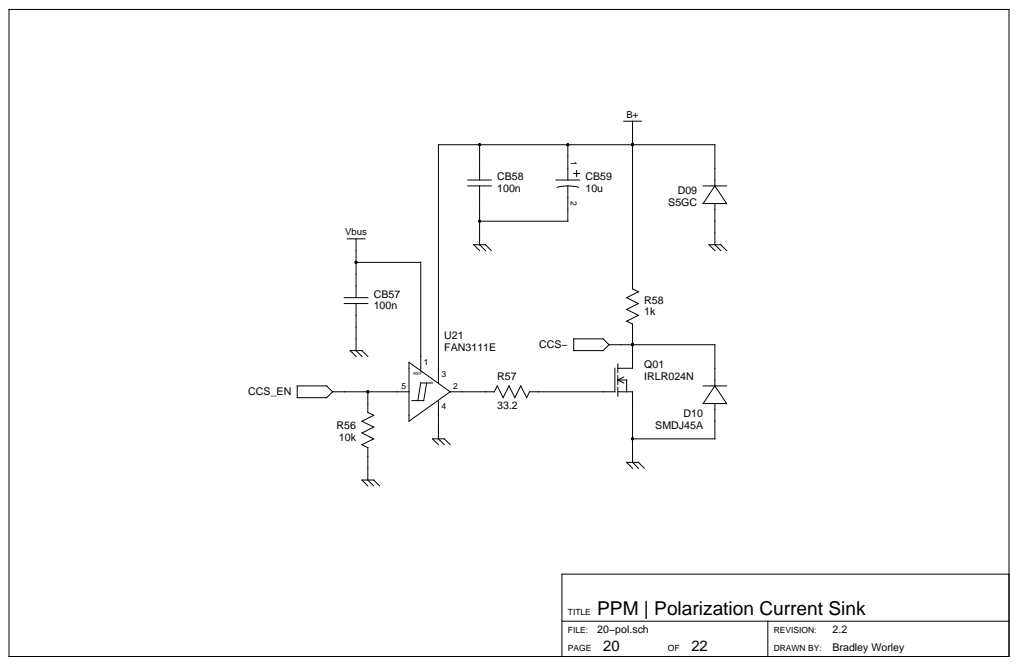
[picture p224: page 20]
PAGE; DRAWN BY:; Bradley Worley

TITLE PPM | Polarization Current Sink

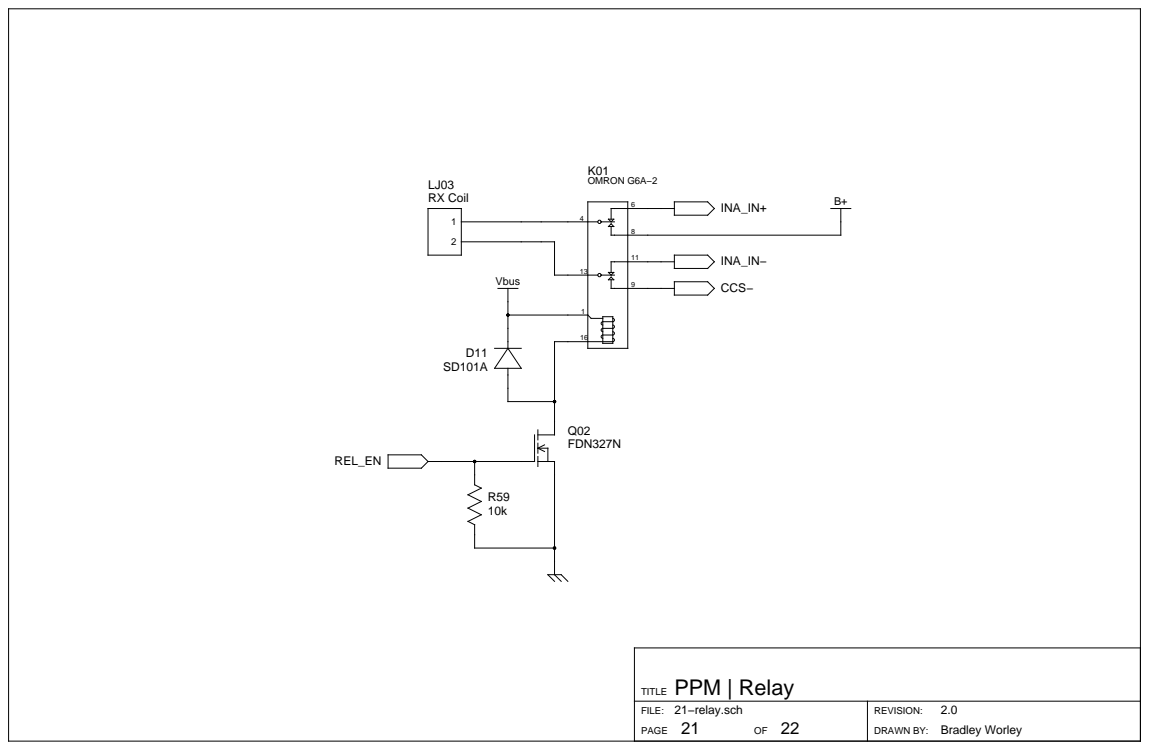
[picture p225: page 21]
PAGE; DRAWN BY:; Bradley Worley; RX Coil; OMRON G6A−2

TITLE PPM | Relay

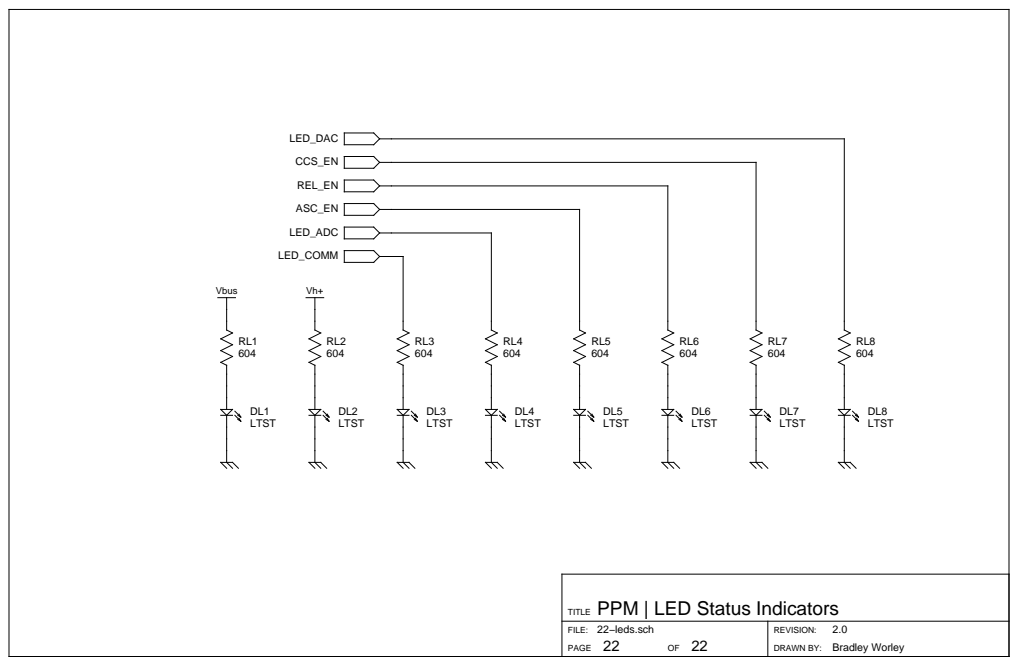
[picture p226: page 22]
PAGE; DRAWN BY:; Bradley Worley

TITLE PPM | LED Status Indicators
