geekysuavo/pyppm/designs/ppm-2.1/v2r1.pdf

PAGE; DRAWN BY:; Bradley Worley; SAR ADC; RX Coil; USB 2.0; +/− 5V LDO; LEDs GPIO; +/− 2.5V LDO; Shim Coil; 250 mA Buffer; +/− 5V LDO 1.5A max; Tuning bank; TX Coil; 1.1 A Buffer

Push−pull DC/DC

TITLE PPM | Overview

PAGE; DRAWN BY:; Bradley Worley; Short Delay (MCU delay); t_tcnt0; Precise Delay; (MCU timer #0); (MCU timer #1); (n_tcnt0 * t_tcnt0); (n_acq * t_dw); Long Delay (Host delay); CCS Enable; Relay Enable; (n_tcnt1 * t_tcnt1); Tx Rise (MCU timer #0); Tx Fall (MCU timer #0); Tx Pulse (MCU timer #0); (n_pul * t_dw); 1 / f_pul

CCS on/off

Relay on/off

TITLE PPM | Pulse Program Elements

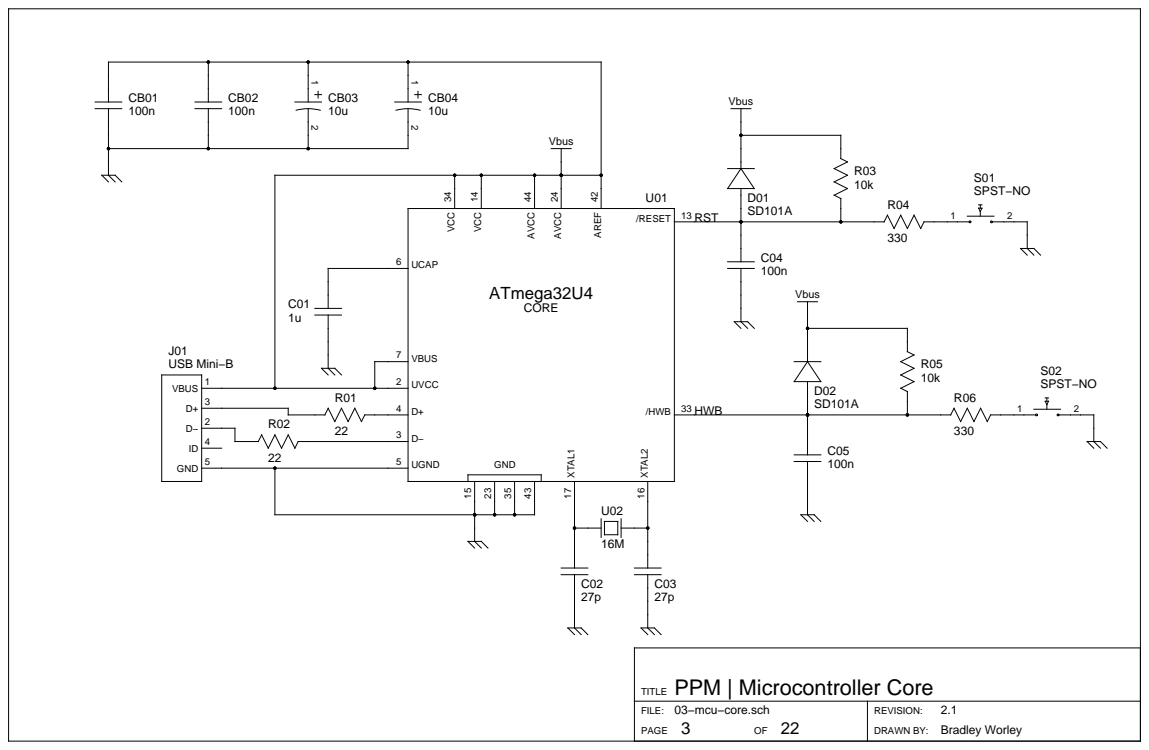
[picture p227: page 3]

TITLE PPM | Microcontroller Core

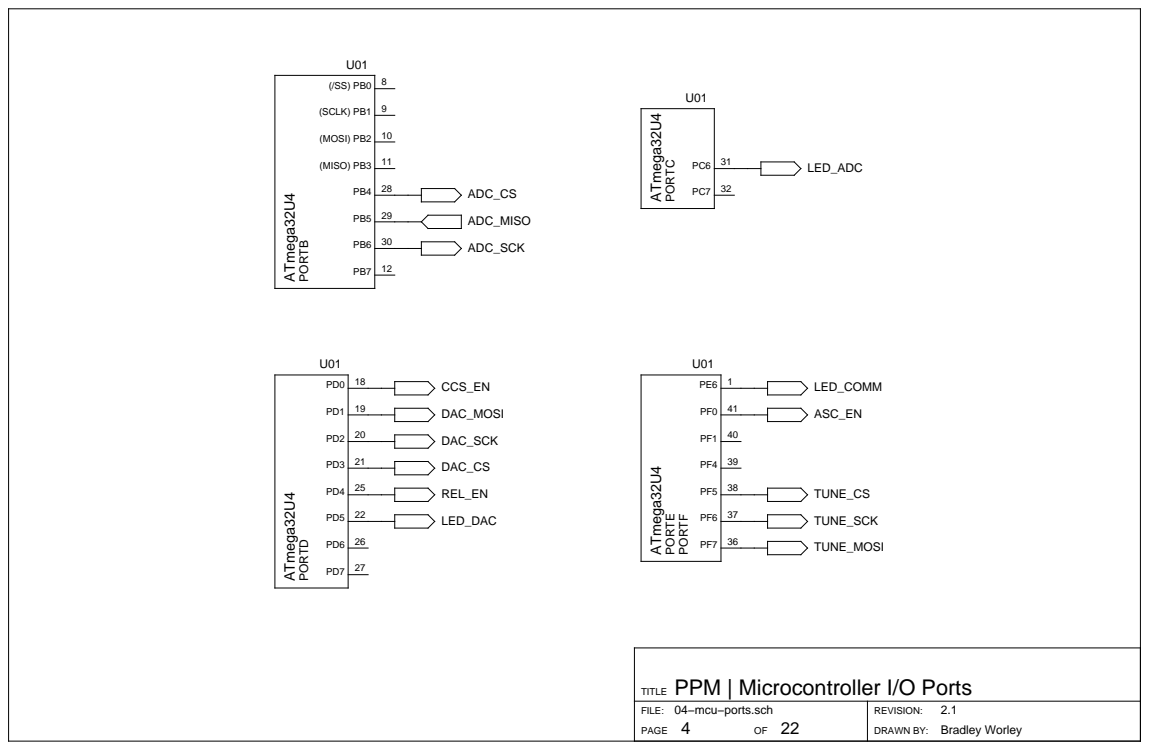
[picture p228: page 4]
PAGE; DRAWN BY:; Bradley Worley; 9 (SCLK) PB1; 10 (MOSI) PB2; 11 (MISO) PB3; PORTC31 PC6 32 PC7; PORTE37 PF6 36 PF7

TITLE PPM | Microcontroller I/O Ports

04−mcu−ports.sch


TITLE PPM | DC/DC Transformer Driver


TITLE PPM | +/− 5.0 V Low−noise Regulators

PAGE; DRAWN BY:; Bradley Worley; BYP 5; /SHDN; 3 GND; BYP 1

TITLE PPM | +/− 2.5 V Low−noise Regulators

PAGE; DRAWN BY:; Bradley Worley; ADJ 1; /SHDN

TITLE PPM | +/− 5.0 V High−current Regulators

08−ldo−hc.sch


TITLE PPM | Tuning Optoisolator


TITLE PPM | Tuning Capacitor Bank 1/2


TITLE PPM | Tuning Capacitor Bank 2/2


TITLE PPM | Instrumentation Amplifier

PAGE; DRAWN BY:; Bradley Worley

TITLE PPM | Inverting Gain Stage

13−asc−gain.sch


TITLE PPM | Bandpass Filter 1/2


TITLE PPM | Bandpass Filter 2/2


TITLE PPM | Analog to Digital Converter

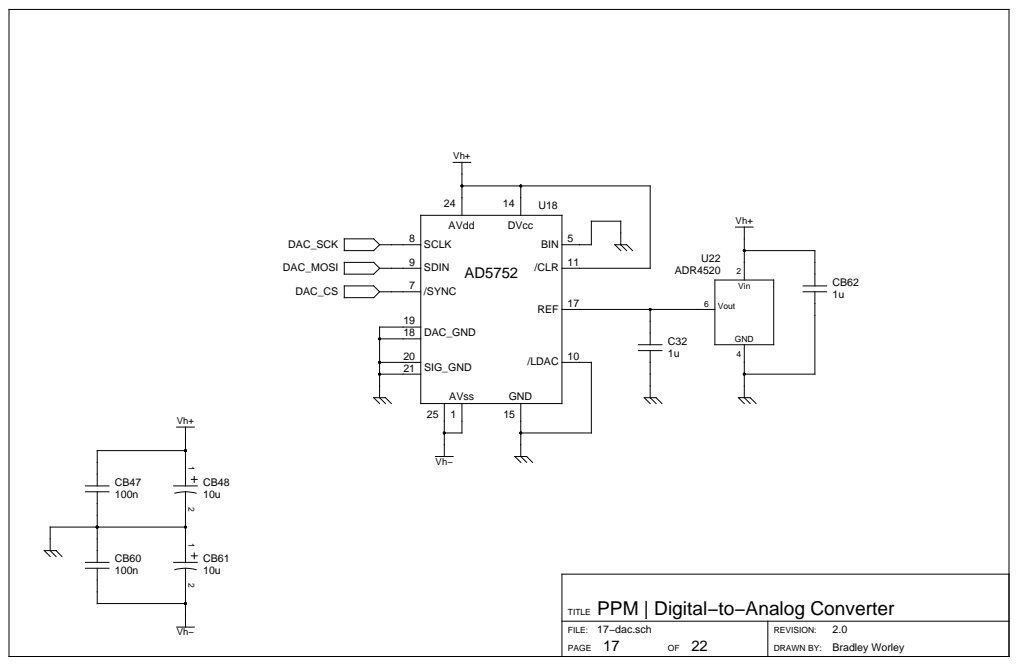
[picture p229: page 17]
PAGE; DRAWN BY:; Bradley Worley; 10 /LDAC; 11 /CLR; 5 BIN; 17 REF

TITLE PPM | Digital−to−Analog Converter

PAGE; DRAWN BY:; Bradley Worley; 23 OUT

TITLE PPM | Shim Output Buffer

18−buf−shim.sch

PAGE; DRAWN BY:; Bradley Worley; TX Coil; 3 OUT

TITLE PPM | Transmit Output Buffer

19−buf−tx.sch

PAGE; DRAWN BY:; Bradley Worley

TITLE PPM | Polarization Current Sink

PAGE; DRAWN BY:; Bradley Worley; RX Coil; OMRON G6A−2

TITLE PPM | Relay

PAGE; DRAWN BY:; Bradley Worley

TITLE PPM | LED Status Indicators
