geekysuavo/pyppm/designs/scb-1.0/v1-brd.pdf

# v1.pcb

# 1. Table of Contents (This Page) Created on Mon Jun 16 14:28:51 2014

# 2. component 3. solder 4. plated-drill 5. componentmask 6. soldermask 7. topsilk 8. bottomsilk 9. toppaste 10. topassembly 11. bottomassembly 12. fab

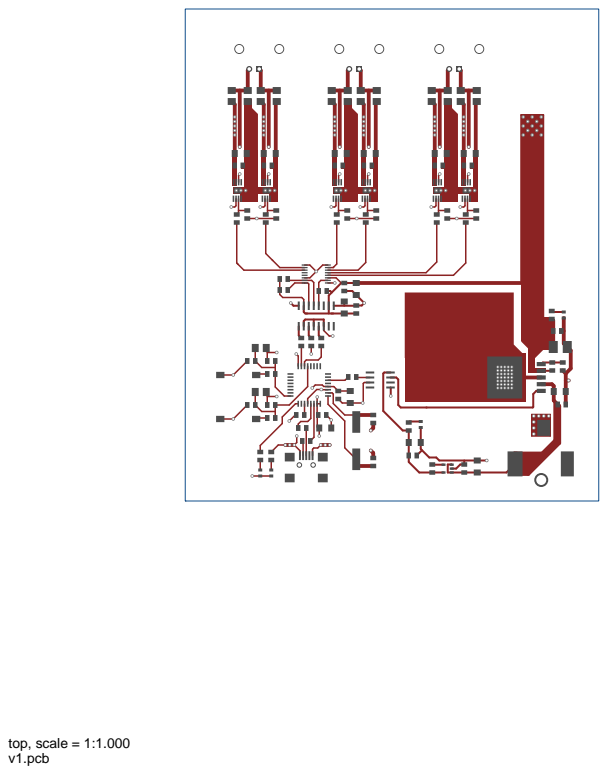
[picture p230: page 2]
top, scale = 1:1.000

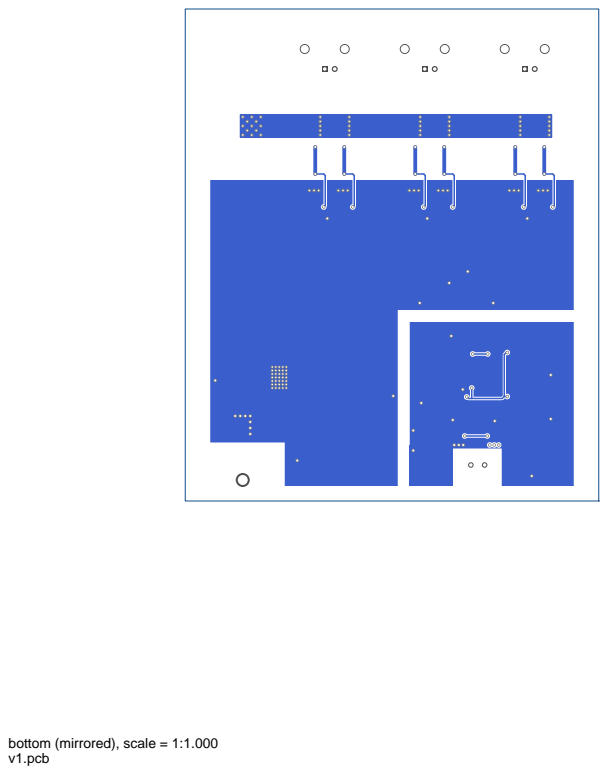
[picture p231: page 3]

bottom (mirrored), scale = 1:1.000

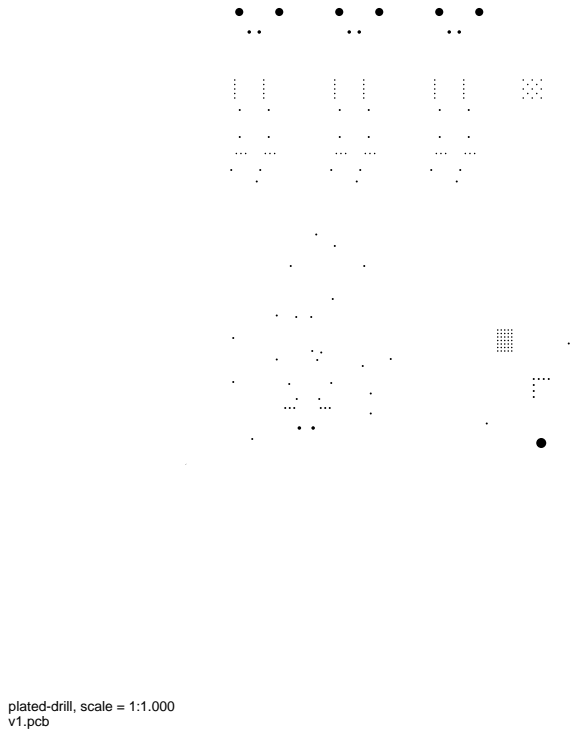
[picture p232: page 4]

plated-drill, scale = 1:1.000

topmask, scale = 1:1.000

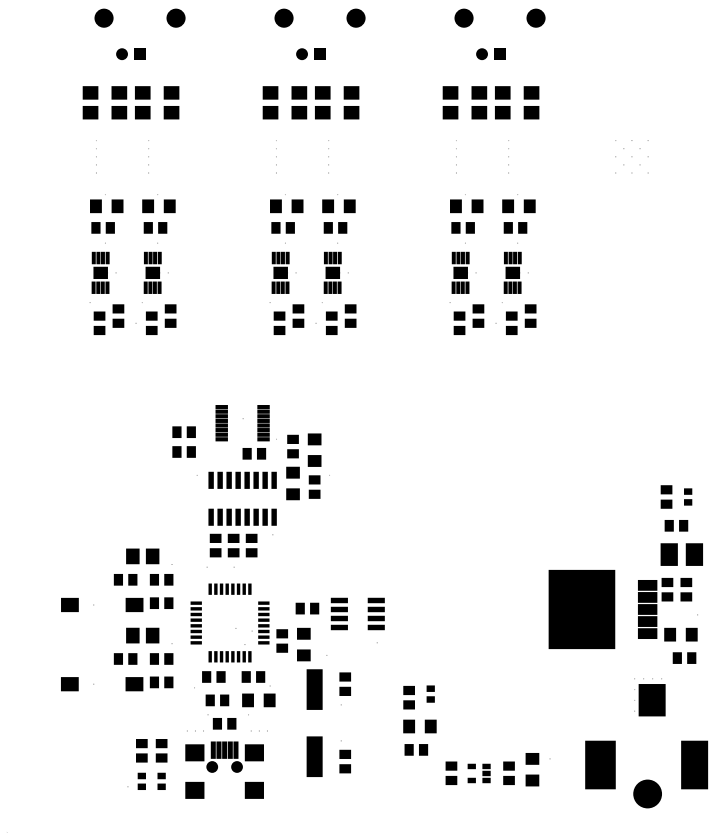
[picture p233: figure]


bottommask (mirrored), scale = 1:1.000

topsilk, scale = 1:1.000

bottomsilk (mirrored), scale = 1:1.000

toppaste, scale = 1:1.000

topassembly, scale = 1:1.000


bottomassembly (mirrored), scale = 1:1.000

fab, scale = 1:1.000
