geekysuavo/pyppm/designs/scb-1.0/v1.pdf

PAGE; DRAWN BY:; Bradley Worley; 350 mA Buffer; Shim Coil; USB 2.0; +5V LDO; LDO_EN; LED Indicators; GPIO; 1/4 Octal ADC

TITLE SCB | Overview


TITLE SCB | Microcontroller Core

PAGE; DRAWN BY:; Bradley Worley; 15 (SCLK) PB1; 16 (MOSI) PB2; 17 (MISO) PB3

TITLE SCB | Microcontroller I/O Ports

03−mcu−ports.sch


TITLE SCB | Bootstrap +5V Regulator

PAGE; DRAWN BY:; Bradley Worley; ADJ 1; /SHDN

TITLE SCB | High−current +5V Regulator


TITLE SCB | Digital−to−Analog Converter


TITLE SCB | Buffer (X−axis)


TITLE SCB | Buffer (Y−axis)


TITLE SCB | Buffer (Z−axis)

PAGE; DRAWN BY:; Bradley Worley

DL1: Lights during Host−MCU communication
DL2: Lights on application of USB 2.0 bus power
DL3: Lights on successful startup of bootstrap regulator
DL4: Lights on successful startup of high−current regulator

TITLE SCB | LED Status Indicators
