geekysuavo/pyppm/designs/ina-1.0/v1.pdf

TITLE INA: Instrumentation Amplifier
