geekysuavo/pyppm/designs/osc-1.0/v1.pdf

TITLE OSC: Test ~1kHz ~10uV Oscillator
