geekysuavo/pyppm/(list of files, drawings)

Other design files:
designs/dig-1.0/v1.pcb
designs/fil-1.0/v1.pcb
designs/ina-1.0/v1.pcb
designs/osc-1.0/v1.pcb
designs/ppm-1.0/v1.pcb
designs/ppm-1.1/v1.pcb
designs/ppm-1.2/v1.pcb
designs/ppm-1.3/v1.pcb
designs/ppm-2.0/v2.pcb
designs/ppm-2.1/v2.pcb
designs/ppm-2.2/v2.pcb
designs/scb-1.0/v1.pcb
