geekysuavo/pyppm/(commit log)

2014-08-16 added custom schematic symbols used in pyppm
2014-08-16 added even more files
    [01-coil.sch, 01-fil.sch, 01-front.sch, 01-ina.sch, 01-mcu.sch, 01-osc.sch, 01-overview.sch, 02-adc.sch]
2014-09-04 added digikey bill of materials, updated schematics and board layout.
2014-09-14 began modifying ppm-2.1 firmware source code
    [11-asc-tune-2of2.sch, ppm-bom.csv, v2.pcb]
2014-09-15 added correct symbols for adjustable lt1761/lt1964, fixed lt3015 feedback.
    [06-ldo-5.0v.sch, 07-ldo-2.5v.sch, 08-ldo-hc.sch, 19-buf-tx.sch]
2014-09-15 fixed errors in ppm-2.1 schematic and layout
    [v2.pcb]
2014-09-18 added footprints/README.md
2014-09-19 consolidated all device/host message definitions into firmware/lib/msg.h
2014-09-22 centralized debug message printing in sw/core
2014-09-30 fixed glaring mistakes in ppm2 timer/counter firmware
2014-09-30 added dual diode symbol
2014-10-01 fixed ppm2 delay and acquire assembly routines
2014-10-03 added capacitive tuning word binary search function
2014-10-04 implemented capacitive tuning in ppm-2.x
2014-10-06 added ppm-2.2 design files
    [01-overview.sch, 02-pulprog.sch, 03-mcu-core.sch, 04-mcu-ports.sch, 05-dcdc.sch, 06-ldo-5.0v.sch, 07-ldo-2.5v.sch, 08-ldo-hc-1of2.sch]
2014-10-06 tweaked component label positions in ppm-2.2 board
    [v2.pcb]
2014-10-06 added internal bom generation code
    [14-asc-gain.sch, ppm-bom-long.csv, ppm-bom-short.csv]
2014-10-06 added bottomside silkscreen to ppm-2.2 pcb
    [v2.pcb]
2014-10-06 added pin1 marker on voltage supervisor chip
    [v2.pcb]
2014-10-07 cleaned up ppm2 spi c code
2014-10-07 fixed transmit pulse interrupt timing, added re-zero after pulses
2017-09-23 Fixed links in footprints/README.md
